cdhooper/kicksmash32/doc/AMIGACLI.md

## Usage Example

If you are familiar with the Amiga CLI and have the ability to get
ROM images to your Amiga, then programming and switching between Kickstart
ROM banks in the running system is not difficult.

List all banks.

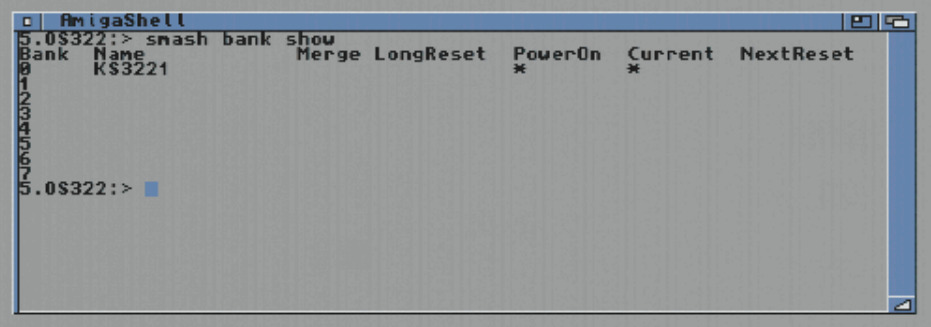
[picture p5: doc/smash_example_1_bank_show.jpg]
smash bank show


Write DiagROM to a bank.

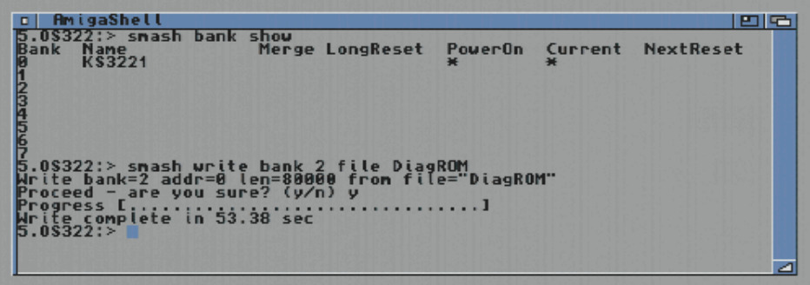
[picture p6: doc/smash_example_2_write.jpg]
smash write


Name that bank for future reference.

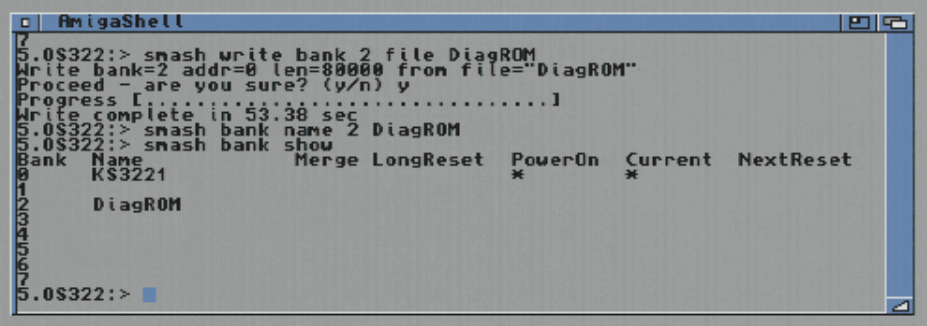
[picture p7: doc/smash_example_3_bank_name.jpg]
smash bank name


It's always a good idea to verify what you wrote.

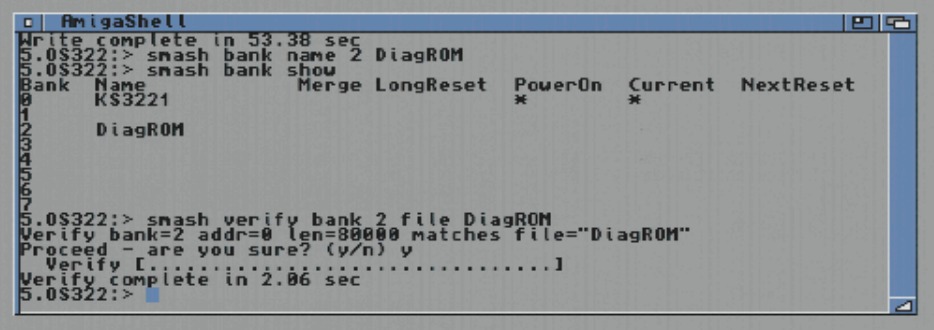
[picture p8: doc/smash_example_4_verify.jpg]
smash verify


Switch to that bank and reboot.

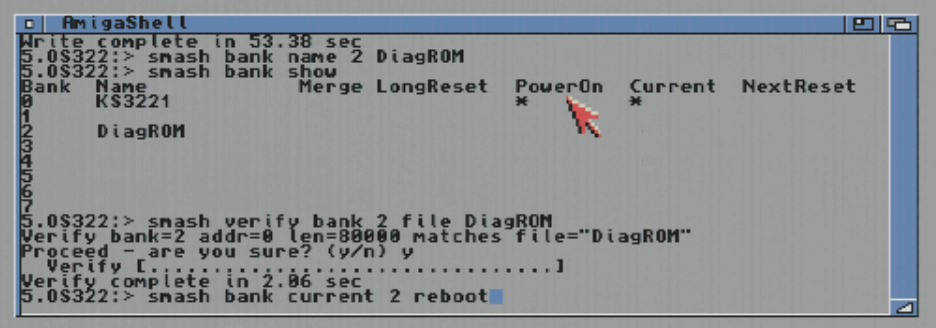
[picture p9: doc/smash_example_5_bank_current.jpg]
smash bank current


After pressing Enter, your computer is now running DiagROM.

How do you switch back? If you had specified a "long reset" sequence, you could press and hold Control-Amiga-Amiga to switch back. Since you haven't yet done that, you will need to power cycle your Amiga or connect to the KickSmash over USB and tell it from the host to switch.

-------------------------------------------------------

The smash utility can also be used to test communication between your Amiga and Kicksmash.

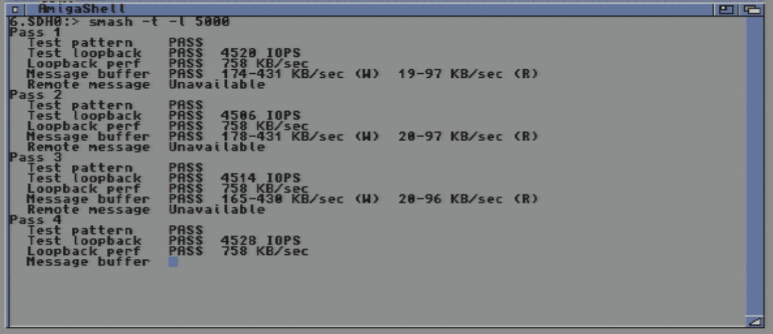
[picture p10: doc/smash_example_6_test_start.jpg]
smash test start smash test

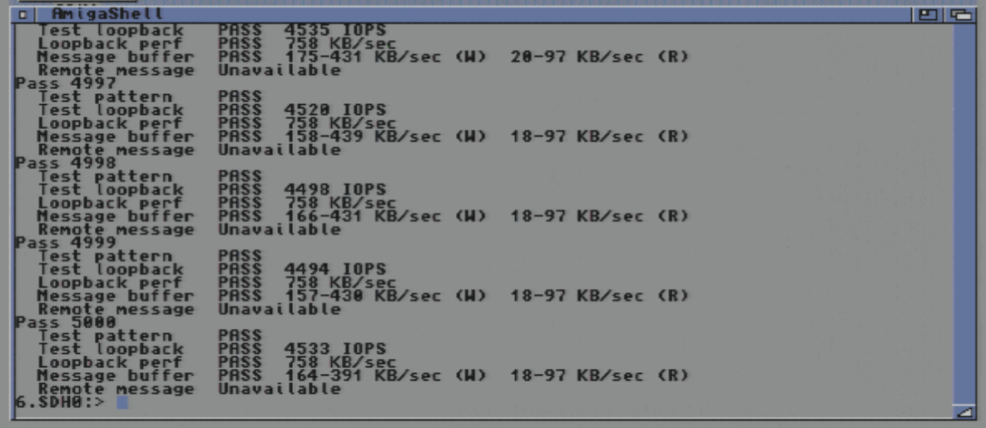
[picture p11: doc/smash_example_7_test_end.jpg]
smash test end smash test (end)
