cdhooper/kicksmash32/doc/KickSmash32_InfoSheet.odt

KickSmash32

OPEN SOURCE
DUAL KICKSTART ROM REPLACEMENT
IN-SYSTEM & USB PROGRAMMING
NETWORK AND FILE SERVICE

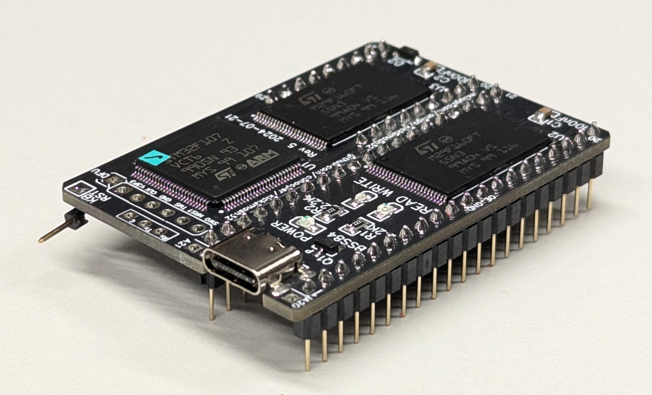
[picture p20: figure]
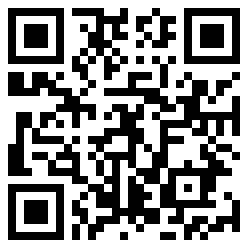
[picture p21: figure]

Overview KickSmash32 is a modern Kickstart ROM replacement for 32-bit Amiga systems (1200/3000/4000 and similar) systems. It replaces the original ROM chips with multi-bank flash that can be programmed from the Amiga itself or from a host computer over USB. A ROM Switcher which can be shown at power-on or at long reset can be used to quickly change the desired ROM bank. Beyond simple ROM swapping it offers optional file-system and network services so the Amiga can see volumes and share network from the host PC through the same USB cable. | SCAN TO VISIT github.com/cdhooper/kicksmash32

Features

▸ Read/write up to 8 independent flash banks from Amiga CLI (smash) or GUI (SmashTool)

▸ Out-of-system programming via USB with hostsmash (Linux, macOS, Windows)

▸ Configurable ROM bank selection on long reset or cold power-on

▸ ROM Switcher for interactive ROM bank choice at boot

▸ Optional smashfs / smashftp host file service and smashnet network device

▸ Open hardware + firmware + software under BSD-2-Clause

Board Variants & Models

Amiga Model | KickSmash Board | Notes
A3000 / ReA3000 / A4000 | KickSmash 32 | ROM Tower adapter available for older A3000
A1200 / ReA1200 | KickSmash 1200 | 42-pin sockets, D0-D15 on right
A3000T / AA3000+ | KickSmash 3KT | hostsmash -s 1032 on A3000T Rev7
A4000T | KickSmash 4KT | USB faces Fat Gary
A4000CR / ReA4000CR | KickSmash 4KCR | Wide spacing; 40/42-pin variants
AmigaPCI | KickSmash APCI | 27C4096 pinout

AVAILABILITY

There are several individuals around the world who are building and selling KickSmash. All board designs, firmware, Amiga software, and host software are freely available in the same github repository, which means everyone has access. If you wish to build your own or build and sell, you are granted full permission to do so as you desire.
