cdhooper/kicksmash32/doc/AMIGAGUI.md

## Usage Example

The main feature of SmashTool, the Amiga Kicksmash graphical program,
is to program and name Kicksmash ROM banks. Here's an example:

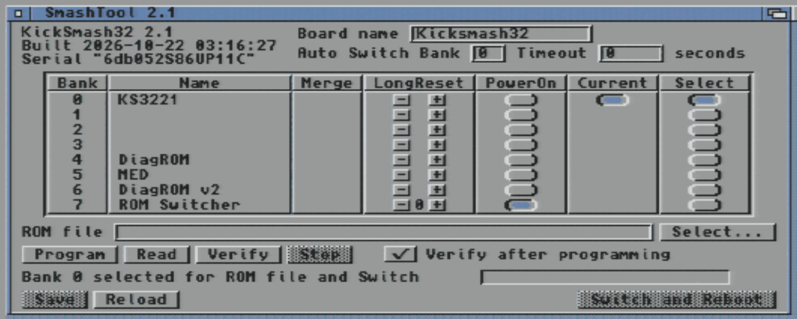
[picture p22: doc/smashtool_01_full_window.jpg]
SmashTool


When SmashTool starts up, it will query Kicksmash and report useful
information such as the firmware version, board name, and the name
of the ROM in each bank.

If you hold down the right mouse button, you will see some additional
options, including the Clock menu, where you can update the Amiga
time either from the time you previously stored in Kicksmash or the
time of your Kicksmash USB host, if connected by USB and running
hostsmash.

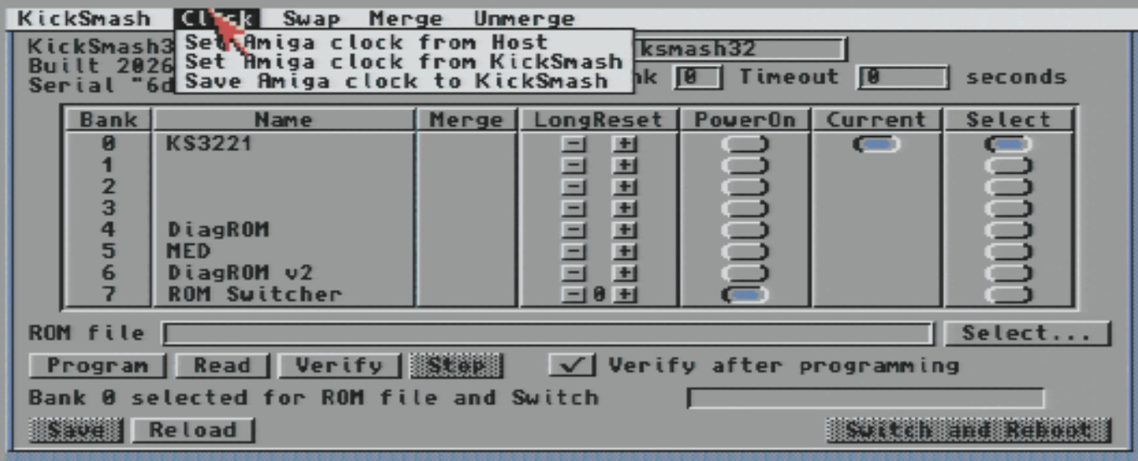
[picture p23: doc/smashtool_02_clock_menu.jpg]
Clock


Let's program bank 1 with a new Kickstart image. Start by selecting
the bank to program:

Select Bank

Now click the "Select..." button to select a ROM file to use.

Select...

An Amiga file requester will appear. Locate the ROM image to use.

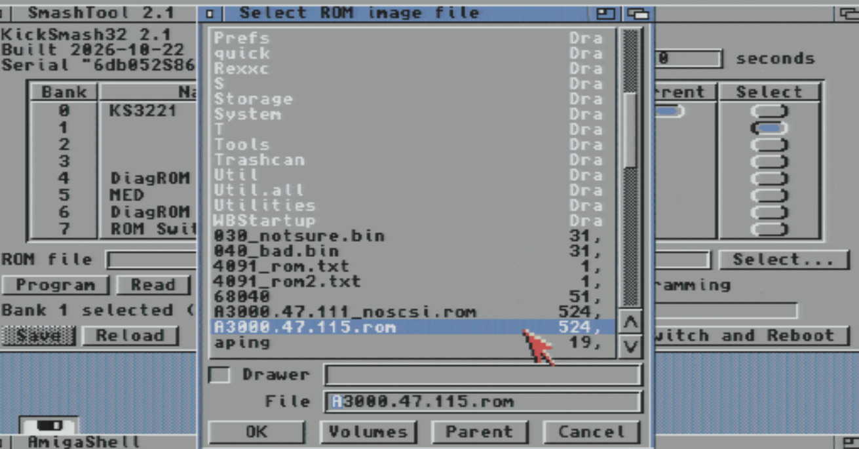
[picture p24: doc/smashtool_05_select_rom_file.jpg]
ROM file


After clicking "OK", you will see the ROM file name presented.

ROM file

You've already selected the bank to program, so now click "Program"

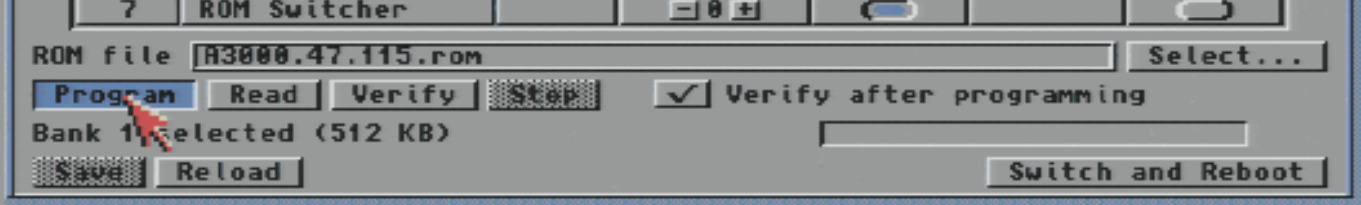
[picture p25: doc/smashtool_07_program_button.jpg]
Program


SmashTool will prompt you, as this will erase whatever is currently
in the ROM bank.

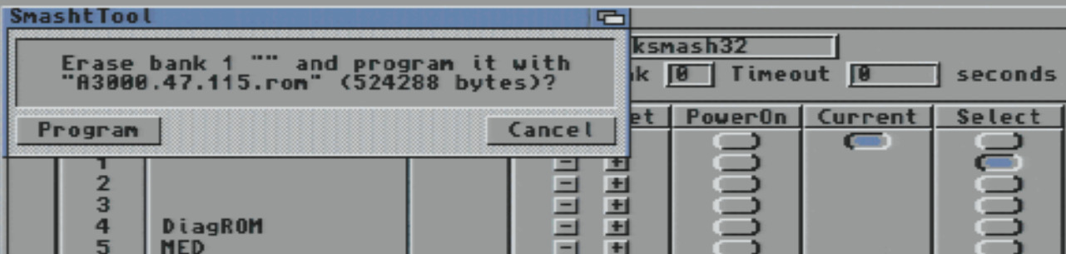
[picture p26: doc/smashtool_08_program_prompt.jpg]
Program or Cancel


SmashTool works with Kicksmash to erase and program the ROM. The bank
is first erased.

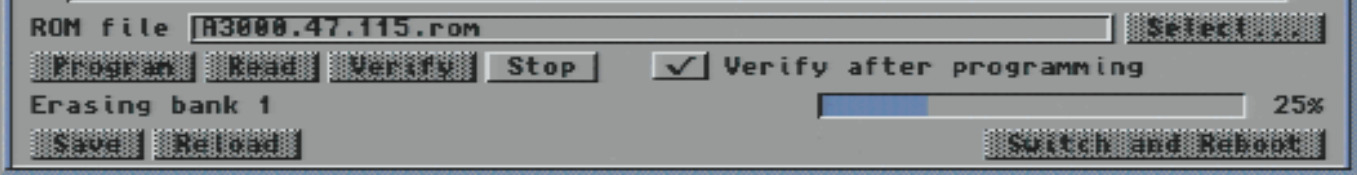
[picture p27: doc/smashtool_09_erasing.jpg]
Erasing


Then programming commences.

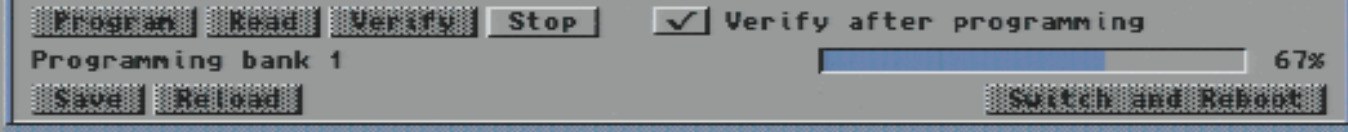
[picture p28: doc/smashtool_10_programming.jpg]
Programming


Programming will take between 10 and 60 seconds, depending on the speed
of your Amiga. Once done, the bank will be automatically verified, so
long as "Verify after programming" was selected.

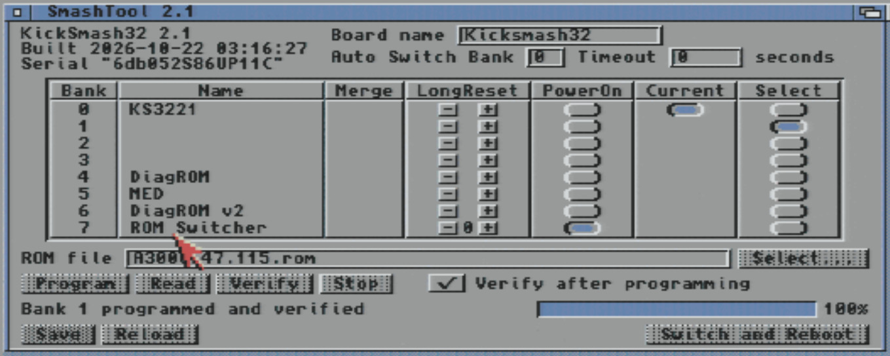
[picture p29: doc/smashtool_11_programming.jpg]
Programming done


Now, let's name the bank which was just programmed. Click with your
mouse on the bank name and begin typing.

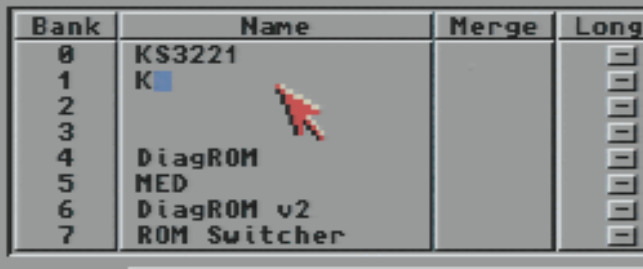
[picture p30: doc/smashtool_12_name_bank.jpg]
Bank Name


When done, there is no need to press enter.

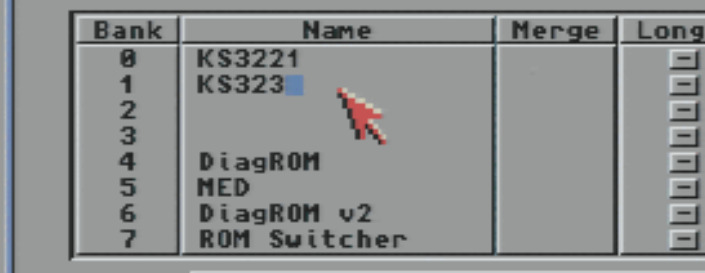
[picture p31: doc/smashtool_13_name_bank.jpg]
Bank Name


Click the Save button to write the settings you've changed to Kicksmash.

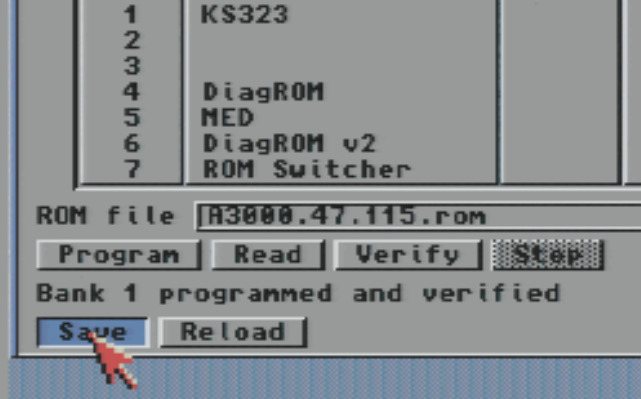
[picture p32: doc/smashtool_14_save.jpg]
Save


When the save is complete, you will notice the Save button returns to
being disabled.

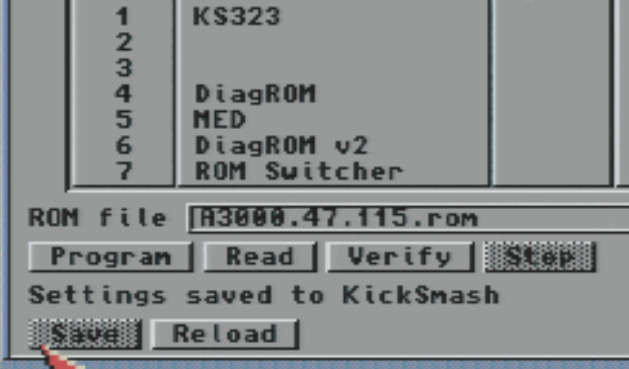
[picture p33: doc/smashtool_15_save_done.jpg]
Save disabled


There are other things you can do with SmashTool, such as merging banks.
Refer to the Kicksmash [`sw_kicksmash.txt`](sw_kicksmash.txt) documentation
for information on bank merging.
