cdhooper/kicksmash32/4kcr_rev9/kicksmash4kcr_rev9_photo_view_top.jpg

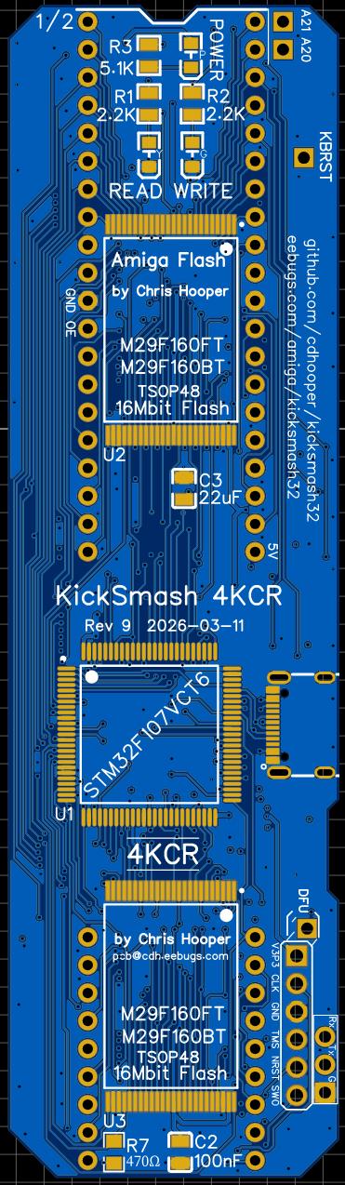
4kcr_rev9/kicksmash4kcr_rev9_photo_view_top.jpg
