cdhooper/kicksmash32/4kcr_rev9/PCB_bottom_Amiga_Kicksmash_4KCR_2026-03-15_mirror.png

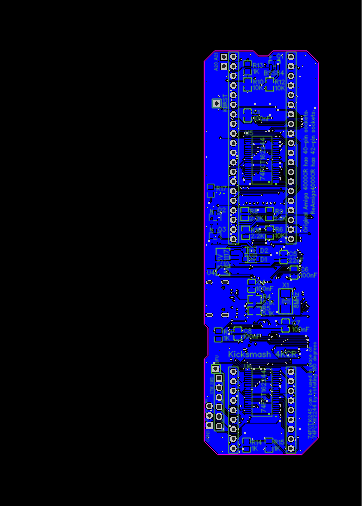
4kcr_rev9/PCB_bottom_Amiga_Kicksmash_4KCR_2026-03-15_mirror.png
