cdhooper/kicksmash32/32_rev10/kicksmash32_rev10_photo_view_top.jpg

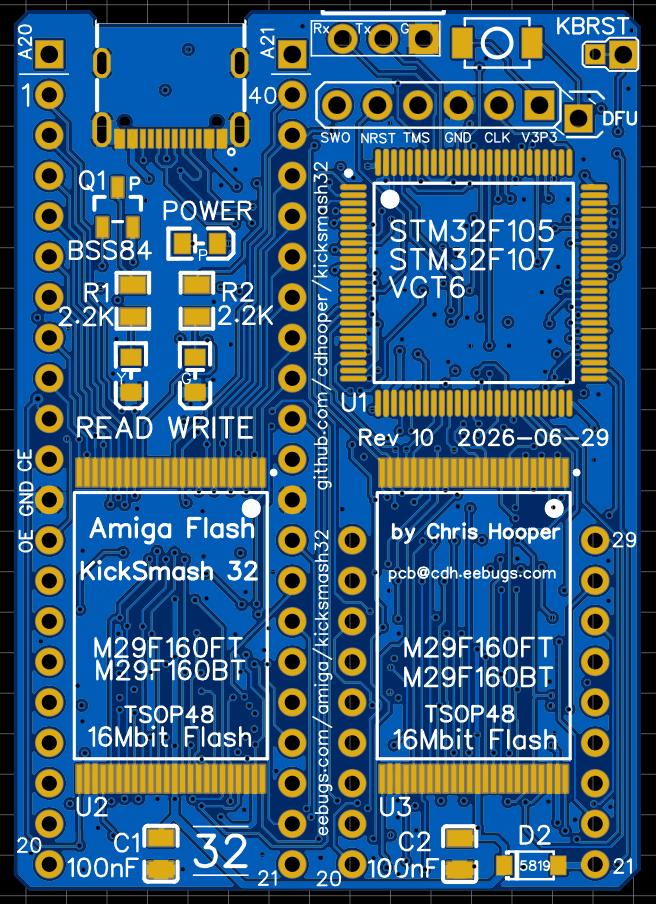
32_rev10/kicksmash32_rev10_photo_view_top.jpg
