cdhooper/kicksmash32/1200_rev10.1/2026_10_06_kicksmash1200_rev10.1_photo_view_top.jpg

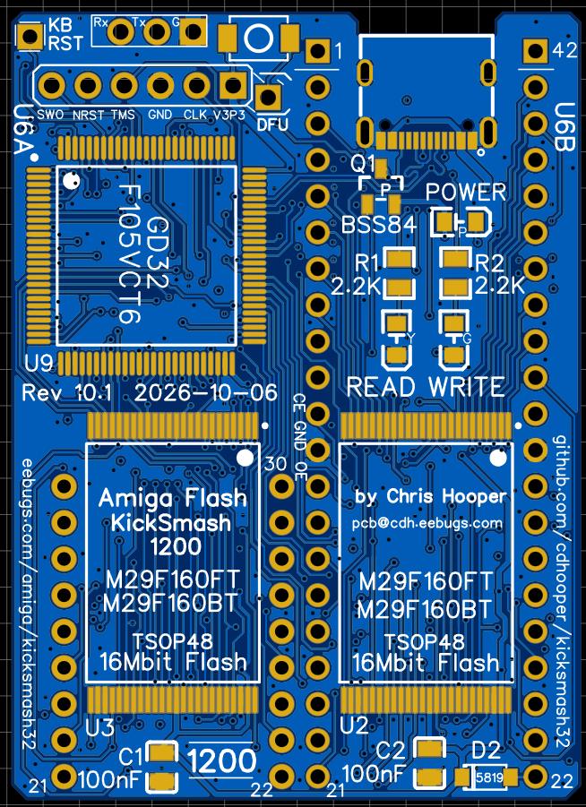
1200_rev10.1/2026_10_06_kicksmash1200_rev10.1_photo_view_top.jpg
