cdhooper/kicksmash32/doc/smashtool_window.jpg

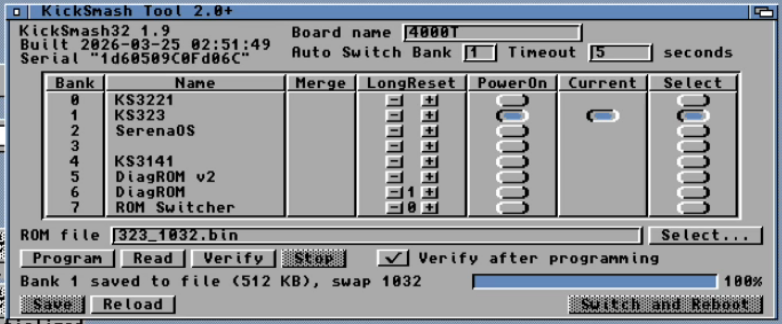
doc/smashtool_window.jpg
