cdhooper/kicksmash32/photos/2022_01_26_kicksmash32_rev1_in_mx29f1615_programmer.jpg

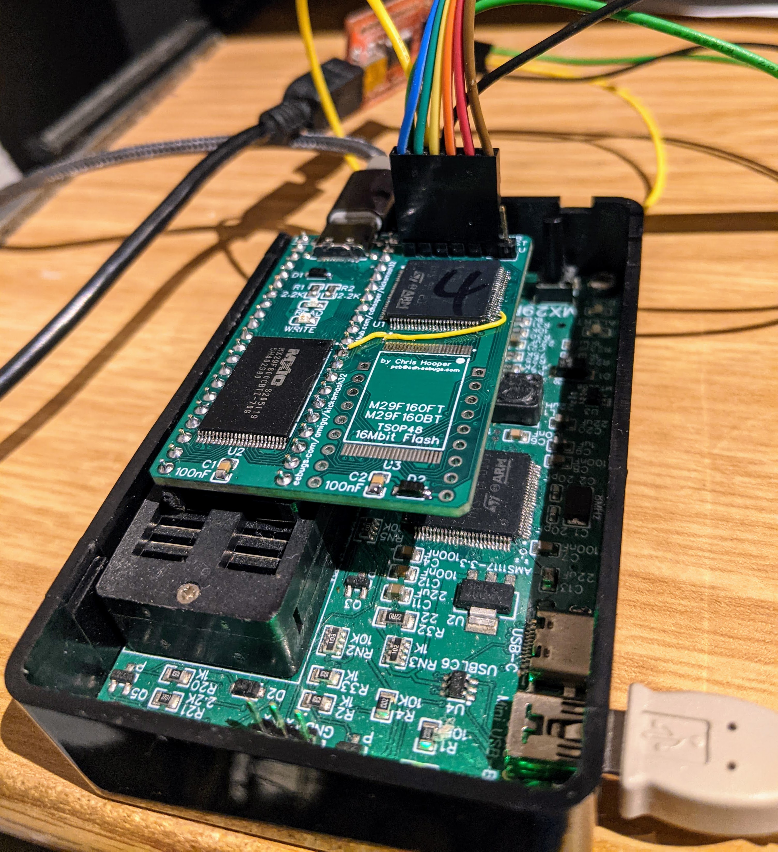
photos/2022_01_26_kicksmash32_rev1_in_mx29f1615_programmer.jpg
