cdhooper/kicksmash32/photos/2024_01_04_kicksmash32_rev3_22_cleaned_top.jpg

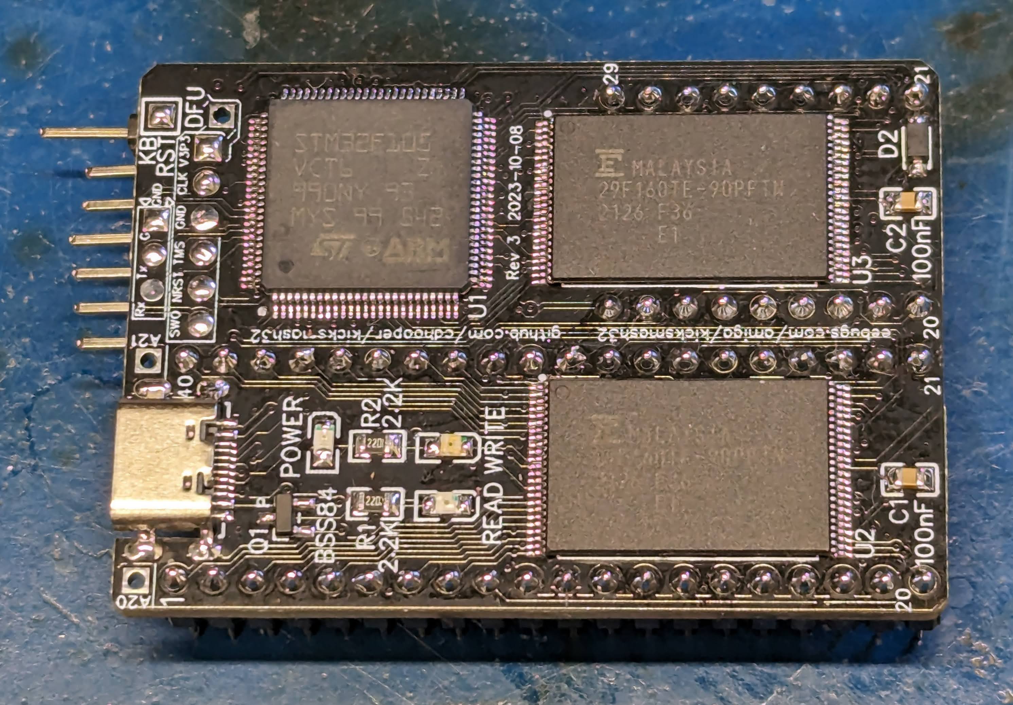
photos/2024_01_04_kicksmash32_rev3_22_cleaned_top.jpg
