cdhooper/kicksmash32/photos/2024_03_23_kicksmash32_rev4_bottom.jpg

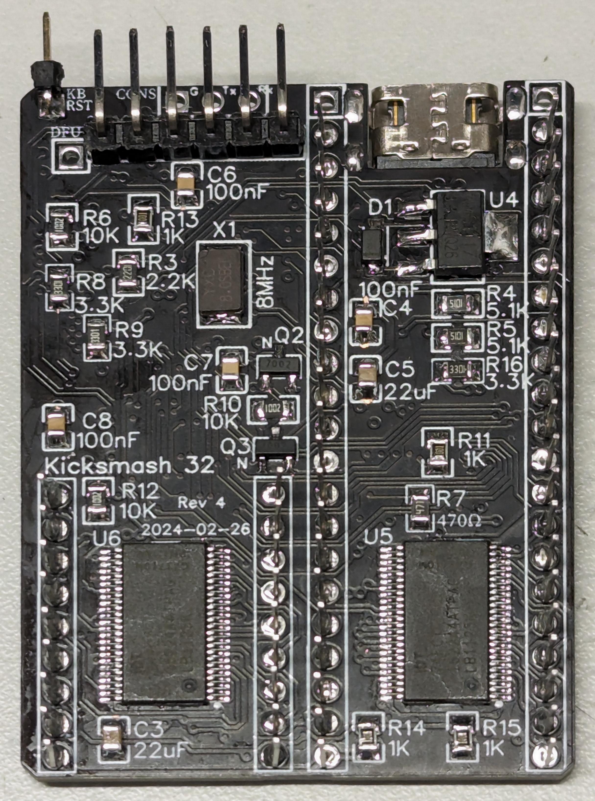
photos/2024_03_23_kicksmash32_rev4_bottom.jpg
