cdhooper/kicksmash32/photos/2024_03_23_kicksmash32_rev4_top.jpg

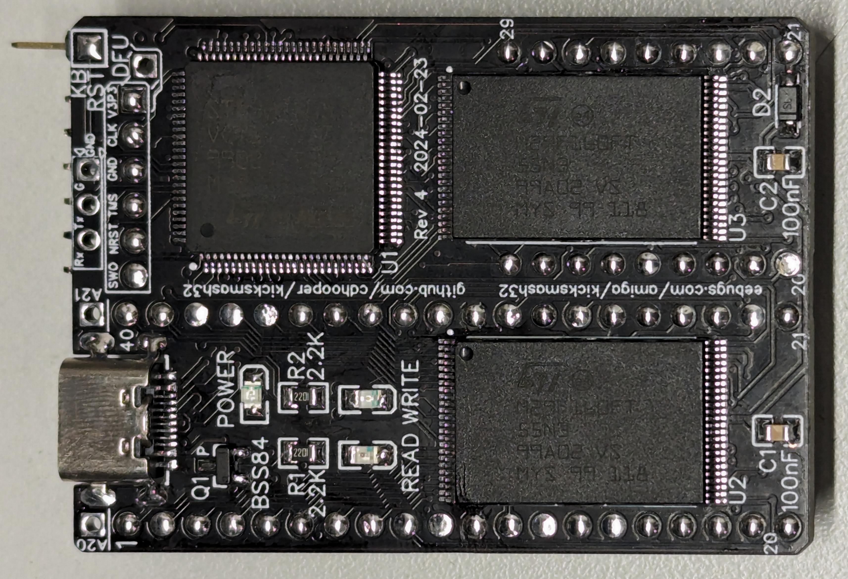
photos/2024_03_23_kicksmash32_rev4_top.jpg
