cdhooper/kicksmash32/photos/2025_03_21_kicksmash32_in_a4000tx_lisa.jpg

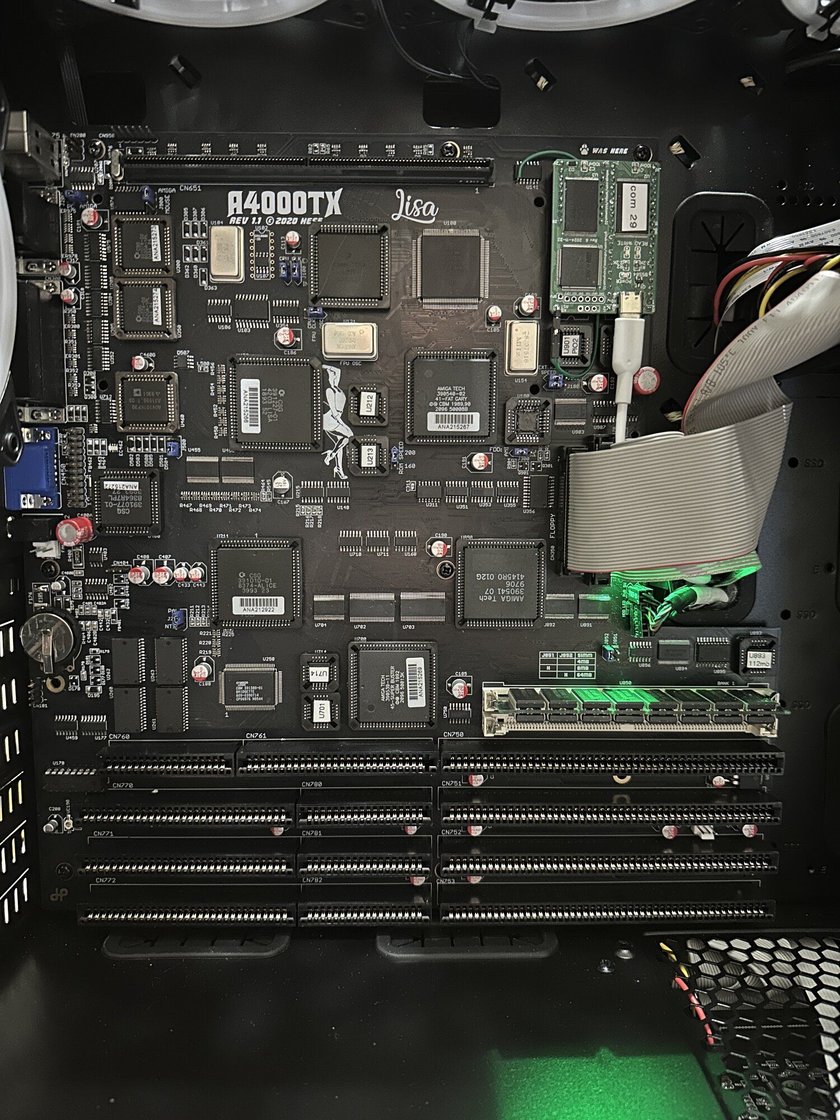
photos/2025_03_21_kicksmash32_in_a4000tx_lisa.jpg
