cdhooper/kicksmash32/photos/2025_04_11_kicksmash_4kcr_rev7_in_a4000cr_with_tf4060.jpg

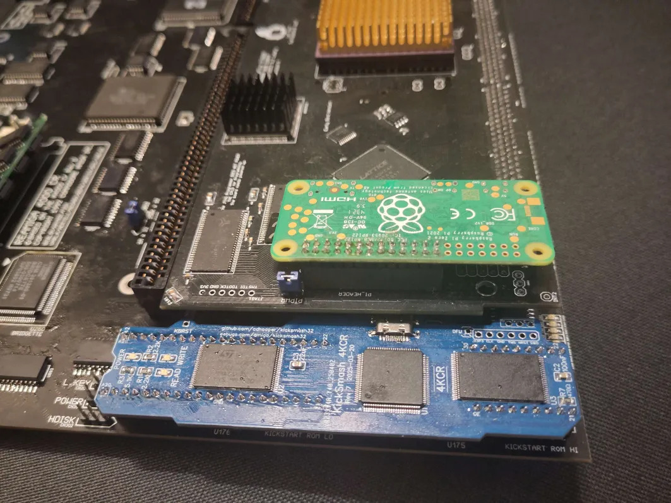
photos/2025_04_11_kicksmash_4kcr_rev7_in_a4000cr_with_tf4060.jpg
