cdhooper/kicksmash32/photos/2026_03_30_kicksmash32_rev6a_in_a4000tx.jpg

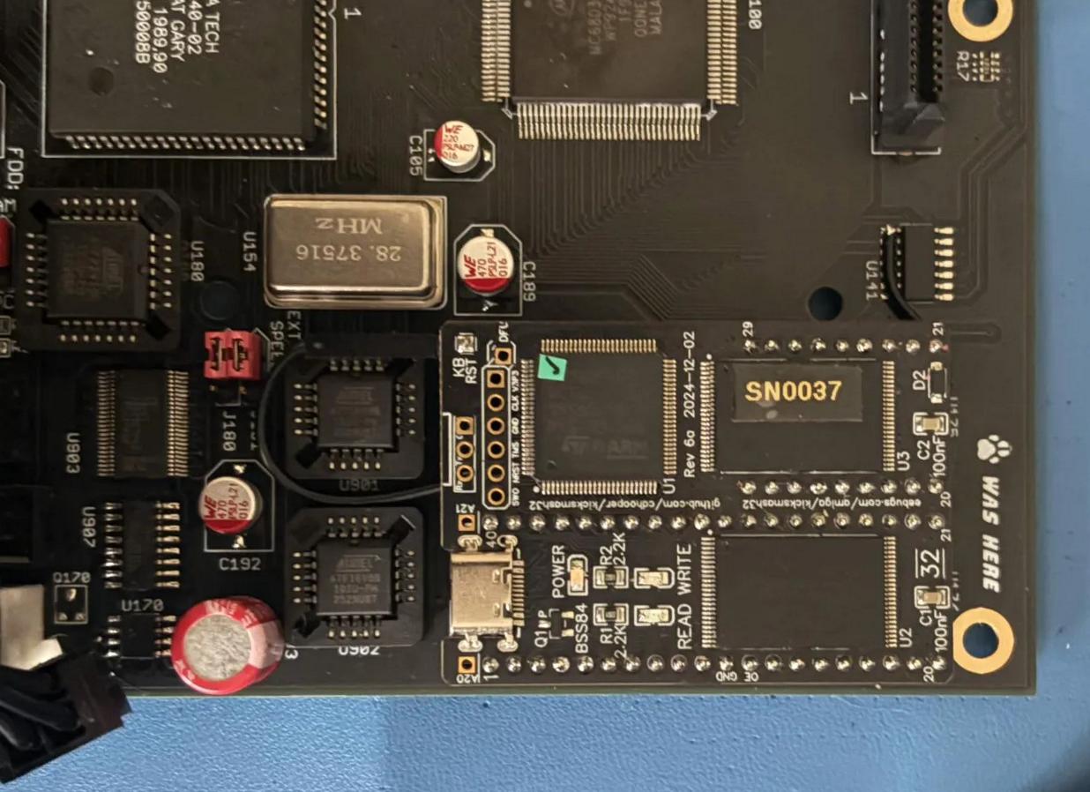
photos/2026_03_30_kicksmash32_rev6a_in_a4000tx.jpg
