cdhooper/kicksmash32/smasher_rev2/2026_09_29_kicksmasher_v2_photo_view_top.jpg

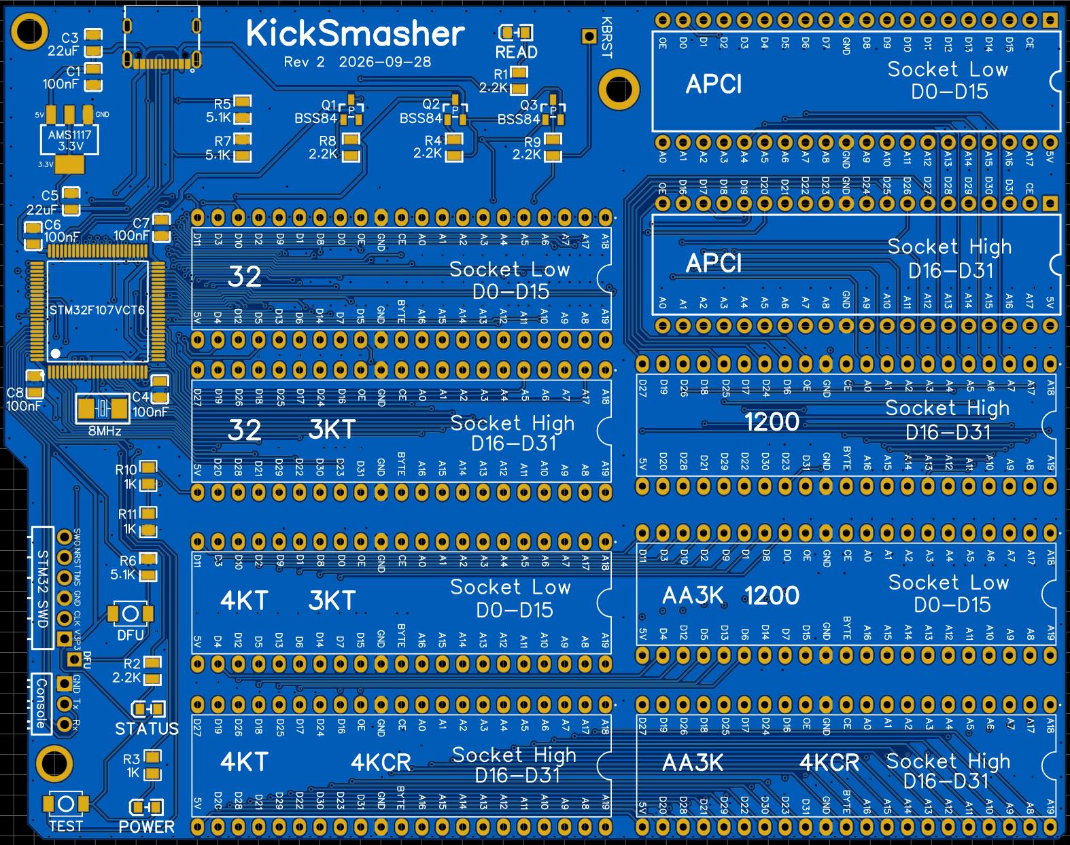
smasher_rev2/2026_09_29_kicksmasher_v2_photo_view_top.jpg
