cdhooper/kicksmash32/1200_rev10.1/BOM_Amiga-KickSmash-32-in-system-flash_2026-10-06.csv

ID | Name | Designator | Footprint | Quantity | Manufacturer Part | Manufacturer | Supplier | Supplier Part | Price
1 | 1K | R17,R18,R14,R15,R11,R13 | 0805 | 6 | 0805W8F1001T5E | UniOhm | LCSC | C17513 | 0.004
2 | 470Ω | R7 | R0805 | 1 | 0805W8F4700T5E | UNI-ROYAL(厚声) | LCSC | C17710 | 0.005
3 | 74LVC1G04DCK | U13 | SOT-353_L2.1-W1.3-P0.65-LS2.3-BR | 1 | SN74LVC1G04DCKR | TECH PUBLIC(台舟) | LCSC | C19829627 | 0.05
4 | 74LVC1G332DCK | U11 | SC-70-6_L2.0-W1.3-P0.65-LS2.1-BR | 1 | SN74LVC1G332DCKR | TI(德州仪器) | LCSC | C2865081 | 0.175
5 | 5.1K | R6,R10,R12,R5,R4 | R0805 | 5 | 0805W8F5101T5E | UniOhm | LCSC | C27834 | 0.006
6 | 2.2K | R3,R8,R9,R16,R1,R2 | R0805 | 6 | 0805W8F2201T5E | UniOhm | LCSC | C17520 | 0.005
7 | 2N7002 | Q2,Q3 | SOT-23-3_L2.9-W1.6-P1.90-LS2.8-BR | 2 | 2N7002 | CJ(江苏长电/长晶) | LCSC | C8545 | 0.018
8 | Bottom male header U181 left | H2L | HDR-M-2.54_1X9_1.7_0.95 | 1 | PZ254-1-09-Z-C | HCTL(华灿天禄) | LCSC | C5156436 | 0.315
9 | Bottom male header U181 right | H2R | HDR-M-2.54_1X9_1.7_0.95 | 1 | PZ254-1-09-Z-C | HCTL(华灿天禄) | LCSC | C5156436 | 0.315
10 | 74FCT162244 | U5,U6 | TSSOP-48_L12.6-W6.2-P0.50-LS8.1-BL | 2 | 74FCT162244CTPAG | RENESAS(瑞萨)/IDT | LCSC | C1548694 | 0.937
11 | 22uF | C3,C5 | C0805 | 2 | CL21A226MAQNNNE | SAMSUNG | LCSC | C45783 | 0.222
12 | 8MHz | X1 | OSC-SMD_L5.0-W3.2 | 1 | X50328MSB2GI | YXC | LCSC | C115962 | 0.247
13 | 100nF | C6,C7,C8,C4,C2,C1 | C0805 | 6 | CC0805KRX7R9BB104 | YAGEO | LCSC | C49678 | 0.019
14 | AMS1117-3.3 | U4 | SOT-223-3_L6.5-W3.4-P2.30-LS7.0-BR | 1 | AMS1117-3.3 | AMS | LCSC | C6186 | 0.209
15 | B5819W_C8598 | D1,D2 | SOD-123_L2.8-W1.8-LS3.7-RD | 2 | B5819W | CJ | LCSC | C8598 | 0.028
16 | Bottom male header U6B left | H5L | HDR-TH_21P-P2.54-V-M | 1 | KH-2.54PH180-1X21P-L11.5 | kinghelm(金航标) | LCSC | C20610288 | 0.147
17 | Bottom male header U6B right | H5R | HDR-TH_21P-P2.54-V-M | 1 | KH-2.54PH180-1X21P-L11.5 | kinghelm(金航标) | LCSC | C20610288 | 0.147
18 | KBRST | H3 | HDR-TH_1P-P2.54-H-M-W7.7-P-BOT-SILK | 1 | X6511WR-01H-C60D30R2 | XKB Connection(中国星坤) | LCSC | C2883838 | 0.04
19 | TS-1088-AR02016 | SW1 | SW-SMD_L3.9-W3.0-P4.45 | 1 | TS-1088-AR02016 | XUNPU(讯普) | LCSC | C720477 | 0.053
20 | USB-310 | USBC2 | USB-C-SMD_20P-P0.50-L7.4-W8.9 | 1 | USB-310-B-SU | HOOYA(皓宇电子) | LCSC | C309347 | 0.225
21 | WRITE | LED2 | LED0805-RD | 1 | 0805G (Green) | KENTO | LCSC | C2297 | 0.017
22 | POWER | LED3 | LED0805-RD_PURPLE | 1 | P2-0805UVTCS2-0.8T | TUOZHAN(拓展光电) | LCSC | C2827270 | 0.016
23 | READ | LED1 | LED0805-RD | 1 | 17-21SUYC/TR8 | KENTO | LCSC | C2296 | 0.012
24 | BSS84 | Q1 | SOT-23(SOT-23-3) | 1 | LBSS84LT1G | LRC | LCSC | C8492 | 0.028
25 | M29F160FT55N3E2 | U2,U3 | MICT-N-48 | 2
26 | GD32F105VCT6 | U9 | LQFP-100_L14.0-W14.0-P0.50-LS16.0-BL | 1 | GD32F105VCT6 | GigaDevice(兆易创新) | LCSC | C81579 | 3.571
