cdhooper/kicksmash32/apci_rev8/BOM_Amiga-KickSmash-32-in-system-flash_2025-07-24.csv

ID | Name | Designator | Footprint | Quantity | Manufacturer Part | Manufacturer | Supplier | Supplier Part | Price
1 | 2N7002 | Q2,Q3 | SOT-23-3_L2.9-W1.6-P1.90-LS2.8-BR | 2 | 2N7002 | CJ(江苏长电/长晶) | LCSC | C8545 | 0.015
2 | 2.2K | R8,R9,R16,R1,R2 | R0805 | 5 | 0805W8F2201T5E | UniOhm | LCSC | C17520 | 0.002
3 | Bottom male header U210 left | H3L | HDR-TH_20P-P2.54-1.7-0.95 | 1 | 2.54mm 1*20PHeader | BOOMELE | LCSC | C50981 | 0.113
4 | Bottom male header U211 left | H4L | HDR-TH_20P-P2.54-1.7-0.95 | 1 | 2.54mm 1*20PHeader | BOOMELE | LCSC | C50981 | 0.113
5 | Bottom male header U211 right | H4R | HDR-TH_20P-P2.54-1.7-0.95 | 1 | 2.54mm 1*20PHeader | BOOMELE | LCSC | C50981 | 0.113
6 | 220Ω | R17 | R0805 | 1 | 0805W8F2200T5E | UNI-ROYAL(厚声) | LCSC | C17557 | 0.002
7 | TYPE-C 3.1-16P_C168689 | USBC1 | USB-C-SMD_TYPE-C-USB-12-NO-CUTOUT | 1 | TYPE-C 3.1-16P_C168689 | LCSC | LCSC | C168689 | 0.298
8 | WRITE | LED2 | LED0805-RD | 1 | 0805G (Green) | KENTO | LCSC | C2297 | 0.011
9 | POWER | LED3 | LED0805-RD_PURPLE | 1 | P2-0805UVTCS2-0.8T | TUOZHAN(拓展光电) | LCSC | C2827270 | 0.015
10 | READ | LED1 | LED0805-RD | 1 | 17-21SUYC/TR8 | KENTO | LCSC | C2296 | 0.012
11 | B5819W_C8598 | D2,D1 | SOD-123_L2.8-W1.8-LS3.7-RD | 2 | B5819W | CJ | LCSC | C8598 | 0.022
12 | BSS84 | Q1 | SOT-23(SOT-23-3) | 1 | LBSS84LT1G | LRC | LCSC | C8492 | 0.02
13 | 100nF | C2,C1,C6,C7,C8,C4 | C0805 | 6 | CC0805KRX7R9BB104 | YAGEO | LCSC | C49678 | 0.005
14 | M29F160FT55N3E2 | U2,U3 | MICT-N-48 | 2
15 | 5.1K | R3,R5,R4 | R0805 | 3 | 0805W8F5101T5E | UniOhm | LCSC | C27834 | 0.002
16 | KBRST | H3 | HDR-TH_1P-P2.54-H-M-W7.7-P-BOT-SILK | 1 | X6511WR-01H-C60D30R2 | XKB Connection(中国星坤) | LCSC | C2883838 | 0.02
17 | 1K | R14,R15,R11,R13 | 0805 | 4 | 0805W8F1001T5E | UniOhm | LCSC | C17513 | 0.002
18 | 10K | R12,R6,R10 | R0805 | 3 | 0805W8F1002T5E | UniOhm | LCSC | C17414 | 0.002
19 | 470Ω | R7 | R0805 | 1 | 0805W8F4700T5E | UNI-ROYAL(厚声) | LCSC | C17710 | 0.002
20 | 74FCT162244 | U5,U6 | TSSOP-48_L12.6-W6.2-P0.50-LS8.1-BL | 2 | 74FCT162244CTPAG | RENESAS(瑞萨)/IDT | LCSC | C1548694 | 2.589
21 | 22uF | C3,C5 | C0805 | 2 | CL21A226MAQNNNE | SAMSUNG | LCSC | C45783 | 0.024
22 | 8MHz | X1 | OSC-SMD_L5.0-W3.2 | 1 | X50328MSB2GI | YXC | LCSC | C115962 | 0.201
23 | AMS1117-3.3 | U4 | SOT-223-3_L6.5-W3.4-P2.30-LS7.0-BR | 1 | AMS1117-3.3 | AMS | LCSC | C6186 | 0.174
24 | STM32F107VCT6 | U1 | LQFP-100_L14.0-W14.0-P0.50-LS16.0-BL | 1 | STM32F107VCT6 | STMicroelectronics | LCSC | C8315 | 3.351
