cdhooper/kicksmash32/doc/installation_a3000.jpg

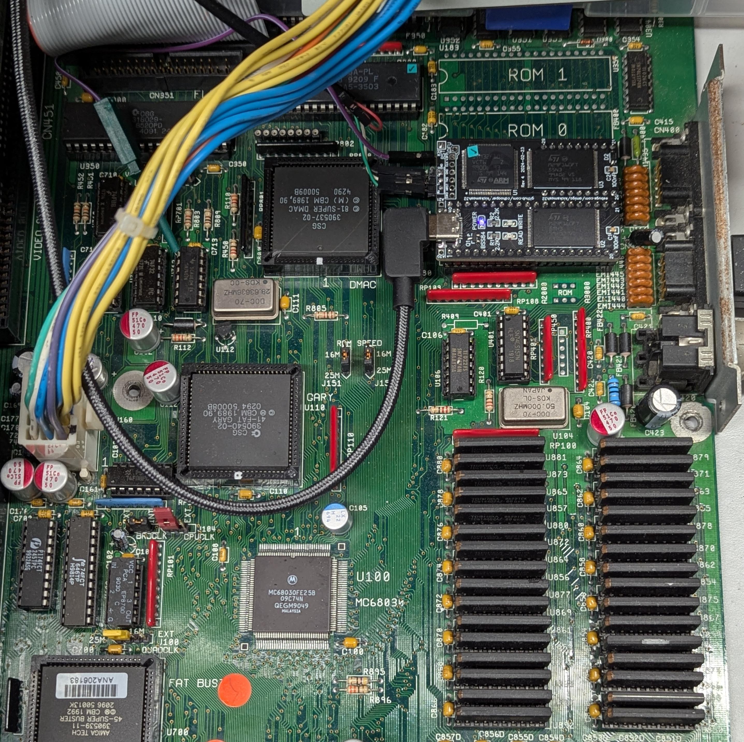
doc/installation_a3000.jpg
