cdhooper/kicksmash32/photos/2022_02_01_kicksmash32_rev2_assembled_boards_2.jpg

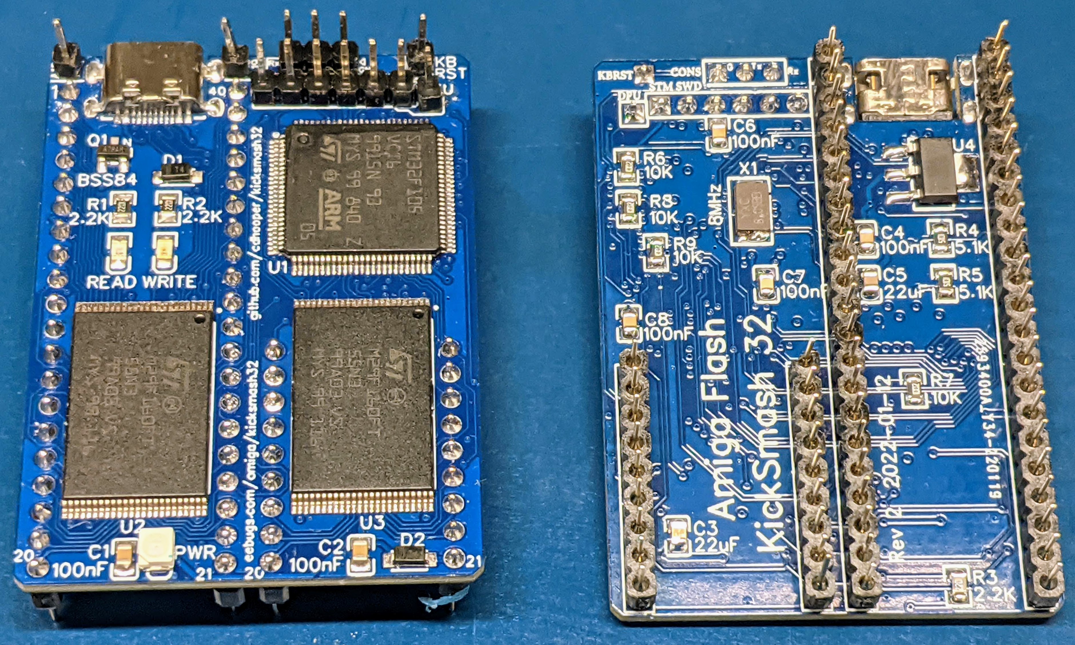
photos/2022_02_01_kicksmash32_rev2_assembled_boards_2.jpg
