cdhooper/kicksmash32/photos/2024_10_25_kicksmash32_rev5_assembly_2.jpg

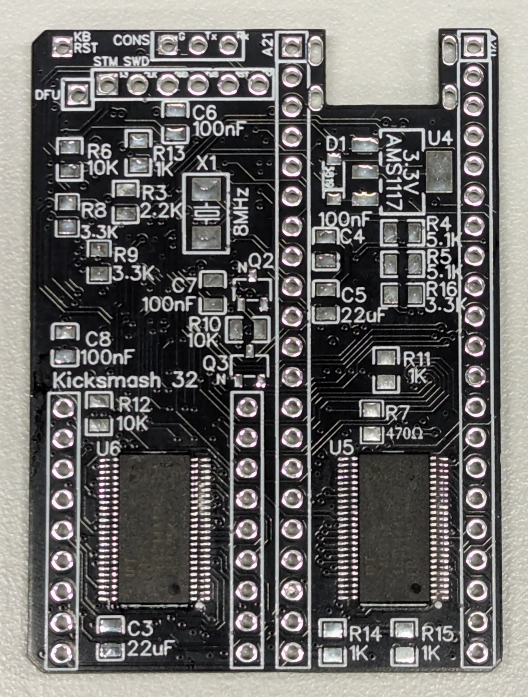
photos/2024_10_25_kicksmash32_rev5_assembly_2.jpg
