cdhooper/kicksmash32/photos/2024_10_25_kicksmash32_rev5_assembly_4_bottom_passives.jpg

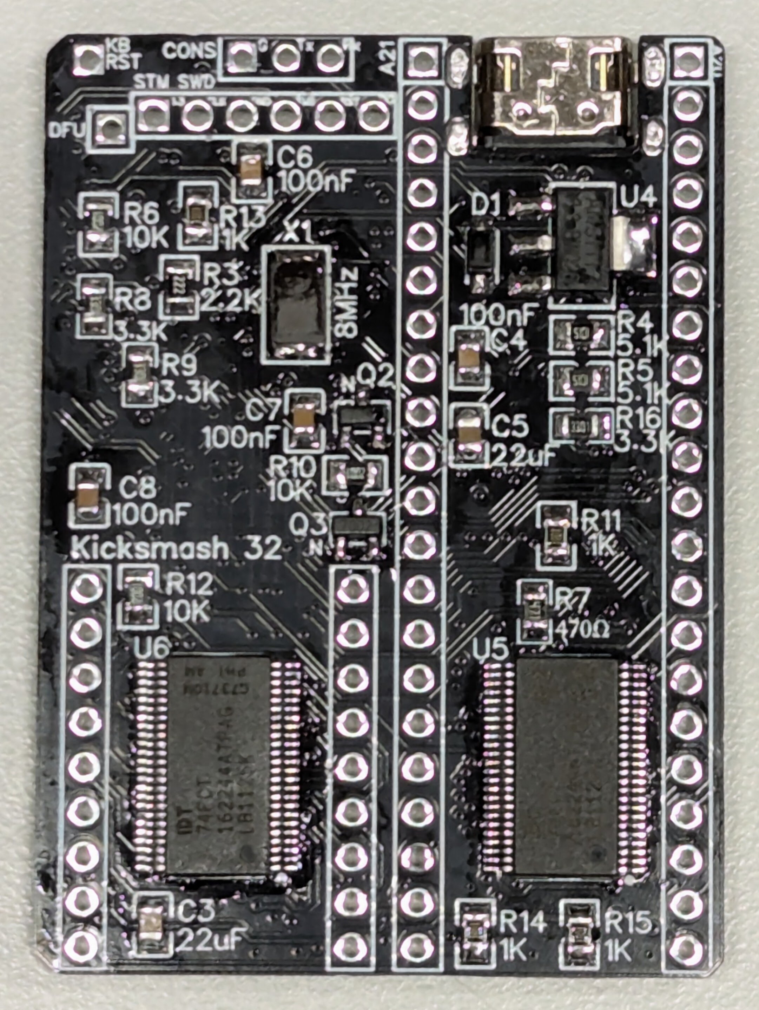
photos/2024_10_25_kicksmash32_rev5_assembly_4_bottom_passives.jpg
