cdhooper/kicksmash32/photos/2024_10_25_kicksmash32_rev5_assembly_6_in_template.jpg

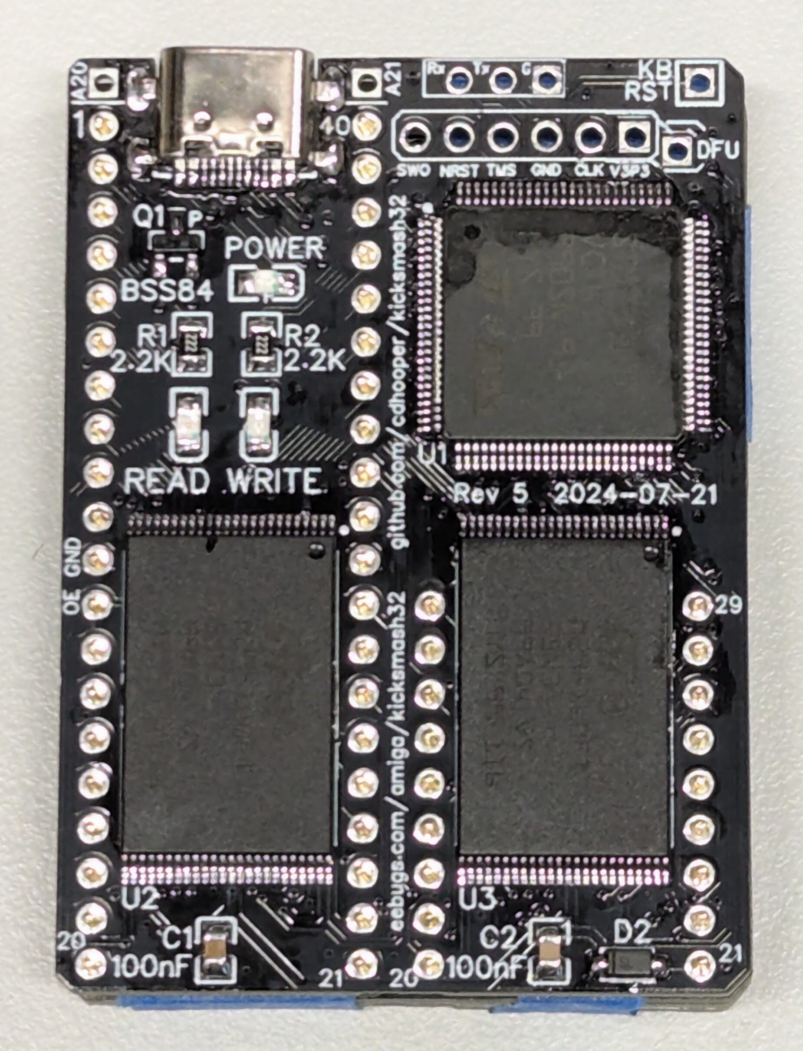
photos/2024_10_25_kicksmash32_rev5_assembly_6_in_template.jpg
