cdhooper/kicksmash32/photos/2024_10_25_kicksmash32_rev5_assembly_7_corners_soldered_1.jpg

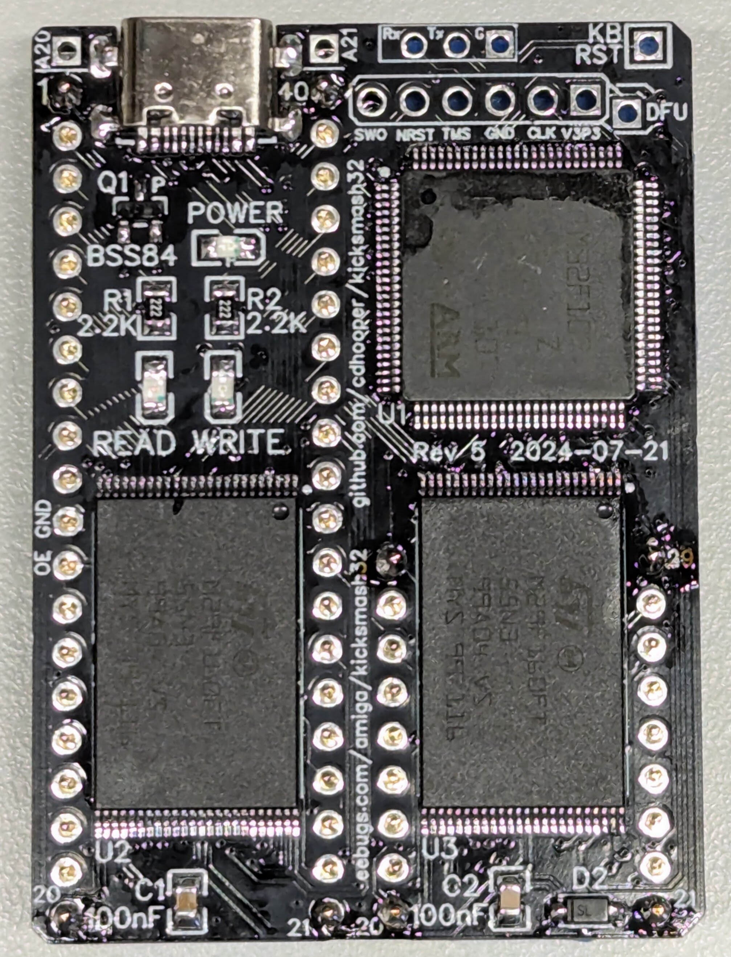
photos/2024_10_25_kicksmash32_rev5_assembly_7_corners_soldered_1.jpg
