cdhooper/kicksmash32/photos/2024_10_25_kicksmash32_rev5_assembly_7_corners_soldered_2.jpg

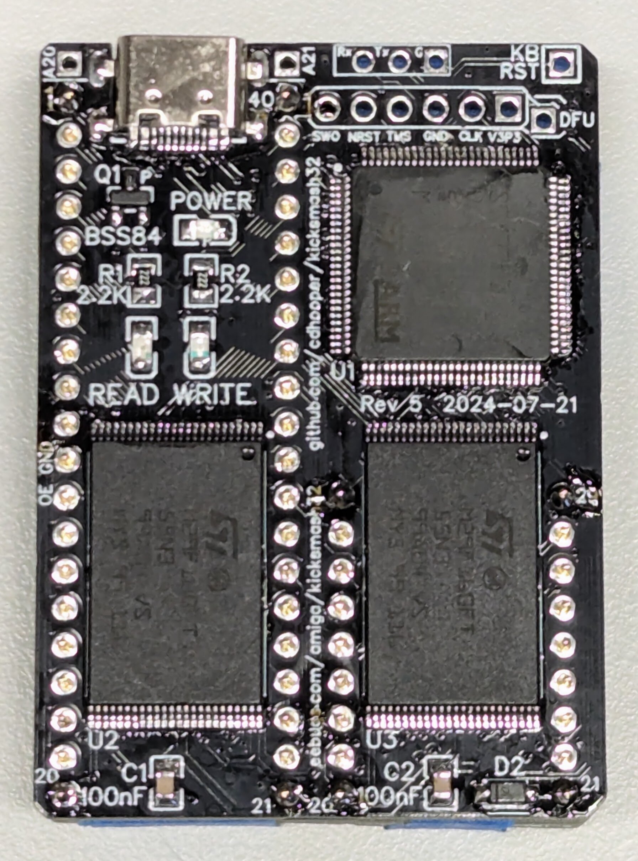
photos/2024_10_25_kicksmash32_rev5_assembly_7_corners_soldered_2.jpg
