cdhooper/kicksmash32/photos/2024_10_25_kicksmash32_rev5_assembly_8_top.jpg

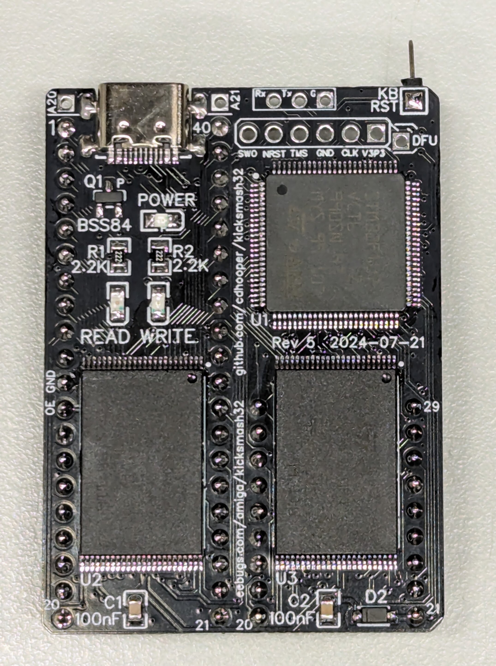
photos/2024_10_25_kicksmash32_rev5_assembly_8_top.jpg
