cdhooper/kicksmash32/photos/2024_10_25_kicksmash32_rev5_assembly_9_bottom.jpg

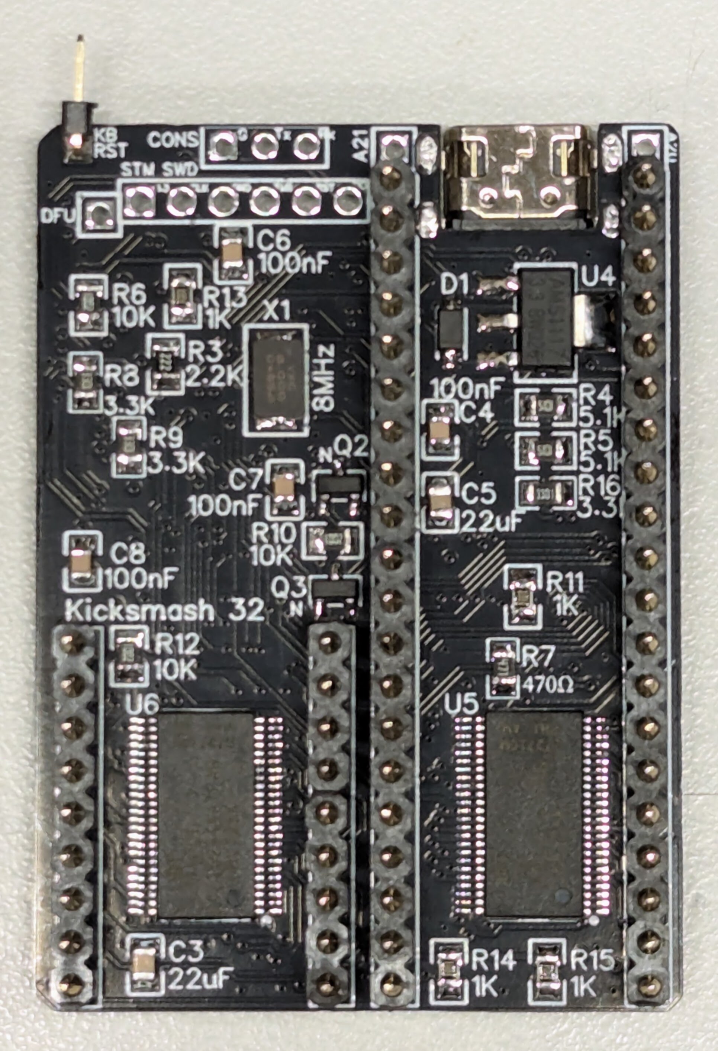
photos/2024_10_25_kicksmash32_rev5_assembly_9_bottom.jpg
