cdhooper/kicksmash32/photos/2024_12_01_kicksmash4kt_rev6_a4000t_install_1.jpg

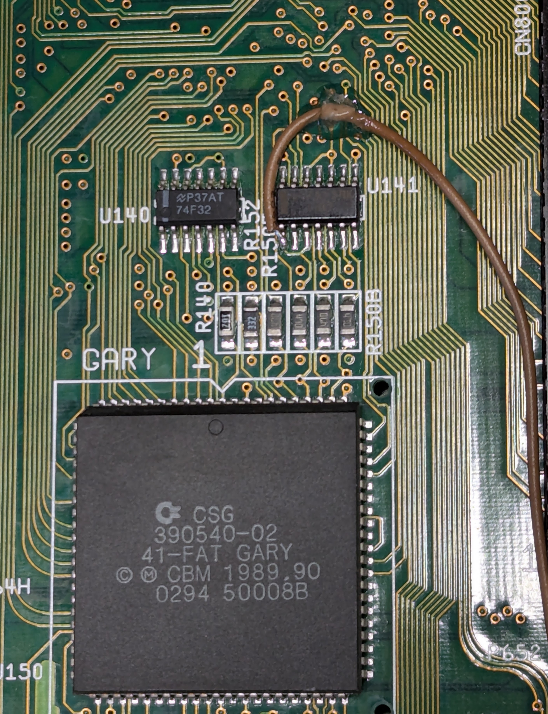
photos/2024_12_01_kicksmash4kt_rev6_a4000t_install_1.jpg
