cdhooper/kicksmash32/photos/2024_12_01_kicksmash32_rev6_a4000t_install_2.jpg

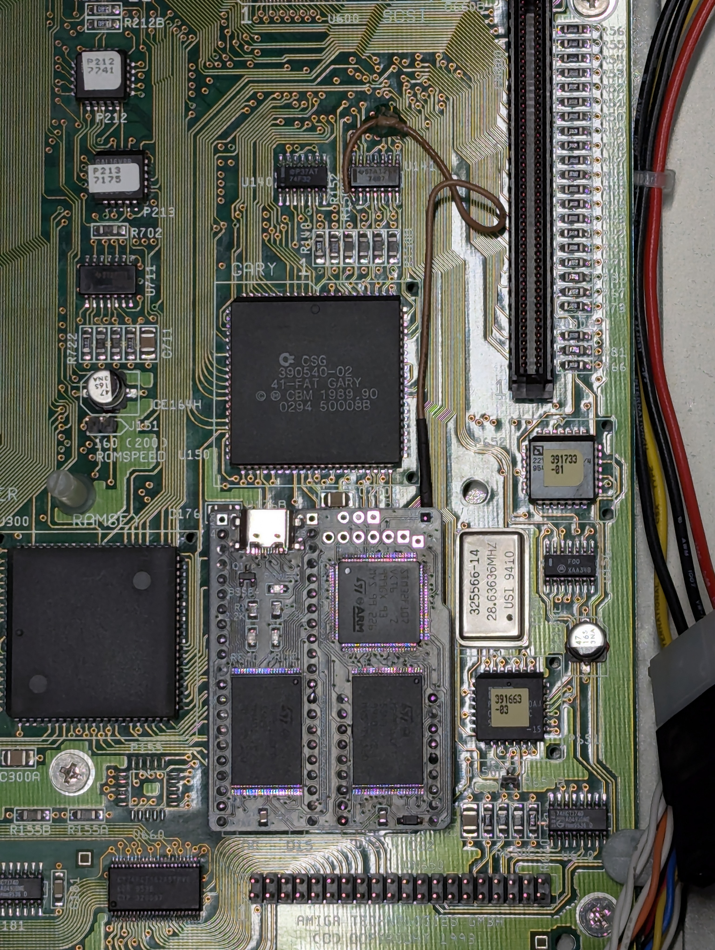
photos/2024_12_01_kicksmash32_rev6_a4000t_install_2.jpg
