cdhooper/kicksmash32/photos/2026_05_13_kicksmash4kcr_installed_in_amiga_4000cr.jpg

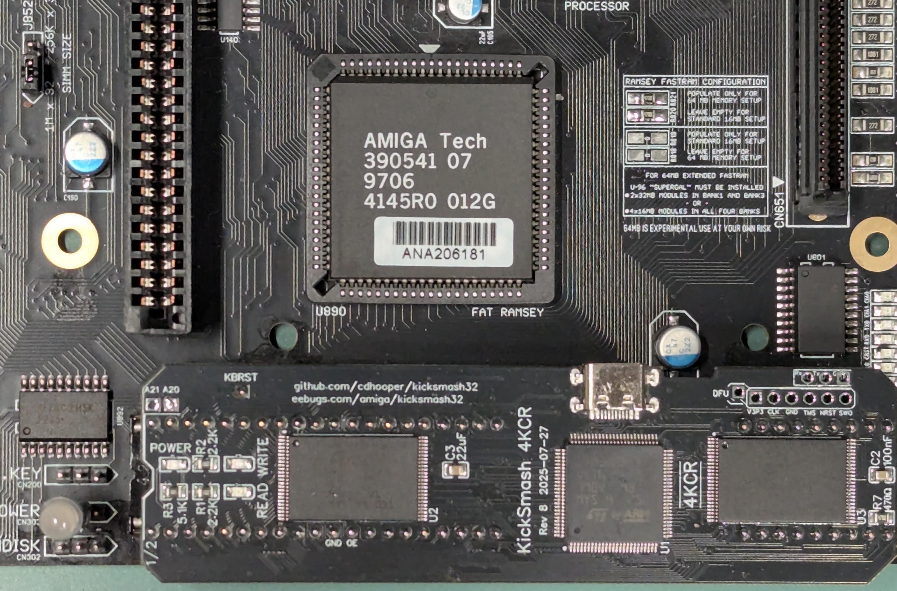
photos/2026_05_13_kicksmash4kcr_installed_in_amiga_4000cr.jpg
