cdhooper/kicksmash32/photos/2026_05_13_kicksmash32_installed_in_amiga_3000.jpg

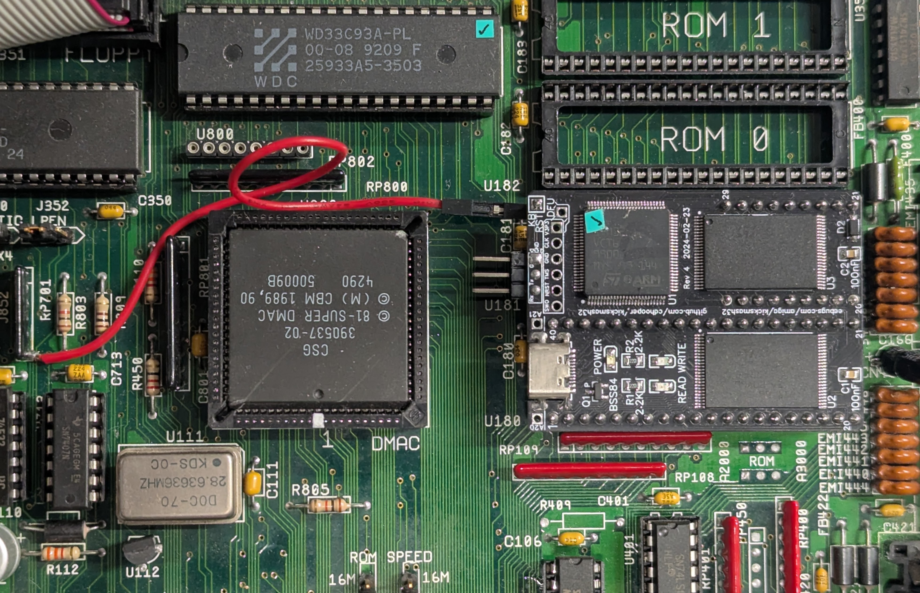
photos/2026_05_13_kicksmash32_installed_in_amiga_3000.jpg
