cdhooper/kicksmash32/photos/2026_05_13_kicksmash1200_installed_in_amiga_1200.jpg

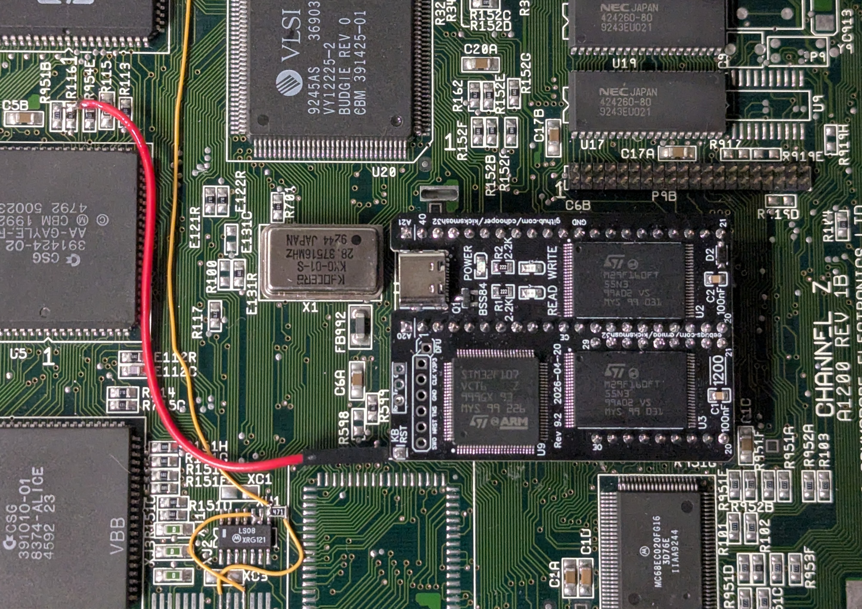
photos/2026_05_13_kicksmash1200_installed_in_amiga_1200.jpg
