cdhooper/kicksmash32/photos/2026_06_01_a3000_rom_switcher_installed.jpg

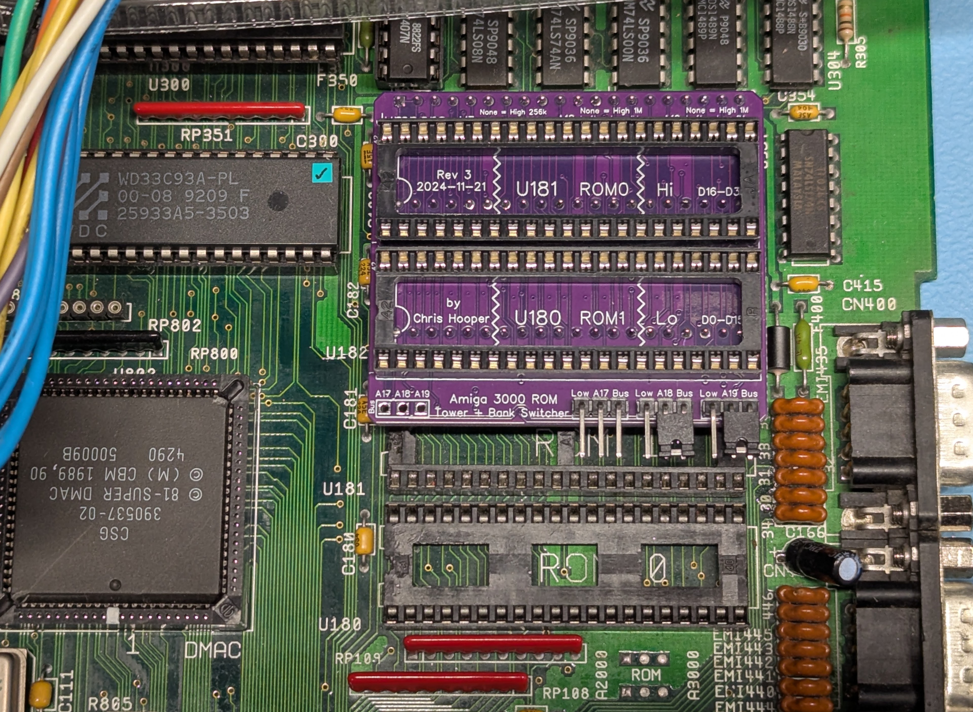
photos/2026_06_01_a3000_rom_switcher_installed.jpg
