cdhooper/kicksmash32/photos/2026_06_01_a3000_rom_switcher_installed_with_kicksmash32.jpg

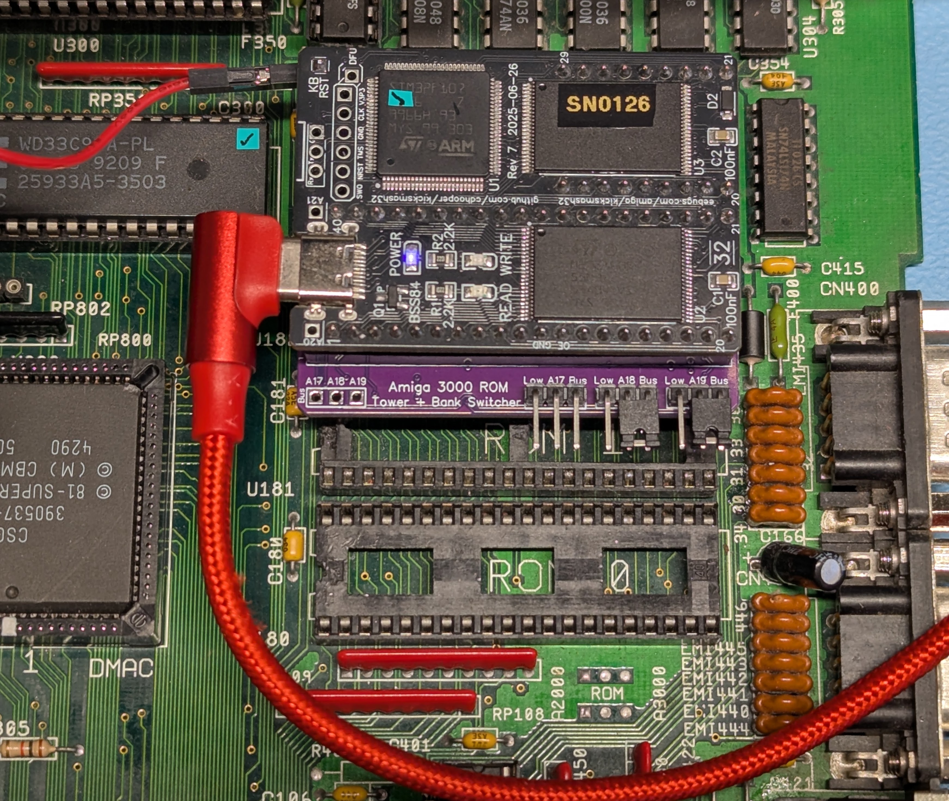
photos/2026_06_01_a3000_rom_switcher_installed_with_kicksmash32.jpg
