cdhooper/kicksmash32/doc/release_notes.txt

Release 2.1

Major changes since 2.0
- SANA-II Network driver through Kicksmash (smashnet.device).
- New Amiga SmashTool GUI for programming Kicksmash ROM banks.
- Kicksmash1200 Rev 10.1, which now works with TF1260
- New Kicksmash tester board and firmware (Kicksmasher).
- ROM Switcher suport of CSMKII, Apollo 4060, and GVP 68060 accelerators.
- ROM Switcher support of Picasso IV flicker fixer and A3640 MAPROM.
- Faster file transfer for smashftp and smashfs.

Kicksmash FW
- Fixed "prom test" in standalone mode to not incorrectly report problems.
- Removed persistent pull up/down of SOCKET_D31.
- Fixed missing mode setting of D16-D31 pull-up state during pin tests.
- Fixed incorrect display for Kicksmash mode when "set" command is used.
- Increased strength of GD32 pin drivers when USB data is being reset.
- Return data pins to input pull-down state after Kicksmash communication.
- Standalone pin test updates to support Kicksmash32 Rev 10 board.
- Worked around GD32F107 hardware USB data corruption bug.
  This involved writing my own code which pulls from the USB Receive FIFO
  and compares against data which is in the backdoor SRAM.
- There are now separate, but similar, drivers for GD32F107 and STM32F107.
- Minor improvements to flash erase / program timeout handling.
- Flash programming code changed to better report the cause of programming
  and CRC failures.
- Overclock GD32F107 to 120 MHz to handle Amiga 1200 Gayle with 68020 CPU.
- Improve pin test detection of new style ROM OE circuit.
- Added reporting of board state to hostsmash and smash.
- Improve sensor reporting output of "prom temp"
- Added sensor reporting of calculated 3.3V.
- GD32F107: remove broken temperature sensor reporting.
- GD32F107: adjust voltage sensor calculation to better track actual V5.
- Fixed STM32 ADC bug introduced in previous commit.
  The bug will cause the STM32 to think the Amiga is not powered on.
- Changed power off strategy to no longer drive SOCKET_OE high or low.
  There is too much risk in doing this for the little backpower gain.
- Enhanced "gpio" co allow port-wide setting. Example: "gpio pa=1234"
- Added support for M29F160xE in the standalone flash CFI test.
- Improve pin tests for GD32F107 -- GPIO drive was not strong enough.
- Added start of persistent RAM which survives resets, but not power cycles.
- Fixed bug in Kicksmash1200 stand-alone test.
- Fixed possible infinite loop bug in handling of corrupt config.
- Enhanced message locking to allow a task to completely lock the buffers.

ROM Switcher
- Fixed "CIA-A ECLK timeout" failure when running in FS-UAE with JIT.
- Screen is now refreshed by both Copper and VBlank in case of fault.
  This should stop crazy displays on a crash.
  Black screen color changes to Dark Violet if the CPU hangs (VBlank).
  Black screen color changes to Dark Copper if the Copper hangs.
- Replaced gadget rendering of cross-hatched "disable" to a solid dark grey.
- Default handlers for the entire 256 68000 vectors are now installed.
- Now supports Picasso IV with GD5446 Rev B and PCI Bridge Rev 2.
  Does not yet work with GD5446 Rev B and Bridge Rev 1, I think.
- Now works with 512KB Agnus (previously required at least 1MB Agnus)
- Fixed bug where keyboard interrupt during initialization could cause a crash.
  The keyboard interrupt handler was not properly saving/reloading A4.
- Removed copy of vectors to RAM since they are ROM-based by default.
  This will very slightly speed up init (1KB copy with cache off).
- Minor improvements to decrease startup time.
- Allow modification of Gary BERR bit from MED cmdline.
- Merge private/public autoconfig structs.
- Made Copper/VBlank watch colors immune to interrupt latency.
- Saturate the Copper miss counter so a long outage cannot wrap it.
- Keep string field bevels within their bounds.
  (Draw recessed string and integer borders inside the gadget rectangle)
- Finish the DrawBevelBox tag scan with va_end().
- Give bank fields room for separate bevel edges to clear up display artifacts.
- Switched to AmigaOS style mouse pointer.
- Changed to keep keyboard button outlines on (200-line NTSC) screen.
- Aligned taller Auto Switch Bank and Timeout fields and labels.
- Fixed "Save" bug where possibly old data would be written on subsequent save.
- Added Amiga serial port control of selected bank and start, such that
  the user may select a Kickstart ROM bank and start it completely from serial.
- Changed 68040/68060 cache init to also set ITT0/ITT1 and clear cache first.
- Changed interrupt and exception handling to ignore spurious interrupts unless
  the rate is causing the main loop to not make progress.
- Improved interrupt and exception vector reporting to capture the frame before
  beginning a report. So if a new interrupt occurs while the current is being
  reported, it won't be clobbered.
- A4 (globals pointer) is now loaded from a ROM constant, making it more
  tolerant of RAM corruption.
- Too many (stacked) exceptions will now force a reboot instead of a hang.
- Improved order of startup code to improve early spurious interrupt tolerance.
- ^M^E^D^S^T^O^P now rejects the STOP when re-entering the GUI (no-input hang).
- Previous commit fixes support of CSMKII and Apollo 4060.
- This commit fixes support for GVP Tekmagic 68060 A4000 accelerator.
- This commit fixes support for A3640 in MAPROM mode.
- Changed initial instructions and ROM signature to be more like Kickstart.
  This fixes the bug where long reset causes Blizkick MAPROM on A3640 to
  simply show a blank gray screen. This is because the first instructions
  were executed from the ROM Switcher and the remainder from the kicked image.
- Changed startup chipset interrupt enable to happen after autoconfig.
- Changed CPU VBR vector 0 and 1 to be default handler rather than SP and reset.
- Changed startup sound to not generate interrupts as it did before.
- Made bevel corner joins consistent to clean up the UI further.
- Added smash command to MED command line
  This means that "smash test" can now be done without booting AmigaOS.
- Improved ^C handling and reporting (previously didn't work if multiple
  levels of code was checking for ^C).
- Added support for polled mode keyboard input
  Amiga keyboard now works even when stuck in interrupt fault
- Vertical blank interrupt no longer updates screen point if entry is slow
  This fixes where if interrupts are disabled briefly during the vertical
  blank interrupt, that the VBlank handler will then corrupt the screen and
  mouse pointers for a single refresh.

smash
- Fixed minor mistakes in error messages (such as missing bank argument).
- Added ability to set Amiga clock from USB host: "smash clock setu"
- Can now report additional Kicksmash board state with -i option.
- Fixed mismatched flash part erase bug.
- Fixed auto swap bug where only the first 16KB was swapped correctly.
- Fixed minor text output issues pointed out by Claude
- Fixed state expiration test early timeout bug
- Read/Write errors on Amiga files are now handled more gracefully
- Split source in preparation for integration into ROM Switcher CLI.
- Message buffer tests now always override locked buffers.
- Added "debugq" option to show the smash message queue and semaphore fields

smashftp
- Increased core message backoff when Kicksmash doesn't have response yet
  This is to corruption of large file "put" transfers.
- Added wildcard support to get, put, ls, chmod, mv, rm, rd, cd, and local equiv
- Fixed minor bug where getting a short file could report false error (EOF).

smashnet
- Added build of standard SANA-II smashnet.device
- Removed reduced priority of smashnet receive task. This caused no network
  progress when another task is busy.
- Made matching changes for no reply on network send an receive
  The change includes sending a refresh tag for receive every 10 seconds.

smashtool
- Implemented new graphical AmigaOS tool to do most smash program functions.
  This includes updating Kicksmash banks with ROM images, setting bank
  names, setting power on image, long reset images, setting the automatic
  bank to switch to on timeout, and setting the Amiga clock from Kicksmash.
- Minor size reduction by embedding a few constant strings.

hostsmash
- Added DiagROM 2.0 and 2.0+ release signature for auto byte swapping.
- Initial network support for Linux, MacOS, and Windows (hostsmash -n).
  Parts of the implementation (most of hostsmash_netif) were written by AI.
- Fixed fwrite bug where missing data on large transfers is ignored.
- Added host interface versioning for backwards compatibility.
- Added support for multiple client threads (finished message tag support).
- Message interface will now exit if it sees a Kicksmash "CMD>" prompt.
- Added support for multiple simultaneous threads sending / receiving messages.
- Improved latency of Windows interactive '-t' terminal.
- Added automatic detection of Kicksmash COM port under Windows.
- Full hostsmash help is now only shown if no command is specified.
- Refactored code to split host file services to a separate source file.
- Can now report Kicksmash info, including board state with -ii option.
- --version will also report Kicksmash version if -d device is specified.
- Added option to "-n" to specify the network option to the back end.
- Added support for flags passed with KS_CMD_MSG_SEND.
  It previously would reject that command having flags (such as override).
- Cleaned hostsmash output prefixes: "HS" is hostsmash and "KS" is Kicksmash.
- Changed network send and receive to not require a reply from the other side.
- Changed network receive to be forwarded by an asynchronous thread.
  With these two changes, ftp read performance went from 1.3K to 3.6K/sec.
- Disabled Linux packet combining default which severely limited TCP
  performance because the Amiga network stack was rejecting those packets.
  With these two changes, ftp read performance went from 3.6K to 44K/sec.
- Changed the message handler to block instead of polling every 1 ms.
- Network packet upstream forward to be lower priority than message poll.
- Made message info poll only occur when debug is enabled.
  With these three changes, ftp read performance went from 44k to 53K/sec.
  smashftp and smashfs saw similar gains, where smashftp is over 100KB/sec

hostsmash_netif
- Turned off debug output of packet send/receive size (-d option enables it)

Kicksmash message interface
- Minor performance improvements by tweaking delay between send/receive.
- Simplified message interface to automatically alloc/free tag for most ops.
  This reduced program sizes by a small amount.
- Fixed minor issues in CPU TC register handling (for MMU disable/enable)
- Fixed minor bug in 68030 TT0 get and set code.
- Fixed persistent smash message semaphore handling
- Fixed bug where smash message semaphore could get double-freed
- Fixed bug where smash error response for a different tag can cause
  the wrong task to respond to the failure.
- Fixed a buffer pool bug where multiple threads of the same process could
  grab the same buffer. This could then corrupt packets for other tasks.
  The buffer pool is now shared among all smash tasks using the semaphore.

Build system
- Minor fixes to make code compilable with gcc 16.2.
- Makefile will now automatically fetch Windows pcap.h file for Windows build.

Documentation
- Updated 74FCT162244 alternatives.
- Added Windows getting started doc from Samoht.
- Updated hw_install.txt with ideas from Samoht.
- Added photos of Kicksmash installed in several different motherboards.
- Update ROM spacing table.
- Improvements to Windows getting started guide.

Kicksmash tester
- Added Kicksmash test board and firmware (Kicksmasher).
- Fix GPIO names.
- Several improvements to pin tests.
  Still unknown whether "Kicksmash is present" detection is good.
- Added USB polling to smash tests, would previously clobber USB negotiation.
- Test button can now toggle between:
  A) Do short smash test loop
  B) Do indefinite smash test runs
  C) Stop running smash test
- Test button will now flicker status LED and do nothing else while pressed.
- Cleaned up "smash" command help and removed unused code (such as clock set)

PCBs
- Kicksmash32 Rev 10
- Kicksmash1200 Rev 10.1
- Kicksmasher Rev 2
- Renamed all board directories to make it easier to find the board you want.

----------------------------------------------------------------------------

Release 2.0

Kicksmash FW
- prom log command now shows what it thinks is the actual Amiga address
- Fixed bug where "comp" command could not be used
- Sync MED command line fixes and enhancements across repositories
- Fixed bug where "prom name A4000-CR" would set the name to "a3ff4R"
- Added standalone pin test to verify data lines are connected to flash parts
- Added flash A1-A8 address pin test.
- Changed serial number algorithm to not emit non-alphanumeric characters
- Reduced ADC clock from 12 MHz to 9 MHz
- Slightly improved ROM address capture latency by not capturing high bits
- Locked down libopencm3 to a specific known working version
- Change backpower solution to instead drive 0V on the Amiga data lines.
- Added initial GD32F107 support (higher clock speed). More work is needed.
- Further GD32 support - GPIO speed mode affects maximum pin current
- Improved pin tests (A0-A15 connection determination)
- Added "prom test force" to force initial pin tests.
- Fixed bug in USB ACM implementation which prevented using newer libopencm3
- Increased usbdfu ROM area size to deal with libopencm3 code creep
- Fixed pin tests for Kicksmash Rev 10+ (SOCKET_OE tri-state)
- Kicksmash Rev 10+ now sets internal SOCKET_OE high when power is off

ROM Switcher
- Added some tolerance of CIA-A not being readable (incomplete)
- Added debug background color (blue) during initialization
- Added MED "cpu spin <addr>" command
- Fixed false repeating key when multiple keystrokes are held
- Early init color sequence
  Green background: Stuck at chipmem init
  Bright Blue background: Stuck at early chipset or CPU vectors init
  Power LED bright: Stuck at IRQ init, CPU type, or serial init
  ROM ID at serial: Stuck at cache init
  'A' at serial: Stuck at chipset init
  'B' at serial: Stuck at screen init
  'C' at serial and Medium Blue background: Stuck at timer init
  'D' at serial: Stuck at audio init
  'E' at serial and Half Blue background: Stuck at serial reinit
  'F' at serial: Stuck at keyboard init
  'G' at serial: Stuck at mouse init
  'H' at serial and Dark Blue background: Stuck at sprite init
  'I' at serial: Stuck at autoconfig init
  'J' at serial: Stuck command line init
  'K' at serial: Stuck at drawing test
  Grey background: ROM switcher should be running
- Added MED ability to get/set CPU SR register
- User may now enter a digit to select that bank for booting
- Fixed MED bug where "comp" command could not be used
- Improved tolerance of spurious interrupts because they do occur on some Amigas
- Moved Vector base from chipmem to ROM
- Added support for Keyboard-controlled Mouse movement and clicks
  Amiga-cursor keys for small movements
  Shift-Amiga-cursor keys for large movements
  Control-Amiga-cursor keys for move-to-next gadget
- Enhanced build system to allow toolchain on a different path than standard.
- Fixed dehunk compilation errors and portability issues.
- Replaced MX radio button gadget rectangle with capsule shape
- MX radio button gadgets now drawn with 3D beveled outlines
- Cleaned up serial output to always emit \n in combination with \r
- Zorro configuration apertures are now marked as uncacheable
- Implemented autoconfig of all Zorro devices by default
- Improved autoconfig to handle Zorro II devices visible through the
  Zorro III config aperature.
- Fixed autoconfig of Zorro III device in Zorro II window (HW doc is wrong)
- Find and configure Picasso IV flicker fixer as part of autoconfig
- Serial and screen output paths are not independent
- Fixed serial init to enable the master interrupt to avoid using
  timer delays before EClock rate has been established.
- Work around gcc 6.5 compiler warnings, not knowing -Wstringop-overflow

smashftp and smashfs
- Improved file operations by adding automatic message retry on CRC error
- Fixed bug where devtest -g on smashfs device could crash Amiga

hostsmash
- MacOS can now automatically locate Kicksmash
  So in most cases, one no longer needs to specify -d /dev/cu.usbmodem*`
- Fixed file service bug where non-existing file opened for create would fail
- Fixed (some) macOS compilation problems
- Added --version option
- Kicksmash asynchronous text messages will now be shown as just text
  when hostsmash is in file server mode.
- Flash write is allowed to continue even if swap mode can't be determined

smash
- Improved flash id test to better recover from Kicksmash message failures
- Enhanced smash term to allow text to send to be specified on the command line
  In that mode, term will exit after no output for 1 second
- Enhanced smash write to always first prompt for erase
- Improved smash write and erase flash error recovery
  Now even if Kicksmash communication is not 100% stable, it may still
  be possible to write flash from AmigaOS.

Build system
- Added ADF image generation as part of release process

Documentation
- Added AmigaPCi
- Minor updates to Windows notes for driver install help
- Added HW install info for A4000CR and AA3000+
- Added Windows tip about keeping the same COM port
- Added sourcing help for 74FCT162244 and alternatives

PCBs
- Kicksmash4KCR updated to Rev9

----------------------------------------------------------------------------

Release 1.9

Kicksmash FW
- Added support for M29F160TB - Closes #22
- When the Amiga is off, SOCKET_OE is now driven high by firmware
  This should reduce the amount of backpower provided to a powered off Amiga
- When the Amiga is off, prom access will now fail rather than be attempted
  "Amiga is not powered on" will be reported. This will help people understand
  the cause of hostsmash failing to program a powered off Amiga.
- Added new config "board_rev"
- Fixed message buffer bug where large transfers might be partially re-sent.
  Fixes smashfs and smashftp bug when the Amiga sends a file > 2KB in size
- Added "prom log full" and "prom log stats" options
- Added support for MX29F800Cx, MX29LV160Cx, and M29W160Ex
- More work is still required for MX29F800Cx support
  Write fails at 0x154 wrote=040041f9 read=00f000f0
- snoop of Amiga ROM accesses should now work better over USB connection
- Added "what" command to re-display recent output
- Fixed BIGROM support for A4000T by disabling pull down on address pin

ROM Switcher
- Fixed MED "aconfig" command to handle Z3 board configured in Z2 space
- Added MED "what" command to MED command line
- Added debug command line on exception and unexpected interrupt
- Added 68k disassembler to MED command line ("dis" command)
- Changed blitter init to hopefully be more resilient to odd register state
- Serial input is now interrupt-driven
- Added register display and stack dump on unexpected interrupt or hang detection
- Added CPU cache initialization and enable
  This will hopefully resolve the occasional cold poweron bug that I've been tracking
  First 16 MB of RAM will not be cached for 040+. 68030 has data cache off.
- Made minor changes to Amiga chipset init to improve startup reliability.
- Added MED "cpu" command with fault injection, CPU identify, and CACR control
- Removed FLASH_RP from pin tests, since it's no longer connected on Rev8 boards
- Improved spurious interrupt handling and reporting
- Improved handling of ECLK tick failure
- Dump on unexpected interrupt is now less likely to cause VBlank timeout
- Rearranged MED "cpu fault" and "cpu reg" commands
- Added several processor-specific registers to "cpu reg" command
- Early init is now protected from unexpected interrupt
- Fixed command history bug where line was not being redisplayed correctly
- Screen DIWSTOP fix so that vertical scan stops at a reasonable position
- Interrupt register display code now reports the vector name
- Added support for 68030 "cpu reg tt0" and "cpu reg tt1"
- Moved ROM version string near the beginning of the file and added $VER string
- Power LED now goes bright during early initialization

hostsmash
- Fixed '--clock set' to get and report the correct time on Windows
- The issue was that the Windows code was not computing the UTC offset.
- Added Windows command line editing keystroke support for term mode
- Fixed smashfs/smashftp bug on Windows where binary files failed to transfer
- Fixed bug where app service state would time out on large file transfers
- Improved error recovery in some failure cases (still needs more improvement)
- Fixed bug where length (-l) is ignored when merging ROM files: Closes #31

smashfs
- Fixed bug where copy from write-protected file could fail
  FINDINPUT and FINDUPDATE now try open a second time with only read permission

smash
- Added support for MX29F800Cx, MX29LV160Cx, and M29W160Ex
- Added support for compatible flash parts
- Eliminated debug "Cleariog atou" message

PCBs
- KicksmashAPCI added
- Kicksmash4KCR updated to Rev8

Documentation
- Minor fixes for address range of 512 KB extension ROM area

----------------------------------------------------------------------------

Release 1.8

NOTE: The Message interface has changed since 1.5. If you are running 1.6
      or more recent, you don't need to update all software and firmware
      at the same time.

Kicksmash FW
- Worked around flash chip bug (0x90 to address 0x55) again.
- Fixed flash programming bug which caused missed data from the USB host.
  This bug was introduced at the workaround for the M29F160 flash chip bug.
- Added "set sw_timeout" command to set the ROM Switcher timeout
- Added "set sw_bank" command to set the ROM Switcher bank

smash
- Added "set sw_timeout" command to set the ROM Switcher timeout
- Added "set sw_bank" command to set the ROM Switcher bank

hostsmash
- Now replays Kicksmash output to user when flash programming failure occurs.
  This will allow one to see an error that the Kicksmash FW emitted..
- Improved auto byte order swapping to detect more ROM types

ROM switcher
- Fixed bug where clicking + or - for Long Reset settings was broken.
- Spacebar now switches between PAL and NTSC.

Documentation
- Updated FAQ to give better reason why to use Kicksmash.
- Updated FAQ with specific example of upgrading Kickstart to 3.2.3.
- Miscellaneous updates to the FAQ.
- Improved grammar in HW build and programming instructions.
- Updated SW hostsmash, smash, and smashftp documentation.

----------------------------------------------------------------------------

Release 1.7

NOTE: The Message interface has changed since 1.5. If you are running 1.6
or newer, you don't need to update all software and firmware at the
same time.

hostsmash
- Fixed bug where merging 512KB Amiga ROMs resulting in 1 MB image to write.
  This is not desirable because AmigaOS ROM images are doubled.
- Enhanced ROM write to no longer check if area is erased, but to just
  prompt user for erase approval.
- Fixed hostsmash "--clock" argument alias for "-c"

ROM switcher
- Fixed bug introduced in 1.6 ROM switcher which can cause motherboard
  fast memory to go missing.
- Fixed bank switch timeout to not abort unexpectedly at startup.
- Fixed potential Blitter initialization bug.
- Added polygon fill so the rendering of Kicksmash is not just line art.

Kicksmash FW
- Fixed bug where crash could happen at long reset if longreset bank is not set
- Fixed pin test bug where SOCKET_OE=1 might cause SOCKET_D31=1
- Worked around M29F160 flash chip bug which prevented AmigaOS 2.04 from
  being flashed. Value 0x90 was being written to address 0x55, which put the
  flash in "READ CFI QUERY" mode, causing programming to fail.
- Added "address" pattern to Kicksmash "patt" command.
- Added "random" pattern to Kicksmash "patt" command.
- Added Flash OEWE test of Q2 and Q3 based on speed of those parts. This
  test was implemented because AO34000A parts populated on the Rev 6a boards
  cause programming from the Amiga to fail because they are too slow.
  Fixed walking bits tests in "test" command.
- Increased Amiga UART buffer from 1024 bytes to 2048 bytes.
- Fixed potential false error at 100% when hostsmash is writing a ROM.
- Eliminated some variable latency in Kicksmash-Amiga CPU command replies.

smash
- Improved flash ID test (6) to report values on failure.
- Code to return flash to read mode now tries extra hard.
- This may fix crashes with "smash erase" and "smash write" commands.
- Minor help text improvements.
- Improved 'flash id' test failure recovery to be less likely to hang Amiga.
- Implemented flash command sync retry when Kicksmash is late with flash.
  command. This will hopefully resolve "flash id" test and other flash
  command failures.

Miscellaneous
- Fixed bug in wdikicksmash.bat, which was fetching the wdi-simple.exe
  using a bad filename.

Documentation
- Added warning about Kicksmash1200 incompatibility with TF1260.
- Minor documentation updates.

PCBs
- Rev Kicksmash1200 to version 7.1 (fix USB-C cutout)

----------------------------------------------------------------------------
Release 1.6

NOTE: The Message interface has changed. You must update all software
and firmware to the same version.

smash
- Fixed crash issue with assuming ROM is ready for access too early
- Fixed ^C handling to consistently report "^C Abort"
- Flash reads and writes now wait longer before assuming bank is restored.
- Added new "term" command for Kicksmash firmware terminal from AmigaOS
- Added flash id test and Kicksmash command test
- Removed redundant "-v" verify as reported by SimD
- Added ability to specify write+verify with "-wv"
- Fixed ROM read / verify bug (wasn't waiting long enough for Kicksmash FW)

smashfs
- Files larger than 4 GB are now reported as (4 GB - 1) size instead
  of just the lower 32 bits of the file size. This might need to be
  clipped further to (2 GB - 1) if Amiga programs don't like >= 2 GB.

smashftp
- Files larger than 4 GB now have their actual size shown with ls

ROM switcher
- Added Blitter initialization as it sometimes is stuck at power-up
- Added initialization of Ramsey refresh and memory burst settings
- Increased Kicksmash message retry count from 3 to 5

hostsmash
- Significantly improved throughput on Windows for flash programming
- Fixed Windows help to reflect "comX" for serial port
- Increased erase update timeout from 2 seconds to 4 seconds
- Fixed bug where "-c get" was actually setting Kicksmash Amiga time

Kicksmash FW
- Improved magic address search to use less memory bandwidth, which
  hopefully fixes the CRC and missed message failures
- Fixed pin tests to not report issues with USB-C CC1 and CC2 pins.
- "prom name" no longer requires quotes around name
- "set name" no longer requires quotes around name
- "prom bank name" no longer requires quotes around name
- Amiga cursor key sequence is now supported (support smash term -T)
- Added "time amiga" command to show tracked Amiga RTC time (if set)

PCBs
- Added Kicksmash4KCR PCB for Amiga 4000CR motherboard
- Added Kicksmash3KT PCB for Amiga 3000T motherboard
- Added Kicksmash1200 PCB for Amiga 1200 motherboard

Documentation
- Moved to sub-pages to better organize access
- Most documentation has been refreshed
- Added more images and sub-pages, including page to help select board

----------------------------------------------------------------------------

Release 1.5

hostsmash
- Fixed bug in program verify on Raspberry Pi (ARM ring buffer reordering)

romswitcher
- Can now run standalone (no Kickstart required)
- Fixed bug in Kicksmash message error recovery code which would cause hang
- New feature: timeout and automatic ROM bank selection

Kicksmash FW
- Made set command output easier to understand
- Added 32 NVM bytes for Amiga program use (2 used for timeout/bank select)
----------------------------------------------------------------------------

Release 1.4

Kicksmash FW
- Added ability to set Power LED brightness "set led <%>"
- Added preliminary (untested) 32-bit ROM low/high swap support
- Fixed looped delay cmd clobbering time suffix (ie: loop 5 delay 10ms)
- Added "cpu hardfault" command to generate a firmware hard fault
- Added resume and command line recovery attempts at firmware fault
- Reworked Amiga long reset handling to now hopefully correctly detect it
- Improved Kicksmash message handling to be slightly faster
- "prom log 999" now shows both address buffer bases
- Bad message length is now detected (bug caused Kicksmash FW crash)
- Fault LED should now blink even during Amiga ROM programming
- A new input sequence ^R^E^S^E^T will force the KickSmash FW to reset
- Added stand-alone DFU bootloader for less problematic firmware updates
- Added "reset dfurom" for STM32 ROM-based ROM updater
- Flash write LED now also illuminates when writing flash from host
- Fixed pin tests to correctly detect if D31, A18 and A19 are connected
- Enhanced pin tests to set alert LED when problems are found with the flash
- Disabled Amiga-in-reset detection when KBRST is not connected in Amiga
- Increased 5V warning limit to 5.4V (A4000T has higher MB voltage)

romswitcher
- Added automatic retry of any failed Kicksmash command
- Removed Return/Enter as a quick select for switch & reboot

smash
- Improved message fault recovery to spin until ROM is consistent

smashftp
- Fixed looped delay cmd clobbering time suffix (ie: loop 5 delay 10ms)

hostsmash
- Fixed fatal errors to correctly exit on Windows
- Fixed bug on Windows where programming failed due to timeout
- The bank option is now required for read, write, verify, or erase
- Two ROM images may now be specified for programming (will be merged)
- Flash image write/verify swap mode is now automatically detected
- The -t command now takes an optional command to send to KickSmash
- On Windows now lists available COM ports if "-d " is not specified
- Bank size now defaults to 512 KB, even when writing smaller image

----------------------------------------------------------------------------
