cdhooper/kicksmash32/apci_rev8/errata.txt

KBRST should be moved slightly further outside to avoid motherboard RN200
