cdhooper/kicksmash32/(threads)

Thread 7 (2025-01-27):

KickSmash32 BOM Folder to use when ordering the KickSmash32 from JLCPCB or PCBWAY

pgergen, 2025-01-27:
Hi

Firstly thank you so much for your KickSmash32 Project, it is amazing to see this very cool tech and software come to life.

Can you please tell me which folder (rev5, rev6_4kt or reve6_32) I should be using to order the KickSmash32 from JLCPCB or PCBWAY ?

Many Thanks
Peta

cdhooper, 2025-01-27:
Thank you. I am excited to learn that others find this project useful. I personally recommend JLCPCB, just because I have ordered fully assembled boards from them in the past and know that they can deliver based on the BOM.
Use Kicksmash32 rev6_32 for Amiga 3000D and 4000D.
Use KickSmash4KT rev6_4KT for Amiga 4000T.
Other Amiga types are not yet supported.

Closed 2025-01-27.

Thread 8 (2025-01-27):

KickSmash32 Suitable for which Amiga

pgergen, 2025-01-27:
Hi

Can you advise which Amigas the KickSmash32 works with and which folder is suitable for ordering ?

1. Amiga 3000 Desktop (3000D) =     Folder rev5 / rev6 / rev6_4kt
2. Amiga 3000 Tower     (3000T) =     Folder rev5 / rev6 / rev6_4kt
3. Amiga 4000 Desktop (4000D) =     Folder rev5 / rev6 / rev6_4kt
4. Amiga 4000 Tower     (4000T) =     Folder rev5 / rev6 / rev6_4kt
5. Amiga 1200 Desktop (1200) =     Folder rev5 / rev6 / rev6_4kt

Many Thanks once again for a great project

Regards
Peta

cdhooper, 2025-01-27:
The Rev5 folder is just there to support people who that version recently. There is not much difference between Rev5 and Rev6 other than BOM changes to make it easier to have JLCPCB produce.

Use Kicksmash32 rev6_32 for Amiga 3000D and 4000D.
Use KickSmash4KT rev6_4KT for Amiga 4000T. The difference between the two is how far apart the ROM sockets are located.

There is no KickSmash version (yet) supporting Amiga 4000D CR or Amiga 1200. The socket spacing is quite different from others for both of these boards.

Closed 2025-01-27.

Thread 9 (2025-01-29):

BOM file for rev6_4kt error occurs at JLCPCB

pgergen, 2025-01-29:
Hi

When processing the BOM file for rev6_4kt the following error occurs at JLCPCB:

Error
The below parts won't be assembled due to data missing.
H8,H4,H5,H6,H7 designators don't exist in the BOM file.

Can this be amended thanks.

Peta (VermillionAmiga)

cdhooper, 2025-01-29:
You can safely ignore those errors. They are not in the BOM because it's undesirable to install them.

H4 is the optional console port. You do not need to populate this header unless developing.
H5 is the optional DFU pin. You do not need to populate this header. I personally use a set of tweezers to short this pin and the V3P3 pin next to it when wanting to put the board in DFU mode from cold poweron
H6 is the optional SWD/JTAG port. You do not need to populate this header unless developing.
H7 is the A18 via. You do not need a pin populated in this socket. Depending on if you have Romy installed and you want to support 1MB ROMs, you would attach a wire between this via and the Romy board.
H8 is the A19 via. You do not need a pin populated in this socket. Depending on if you have Romy installed and you want to support 2MB ROMs, you would attach a wire between this via and the Romy board.

Closed 2025-01-29.

Thread 13 (2025-04-10):

Issue with wdikicksmash.bat

apolkosnik, 2025-04-10:
wget saves file to disk under name: "wdi-simple.exe@raw=true"

04/10/2025  07:05 PM         6,404,608 wdi-simple.exe@raw=true

Change:
`wget https://github.com/rogerclarkmelbourne/Arduino_STM32/blob/master/drivers/win/wdi-simple.exe?raw=true"`

to:
`wget https://github.com/rogerclarkmelbourne/Arduino_STM32/blob/master/drivers/win/wdi-simple.exe?raw=true" -o wdi-simple.exe`

Closed 2025-04-10.

Thread 16 (2025-05-04):

74FCT162244 alternatives

bodgit, 2025-05-04:
I'm trying to put together an order for parts from your BOM for building an A1200 kicksmash board however the 74FCT162244 part seems to be unavailable on LCSC and Mouser.

Is there an alternative part that can be substituted here? Or rather a different logic family instead of FCT? I can see an ABT equivalent part in TSSOP format that is also TTL logic levels.

cdhooper, 2025-05-04:
74FCT162244 can be a difficult part to source. You can get them from Digikey (example: 74FCT162244ATPACT) using JLC's Global Parts sourcing.
The SN74ABT162244DGGR or  SN74ABT162244DLRG4 part might work great. I've not tested them and can't guarantee anything. What I see from the datasheet is that they have a compatible pinout, switching speed, and drive strength.

Important things to consider:
    Must be TSSOP-48
    Must be 5V tolerant
    Must be TTL compatible

Another possibility, if you are building by hand, is that you could substitute in a TSSOP 74FCT16245 or 74FCT162245. You'd need to rotate that part 180 degrees, which might raise a few eyebrows. Of course, if you are hand-building, you could also source the parts from somewhere else, like ebay.

Closed 2025-05-04.

Thread 17 (2025-05-18):

A1200 test

thechane, 2025-05-18:
First off, great project - thank you!

I am willing to give the A1200 board a trial, I am far from an electronics expert but pcbway and the like make it super easy now so I thought why not. I uploaded the files and they're asking me what the inner copper thickness. I guess because this is a 4 layer board, I'm thinking 0.5oz should be fine?

cdhooper, 2025-05-19:
Yes, it is a 4-layer board. 0.5 oz should be fine for the inner layers. Please note that there appears to be a compatibility issue on the 1200 between Kicksmash32 and the TF1260.

Closed 2025-05-19.

Thread 18 (2025-05-24):

Sourcing of 74FCT162244

RHasemann, 2025-05-24:
Hi!
first, thank you for this project. Makes the daily Amiga Life much easier.
Currently the 74FCT162244 (esp. the 74FCT162244CTPAG) are hard to source because the part is discontinued.
Is there any available substitute? Can the FCT replaced by ABT types?

Thx!

Falcon3011, 2025-06-16:
Hello,

Also, i want to tell you, thank you for this project. I like this project.
I have the same question. Or, can be replaced with 74**ACT**16244DGGRG4 ? Its ACT, not FCT. Exist also others alternatives, but always is there some differences and i dont know how much is important Operating Supply Current 6,4mA vs 80 microA, if should to be enough also with 80 microA, or not.

Thx

Falcon3011, 2025-06-17:
Thank you very much , your answer helped me a lot.

Best Regards

Closed 2025-06-16.

Thread 20 (2025-06-24):

A1200 Kicksmash32 not showing up in DFU mode

bodgit, 2025-06-24:
Hello again,

I have built my first A1200 Kicksmash32 board apart from adding the machine pins as per your build guide. I'm at the stage of programming the STM32 but it doesn't show up on the USB bus when I put the board into DFU mode by adding a jumper across the two pins. The `READ` LED does light up as expected when the USB cable is connected.

I've checked the board under magnification and can't see any bridged pins on any of the major chips. I was wondering if you had any tips on what to try debugging first?

Thanks

cdhooper, 2025-06-25:
You've made good progress. The STM32 USB DFU ROM on the STM32F105/STM32F107 is also flaky under Linux. It sometimes takes more than 20 seconds to bring up the interface, so I could very well understand bad interactions with MacOS or Windows or even other Linux USB drivers. The ROM DFU was so annoying that I implemented my own DFU downloader for Kicksmash. So now, when you want to update Kicksmash, if you send it the `reset dfu` command, it executes its own DFU downloader instead of the ROM version.

The power LED is flashing because a pin test fault occurred. In this case, the benchmark of time from SOCKET_OE to FLASH_WE when FLASH_OEWE is enabled. This is a recent test enhancement, as it was discovered that the Q2 and Q3 MOSFETs specified in the Kicksmash BOM are often too slow. This affects flash programming from AmigaOS. You are likely using AO3400A parts. Try switching Q2 and Q3 to 2N7002.

bodgit, 2025-06-28:
I was indeed using the AO3400A parts from the BOM. I've now just swapped them out for 2N7002 parts as you suggested and the failures have disappeared:
```
$ ./hostsmash -d /dev/tty.usbmodem4d9050QL56616C1 -t
<< Type ^X to exit.  Opened /dev/tty.usbmodem4d9050QL56616C1 >>

Kicksmash 32 Version 1.6+ built 2025-06-24 11:43:42
    CPUID=411fc231 Dev=0418 Rev=1001 (compile: STM32F107xC BOARD=4)
    Hardware: STM32F1    Connectivity revision Z
    HCLK=72 MHz  APB1=36 MHz  APB2=72 MHz
    Power-on reset
Valid config at 3e000
Connected: !A17 !A18 !A19 !D31 !KBRST Flash0 Flash1
Prom 000122d2 000122d2 M29F160FT M29F160FT
Standalone
CMD>
CMD> prom id
000122d2 000122d2 M29F160FT M29F160FT
CMD>
```
Now the `READ` and `POWER` LEDs are lit and `WRITE` is off. I guess I'm now good to move onto the next steps?

Thanks for the advice.

cdhooper, 2025-06-29:
Great! Please be aware that there is a compatibility problem between Kicksmash1200 and TF1260, and possibly other accelerators. The issue is that Gayle is not qualifying ROMEN based on _AS, and instead could glitch this signal as address signals change on the bus.

Closed 2025-06-29.

Thread 23 (2025-07-26):

Hostsmash: prom write Program mismatch

idrougge, 2025-07-26:
I ordered five Kicksmash32 boards from JLCPCB, using the BOM in the project. Due to shortages, I left out the LEDs and mounted them myself. I also had to replace U2 and U3 with MX29F800CBTI-70G which are recognised when connecting to the board using a terminal.

I also replaced Q2 and Q3 with 2N7002 after consulting `hw_build.txt`, after which the power LED has a steady light instead of blinking and board's terminal output no longer reports any warnings:

```
Kicksmash 32 Version 1.8 built 2025-07-11 12:32:17
    CPUID=411fc231 Dev=0418 Rev=1001 (compile: STM32F107xC BOARD=4)
    Hardware: STM32F1    Connectivity revision Z
    HCLK=72 MHz  APB1=36 MHz  APB2=72 MHz
    Power-on reset
Valid config at 3e000
Connected: !A17 !A18 !A19 !D31 !KBRST Flash0 Flash1
Prom 00c22258 00c22258 MX29F800CB MX29F800CB
Standalone
CMD>
```

However, when attempting to flash a Kickstart using Hostsmash, it fails, on two different boards:
```
./hostsmash.mac -d /dev/cu.usbmodem1101 -w -v ~/AmigaOS-3.2.3/Update3.2.3/ROMs/A4000.47.115.rom -b 0
Auto swap mode: 32, Swapping 3210, Length 0x80000
Erase area before write? -- are you sure? (y/n) y
Erase sector(s) from 0x0 to 0x80000: yes
Sector erase 0 len 80000
00300030 .. 0 sec    Done
Writing 0x080000 bytes to EEPROM starting at address 0x0
0%Remote sent error 32
Kicksmash FW: 32-bit) CMD> CMD> prom id 00c22258 00c22258 MX29F800CB MX29F800CB CMD> C
              MD> prom erase 0 80000 Sector erase 0 len 80000 00300030 .. 0 sec Done C
              MD> CMD> prom write 0 80000 Program mismatch at 0x154 wrote=040041f9 rea
              d=00f000f0
hostsmash.mac: Send failure
```

cdhooper, 2025-07-26:
Based on the address of the failure and the value reported, it appears that the workaround for the AMD+others M29F160 bug is triggering a different bug in the Macronix flash. I have a potential fix for this, but no way to test it. Please send me an email at pcb@cdh.eebugs.com and I'll send you test firmware.

Thread 24 (2025-08-03):

rev7.1_1200 layers

helmyuk-star, 2025-08-03:
Hi,

I have uploaded the gerber file for rev7.1_1200 to PCBway and the audit fails. I get  a message from them asking if the board is 2 or 4 layers.  I'm quite new to getting PCB's produced like this and would very much appreciate your help.

Regards

Matt Arnold

helmyuk-star, 2025-08-03:
I've just found my answer in another issue posted here.

helmyuk-star, 2025-08-03:
Hi Chris

Thanks for the info.  Is this a firmware issue just wondering if it is something that can be sorted

Sent from Outlook for Android<https://aka.ms/AAb9ysg>
________________________________
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

cdhooper, 2025-08-03:
The fix will require a hardware change.

From the Kicksmash doc: DO NOT USE KICKSMASH1200 WITH A CPU ACCELERATOR. Due to a bug in Gayle, Kicksmash may drive bus data at the same time an accelerator like the TF1260 is reading or writing another device. This can cause the Amiga to crash. There is no current workaround.

Closed 2025-08-03.

Thread 25 (2025-08-08):

Kicksmash1200 pin test failure

Falcon3011, 2025-08-08:
Hi,

I build own Kicksmash for A1200, everythings compiled, dfu mode was successful, but after reset and connecting over usb the hostmash show :

falcon@Debian-i7:~/Plocha/kicksmash32/sw$ ./hostsmash -d /dev/ttyACM0 -t
<< Type ^X to exit.  Opened /dev/ttyACM0 >>

Kicksmash 32 Version 1.8+ built 2025-08-07 23:57:23
    CPUID=411fc231 Dev=0418 Rev=1001 (compile: STM32F107xC)
    Hardware: STM32F1    Connectivity revision Z
    HCLK=72 MHz  APB1=36 MHz  APB2=72 MHz
    Software reset
    New config
Connected: !A17 !A18 !A19 !D31 !KBRST Flash0 Flash1
Pin test failure
FAIL SOCKET_OE -> FLASH_WE time to 0 = 1138 nsec
FAIL SOCKET_OE -> FLASH_WE time to 1 = 416 nsec
Standalone
CMD> config write at 3e000

CMD> prom id
000122d2 000122d2 M29F160FT M29F160FT
CMD>

What can it means ?
The U5, U6 can be slow (I have 74ABT16244ADGG), or Q2, Q3 can be slow , or... ?

thank you
Gabriel

cdhooper, 2025-08-08:
It's probably the MOSFETs. The original parts specified in the BOM are too slow for reliable flash operations from AmigaOS. Try replacing Q2 and Q3 with 2N7002

Thread 26 (2025-08-08):

"Pin test failure" on anything after 1.6

dlundqvist, 2025-08-08:
I have a board (rev6_32) I recently bought from a builder. It came with 1.6 but figured I wanted to upgrade before putting it into the A3000. I'm using dfu-util to upgrade. Any version after 1.6 (1.7 and 1.8) shows errors when I connect with hostsmash:

```
% ./hostsmash.linux_x86_64 -t
Using /dev/serial/by-id/usb-eebugs_KickSmash_Prg_9d9050WE02310C-if00
<< Type ^X to exit.  Opened /dev/serial/by-id/usb-eebugs_KickSmash_Prg_9d9050WE02310C-if00 >>

Kicksmash 32 Version 1.7+ built 2025-07-06 22:24:49
    CPUID=411fc231 Dev=0418 Rev=1001 (compile: STM32F107xC BOARD=4)
    Hardware: STM32F1    Connectivity revision Z
    HCLK=72 MHz  APB1=36 MHz  APB2=72 MHz
    Power-on reset
Valid config at 3eb00  (KickSmash32)
Connected: !A17 !A18 !A19 !D31 !KBRST Flash0 Flash1
Pin test failure
FAIL SOCKET_OE -> FLASH_WE time to 0 = 958 nsec
FAIL SOCKET_OE -> FLASH_WE time to 1 = 416 nsec
Standalone
CMD> prom id
000122d2 000122d2 M29F160FT M29F160FT
```

Also, power LED is flashing and write LED is steady on. I believe read LED is on, but very faint. Same output and behaviour from 1.8.

Figured I ask here before bringing it up with the builder.

dlundqvist, 2025-08-08:
Thanks, I found reference to swapping out transistors but was not sure that's the problem since 1.6 seems to work fine (I haven't really put it in the Amiga yet so don't really know).

Falcon3011, 2025-08-08:
Hi, i have similar issue, and i used DMN3042L-7. Also i haven’t Kicksmash
in the Amiga. I need to buy 2N7002 asap, where these times are in datasheet
max 20ns, so it should be ok. We will see 😁

Dňa pi 8. 8. 2025 o 13:53 dlundqvist ***@***.***> napísala(a):

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

dlundqvist, 2025-08-08:
I see now that new output came in 1.7 (7fcea039a532b053dba23c95d32e8d18ebfc16e4). So with 1.6 and earlier we're a bit in the blind.

dlundqvist, 2025-08-08:
I now know I have the wrong transistors in Q2 and Q3. Just a follow up question, how will this manifest itself from AmigaOS? I'm writing from AmigaOS and no error message is shown, just that nothing is written. Would that be the symptom?

cdhooper, 2025-08-08:
Q2 and Q3 affect how fast the write enable line to the flash is asserted and deasserted relative to the ROM line. If timing is off, I think it would be reflected in the flash not seeing the correct address. This cause the flash to not see the unlock sequence for a command, so it would likely ignore the command.

You might try looping the smash flash test, which repeatedly does the flash ID command:
    smash -t5 -l 1000

dlundqvist, 2025-08-08:
Hmm... that one gives me lots of "Unexpected ID values from flash", with both rc1 and rc2 equal -7 (Msg No Reply).

dlundqvist, 2025-08-08:
As far as I can see, jumpers are in correct position:

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

This is an unexpanded A3000/25 with 16MB Fast RAM (on motherboard). Currently only one Z2 card installed. I tried with all 3.2 Kickstarts, same problem (if version would matter).

For `smash -t` command, everything up to and including Message buffer pass. Remove message and Flash ID fail.

cdhooper, 2025-08-08:
In that case, replacing the Q2 and Q3 transistors might clear up all failures.

Remote message failing is normal if hostsmash is not running in file service mode on your USB-connected host.

dlundqvist, 2025-08-09:
Confirmed that Remote message error went away when I started hostsmash. I'll continue in a new issue if replacing Q2/Q3 did not solve my issues. Thanks for your time.

dlundqvist, 2025-08-22:
Quick follow-up here. I've had Q2 and Q3 replaced and I no longer see these errors, and I can also successfully write ROMs from the Amiga.

Thread 27 (2025-08-14):

Unknown interrupt 25

dlundqvist, 2025-08-14:
On my A3000, since 5ab0ed6300847aaaa5f5b09e2b6c1552cfa0d1f4 switcher.rom "faults" with Unknown interrupt 25 and ends up in IRQ debuger. It takes different times to happen, but usually switcher.rom does not have time to draw its screen before it happens.

cdhooper, 2025-08-14:
I am not able to reproduce this problem with my A3000. As far as I can determine, CPU Interrupt vector 25 is generated by INT1, which I think can be Paula. Maybe floppy interrupt?

The previous version of the vector handling code just immediately returned from unknown interrupts without reporting anything. I'll probably need to modify the code to maybe ignore unknown interrupts at startup.

dlundqvist, 2025-08-15:
I'm gonna do some extended troubleshooting this weekend for an unrelated issue (TF4060 that won't play nice), and have ordered a new Paula (just in case).

dlundqvist, 2025-08-24:
This does does not boot for me. From serial:
```
ROM Switcher 1.8+ (2025-08-24 09:27:57)

ABC
Unknown interrupt 326
  SP 0000ffcc  PC 00f85224  SR
Stuck?  SP 0000fea4  PC 00f85eec  SR 2204  Vect 006c
  Ax 0003151a 00031518 0000ff64 0000001e 00037ffe 00f85f70 0000ff64 0000fea4
  Dx 00000000 00000001 00000800 0000a4b7 00000120 00002104 00000019 00000800

  210400f8 47ea0068 00000020 00000000 00000040 00000800 00000008 00037ffe
  00f84920 00000020 00000040 00f829f4 00000020 00000000 00100064 710010ff
  81000480 08a86811 018745a1 200e878b 0000ffcc 00000168 00037ffe 0000ff50
  00002000 00037ffe 00000000 00f85f71 00000800 00006181 00000000 00f85224
Forcing cmdline...
CMD>
```

Same with cold reboot and warm reboot. Most times the "Unknown interrupt" line is not there. If it's there it seems to be always interrupt 326.

This is with the TF4060 installed (I can try without the card later but I just assembled it just now... :)

cdhooper, 2025-08-24:
The interrupt #326 may be a bug in my code. Motorola only defines exception vectors up to 255. What I see on the top of the stack (2104 00f847ea 0068) suggests there is another interrupt which had just fired. The 0068 corresponds to interrupt 26, which is INT2, the Amiga Ports interrupt (CIA-A, Zorro, onboard SCSI). That is probably not the cause of the unknown interrupt you are seeing.

Whatever interrupt is occurring, the "Stuck?" comes from the VBlank interrupt handler. It doesn't see that the non-interrupt code is making progress, so it triggered the dump that you see following the "Stuck?" My guess is that whatever interrupt fired the interrupt 326 is reoccurring rapidly, and is blocking normal code progress.

cdhooper, 2025-08-25:
If you can get the problem to happen again (with at least the SP text showing 0000ffcc), I'd like to try to interpret a complete stack dump, which you can acquire by typing the following at the CMD> prompt:

d fe00 200

dlundqvist, 2025-08-26:
Of course, let's continue on email.

Closed 2025-08-24.

Thread 28 (2025-08-14):

A1200 smash utility tests

Falcon3011, 2025-08-14:
Hello Chris,

My previous issue with Q2, Q3 has ben resolved by replacing with 2N7002.
Now i have very interesting stuffs. With linux hostsmash i wrote more ROMs and with AmigaOS smash utility this wasn't possible in some cases.
I tried more Turbos. I know, that you wrote "DO NOT USE WITH CPU ACCELERATOR" , but why don't try it to test, and i wanted show also others users my experiences :)
Sorry for some photos, maybe i was already tired and camera was too heavy :) .

A1200 alone, i have issue
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

A1200 with B1230
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

A1200 with ACA1221EC
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

A1200 with M-TEC1230
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

A1200 with B1260
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

A1200 with TF1260, i can confirm, that really doesn't work
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

A1200 with Trinity1260, only with this card it seems, that everythings is working. Also i wrote diagroms to flash chip using smash utility.
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

I understand, that A1200 with some Turbo can be problem, but can you me tell, whats can be wrong , if A1200 is without Accelerator, or whats means these failes ?

Thank you very much for this briliant project.

Gabriel aka Falcon_11
