cdhooper/kicksmash32/smasher_rev2/Schematic_Amiga-Kicksmash-tester_2026-09-29.pdf

VDD_1 50 PB12 51 PB13 52 PB14 53 PB15 54 PD8 55 PD9 56 PD10 57 PD11 58 PD12 59 PD13 60 PD14 61 PD15 62 PC6 63 PC7 64 PC8 65 PC9 66 PA8 67 PA9 68 PA10 69 PA11 70 PA12 71 PA13 72 NC73 VSS_2 74 VDD_2 75 PA14 76 PA15 77 PC10 78 PC11 79 PC12 80 PD0 81 PD1 82 PD2 83 PD3 84 PD4 85 PD5 86 PD6 87 PD7 88 PB3 89 PB4 90 PB5 91 PB6 92 PB7 93 BOOT0 94 PB8 95 PB9 96 PE097 PE198 VSS_3 99 VDD_3 100

# Type-C

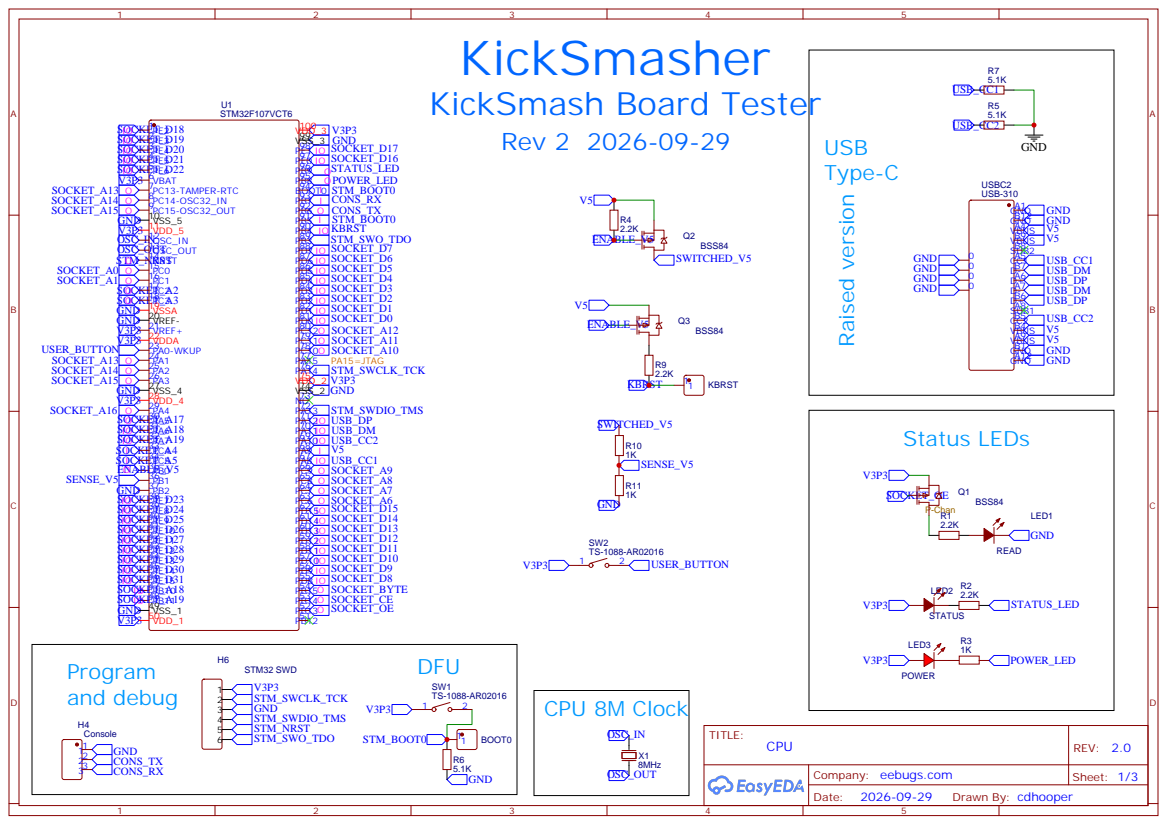
[picture p79: page 1]

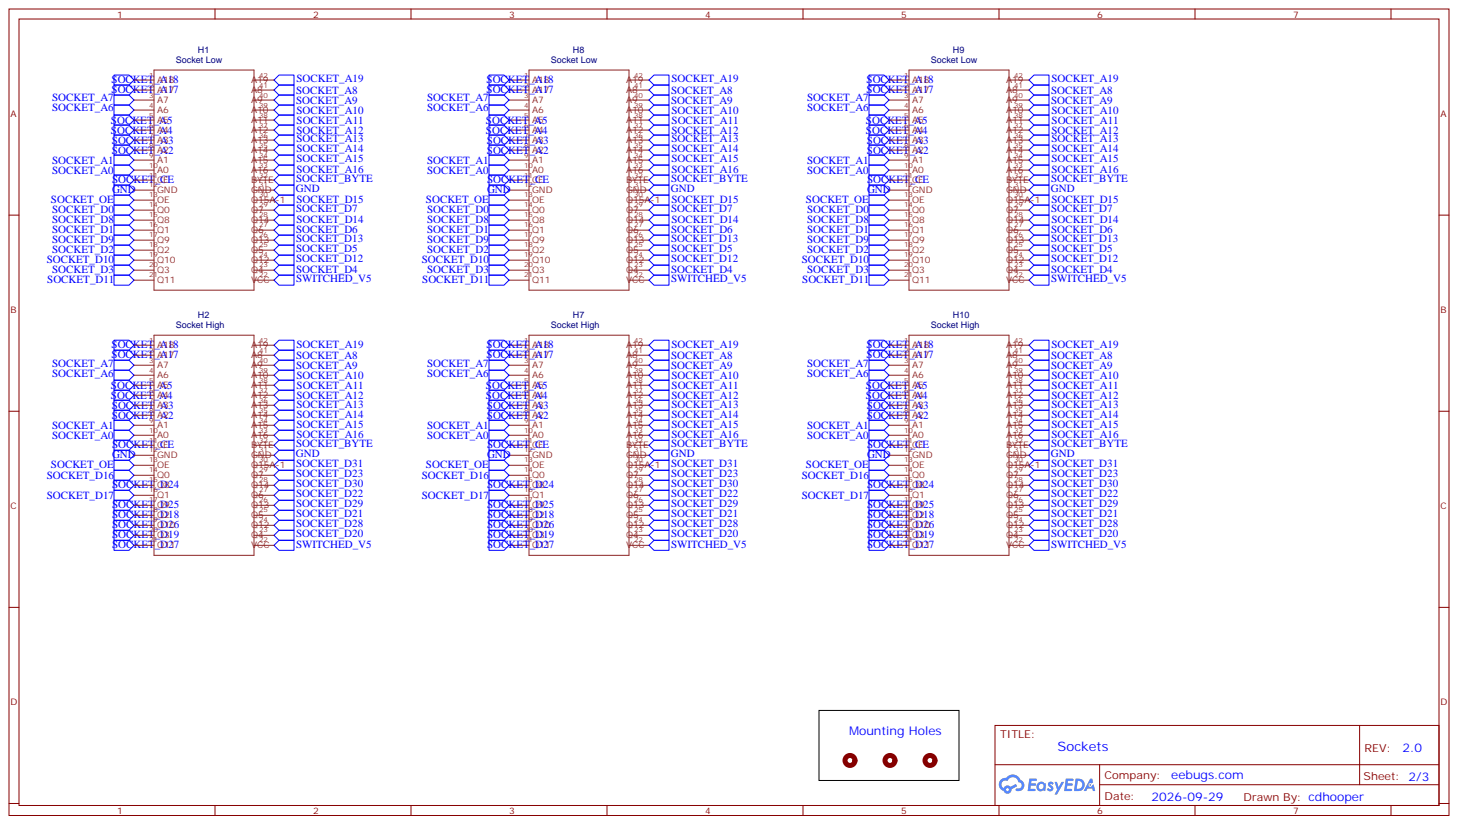
[picture p80: page 2]

OE# 20 A021 A122 A223 A324 A425 A526 A627 A728 A829 GND 30 A931 A10 32 A11 33 A12 34 A13 35 A14 36 A15 37 A16 38 A17 39 VCC 40

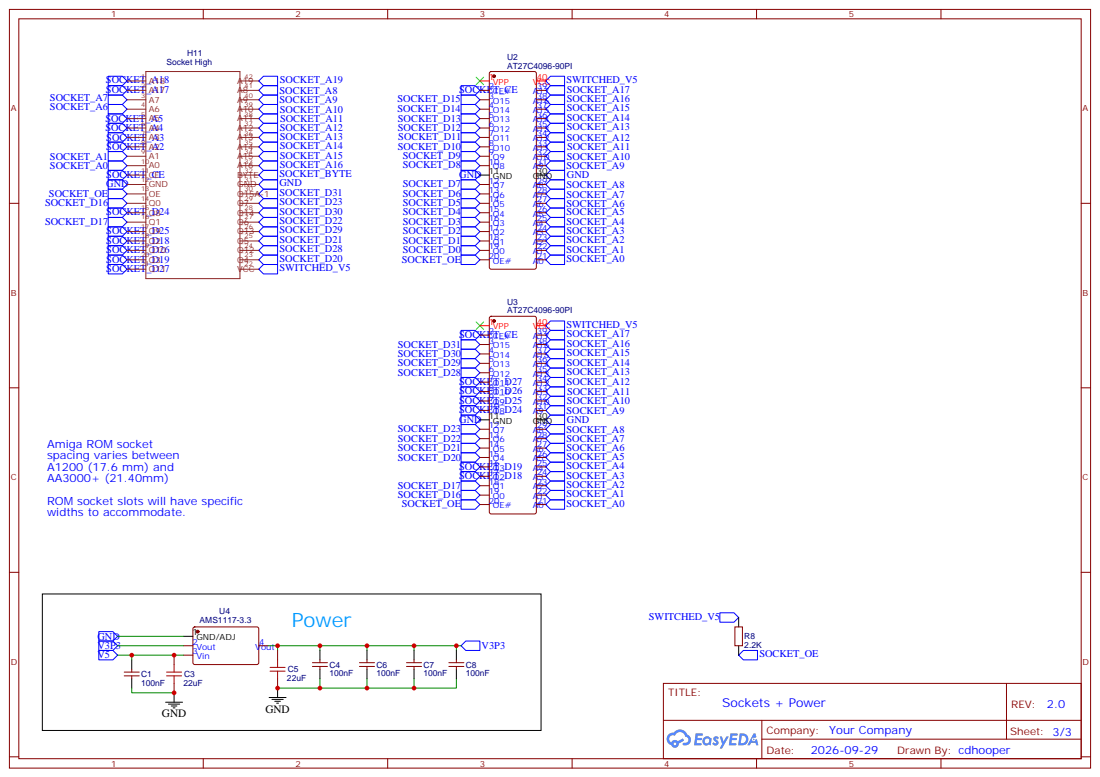
[picture p81: page 3]

Amiga ROM socket
spacing varies between
A1200 (17.6 mm) and
ROM socket slots will have specific
widths to accommodate.
