cdhooper/kicksmash32/32_rev10/Schematic_Amiga-KickSmash-32-in-system-flash_2026-06-29.pdf

# Amiga KickSmash 32 - In-system smart flash EEPROM

VDD_1 50 PB12 51 PB13 52 PB14 53 PB15 54 PD8 55 PD9 56 PD10 57 PD11 58 PD12 59 PD13 60 PD14 61 PD15 62 PC6 63 PC7 64 PC8 65 PC9 66 PA8 67 PA9 68 PA10 69 PA11 70 PA12 71 PA13 72 NC73 VSS_2 74 VDD_2 75 PA14 76 PA15 77 PC10 78 PC11 79 PC12 80 PD0 81 PD1 82 PD2 83 PD3 84 PD4 85 PD5 86 PD6 87 PD7 88 PB3 89 PB4 90 PB5 91 PB6 92 PB7 93 BOOT0 94 PB8 95 PB9 96 PE097 PE198 VSS_3 99 VDD_3 100

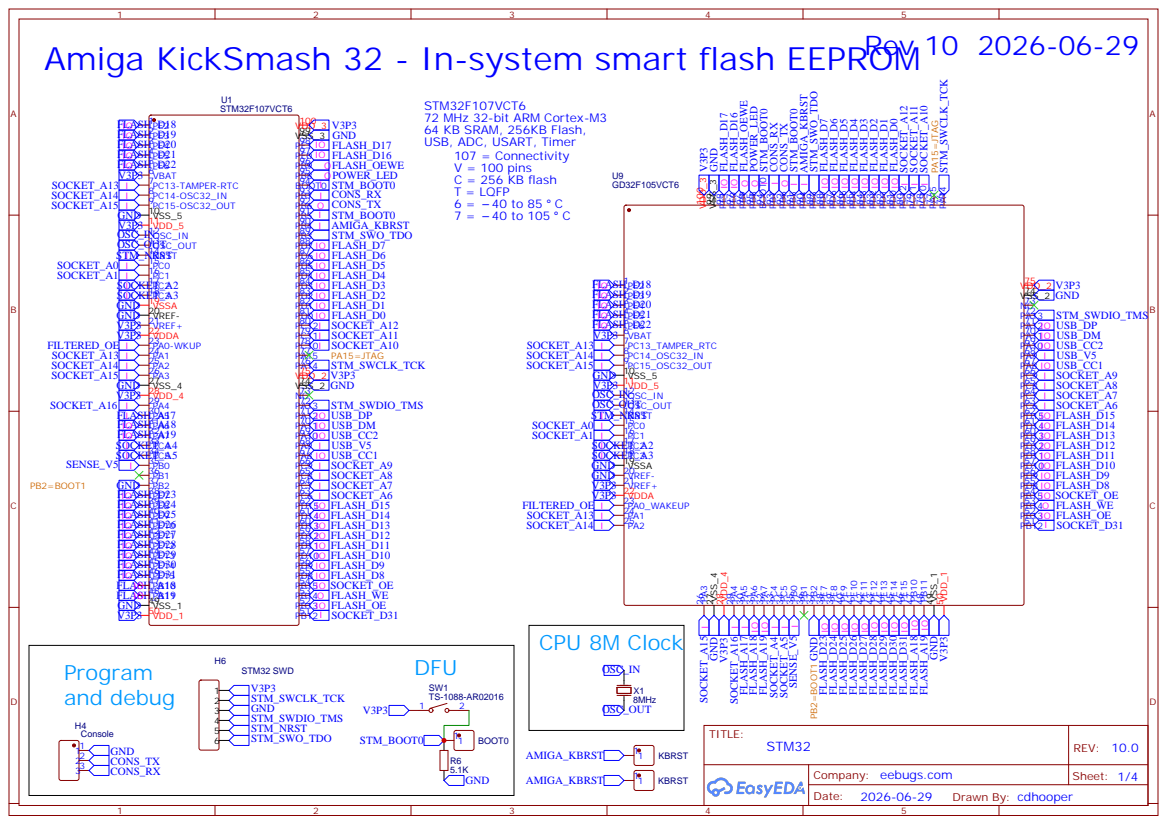
[picture p82: page 1]

STM32F107VCT6
72 MHz 32-bit ARM Cortex-M3
64 KB SRAM, 256KB Flash,
USB, ADC, USART, Timer
107 = Connectivity
V = 100 pins
C = 256 KB flash

## A7 18A6 19A5 20A4 21A3 22A2 23A1 24A0 25

# Input Power

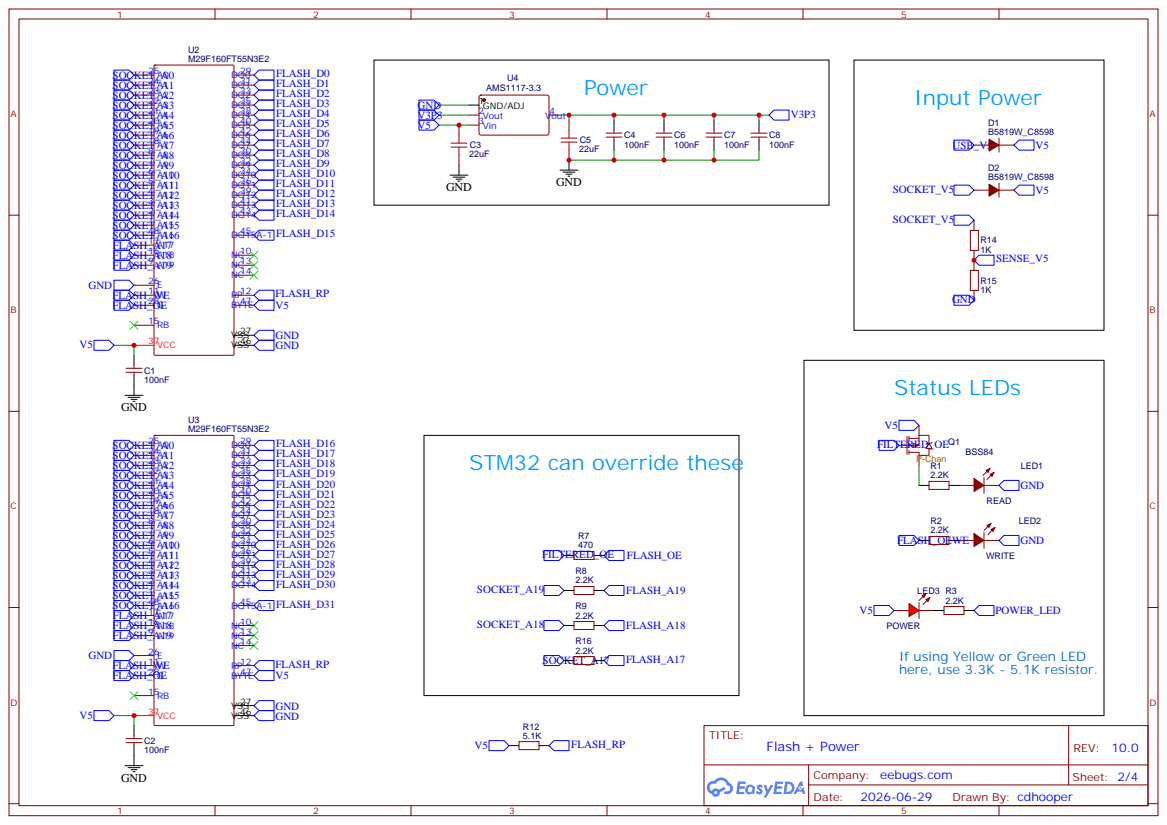
[picture p83: page 2]

POWER
If using Yellow or Green LED
here, use 3.3K - 5.1K resistor.

4OE# 24 3OE# 25 4A4 26 4A3 27 GND 28 4A2 29 4A1 30 VCC 31 3A4 32 3A3 33 GND 34 3A2 35 3A1 36 2A4 37 2A3 38 GND 39 2A2 40 2A1 41 VCC 42 1A4 43 1A3 44 GND 45 1A2 46 1A1 47 2OE# 48

# Bus drivers are used to decouple STM32 putting response and

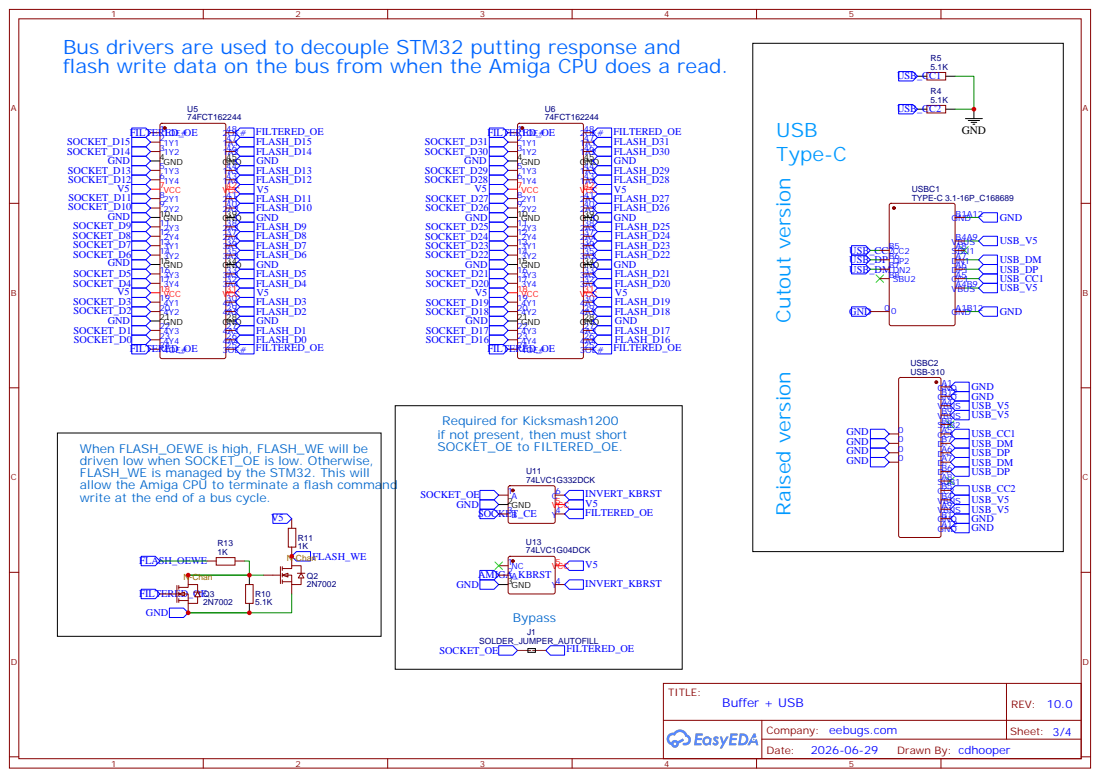
[picture p84: page 3]

flash write data on the bus from when the Amiga CPU does a read.

Raised version Cutout version

Required for Kicksmash1200
if not present, then must short
SOCKET_OE to FILTERED_OE.

When FLASH_OEWE is high, FLASH_WE will be
driven low when SOCKET_OE is low. Otherwise,
FLASH_WE is managed by the STM32. This will
allow the Amiga CPU to terminate a flash command
write at the end of a bus cycle.

# A3000/A4000/4KT/AA3K

# A3000 U182/U183

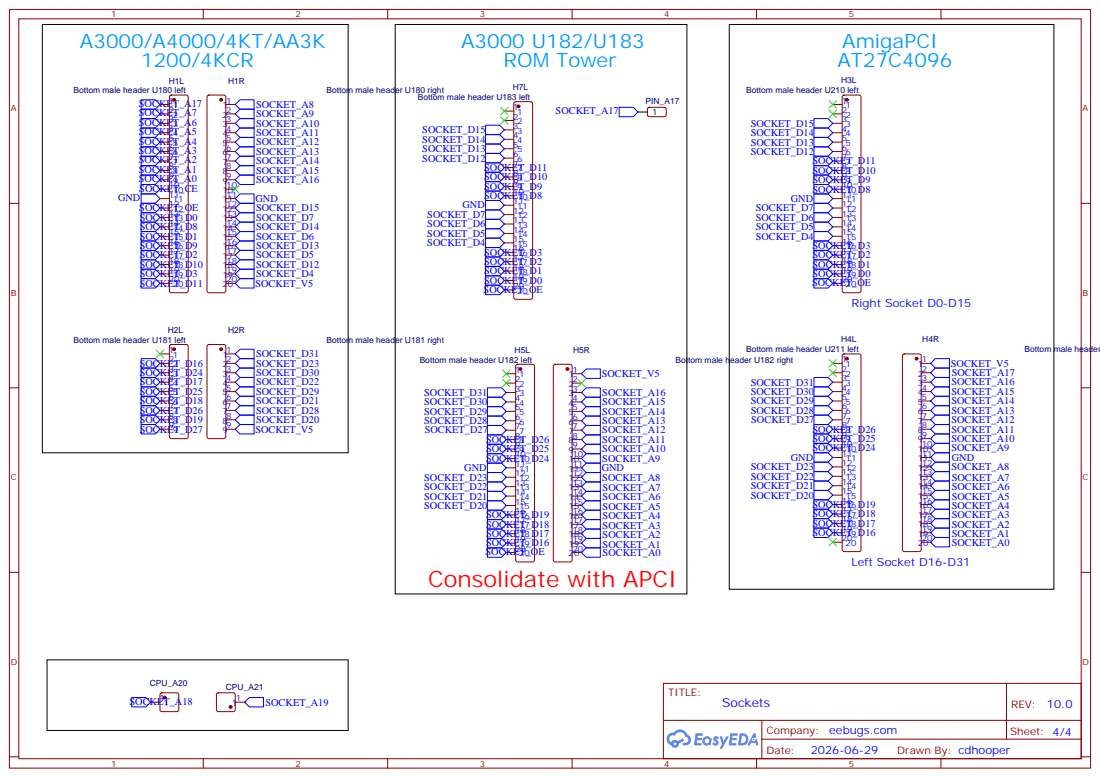
[picture p85: page 4]

Bottom male header U180 left

Bottom male header U180 right

Bottom male header U210 left

Bottom male header U183 left

Bottom male header U181 left

Bottom male header U181 right

Bottom male header U211 left

Bottom male header U211 right

Bottom male header U182 left

Bottom male header U182 right
