cdhooper/kicksmash32/smasher_rev2/PCB_Amiga-Kicksmash-tester-Rev-2_2026-09-29_bottom.pdf

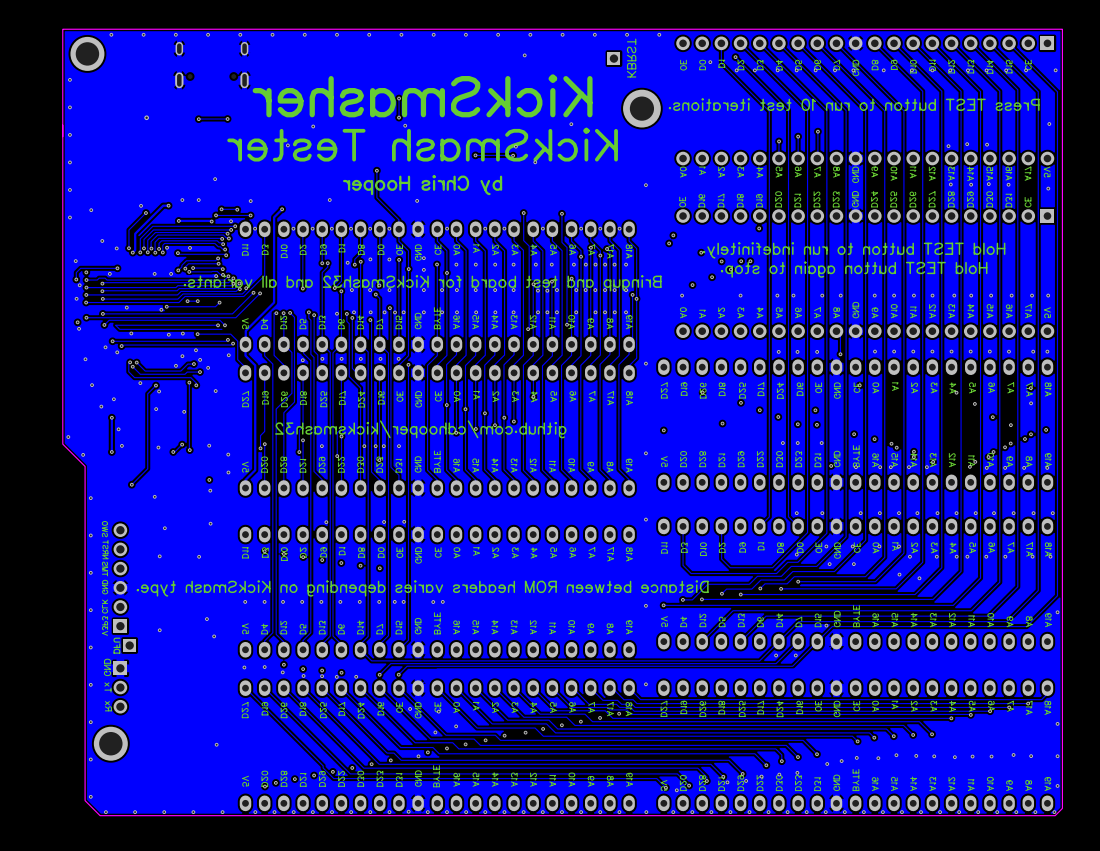
[picture p106: page 1]
