cdhooper/kicksmash32/smasher_rev2/PCB_Amiga-Kicksmash-tester-Rev-2_2026-09-29_bottom_mirror.pdf

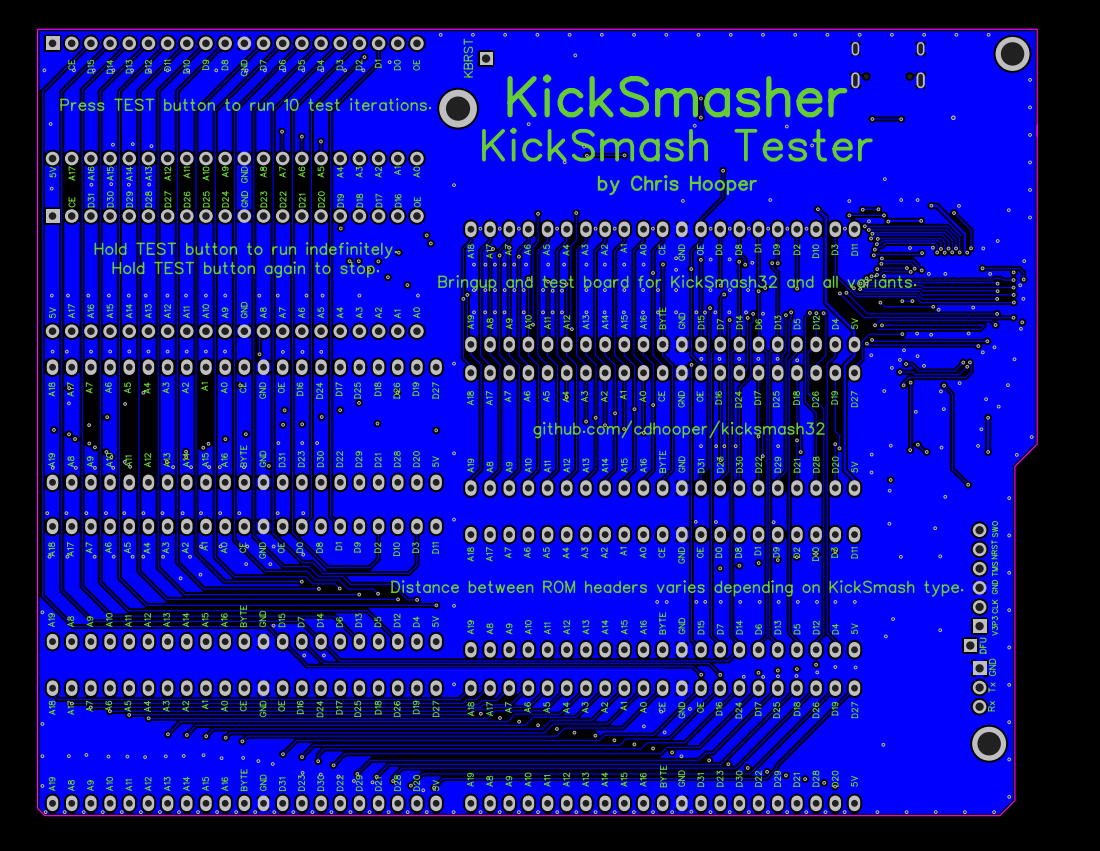
[picture p107: page 1]
