cdhooper/kicksmash32/smasher_rev2/PCB_Amiga-Kicksmash-tester-Rev-2_2026-09-29_top.pdf

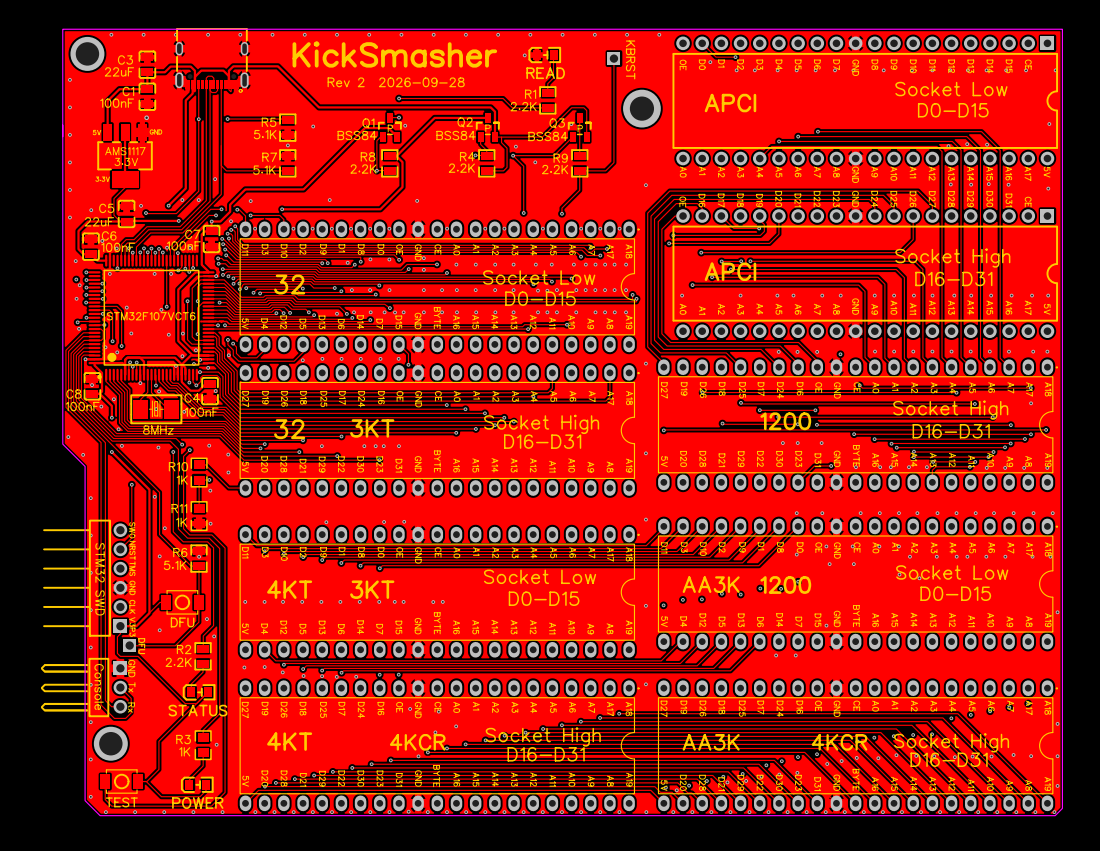
[picture p108: page 1]
