cdhooper/kicksmash32/1200_rev10.1/PCB_1200_10.1_2026-10-06_bottom.pdf

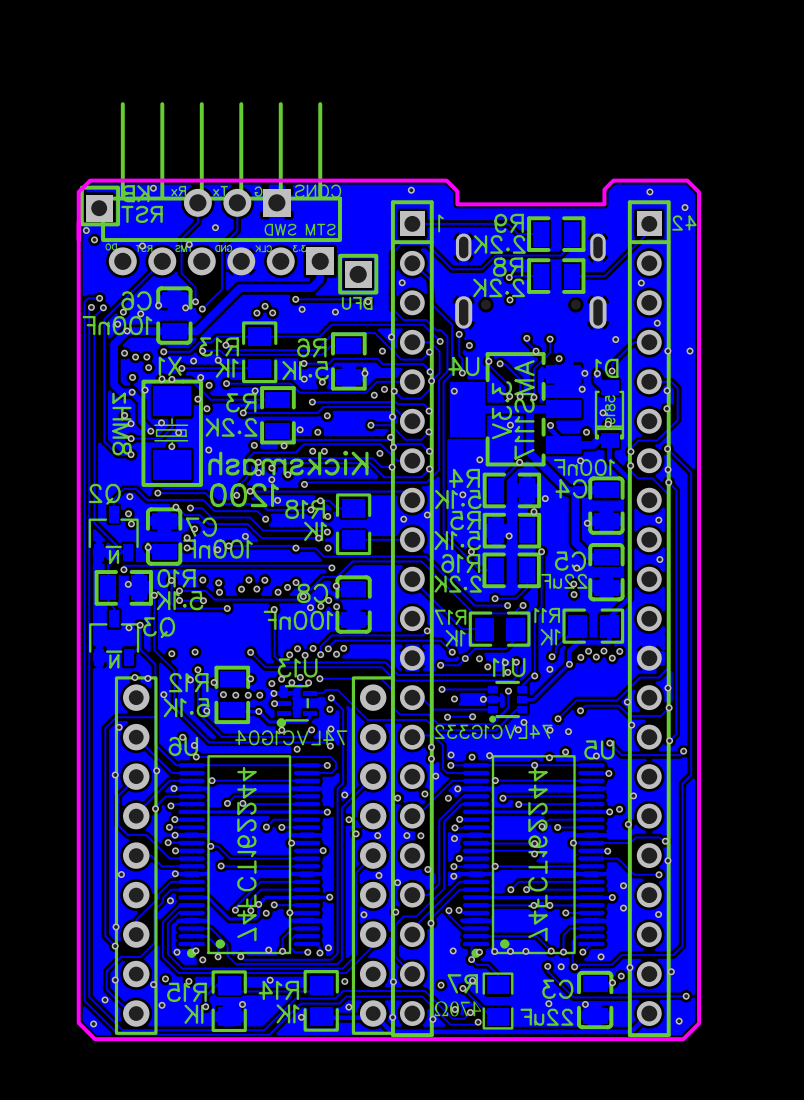
[picture p109: page 1]
