cdhooper/kicksmash32/32_rev10/PCB_Amiga_Kicksmash_32_10_2026-06-29_bottom.pdf

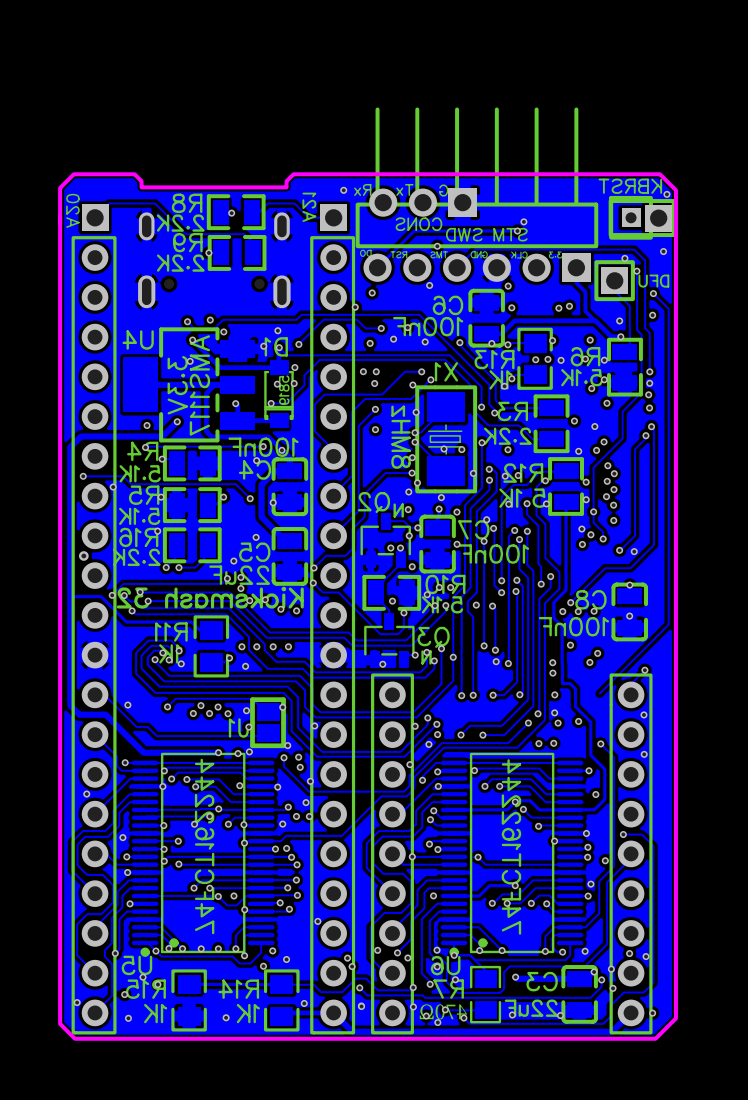
[picture p112: page 1]
