cdhooper/kicksmash32/4kcr_rev9/PCB_top_Amiga_Kicksmash_4KCR_2026-03-15.pdf

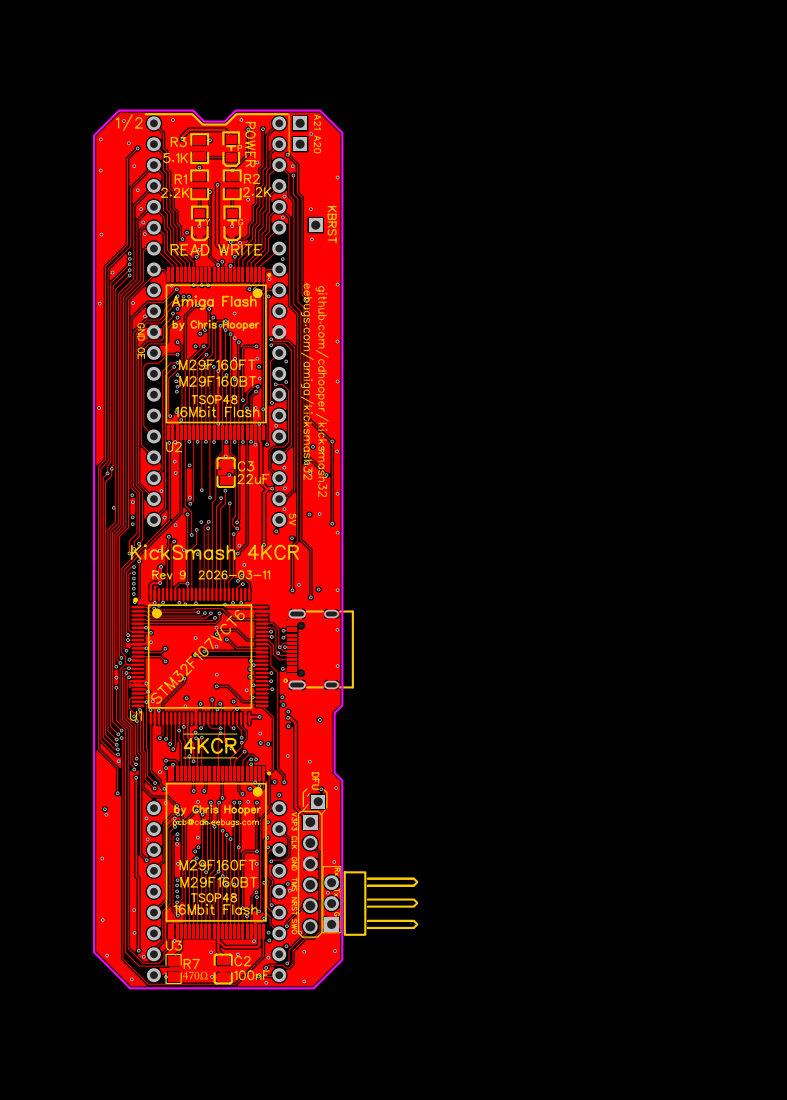
[picture p116: page 1]
