cdhooper/kicksmash32/apci_rev8/PCB_bot_Amiga_Kicksmash_APCI_2025-07-24.pdf

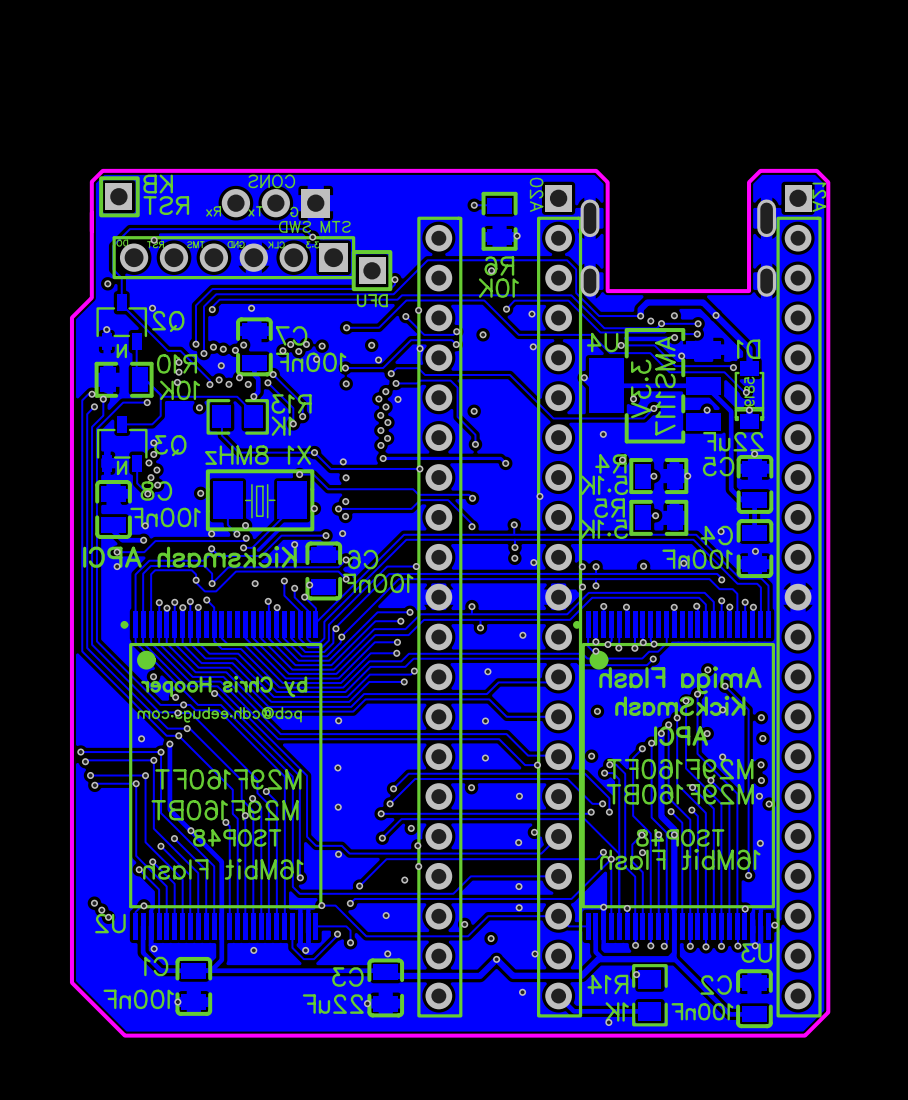
[picture p117: page 1]
