cdhooper/kicksmash32/apci_rev8/PCB_bot_Amiga_Kicksmash_APCI_2025-07-24_mirror.pdf

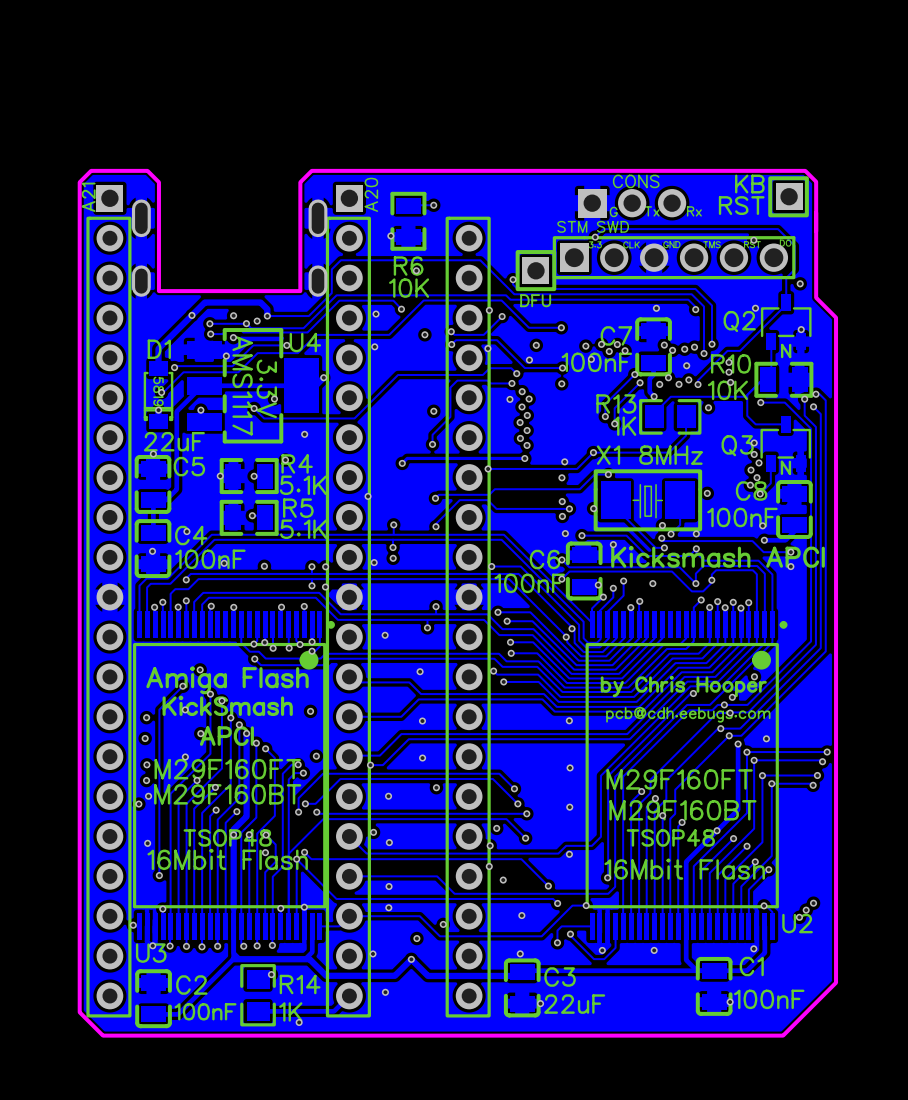
[picture p118: page 1]
