cdhooper/kicksmash32/apci_rev8/PCB_top_Amiga_Kicksmash_APCI_2025-07-24.pdf

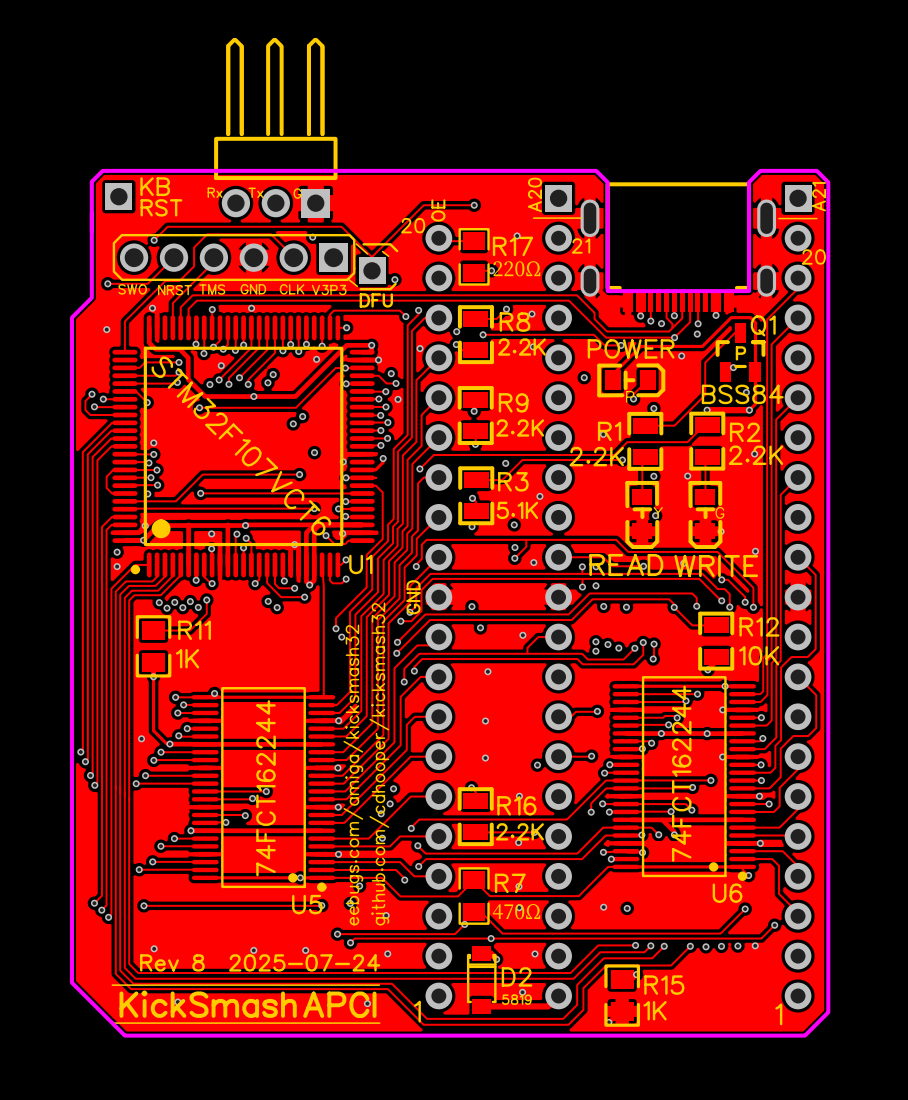
[picture p119: page 1]
