cdhooper/kicksmash32/3kt_rev7/PCB_bottom_Amiga_Kicksmash_3KT_2025-03-13_mirror.pdf

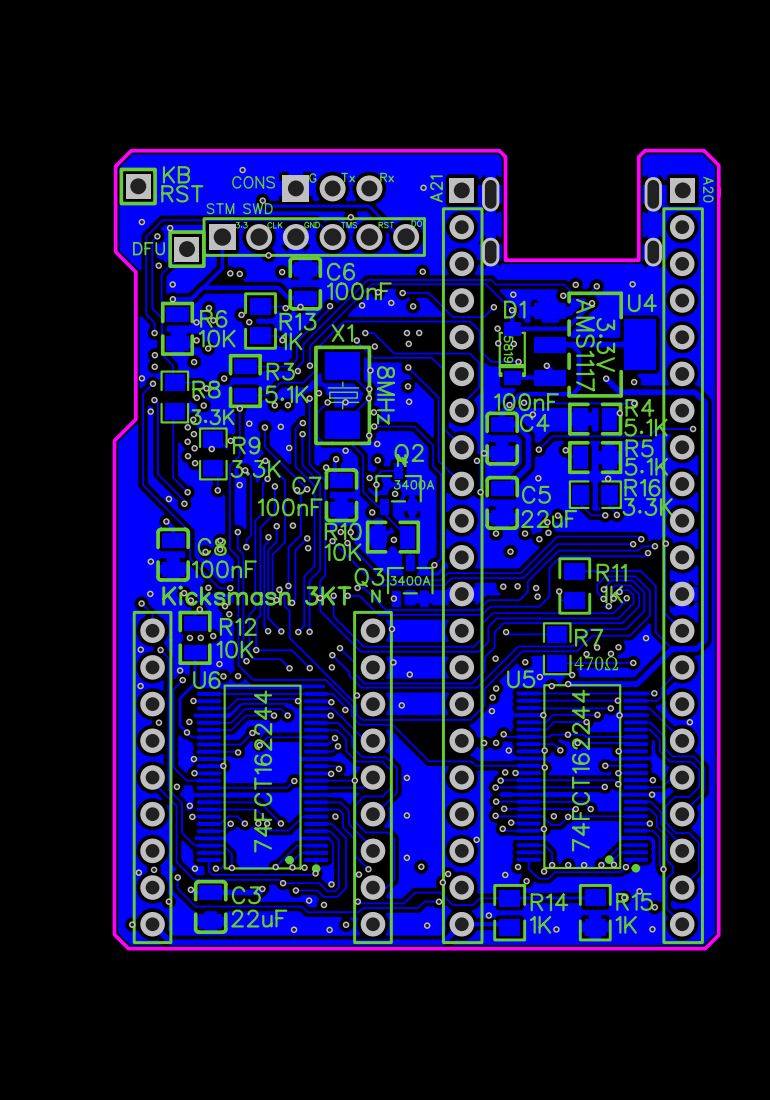
[picture p121: page 1]
