cdhooper/kicksmash32/3kt_rev7/PCB_top_Amiga_Kicksmash_3KT_2025-03-13.pdf

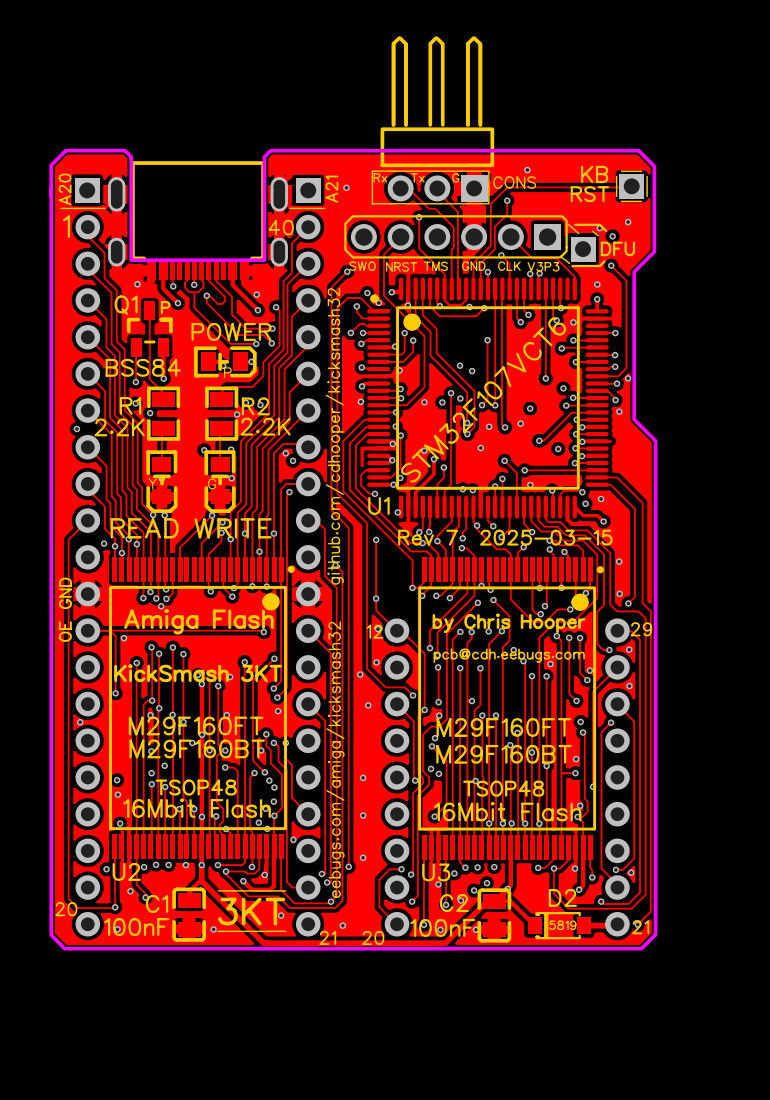
[picture p122: page 1]
