cdhooper/kicksmash32/rev7_1200/PCB_bottom_Amiga_Kicksmash1200_2025-03-13.pdf

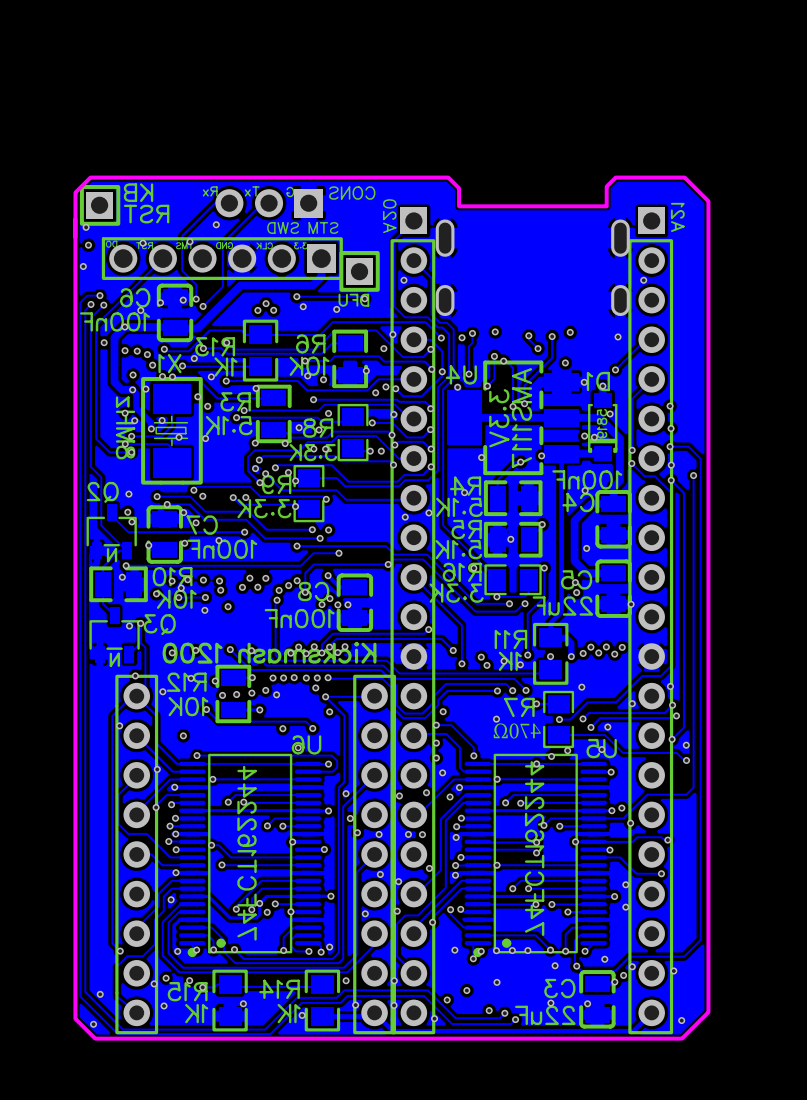
[picture p123: page 1]
