cdhooper/kicksmash32/rev7_1200/PCB_bottom_Amiga_Kicksmash1200_2025-03-12_mirror.pdf

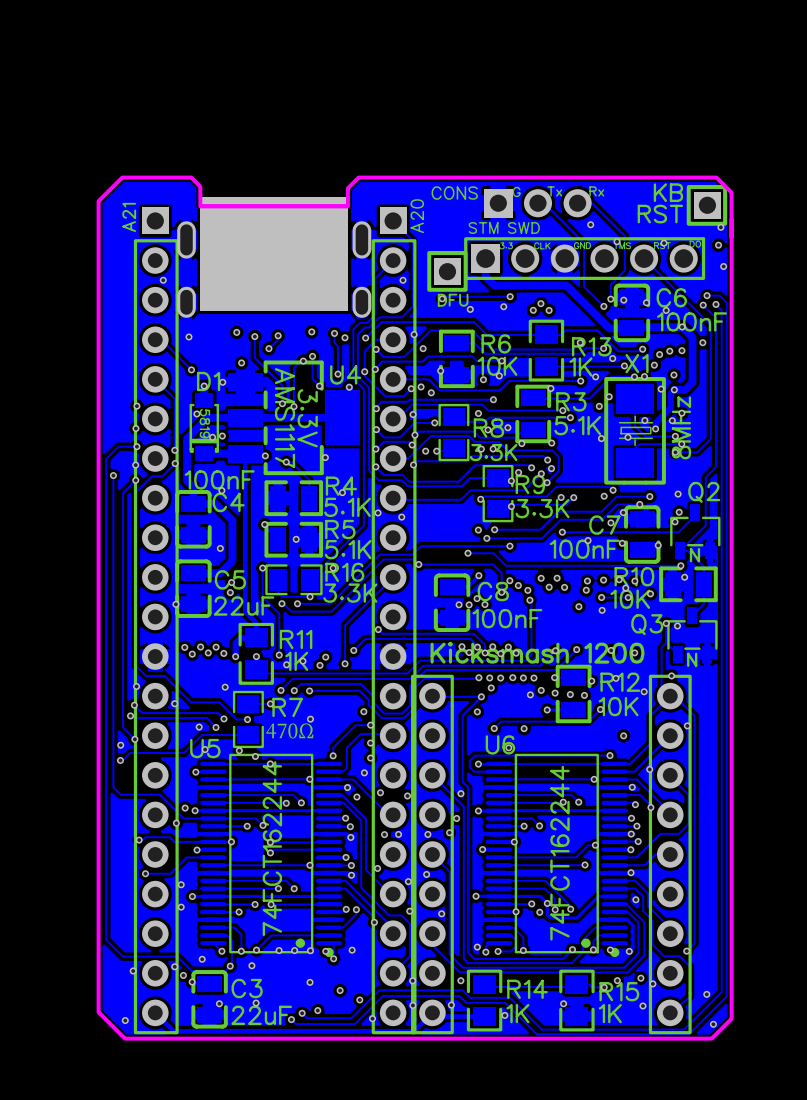
[picture p127: page 1]
