cdhooper/kicksmash32/rev7_1200/PCB_top_Amiga_Kicksmash1200_2025-03-12.pdf

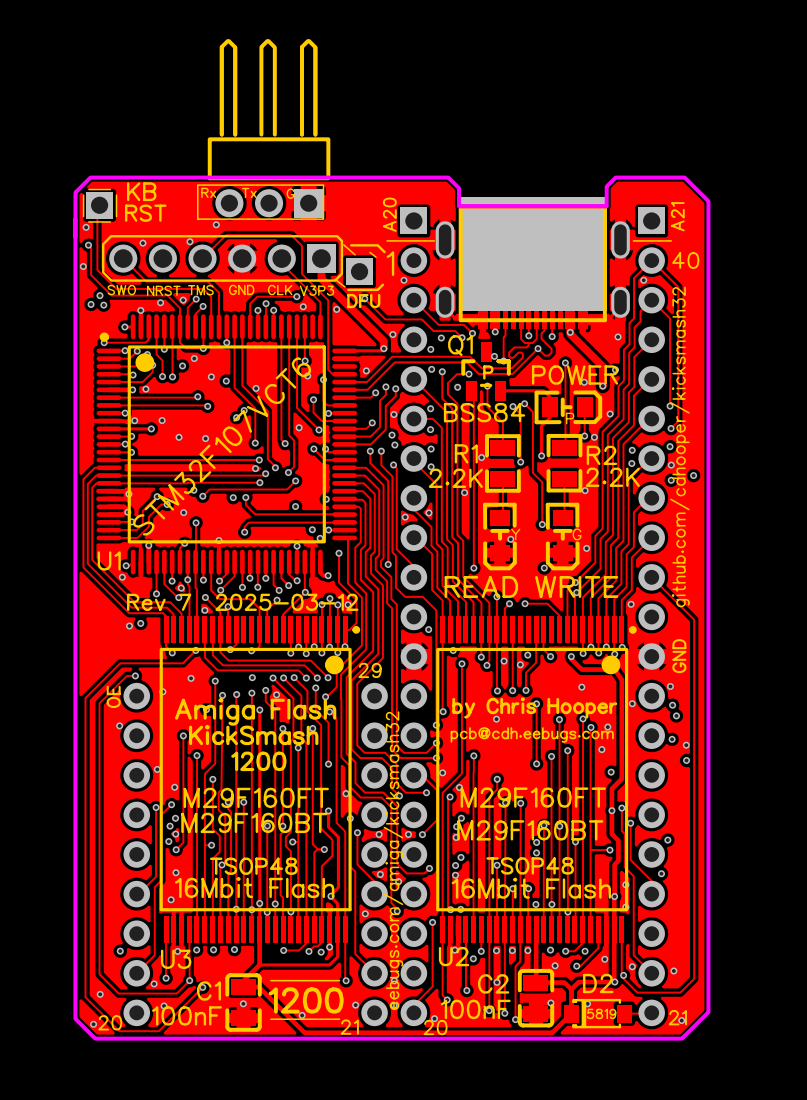
[picture p128: page 1]
