cdhooper/kicksmash32/(list of files, drawings)

Other design files:
3kt_rev7/PCB_PCB_Amiga_Kicksmash_3KT_2025-03-13.json
3kt_rev7/SCH_Amiga-KickSmash-32-in-system-flash_2025-03-13.json
4kcr_rev9/SCH_Amiga-KickSmash-32-in-system-flash_2026-03-15.json
4kt_rev6/PCB_PCB_Amiga_Kicksmash_4KT_2024-11-22.json
4kt_rev6/SCH_Amiga-KickSmash-32-in-system-flash_2024-11-22.json
32_rev10/PCB_PCB_Amiga_Kicksmash_32_10_2026-06-29.json
32_rev10/SCH_Amiga-KickSmash-32-in-system-flash_2026-06-29.json
1200_rev10.1/PCB_PCB_1200_10.1_2026-10-06.json
1200_rev10.1/SCH_Amiga-KickSmash-32-in-system-flash_2026-10-06.json
apci_rev8/PCB_PCB_Amiga_Kicksmash_APCI_2025-07-24.json
smasher_rev2/PCB_PCB_Amiga-Kicksmash-tester-Rev-2_2026-09-29.json
