cdhooper/kicksmash32/amiga/smash.c

/*
 * smash
 * -----
 * Utility to perform various operations with Kicksmash installed in
 * an Amiga.
 *
 * Copyright 2024 Chris Hooper. This program and source may be used
 * and distributed freely, for any purpose which benefits the Amiga
 * community. Commercial use of the binary, source, or algorithms requires
 * prior written approval from Chris Hooper <amiga@cdh.eebugs.com>.
 * All redistributions must retain this Copyright notice.
 *
 * DISCLAIMER: THE SOFTWARE IS PROVIDED "AS-IS", WITHOUT ANY WARRANTY.
 * THE AUTHOR ASSUMES NO LIABILITY FOR ANY DAMAGE ARISING OUT OF THE USE
 * OR MISUSE OF THIS UTILITY OR INFORMATION REPORTED BY THIS UTILITY.
 */
const char *version = "\0$VER: smash "VERSION" ("BUILD_DATE") \xA9 Chris Hooper";

#include <stdio.h>
#include <stdlib.h>
#include <ctype.h>
#include <string.h>
#include <clib/dos_protos.h>
#include <time.h>
#include <exec/execbase.h>
#include <exec/memory.h>
#include "smash_cmd.h"
#include "host_cmd.h"
#include "sm_msg.h"
#include "cpu_control.h"
#include "smash.h"
#include "smash_flash.h"

#ifdef _DCC
typedef unsigned char  uint8_t;
typedef unsigned short uint16_t;
typedef unsigned long  uint32_t;
typedef struct { unsigned long hi; unsigned long lo; } uint64_t;
#define __packed
#else
struct DosLibrary *DOSBase;
struct Device     *TimerBase;
static struct timerequest TimeRequest;
#endif

/*
 * ULONG has changed from NDK 3.9 to NDK 3.2.
 * However, PRI*32 did not. What is the right way to implement this?
 */
#if INCLUDE_VERSION < 47
#undef PRIu32
#define PRIu32 "lu"
#undef PRId32
#define PRId32 "ld"
#undef PRIx32
#define PRIx32 "lx"
#endif

#define BIT(x) (1U << (x))
#define ARRAY_SIZE(x) ((sizeof (x) / sizeof ((x)[0])))

#define AMIGA_PPORT_DIR  0x00bfe301  /* Amiga parallel port dir register */
#define AMIGA_PPORT_DATA 0x00bfe101  /* Amiga parallel port data reg. */

#define CIAA_TBLO        VADDR8(0x00bfe601)
#define CIAA_TBHI        VADDR8(0x00bfe701)


#define TEST_LOOPBACK_BUF 4096
#define TEST_LOOPBACK_MAX 64
#define MEM_LOOPS         4000000

static const char cmd_options[] =
    "usage: smash <options>\n"
    "   bank <opt>    ROM bank operations (-b ?, show, ...)\n"
    "   clock <opt>   save / restore Amiga clock with KS (-c)\n"
    "   debug         show debug output (-d)\n"
    "   debugq        show smashmsg semaphore and reply queue (-Q)\n"
    "   erase <opt>   erase flash (-e ?, bank, ...)\n"
    "   fwread <file> read Kicksmash firmware to file (-R)\n"
    "   fwverify <file> verify Kicksmash firmware matches file (-V)\n"
    "   fwwrite <file> write Kicksmash firmware from file (-W)\n"
    "   identify      identify Kicksmash and Flash parts (-i[ii])\n"
    "   read <opt>    read from flash (-r ?, bank, file, ...)\n"
    "   verify <opt>  verify flash matches file (-v ?, bank, file, ...)\n"
    "   write <opt>   write to flash (-w ?, bank, file, ...)\n"
    "   loop <num>    repeat the command a specified number of times (-l)\n"
    "   quiet         minimize test output\n"
    "   set <n> <v>   set KickSmash value <n>=\"name\" and string <v> (-s)\n"
    "   sr <addr>     spin loop reading address (-X)\n"
    "   srr <addr>    spin loop reading address with ROM OVL set (-Y)\n"
    "   term          open Kicksmash firmware terminal [-T]\n"
    "   test[0123456] do interface test (-t)\n";

static const char cmd_bank_options[] =
    "  show                       Display all ROM bank information (-s)\n"
    "  merge <start> <end>        Merge banks for larger ROMs (-m)\n"
    "  unmerge <start> <end>      Unmerge banks (-u)\n"
    "  name <bank> <text>         Set bank name / description (-n)\n"
    "  longreset <bank> [<bank>]  Banks to sequence at long reset (-l)\n"
    "  poweron <bank> [reboot]    Default bank at poweron (-p)\n"
    "  current <bank> [reboot]    Force new bank immediately (-c)\n"
    "  nextreset <bank> [reboot]  Force new bank at next reset (-N)\n";

static const char cmd_clock_options[] =
    "   load         load Amiga time from KS clock (-l)\n"
    "   loadu        load Amiga time from USB host clock (-u)\n"
    "   loadifset    load Amiga time from KS clock if it is known (-k)\n"
    "   save         save Amiga time to KS clock (-s)\n"
    "   saveifnotset save Amiga time to KS clock if not already saved (-n)\n"
    "   show         show current KS clock (-S)\n"
    "   showu        show current USB host clock (-U)\n";

long_to_short_t long_to_short_main[] = {
    { "-b", "bank" },
    { "-c", "clock" },
    { "-C", "cons" },
    { "-C", "conservative" },
    { "-d", "debug" },
    { "-e", "erase" },
    { "-R", "fwread" },
    { "-V", "fwverify" },
    { "-W", "fwupdate" },
    { "-W", "fwwrite" },
    { "-i", "inquiry" },
    { "-i", "identify" },
    { "-i", "id" },
    { "-l", "loop" },
    { "-q", "quiet" },
    { "-Q", "debugq" },
    { "-r", "read" },
    { "-s", "set" },
    { "-S", "spin" },
    { "-t", "test" },
    { "-T", "term" },
    { "-v", "verify" },
    { "-w", "write" },
    { "-X", "sr" },   // spinread
    { "-Y", "srr" },  // spinreadrom
};

long_to_short_t long_to_short_bank[] = {
    { "-c", "current" },
    { "-h", "?" },
    { "-h", "help" },
    { "-l", "longreset" },
    { "-m", "merge" },
    { "-n", "name" },
    { "-N", "nextreset" },
    { "-p", "poweron" },
    { "-s", "show" },
    { "-u", "unmerge" },
};

long_to_short_t long_to_short_clock[] = {
    { "-h", "?" },
    { "-h", "help" },
    { "-k", "loadifset" },
    { "-l", "load" },
    { "-u", "loadu" },
    { "-s", "save" },
    { "-n", "saveifnotset" },
    { "-S", "show" },
    { "-U", "showu" },
};

BOOL __check_abort_enabled = 0;       // Disable gcc clib2 ^C break handling
uint flag_debug = 0;
uint8_t flag_conservative_mode = 0;
static uint8_t flag_quiet = 0;
uint8_t flag_yes = 0;
static uint8_t *test_loopback_buf = NULL;


/*
 * is_user_abort
 * -------------
 * Check for user break input (^C)
 */
BOOL
is_user_abort(void)
{
    if (SetSignal(0, 0) & SIGBREAKF_CTRL_C) {
        static uint8_t printed = 0;
        if (printed++ == 0)
            printf("^C Abort\n");
        return (1);
    }
    return (0);
}

static void
usage(void)
{
    printf("%s\n\n%s", version + 7, cmd_options);
}

char *
ull_to_str(unsigned long long val, char *buf, int bufsize)
{
    char *ptr = buf + bufsize;

    if (ptr == buf)
        return (NULL);  // no space
    *(--ptr) = '\0';

    if (val == 0) {
        if (ptr == buf)
            return (NULL);  // no space
        *(--ptr) = '0';
        return (ptr);
    }

    while (val != 0) {
        if (ptr == buf)
            return (NULL);  // overflow
        *(--ptr) = (val % 10) + '0';
        val /= 10;

    }
    return (ptr);
}

const char *
long_to_short(const char *ptr, long_to_short_t *ltos, uint ltos_count)
{
    uint cur;

    for (cur = 0; cur < ltos_count; cur++)
        if (strcmp(ptr, ltos[cur].long_name) == 0)
            return (ltos[cur].short_name);
    return (ptr);
}

static uint
cia_ticks(void)
{
    uint8_t hi1;
    uint8_t hi2;
    uint8_t lo;

    hi1 = *CIAA_TBHI;
    lo  = *CIAA_TBLO;
    hi2 = *CIAA_TBHI;

    /*
     * The below operation will provide the same effect as:
     *     if (hi2 != hi1)
     *         lo = 0xff;  // rollover occurred
     */
    lo |= (hi2 - hi1);  // rollover of hi forces lo to 0xff value

    return (lo | (hi2 << 8));
}

/*
 * rand32
 * ------
 * Very simple pseudo-random number generator
 */
static uint32_t rand_seed = 0;
static uint32_t
rand32(void)
{
    rand_seed = (rand_seed * 25173) + 13849;
    return (rand_seed);
}

/*
 * srand32
 * -------
 * Very simple random number seed
 */
static void
srand32(uint32_t seed)
{
    rand_seed = seed;
}

void
print_us_diff(uint64_t start, uint64_t end)
{
    uint64_t diff = end - start;
    uint32_t diff2;
    char *scale = "ms";

    if ((diff >> 32) != 0)  // Finished before started?
        diff = 0;
    if (diff >= 100000) {
        diff /= 1000;
        scale = "sec";
    }
    diff2 = diff / 10;
    printf("%u.%02u %s\n", diff2 / 100, diff2 % 100, scale);
}

static void
show_test_state(const char * const name, int state)
{
    if (state == 0) {
        if (!flag_quiet)
            printf("PASS\n");
        return;
    }

    if (!flag_quiet || (state != -1))
        printf("  %-15s ", name);

    if (state == -1) {
        fflush(stdout);
        return;
    }
    printf("FAIL\n");
}

typedef struct {
    uint32_t ci_id;       // Vendor code
    char     ci_dev[16];  // ID string for display
} chip_ids_t;
static const chip_ids_t chip_ids[] = {
    { 0x000122D2, "M29F160FT" },   // AMD+others 2MB top boot
    { 0x000122D8, "M29F160FB" },   // AMD+others 2MB bottom boot
    { 0x000122D6, "M29F800FT" },   // AMD+others 1MB top boot
    { 0x00012258, "M29F800FB" },   // AMD+others 1MB bottom boot
    { 0x00012223, "M29F400FT" },   // AMD+others 512K top boot
    { 0x000122ab, "M29F400FB" },   // AMD+others 512K bottom boot
    { 0x000422d2, "M29F160TE" },   // Fujitsu 2MB top boot
    { 0x000422D8, "M29F160TB" },   // Fujitsu 2MB bottom boot
    { 0x00c222D6, "MX29F800CT" },  // Macronix 1MB top boot
    { 0x00c22258, "MX29F800CB" },  // Macronix 1MB bottom boot
    { 0x00c222c4, "MX29LV160CT" }, // Macronix 2MB top boot
    { 0x00c22249, "MX29LV160CB" }, // Macronix 2MB bottom boot
    { 0x002022cc, "M29F160BT" },   // ST-Micro 2MB top boot
    { 0x0020224b, "M29F160BB" },   // ST-Micro 2MB bottom boot
    { 0x002022c4, "M29W160ET" },   // ST-Micro 2MB top boot
    { 0x00202249, "M29W160EB" },   // ST-Micro 2MB bottom boot
    { 0x00000000, "Unknown" },     // Must remain last
};

static const chip_blocks_t chip_blocks[] = {
    { 0x22D2, 31, 32, 4, 0x71 },  // 01110001 8K 4K 4K 16K (top)
    { 0x22D8,  0, 32, 4, 0x1d },  // 00011101 16K 4K 4K 8K (bottom)
    { 0x22D6, 15, 32, 4, 0x71 },  // 01110001 8K 4K 4K 16K (top)
    { 0x2258,  0, 32, 4, 0x1d },  // 00011101 16K 4K 4K 8K (bottom)
    { 0x22CC, 31, 32, 4, 0x71 },  // 01110001 8K 4K 4K 16K (top)
    { 0x224B,  0, 32, 4, 0x1d },  // 00011101 16K 4K 4K 8K (bottom)
    { 0x22C4, 15, 32, 4, 0x71 },  // 01110001 8K 4K 4K 16K (top)
    { 0x2249,  0, 32, 4, 0x1d },  // 00011101 16K 4K 4K 8K (bottom)
    { 0x0000,  0, 32, 4, 0x1d },  // Default to bottom boot
};

const chip_blocks_t *
get_chip_block_info(uint32_t chipid)
{
    uint16_t cid = (uint16_t) chipid;
    uint pos;

    /* Search for exact match */
    for (pos = 0; pos < ARRAY_SIZE(chip_blocks) - 1; pos++)
        if (chip_blocks[pos].cb_chipid == cid)
            break;

    return (&chip_blocks[pos]);
}

const char *
ee_id_string(uint32_t id)
{
    uint pos;

    for (pos = 0; pos < ARRAY_SIZE(chip_ids) - 1; pos++)
        if (chip_ids[pos].ci_id == id)
            break;

    if (pos == ARRAY_SIZE(chip_ids) - 1) {
        uint16_t cid = id & 0xffff;
        for (pos = 0; pos < ARRAY_SIZE(chip_ids) - 1; pos++)
            if ((chip_ids[pos].ci_id & 0xffff) == cid)
                break;
    }
    return (chip_ids[pos].ci_dev);
}

static void __attribute__ ((noinline))
spin(uint loops)
{
    uint count;
    for (count = 0; count < loops; count++) {
        __asm__ __volatile__("nop");
    }
}

static void
spin_memory(uint32_t addr)
{
    uint     count;

    SUPERVISOR_STATE_ENTER();
    INTERRUPTS_DISABLE();
    CACHE_DISABLE_DATA();
    MMU_DISABLE();

#if 0
    CacheClearE((void *)addr, MEM_LOOPS * 4, CACRF_ClearD);
#endif

    for (count = 0; count < MEM_LOOPS; count += 4) {
        (void) *VADDR32(addr);
    }

    spin(MEM_LOOPS);

    CACHE_FLUSH();
    MMU_RESTORE();
    CACHE_RESTORE_STATE();
    INTERRUPTS_ENABLE();
    SUPERVISOR_STATE_EXIT();
    if (!flag_quiet)
        printf("done\n");
}

static void
spin_memory_ovl(uint32_t addr)
{
    uint     count;

    SUPERVISOR_STATE_ENTER();
    INTERRUPTS_DISABLE();
    CACHE_DISABLE_DATA();
    MMU_DISABLE();

    *CIAA_PRA |= CIAA_PRA_OVERLAY | CIAA_PRA_LED;
    for (count = 0; count < MEM_LOOPS; count++) {
        (void) *VADDR32(addr);
    }
    *CIAA_PRA &= ~(CIAA_PRA_OVERLAY | CIAA_PRA_LED);

    spin(MEM_LOOPS);

    CACHE_FLUSH();
    MMU_RESTORE();
    CACHE_RESTORE_STATE();
    INTERRUPTS_ENABLE();
    SUPERVISOR_STATE_EXIT();
    printf("done\n");
}

uint64_t
smash_time(void)
{
    uint64_t usecs;
    if (send_cmd(KS_CMD_UPTIME, NULL, 0, &usecs, sizeof (usecs), NULL))
        return (0);
    return (usecs);
}

static const char * const board_states[] = {
    "Alert", "Standalone", "Off", "In_Reset",
    "No_KBRST", "No_A17", "No_A18", "No_A19",
    "No_Flash0", "No_Flash1", "Bad_Flash",
};

static uint
smash_identify(void)
{
    uint64_t   usecs;
    uint       sec;
    uint       usec;
    smash_id_t id;
    uint       rlen;
    uint       rc;

    memset(&id, 0, sizeof (id));
    rc = send_cmd(KS_CMD_ID, NULL, 0, &id, sizeof (id), &rlen);

    if (rc != 0) {
        printf("Reply message failure: (%s)\n", smash_err(rc));
        if (flag_debug)
            dump_memory(&id, rlen, DUMP_VALUE_UNASSIGNED);
        return (rc);
    }
    if (flag_quiet == 0) {
        printf("ID\n");
        printf("  Kicksmash %u.%u built %02u%02u-%02u-%02u %02u:%02u:%02u\n",
               id.si_ks_version[0], id.si_ks_version[1],
               id.si_ks_date[0], id.si_ks_date[1],
               id.si_ks_date[2], id.si_ks_date[3],
               id.si_ks_time[0], id.si_ks_time[1], id.si_ks_time[2]);
        /* Fixed-size fields are not guaranteed to be NIL-terminated */
        printf("  USB %08x  Size %u  Serial \"%.*s\"  Name \"%.*s\"\n",
               id.si_usbid, (int) id.si_size, (int) sizeof (id.si_serial),
               id.si_serial, (int) sizeof (id.si_name), id.si_name);
        printf("  Mode: %s\n",
               (id.si_mode == 0) ? "32-bit" :
               (id.si_mode == 1) ? "16-bit" :
               (id.si_mode == 2) ? "16-bit high" :
               (id.si_mode == 3) ? "auto" :
               (id.si_mode == 4) ? "32-bit swap" : "unknown");
    }
    if (id.si_rev > 1) {
        uint32_t state = id.si_state;
        uint bit;
        printf("  CPU %s %u MHz, periph %u MHz\n",
               (id.si_cpu == 0) ? "STM32F107" :
               (id.si_cpu == 1) ? "GD32F107" : "Unknown",
               id.si_cpufreq, id.si_busfreq);
        for (bit = 0; bit < 32; bit++) {
            if (state & BIT(bit)) {
                if (bit < ARRAY_SIZE(board_states))
                    printf("  %s", board_states[bit]);
                else
                    printf("  bit%u", bit);
            }
        }
        if (state != 0)
            printf("\n");
    }

    usecs = smash_time();
    if (flag_quiet == 0) {
        if (usecs != 0) {
            sec  = usecs / 1000000;
            usec = usecs % 1000000;
            printf("  Uptime: %u.%06u sec\n", sec, usec);
        }
    }

    uint8_t nvdata[32];
    uint16_t what = 0x0020;  // Get all 32 bytes of NV data
    memset(nvdata, 0, sizeof (nvdata));
    rc = send_cmd(KS_CMD_GET | KS_GET_NV, &what, sizeof (what),
                   nvdata, sizeof (nvdata), &rlen);
    printf("  NV Data:");
    if (rc == 0) {
        uint pos;
        if (rlen > sizeof (nvdata))
            rlen = sizeof (nvdata);
        for (pos = 0; pos < rlen; pos++) {
            if (pos == 16)
                printf("\n          ");
            printf(" %02x", nvdata[pos]);
        }
        printf("\n");
    } else {
        if (rc == KS_STATUS_UNKCMD)
            printf(" Unavailable\n");
        else
            printf(" Fail (%s)\n", smash_err(rc));
    }

    return (0);
}

static const uint32_t test_pattern[] = {
    0x54455354, 0x50415454, 0x202d2053, 0x54415254,
    0x5555aaaa, 0x3333cccc, 0x1111eeee, 0x99996666,
    0x01000200, 0x04000800, 0x10002000, 0x40008000,
    0x00010002, 0x00040008, 0x00100020, 0x00400080,
    0xfefffdff, 0xfbfff7ff, 0xefffdfff, 0xbfff7fff,
    0xfffefffd, 0xfffbfff7, 0xffefffdf, 0xffbfff7f,
    0x54455354, 0x50415454, 0x20454e44, 0x20636468,
};

static int
smash_test_pattern(void)
{
    uint32_t reply_buf[64];
    uint start;
    uint pos;
    uint err_count = 0;
    uint rlen;
    uint rc;

    show_test_state("Test pattern", -1);

    memset(reply_buf, 0, sizeof (reply_buf));
#ifdef SEND_TESTPATT_ALT
    reply_buf[0] = 0xa5a5a5a5;
    rc = send_cmd(KS_CMD_TESTPATT, reply_buf, 2, reply_buf,
                  sizeof (reply_buf), &rlen);
#else
    rc = send_cmd(KS_CMD_TESTPATT, NULL, 0, reply_buf,
                  sizeof (reply_buf), &rlen);
#endif
    if (rc != 0) {
        printf("Reply message failure: (%s)\n", smash_err(rc));
        if (flag_debug)
            dump_memory(reply_buf, rlen, DUMP_VALUE_UNASSIGNED);
        show_test_state("Test pattern", rc);
        return (rc);
    }

    for (start = 0; start < ARRAY_SIZE(reply_buf); start++)
        if (reply_buf[start] == test_pattern[0])  // Found first data
            break;

    if (start == ARRAY_SIZE(reply_buf)) {
        printf("No test pattern marker [%08x] in reply\n", test_pattern[0]);
fail:
        dump_memory(reply_buf, sizeof (reply_buf), DUMP_VALUE_UNASSIGNED);
        show_test_state("Test pattern", 1);
        return (1);
    }

    if (start != 0) {
        printf("Pattern start 0x%x is not at beginning of buffer\n",
               start);
        err_count++;
    }
    if (start + ARRAY_SIZE(test_pattern) > ARRAY_SIZE(reply_buf)) {
        printf("Test pattern truncated (starts at 0x%x)\n", start);
        goto fail;
    }
    for (pos = 0; pos < ARRAY_SIZE(test_pattern); pos++) {
        if (reply_buf[start + pos] != test_pattern[pos]) {
            printf("At pos=%x reply %08x != expected %08x (diff %08x)\n", pos,
                   reply_buf[start + pos], test_pattern[pos],
                   reply_buf[start + pos] ^ test_pattern[pos]);
            if (++err_count > 6)
                goto fail;
        }
    }
    if (err_count != 0)
        goto fail;
    if (flag_debug > 1)
        dump_memory(reply_buf, sizeof (reply_buf), DUMP_VALUE_UNASSIGNED);
    show_test_state("Test pattern", 0);
    return (0);
}

static int
smash_test_loopback(void)
{
    uint8_t   *tx_buf;
    uint8_t   *rx_buf;
    uint       cur;
    uint       rc;
    uint       count;
    uint       rlen = 0;
    uint       nums = (rand32() % (TEST_LOOPBACK_MAX - 1)) + 1;
    uint64_t   time_start;
    uint64_t   time_end;

    show_test_state("Test loopback", -1);

    tx_buf = &test_loopback_buf[0];
    rx_buf = &test_loopback_buf[TEST_LOOPBACK_BUF];
    memset(rx_buf, 0, TEST_LOOPBACK_MAX * 4);
    for (cur = 0; cur < nums; cur++)
        tx_buf[cur] = (uint8_t) (rand32() >> 8);

    /* Measure IOPS */
    INTERRUPTS_DISABLE();
    time_start = smash_time();
    for (count = 0; count < 10; count++) {
        rc = send_cmd(KS_CMD_LOOPBACK, tx_buf, 4,
                      rx_buf, TEST_LOOPBACK_MAX, &rlen);
        if ((rc != KS_CMD_LOOPBACK))
            break;
    }
    time_end = smash_time();
    INTERRUPTS_ENABLE();

    if (rc == KS_CMD_LOOPBACK) {
        /* Test loopback accuracy */
        rc = send_cmd(KS_CMD_LOOPBACK, tx_buf, nums,
                      rx_buf, TEST_LOOPBACK_MAX, &rlen);
    }
    if (rc == KS_CMD_LOOPBACK) {
        rc = 0;
    } else {
        printf("FAIL: (%s)\n", smash_err(rc));
fail_handle_debug:
        if (flag_debug) {
            uint pos;
            uint8_t *txp = (uint8_t *)tx_buf;
            uint8_t *rxp = (uint8_t *)rx_buf;
            for (pos = 0; pos < nums; pos++)
                if (rxp[pos] != txp[pos])
                    break;
            dump_memory(tx_buf, nums, DUMP_VALUE_UNASSIGNED);
            if (pos < nums) {
                printf("--- Tx above  Rx below --- ");
                printf("First diff at 0x%x of 0x%x\n", pos, nums);
                dump_memory(rx_buf, rlen, DUMP_VALUE_UNASSIGNED);
            } else {
                printf("Tx and Rx buffers (len=0x%x) match\n", nums);
            }
        }
        goto fail_loopback;
    }
    if (rlen != nums) {
        printf("FAIL: rlen=%u != sent %u\n", rlen, nums);
        rc = MSG_STATUS_BAD_LENGTH;
        goto fail_handle_debug;
    }
    for (cur = 0; cur < nums; cur++) {
        if (rx_buf[cur] != tx_buf[cur]) {
            if (rc++ == 0)
                printf("\nLoopback data miscompare\n");
            if (rc < 5) {
                printf("    [%02x] %02x != expected %02x\n",
                       cur, rx_buf[cur], tx_buf[cur]);
            }
        }
    }
    if (rc >= 4)
        printf("%u miscompares\n", rc);
    if ((rc == 0) && (flag_quiet == 0)) {
        uint diff = (uint) (time_end - time_start);
        if (diff == 0)
            diff = 1;
        printf("PASS  %u IOPS\n", 1000000 * count / diff);
        return (0);
    }
fail_loopback:
    show_test_state("Test loopback", rc);
    return (rc);
}

static int
smash_test_loopback_perf(void)
{
    const uint lb_size  = 1000;
    const uint xfers    = 100;
    const uint lb_alloc = lb_size + KS_HDR_AND_CRC_LEN;  // Magic+len+cmd+CRC
    uint32_t  *buf;
    uint       cur;
    uint       rc;
    uint       diff;
    uint       total;
    uint       perf;
    uint64_t   time_start;
    uint64_t   time_end;

    show_test_state("Loopback perf", -1);

    buf = AllocMem(lb_alloc, MEMF_PUBLIC);
    if (buf == NULL) {
        printf("Memory allocation failure\n");
        return (1);
    }
    memset(buf, 0xa5, lb_size);

    time_start = smash_time();

    for (cur = 0; cur < xfers; cur++) {
        rc = send_cmd(KS_CMD_LOOPBACK, buf, lb_size, buf, lb_size, NULL);
        if (rc == KS_CMD_LOOPBACK) {
            rc = 0;
        } else {
            printf("FAIL: (%s)\n", smash_err(rc));
            if (flag_debug) {
                dump_memory(buf, lb_size, DUMP_VALUE_UNASSIGNED);
            }
            goto cleanup;
        }
    }

    if (flag_quiet == 0) {
        time_end = smash_time();
        diff = (uint) (time_end - time_start);
        if (diff == 0)
            diff = 1;
        total = xfers * (lb_size + KS_HDR_AND_CRC_LEN);
        perf = total * 1000 / diff;
        perf *= 2;  // Write data + Read (reply) data
        printf("PASS  %u KB/sec\n", perf);
    }

cleanup:
    if (buf != NULL)
        FreeMem(buf, lb_alloc);
    return (rc);
}

#define DELAY_MS_PER_TICK (1000 / 50)  // 50 ticks per second = 20 ms/tick

static uint
recv_msg(void *buf, uint len, uint *rlen, uint timeout_ms)
{
    uint rc;
    uint cmd = KS_CMD_MSG_RECEIVE | KS_MSG_OVERRIDE;
    rc = send_cmd(cmd, NULL, 0, buf, len, rlen);
    while (rc == KS_STATUS_NODATA) {
        Delay(1);
        rc = send_cmd(cmd, NULL, 0, buf, len, rlen);
        if (timeout_ms > DELAY_MS_PER_TICK)
            timeout_ms -= DELAY_MS_PER_TICK;
        else
            break;
    }
    if ((rc & 0xff) == KS_CMD_MSG_SEND)
        rc = 0;
    if (rc != 0) {
        printf("Get message failed: (%s)\n", smash_err(rc));
        if (flag_debug)
            dump_memory(buf, 0x40, DUMP_VALUE_UNASSIGNED);
    }
    return (rc);
}

static uint
recv_msg_loopback(void *buf, uint len, uint *rlen, uint which_buf)
{
    uint rc;
    uint cmd = KS_CMD_MSG_RECEIVE | KS_MSG_OVERRIDE;

    if (which_buf == 0)
        cmd |= KS_MSG_ALTBUF;

    rc = send_cmd(cmd, NULL, 0, buf, len, rlen);
    if ((rc & 0xff) == KS_CMD_MSG_SEND)
        rc = 0;
    if (rc != 0) {
        printf("Get message failed: (%s)\n", smash_err(rc));
        if (flag_debug)
            dump_memory(buf, 0x40, DUMP_VALUE_UNASSIGNED);
    }
    return (rc);
}

static uint
send_msg_loopback(void *buf, uint len, uint which_buf)
{
    uint rc;
    uint cmd = KS_CMD_MSG_SEND | KS_MSG_OVERRIDE;
    uint32_t rbuf[16];

    if (which_buf != 0)
        cmd |= KS_MSG_ALTBUF;

    rc = send_cmd(cmd, buf, len, rbuf, sizeof (rbuf), NULL);
    if (rc != 0) {
        printf("Send message buf%s l=%u failed: (%s)\n",
               which_buf ? " alt" : "", len, smash_err(rc));
        if (flag_debug)
            dump_memory(rbuf, sizeof (rbuf), DUMP_VALUE_UNASSIGNED);
    }
    return (rc);
}

static uint
get_msg_info(smash_msg_info_t *msginfo)
{
    uint rc = send_cmd(KS_CMD_MSG_INFO, NULL, 0,
                       msginfo, sizeof (*msginfo), NULL);
    if (rc != 0)
        printf("Get message info failed: (%s)\n", smash_err(rc));
    return (rc);
}

static uint
calc_kb_sec(uint usecs, uint bytes)
{
    if (usecs == 0)
        usecs = 1;
    while (bytes > 4000000) {
        bytes >>= 1;
        usecs >>= 1;
    }
    return (bytes * 1000 / usecs);
}

static int
smash_test_msg_loopback(void)
{
    smash_msg_info_t omsginfo;
    smash_msg_info_t msginfo;
    uint8_t  *buf;
    uint      rc;
    uint      rc2;
    uint      rlen;
    uint      sent;
    uint      pos;
    uint      count = 0;
    uint      pass;
    uint16_t  lockbits;
    uint32_t  rseed[2];
    uint      scount[2];
    uint64_t  time_start;
    uint64_t  time_end;
    uint      count_w1 = 0;
    uint      count_w2 = 0;
    uint      count_r  = 0;
    uint      time_w[2];
    uint      time_r[2];
    uint      total_w[2];
    uint      total_r[2];
    uint      locked = 0;

    show_test_state("Message buffer", -1);

    buf = AllocMem(MAX_CHUNK, MEMF_PUBLIC);
    if (buf == NULL) {
        printf("Memory allocation failure\n");
        return (1);
    }

    /* Lock message buffers */
    lockbits = BIT(0) | BIT(1);
    rc = send_cmd(KS_CMD_MSG_LOCK, &lockbits, sizeof (lockbits), NULL, 0, NULL);
    if (rc != 0) {
        /* Don't unlock below: the lock may belong to another program */
        printf("Message lock failed: (%s)\n", smash_err(rc));
        goto fail;
    }
    locked = 1;

#define MAX_MESSAGES 150
    if ((rc = get_msg_info(&omsginfo)) != 0)
        goto fail;
    if ((omsginfo.smi_atou_inuse != 0) || (omsginfo.smi_utoa_inuse != 0)) {
        if (flag_debug) {
            printf("Clearing atou=%u and utoa=%u bytes\n",
                    omsginfo.smi_atou_inuse, omsginfo.smi_utoa_inuse);
        }

        /* Discard old messages */
        if ((rc = send_cmd(KS_CMD_MSG_FLUSH, NULL, 0, NULL, 0, NULL)) != 0) {
            printf("Msg flush failed: (%s)\n", smash_err(rc));
            goto fail;
        }
        rc = send_cmd(KS_CMD_MSG_FLUSH | KS_MSG_ALTBUF, NULL, 0, NULL, 0, NULL);
        if (rc != 0) {
            printf("Msg flush failed: (%s)\n", smash_err(rc));
            goto fail;
        }
    }

    for (count = 0; count < MAX_CHUNK; count++)
        buf[count] = count;

    /* Buffers are empty at this point; fill both */
    for (pass = 0; pass < 2; pass++) {
        uint avail;
        uint inuse;

        if ((rc = get_msg_info(&msginfo)) != 0)
            goto fail;
        if (pass == 0)
            avail = msginfo.smi_atou_avail;
        else
            avail = msginfo.smi_utoa_avail;
        rseed[pass] = rand_seed;
        sent = 0;

        for (count = 0; count < MAX_MESSAGES; count++) {
            uint len      = (rand32() & 0x1f) + 0x20;
            uint lenround = ((len + 3) & ~3);

            if (lenround > avail)
                break;  // This will later force a wrap

            if ((rc = send_msg_loopback(buf, len, pass)) != 0)
                goto fail;
            count_w1 += len + KS_HDR_AND_CRC_LEN;
            sent += lenround + KS_HDR_AND_CRC_LEN;

            if ((rc = get_msg_info(&msginfo)) != 0)
                goto fail;
            if (pass == 0) {
                avail = msginfo.smi_atou_avail;
                inuse = msginfo.smi_atou_inuse;
            } else {
                avail = msginfo.smi_utoa_avail;
                inuse = msginfo.smi_utoa_inuse;
            }

            if (inuse != sent) {
                printf("FAIL: Sent %u (%u) to buf%u, but atou=%u utoa=%u\n",
                       sent, len, pass,
                       msginfo.smi_atou_inuse, msginfo.smi_utoa_inuse);
                rc = MSG_STATUS_BAD_LENGTH;
                goto fail;
            }
        }
        scount[pass] = count;
    }

    if ((rc = get_msg_info(&msginfo)) != 0)
        goto fail;
    if ((msginfo.smi_atou_inuse < msginfo.smi_atou_avail) ||
        (msginfo.smi_utoa_inuse < msginfo.smi_utoa_avail)) {
        printf("Fail: message buffers should be almost full at this point\n"
               "  atou_inuse=%u atou_avail=%u utoa_inuse=%u utoa_avail=%u\n",
               msginfo.smi_atou_inuse, msginfo.smi_atou_avail,
               msginfo.smi_utoa_inuse, msginfo.smi_utoa_avail);
        rc = 1;
        goto fail;
    }

    /* Extract messages from buffers and verify contents */
    for (pass = 0; pass < 2; pass++) {
        uint rlen;
        srand32(rseed[pass]);
        for (count = 0; count < MAX_MESSAGES * 2; count++) {
            uint inuse;
            uint len;

            if ((rc = recv_msg_loopback(buf, MAX_CHUNK, &rlen, pass)) != 0)
                goto fail;
            count_r += rlen + KS_HDR_AND_CRC_LEN;
            for (pos = 0; pos < rlen; pos++) {
                if (buf[pos] != (uint8_t)pos) {
                    printf("Data corrupt at %x of %x: %02x != expected %02x\n",
                           pos, rlen, buf[pos], (uint8_t)pos);
                    buf[pos] = pos;
                    rc = MSG_STATUS_FAIL;
                    goto fail;
                }
            }
            if ((rc = get_msg_info(&msginfo)) != 0)
                goto fail;
            if (pass == 0)
                inuse = msginfo.smi_atou_inuse;
            else
                inuse = msginfo.smi_utoa_inuse;
            if (inuse == 0)
                break;
#define BIG_WRITE_LEN 0x108
            if (count < scount[pass])
                len = (rand32() & 0x1f) + 0x20;
            else
                len = BIG_WRITE_LEN;
            if ((rlen != len) && (count != scount[pass])) {
                printf("Receive length %u != expected %u at %u of %s %u\n",
                       rlen, len, count, pass ? "utoa" : "atou", scount[pass]);
                rc = MSG_STATUS_BAD_LENGTH;
                goto fail;
            }
            if ((count > scount[pass] - 4) && (count < MAX_MESSAGES)) {
                if ((rc = send_msg_loopback(buf, BIG_WRITE_LEN, pass)) != 0) {
                    printf("Fail at msg %u, wrote=%u\n", count, count_w2);
                    goto fail;
                }
                count_w2 += BIG_WRITE_LEN + KS_HDR_AND_CRC_LEN;
            }
        }
    }
    if ((rc = get_msg_info(&msginfo)) != 0)
        goto fail;

    if ((msginfo.smi_atou_inuse != 0) || (msginfo.smi_utoa_inuse != 0)) {
        printf("Fail: message buffers should be empty at this point\n"
               "atou_inuse=%u atou_avail=%u utoa_inuse=%u utoa_avail=%u\n",
               msginfo.smi_atou_inuse, msginfo.smi_atou_avail,
               msginfo.smi_utoa_inuse, msginfo.smi_utoa_avail);
        rc = 1;
        goto fail;
    }

    if (count_r != count_w1 + count_w2) {
        printf("Count of read bytes %u != write bytes %u\n",
               count_r, count_w1 + count_w2);
        rc = 1;
        goto fail;
    }

    /* Measure write performance */
    time_start = smash_time();
    for (pos = 0; pos < 2; pos++) {
        uint total_wlen = 0;
        for (pass = 0; pass < 2; pass++) {
            srand32(rseed[pass]);
            for (count = 0; count < 10; count++) {
                uint len;
                if (pos == 0)
                    len = (rand32() & 0x1f) + 0x20;
                else
                    len = 0x100;
                if ((rc = send_msg_loopback(buf, len, pass)) != 0)
                    goto fail;
                total_wlen += len;
            }
        }
        time_end     = smash_time();
        time_w[pos]  = time_end - time_start;
        time_start   = time_end;
        total_w[pos] = total_wlen;
    }

    /* Measure read performance */
    for (pos = 0; pos < 2; pos++) {
        uint total_rlen = 0;
        for (pass = 0; pass < 2; pass++) {
            for (count = 0; count < 10; count++) {
                if ((rc = recv_msg_loopback(buf, MAX_CHUNK, &rlen, pass)) != 0)
                    goto fail;
                total_rlen += rlen;
            }
        }
        time_end     = smash_time();
        time_r[pos]  = time_end - time_start;
        time_start   = time_end;
        total_r[pos] = total_rlen;
    }

fail:
    /* Unlock message buffers (only if this test locked them) */
    if (locked) {
        rc2 = send_cmd(KS_CMD_MSG_LOCK | KS_MSG_UNLOCK, &lockbits,
                       sizeof (lockbits), NULL, 0, NULL);
        if (rc2 != 0) {
            printf("Message unlock failed: (%s)\n", smash_err(rc2));
            if (rc == 0)
                rc = rc2;
        }
    }

    FreeMem(buf, MAX_CHUNK);

    if (rc == 0) {
        if (flag_quiet == 0) {
            printf("PASS  %u-%u KB/sec (W)  %u-%u KB/sec (R)\n",
                   calc_kb_sec(time_w[0], total_w[0]),
                   calc_kb_sec(time_w[1], total_w[1]),
                   calc_kb_sec(time_r[0], total_r[0]),
                   calc_kb_sec(time_r[1], total_r[1]));
            return (0);
        }
    } else {
        show_test_state("Message buffer", rc);
    }
    return (rc);
}

static int
smash_test_usb_msg_loopback(void)
{
    km_msg_hdr_t *skm;
    km_msg_hdr_t *rkm;
    smash_msg_info_t msginfo;
    uint8_t  *buf[2];
    uint      pos;
    uint      rc;
    uint      maxlen = 2000;
    uint      len = 32;
    uint      rlen;
    uint      count;
    uint      icount;
    uint      total;
    uint      perf;
    uint      diff;
    uint      errs = 0;
    uint64_t  time_start;
    uint64_t  time_end;
    static uint8_t worked_before = 0;

    show_test_state("Remote message", -1);

    if ((rc = get_msg_info(&msginfo)) != 0) {
        printf("Get msg info failed: (%s)\n", smash_err(rc));
        return (rc);
    }

    if ((msginfo.smi_state_usb &
         (MSG_STATE_SERVICE_UP | MSG_STATE_HAVE_LOOPBACK)) !=
         (MSG_STATE_SERVICE_UP | MSG_STATE_HAVE_LOOPBACK)) {
        if (flag_quiet == 0)
            printf("Unavailable\n");
        if (worked_before)
            return (1);  // Then this is a failure
        else
            return (0);  // Was probably never available
    }

    buf[0] = NULL;
    buf[1] = NULL;
    for (pos = 0; pos < ARRAY_SIZE(buf); pos++) {
        buf[pos] = AllocMem(MAX_CHUNK, MEMF_PUBLIC);
        if (buf[pos] == NULL) {
            printf("Memory allocation failure\n");
            rc = MSG_STATUS_NO_MEM;
            goto fail;
        }
    }

    for (pos = 0; pos < maxlen; pos++) {
        buf[0][pos] = pos;
        buf[1][pos] = ~pos;
    }

    rkm = (km_msg_hdr_t *)buf[1];
    skm = (km_msg_hdr_t *)buf[0];
    skm->km_op = KM_OP_LOOPBACK;
    skm->km_status = 0xff;
    skm->km_tag = 0;

    /* Discard old messages */
    if ((rc = send_cmd(KS_CMD_MSG_FLUSH, NULL, 0, NULL, 0, NULL)) != 0) {
        printf("Msg flush failed: (%s)\n", smash_err(rc));
        goto fail;
    }

    for (count = 0; count < 10; count++) {
        len = (rand32() % (maxlen / 2)) + sizeof (*skm);
        skm->km_tag = count;
        if ((rc = send_msg_loopback(buf[0], len, 0)) != 0)
            goto fail;
        if ((rc = recv_msg(buf[1], MAX_CHUNK, &rlen, 1000)) != 0) {
            printf("  Expected message len=%u\n", len);
            if (flag_debug) {
                for (pos = 0; pos < len; pos++)
                    printf(" %02x", buf[0][pos]);
                printf("\n");
            }
            goto fail;
        }
        if (rlen != len) {
            printf("Receive length %u != expected %u\n", rlen, len);
            rc = MSG_STATUS_BAD_DATA;
            break;
        }
        if (rkm->km_op != (KM_OP_LOOPBACK | KM_OP_REPLY)) {
            printf("Receive message op %02x != expected %02x\n",
                   rkm->km_op, KM_OP_LOOPBACK | KM_OP_REPLY);
            rc = MSG_STATUS_BAD_DATA;
            break;
        }
        if (rkm->km_tag != count) {
            printf("Receive message tag %02x != expected %02x\n",
                   rkm->km_tag, count);
            rc = MSG_STATUS_BAD_DATA;
            break;
        }
#if 0
        printf("rlen=%u op=%x status=%x seq=%x\n",
               rlen, rkm->km_op, rkm->km_status, rkm->km_tag);
#endif
        for (pos = sizeof (*rkm); pos < len; pos++) {
            if (buf[1][pos] != buf[0][pos]) {
                if (errs++ < 5) {
                    if (errs == 1)
                        printf("Miscompare\n");
                    printf("  Pass %u pos=0x%x %02x != expected %02x\n",
                           count, pos, buf[1][pos], buf[0][pos]);
                }
            }
        }
        if (errs != 0) {
            rc = MSG_STATUS_BAD_DATA;
            break;
        }
    }
    if (rc != 0)
        goto fail;

    len = maxlen;
    time_start = smash_time();
    for (count = 0; count < 10; count++) {
        skm->km_tag = count;
        for (icount = 0; icount < 1; icount++) {
            if ((rc = send_msg_loopback(buf[0], len, 0)) != 0)
                goto fail;
        }
        for (icount = 0; icount < 1; icount++) {
            if ((rc = recv_msg(buf[1], MAX_CHUNK, &rlen, 1000)) != 0) {
                printf("Expected message len=%u\n", len);
                if (flag_debug) {
                    for (pos = 0; pos < len; pos++)
                        printf(" %02x", buf[0][pos]);
                    printf("\n");
                }
                goto fail;
            }
            if (rlen != len) {
                printf("Receive length %u != expected %u\n", rlen, len);
                rc = MSG_STATUS_BAD_DATA;
                goto fail;
            }
            if (rkm->km_op != (KM_OP_LOOPBACK | KM_OP_REPLY)) {
                printf("Receive message op %02x != expected %02x\n",
                       rkm->km_op, KM_OP_LOOPBACK | KM_OP_REPLY);
                rc = MSG_STATUS_BAD_DATA;
                goto fail;
            }
            if (rkm->km_tag != count) {
                printf("Receive message tag %02x != expected %02x\n",
                       rkm->km_tag, count);
                rc = MSG_STATUS_BAD_DATA;
                goto fail;
            }
        }
    }
    if ((rc == 0) && (flag_quiet == 0)) {
        time_end = smash_time();
        diff = (uint) (time_end - time_start);
        if (diff == 0)
            diff = 1;
        total = count * (maxlen + KS_HDR_AND_CRC_LEN);
        perf = total * 1000 / diff;
        perf *= 2 * icount;  // Write data + Read (reply) data
        printf("PASS  %u KB/sec\n", perf);
    }

fail:
    for (pos = 0; pos < ARRAY_SIZE(buf); pos++) {
        if (buf[pos] != NULL)
            FreeMem(buf[pos], MAX_CHUNK);
    }
    if (rc == 0)
        worked_before = 1;
    return (rc);
}

static int
smash_test_flash_id(void)
{
    int rc = 0;
    uint32_t dev1_first;
    uint32_t dev2_first;
    uint32_t dev1;
    uint32_t dev2;
    uint     mode;
    uint     count = 0;
    const char *id1;
    const char *id2;

    show_test_state("Flash ID", -1);
    rc = flash_id(&dev1_first, &dev2_first, &mode);
    if (rc != 0) {
        printf("%08x %08x", dev1_first, dev2_first);
        goto test_flash_id_fail;
    }

    id1 = ee_id_string(dev1_first);
    id2 = ee_id_string(dev2_first);
    if (strcmp(id1, "Unknown") == 0) {
        printf("Failed to identify device 1 (%08x)", dev1_first);
        rc = MSG_STATUS_BAD_DATA;
    }
    if ((mode == 32) && (strcmp(id2, "Unknown") == 0)) {
        printf("Failed to identify device 2 (%08x)", dev2_first);
        rc = MSG_STATUS_BAD_DATA;
    }
    if (rc != 0)
        goto test_flash_id_fail;

    if (mode == 32) {
        const chip_blocks_t *cb1 = get_chip_block_info(dev1_first);
        const chip_blocks_t *cb2 = get_chip_block_info(dev2_first);
        if (cb1 == NULL) {
            printf("Failed to determine erase block information for %08x\n",
                   dev1_first);
            rc = MSG_STATUS_BAD_DATA;
            goto test_flash_id_fail;
        }
        if (cb2 == NULL) {
            printf("Failed to determine erase block information for %08x\n",
                   dev2_first);
            rc = MSG_STATUS_BAD_DATA;
            goto test_flash_id_fail;
        }
        if ((cb1->cb_bbnum != cb2->cb_bbnum) ||
            (cb1->cb_bsize != cb2->cb_bsize) ||
            (cb1->cb_ssize != cb2->cb_ssize) ||
            (cb1->cb_map != cb2->cb_map)) {
            printf("Failure: flash device IDs are not compatible "
                   "(%08x %08x)\n", dev1_first, dev2_first);
            rc = MSG_STATUS_BAD_DATA;
            goto test_flash_id_fail;
        }
    }

    for (count = 1; count < 100; count++) {
        rc = flash_id(&dev1, &dev2, &mode);
        if (rc != 0) {
            printf("%08x %08x", dev1_first, dev2_first);
            break;
        }
        if (dev1 != dev1_first) {
            printf("  Flash Dev1 ID %08x != first read %08x",
                   dev1, dev1_first);
            rc = 1;
            break;
        }
        if (dev2 != dev2_first) {
            printf("  Flash Dev2 ID %08x != first read %08x",
                   dev2, dev2_first);
            rc = 1;
            break;
        }
    }

test_flash_id_fail:
    if (rc == 0) {
        if (flag_quiet)
            return (rc);
        printf("PASS  %08x %08x %u-bit\n", dev1, dev2, mode);
    } else {
        printf(" at read %u\n", count);
        show_test_state("Flash ID", rc);
    }

    return (rc);
}

static int
smash_test_commands(void)
{
    int errs = 0;
    int rc;
    int rc2;
    uint rlen;
    uint count;
    uint forbidden = 0;
    __attribute__((aligned(4))) uint8_t buf[256];

    show_test_state("Commands", -1);

    /* KS_CMD_NOP */
    rc = send_cmd(KS_CMD_NOP, NULL, 0, NULL, 0, NULL);
    if (rc != 0) {
        printf("FAIL: NOP (%s)\n", smash_err(rc));
        errs++;
        goto test_commands_fail;
    }

    /* KS_CMD_ID */
    smash_id_t id;
    memset(&id, 0, sizeof (id));
    rc = send_cmd(KS_CMD_ID, NULL, 0, &id, sizeof (id), &rlen);
    if ((rc != 0) || (id.si_usbid != 0x12091610)) {
        printf("FAIL: ID %08x (%s)\n", id.si_usbid, smash_err(rc));
        errs++;
    }

    /* KS_CMD_UPTIME */
    uint64_t usecs1;
    uint64_t usecs2;
    rc = send_cmd(KS_CMD_UPTIME, NULL, 0, &usecs1, sizeof (usecs1), NULL);
    Delay(1);
    rc2 = send_cmd(KS_CMD_UPTIME, NULL, 0, &usecs2, sizeof (usecs2), NULL);

    if ((rc != 0) || (rc2 != 0)) {
        printf("FAIL: UPTIME (%s) (%s)\n", smash_err(rc), smash_err(rc2));
        errs++;
        goto test_commands_fail;

    } else {
        uint64_t diff = usecs2 - usecs1;
        if ((diff < 19500) || (diff > 50000)) {
            printf("FAIL: UPTIME not accurate: 20000 expected, but got %s: ",
                   ull_to_str(diff, buf, sizeof (buf)));
            print_us_diff(usecs1, usecs2);
            errs++;
        }
    }

    /* KS_CMD_CLOCK */
    uint clock1[2];
    uint clock2[2];
    rc = send_cmd(KS_CMD_CLOCK, NULL, 0, &clock1, sizeof (clock1), &rlen);
    if (rc != 0) {
fail_clock:
        printf("FAIL: CLOCK get (%s)\n", smash_err(rc));
        errs++;

    } else if ((clock1[0] != 0) || (clock1[1] != 0)) {  // Clock is set
        /* Delay and check period */
        int cdiff;
        Delay(1);
        rc = send_cmd(KS_CMD_CLOCK, NULL, 0, &clock2, sizeof (clock2), &rlen);
        if (rc != 0)
            goto fail_clock;
        cdiff = clock2[1] - clock1[1];
        if (clock2[0] == clock1[0] + 1)
            cdiff += 1000000;  // Rollover
        if ((cdiff < 19500) || (cdiff > 50000)) {
            printf("FAIL: CLOCK not accurate: 20000 expected, but got %u:\n",
                   cdiff);
            printf("      CLOCK1=%u.%06u sec CLOCK2=%u.%06u sec\n",
                   clock1[0], clock1[1], clock2[0], clock2[1]);
            print_us_diff(0, cdiff);
            errs++;
        }
    }

    /* KS_CMD_GET */
    uint8_t nvdata1[32];
    uint8_t nvdata2[32];
    uint16_t what = 0x0010;  // Get 16 bytes of NV data
    rc = send_cmd(KS_CMD_GET | KS_GET_NV, &what, sizeof (what),
                  nvdata1, sizeof (nvdata1), &rlen);
    if (rc != 0) {
fail_get_nv:
        printf("FAIL: GET NV (%s)\n", smash_err(rc));
        errs++;
    } else {
        for (count = 0; count < 10; count++) {
            rc = send_cmd(KS_CMD_GET | KS_GET_NV, &what, sizeof (what),
                          nvdata2, sizeof (nvdata2), &rlen);
            if (rc != 0)
                goto fail_get_nv;
            if (memcmp(nvdata1, nvdata2, what) != 0) {
                printf("FAIL: GET NV miscompare:\n");
                printf("  Pass 1: ");
                dump_memory(nvdata1, what, DUMP_VALUE_UNASSIGNED);
                printf("  Pass 2: ");
                dump_memory(nvdata2, what, DUMP_VALUE_UNASSIGNED);
                errs++;
                break;
            }
        }
    }

    /* KS_CMD_CONS_OUTPUT */
    uint16_t maxlen = 0;
    buf[0] = 0xa5;
    buf[1] = 0x5a;
    rc = send_cmd(KS_CMD_CONS_OUTPUT, &maxlen, sizeof (maxlen),
                  buf, sizeof (buf), &rlen);
    if (rc != 0) {
        printf("FAIL: CONS_OUTPUT (%s)\n", smash_err(rc));
        errs++;
    } else if ((rlen != 0) || (buf[0] != 0xa5) || (buf[1] != 0x5a)) {
        printf("FAIL: CONS_OUTPUT rlen=%u buf=%02x %02x\n",
               rlen, buf[0], buf[1]);
        errs++;
    }

    /* KS_CMD_BANK_INFO */
    bank_info_t info;
    rc = send_cmd(KS_CMD_BANK_INFO, NULL, 0, &info, sizeof (info), &rlen);
    if (rc != 0) {
        printf("FAIL: BANK_INFO (%s)\n", smash_err(rc));
        errs++;
    } else {
        uint bank;
        if ((info.bi_bank_current >= ROM_BANKS) ||
            (info.bi_bank_poweron >= ROM_BANKS) ||
            ((info.bi_bank_nextreset >= ROM_BANKS) &&
             (info.bi_bank_nextreset < 0xff))) {
            printf("FAIL: BANK_INFO current=%x nextreset=%x poweron=%x\n",
                   info.bi_bank_current, info.bi_bank_nextreset,
                   info.bi_bank_poweron);
            errs++;
        } else {
            for (bank = 0; bank < ROM_BANKS; bank++) {
                if (((info.bi_longreset_seq[bank] >= ROM_BANKS) &&
                     (info.bi_longreset_seq[bank] < 0xff)) ||
                    ((info.bi_merge[bank] >> 4) >= ROM_BANKS) ||
                    ((info.bi_merge[bank] & 0xf) >= ROM_BANKS)) {
                    printf("FAIL: BANK_INFO bank=%x longreset=%x merge=%02x\n",
                           bank, info.bi_longreset_seq[bank],
                           info.bi_merge[bank]);
                    errs++;
                }
            }
        }
    }

    /* KS_CMD_MSG_STATE */
    struct {
        uint16_t amiga_app_state;
        uint16_t usb_app_state;
    } mstate;
    memset(&mstate, 0, sizeof (mstate));
    rc = send_cmd(KS_CMD_MSG_STATE, NULL, 0, &mstate, sizeof (mstate), &rlen);
    if (rc != 0) {
fail_msg_state_get:
        printf("FAIL: MSG_STATE (%s)\n", smash_err(rc));
        errs++;
        goto fail_msg_state;
    }
    if (mstate.amiga_app_state & 0x8000) {
        printf("FAIL: MSG_STATE didn't expire %x\n", mstate.amiga_app_state);
        errs++;
        goto fail_msg_state;
    }

    /* Now set state and request expiration */
    Forbid();
    forbidden = 1;
    struct {
        uint16_t mask;
        uint16_t state;
        uint16_t expire;
    } setstate;
    setstate.mask  = 0x8000;
    setstate.state = 0x8000;
    setstate.expire = 20;   // 20 msec
    rc = send_cmd(KS_CMD_MSG_STATE | KS_MSG_STATE_SET, &setstate,
                  sizeof (setstate), &mstate, sizeof (mstate), &rlen);
    if (rc != 0) {
        printf("FAIL: MSG_STATE SET (%s)\n", smash_err(rc));
        errs++;
        goto fail_msg_state;
    }

    rc = send_cmd(KS_CMD_MSG_STATE, NULL, 0, &mstate, sizeof (mstate), &rlen);
    if (rc != 0)
        goto fail_msg_state_get;

    /* Should not be expired yet */
    if ((mstate.amiga_app_state & 0x8000) == 0) {
        printf("FAIL: MSG_STATE SET expired early: %04x\n",
               mstate.amiga_app_state);
        errs++;
        goto fail_msg_state;
    }

    /*
     * Delay(1) only waits until the next tick, which can be less than
     * 20 msec. Two ticks guarantees the 20 msec expiration has passed.
     */
    Delay(2);

    /* Should be expired now */
    rc = send_cmd(KS_CMD_MSG_STATE, NULL, 0, &mstate, sizeof (mstate), &rlen);
    if (rc != 0)
        goto fail_msg_state_get;

    if ((mstate.amiga_app_state & 0x8000) != 0) {
        printf("FAIL: MSG_STATE SET didn't expire: %04x\n",
               mstate.amiga_app_state);
        errs++;
        goto fail_msg_state;
    }
    /* KS_CMD_MSG_INFO */
    smash_msg_info_t msginfo;
fail_msg_state:
    if (forbidden) {
        /* Every path after Forbid() above ends up here */
        Permit();
        forbidden = 0;
    }
    rc = get_msg_info(&msginfo);
    if (rc != 0) {
        printf("FAIL: MSG_INFO (%s)\n", smash_err(rc));
        errs++;
    } else if ((msginfo.smi_state_amiga != mstate.amiga_app_state) ||
               (msginfo.smi_state_usb   != mstate.usb_app_state)) {
        printf("FAIL: MSG_INFO didn't match MSG_STATE "
               "%04x ?= %04x  %04x ?= %04x\n",
               msginfo.smi_state_amiga, mstate.amiga_app_state,
               msginfo.smi_state_usb, mstate.usb_app_state);
        errs++;
    } else {
        uint total_a = msginfo.smi_atou_inuse + msginfo.smi_atou_avail;
        uint total_u = msginfo.smi_utoa_inuse + msginfo.smi_utoa_avail;

        if (total_a != total_u) {
            printf("FAIL: MSG_INFO buffer sizes don't match %u != %u\n",
                   total_a, total_u);
            errs++;
        }
    }

test_commands_fail:
    show_test_state("Commands", errs);

    return (errs);
}


static int
smash_test(uint mask)
{
    int rc = 0;
    if (mask & BIT(0)) {
        rc = smash_test_pattern();
        if (rc != 0)
            return (rc);
    }

    if (is_user_abort())
        return (1);

    if (mask & BIT(1)) {
        rc = smash_test_loopback();
        if (rc != 0)
            return (rc);
    }

    if (is_user_abort())
        return (1);

    if (mask & BIT(2)) {
        rc = smash_test_loopback_perf();
        if (rc != 0)
            return (rc);
    }

    if (is_user_abort())
        return (1);

    if (mask & BIT(3)) {
        rc = smash_test_msg_loopback();
        if (rc != 0)
            return (rc);
    }

    if (is_user_abort())
        return (1);

    if (mask & BIT(4)) {
        rc = smash_test_usb_msg_loopback();
        if (rc != 0)
            return (rc);
    }

    if (is_user_abort())
        return (1);

    if (mask & BIT(5)) {
        rc = smash_test_flash_id();
        if (rc != 0)
            return (rc);
    }

    if (is_user_abort())
        return (1);

    if (mask & BIT(6)) {
        rc = smash_test_commands();
        if (rc != 0)
            return (rc);
    }

    return (0);
}

#undef DEBUG_FLASH_SEQUENCE
#ifdef DEBUG_FLASH_SEQUENCE
uint32_t flash_debugdata[8];
uint32_t flash_debugaddr[8];
uint8_t  flash_debugcount;
#endif

/*
 * flash_cmd_core
 * --------------
 * Must be called with interrupts and cache disabled
 *
 * This function will send a command to the flash after setting the
 * transaction up with the Kicksmash CPU.
 */
int
flash_cmd_core(uint32_t cmd, void *arg, uint argsize)
{
    uint32_t addr;
    uint32_t addrs[64];
    uint     retry = 0;
    uint     num_addr;
    uint     pos;
    int      rc;

    rc = send_cmd_core(cmd, arg, argsize, addrs, sizeof (addrs), &num_addr);
    if (rc != 0)
        goto flash_cmd_cleanup;

    /*
     * All Kicksmash flash commands have a similar sequence, where
     * the command is issued to Kicksmash, then Kicksmash will reply
     * with the sequence of addresses to blind read.
     * There is additional work for write and erase, where status must be
     * repeatedly read to poll flash state. It is left to the caller
     * to complete whatever additional polling is necessary and issue
     * the next command to Kicksmash.
     */
    num_addr /= 4;

    cia_spin(CIA_USEC(10));
    if (flag_conservative_mode)
        cia_spin(20);

    addr = ROM_BASE + ((addrs[0] << smash_cmd_shift) & 0x7ffff);
    (void) *VADDR32(addr);  // Generate OE strobe to kick off DMA
    cia_spin(1);
    if (flag_conservative_mode)
        cia_spin(2);

    for (pos = 0; pos < num_addr; pos++) {
        uint32_t addr = ROM_BASE + ((addrs[pos] << smash_cmd_shift) & 0x7ffff);
        uint32_t val = *VADDR32(addr);  // Generate address on the bus
        if ((pos == 0) && (val == 0xffffffff)) {
            if (retry++ > 5) {
                rc = MSG_STATUS_NO_REPLY;  // Timed out waiting for Kicksmash
                goto flash_cmd_cleanup;
            }
#ifdef DEBUG_FLASH_SEQUENCE
            if (*ADDR32(0x77820) < retry)
                *ADDR32(0x77820) = retry;
#endif
            pos--;
            continue;
        }
#ifdef DEBUG_FLASH_SEQUENCE
        /* Debug this particular command sequence */
        if ((cmd == KS_CMD_FLASH_ID) || (cmd == KS_CMD_FLASH_CMD)) {
            if (pos < ARRAY_SIZE(flash_debugdata)) {
                *ADDR32(0x77800 + pos * 4) = addr;
                *ADDR32(0x77810 + pos * 4) = val;
                flash_debugdata[pos] = val;
                flash_debugaddr[pos] = addr;
                flash_debugcount = pos + 1;
            }
        }
#endif
    }

flash_cmd_cleanup:
    cia_spin(1);
    if (rc != 0) {
        /* Attempt to drain data and wait for Kicksmash to enable flash */
        for (pos = 0; pos < 500; pos++) {
            (void) *VADDR32(ROM_BASE + 4);
            cia_spin(10);
        }
        /* Wait 10 ms longer */
        for (pos = 0; pos < 10; pos++)
            cia_spin(CIA_USEC(1000));
    }
    return (rc);
}

#if 0
static int
flash_cmd(uint32_t cmd, void *arg, uint argsize)
{
    int rc;
    SUPERVISOR_STATE_ENTER();
    INTERRUPTS_DISABLE();
    CACHE_DISABLE_DATA();
    MMU_DISABLE();

    rc = flash_cmd_core(cmd, arg, argsize);

    CACHE_FLUSH();
    MMU_RESTORE();
    CACHE_RESTORE_STATE();
    INTERRUPTS_ENABLE();
    SUPERVISOR_STATE_EXIT();
    return (rc);
}
#endif

#if 0
static int
flash_read(void)
{
    return (flash_cmd(KS_CMD_FLASH_READ, NULL, 0));
}
#endif

static uint32_t rom_header_expected;
static void
rom_get_normal(void)
{
    rom_header_expected = *VADDR32(ROM_BASE);
}

/*
 * rom_wait_normal() waits until ROM is back in normal mode.
 */
static uint
rom_wait_normal(void)
{
    uint timeout = 0;
    while (*VADDR32(ROM_BASE) != rom_header_expected) {
        if (timeout++ > 100)
            return (1);  // Took too long.
        cia_spin(10);
    }
    return (0);
}

/*
 * flash_read_mode() returns the flash to normal read mode.
 *
 * expect_rom_signature says whether to expect the Kickstart ROM signature
 * at offset 0.
 */
int
flash_read_mode(uint expect_rom_signature)
{
    uint count;
    uint pos;
    int rc = flash_cmd_core(KS_CMD_FLASH_READ, NULL, 0);
    if ((rc != 0) || (expect_rom_signature && rom_wait_normal()))  {
        /* Try harder to restore flash to normal read mode */
        for (count = 0; count < 10; count++) {
            for (pos = 0; pos < 10; pos++)
                (void) *VADDR16(ROM_BASE + 8);
            cia_spin(CIA_USEC(1000));
            if ((flash_cmd_core(KS_CMD_FLASH_READ, NULL, 0) == 0) &&
                ((expect_rom_signature == 0) || (rom_wait_normal() == 0))) {
                rc = 0;
                break;
            }
        }
    }
    return (rc);
}

int
flash_id(uint32_t *dev1, uint32_t *dev2, uint *mode)
{
    uint32_t data[32];
    uint     pos;
    int      rc1;
    int      rc2;

    *dev1 = 0;
    *dev2 = 0;

    /*
     * XXX: This code needs to be revised for 16-bit machines so that
     *      it probes with both smash_cmd_shift = 2 and also = 1.
     *      An alternative is to just ask KS what mode it's running in
     *      with the KS_CMD_ID call.
     */
    SUPERVISOR_STATE_ENTER();
    INTERRUPTS_DISABLE();
    CACHE_DISABLE_DATA();
    MMU_DISABLE();

#undef TEST_CMD_FLASH_CMD
#ifdef TEST_CMD_FLASH_CMD
    uint32_t values[] = { 0x00555, 0x002aa, 0x00555,
                          0x00aa00aa, 0x00550055, 0x00900090 };
    rc1 = flash_cmd_core(KS_CMD_FLASH_CMD, values, sizeof (values));
#else
    rc1 = flash_cmd_core(KS_CMD_FLASH_ID, NULL, 0);
#endif
    /* Workaround for cold STM32 not releasing OEWE in time */
    (void) *VADDR16(ROM_BASE + 32);
    (void) *VADDR16(ROM_BASE + 36);
    (void) *VADDR16(ROM_BASE + 40);
    (void) *VADDR16(ROM_BASE + 44);
    cia_spin(CIA_USEC(5));

    /* Get flash ID data */
    for (pos = 0; pos < ARRAY_SIZE(data); pos++)
        data[pos] = *VADDR32(ROM_BASE + pos * 4);

    rc2 = flash_read_mode(1);

    CACHE_FLUSH();
    MMU_RESTORE();
    CACHE_RESTORE_STATE();
    INTERRUPTS_ENABLE();
    SUPERVISOR_STATE_EXIT();

#ifdef DEBUG_FLASH_SEQUENCE
    if (flag_debug > 1) {
        printf("Debug flash sequence\n");
        for (pos = 0; pos < flash_debugcount; pos++) {
            printf("    %08x = %08x\n",
                   flash_debugaddr[pos], flash_debugdata[pos]);
        }
    }
#endif
    if (flag_debug || rc1 || rc2) {
        printf("rc1=(%s)  rc2=(%s)\n",
               smash_err(rc1), smash_err(rc2));
    }

    if (rc1 == 0) {
        /*
         * Validation for a recognized flash device is done by
         * get_chip_block_info(). The code just needs to determine
         * whether it's a 16-bit or 32-bit device.
         */
        uint flash_mode;
        uint16_t device;
        const chip_blocks_t *cb;

        if ((data[0x0] != 0x00000000) && (data[0x0] != 0xffffffff) &&
            (data[0x1] != 0x00000000) && (data[0x1] != 0xffffffff) &&
            (data[0x2] == 0x00000000) &&
            ((uint16_t) data[0x1] == (data[1] >> 16))) {
            /* flash is 32-bit */
            flash_mode = 32;
            device = data[1] & 0xffff;
            cb = get_chip_block_info(device);
            if ((cb->cb_chipid == 0) ||  // Unknown chip
                (data[0x4] != data[0x0]) || (data[0x5] != data[0x1]) ||
                (data[0x8] != data[0x0]) || (data[0x9] != data[0x1]) ||
                (data[0xc] != data[0x0]) || (data[0xd] != data[0x1])) {
                printf("Unexpected ID values from flash\n");
                for (pos = 0; pos < 0xe; pos += 4) {
                    if (pos != 0)
                        printf(", ");
                    printf("%08x %08x", data[pos], data[pos + 1]);
                }
                printf("\n");
                rc1 = 1;
            }
        } else {
            /* flash is 16-bit */
            flash_mode = 16;
            device = data[0] & 0xffff;
            cb = get_chip_block_info(device);
            if ((cb->cb_chipid == 0) ||  // Unknown chip
                (data[0x2] != data[0x0]) || (data[0x3] != data[0x1]) ||
                (data[0x4] != data[0x0]) || (data[0x5] != data[0x1]) ||
                (data[0x6] != data[0x0]) || (data[0x7] != data[0x1])) {
                printf("Unexpected ID values from flash\n");
                for (pos = 0; pos < 0xe; pos++)
                    printf(" %08x", data[pos]);
                printf("\n");
                rc1 = 1;
            }
        }
        if (mode != NULL)
            *mode = flash_mode;

        if (flash_mode == 16)
            smash_cmd_shift = 1;
        else
            smash_cmd_shift = 2;

        if (flag_debug) {
            printf("Flash ID: %svalid\n", rc1 ? "in" : "");
            printf("    %08x %08x\n", data[0], data[1]);
            if (flag_debug > 1)
                dump_memory(data, sizeof (data) / 2, DUMP_VALUE_UNASSIGNED);
        }
    }
    *dev1 = (data[0] << 16) | ((uint16_t) data[1]);
    *dev2 = (data[0] & 0xffff0000) | (data[1] >> 16);

    return (rc1 ? rc1 : rc2);
}

static int
flash_show_id(void)
{
    int      rc;
    uint     mode;
    uint32_t flash_dev1;
    uint32_t flash_dev2;
    const char *id1;
    const char *id2;

    rc = flash_id(&flash_dev1, &flash_dev2, &mode);
    if (rc != 0) {
        printf("Flash id failure (%s)\n", smash_err(rc));
        return (rc);
    }

    id1 = ee_id_string(flash_dev1);
    id2 = ee_id_string(flash_dev2);

    if (strcmp(id1, "Unknown") == 0) {
        printf("Failed to identify device 1 (%08x)\n", flash_dev1);
        rc = MSG_STATUS_BAD_DATA;
    }
    if ((mode == 32) && (strcmp(id2, "Unknown") == 0)) {
        printf("Failed to identify device 2 (%08x)\n", flash_dev2);
        rc = MSG_STATUS_BAD_DATA;
    }

    if (flag_quiet)
        return (rc);

    printf("Flash ID\n");
    if (mode == 16) {
        printf("  %08x %s", flash_dev1, id1);
    } else {
        printf("  %08x %08x %s %s", flash_dev1, flash_dev2, id1, id2);
    }
    printf(" (%u-bit mode)\n", mode);
    if ((mode == 32) && ((flash_dev1 & 0xffff) != (flash_dev2 & 0xffff))) {
        printf("  Warning: flash device IDs differ\n");
        rc = MSG_STATUS_MISMATCH;
    }

    return (rc);
}

static void
rom_bank_show(void)
{
    bank_info_t info;
    uint        rlen;
    uint        rc;
    uint        bank;

    rc = send_cmd(KS_CMD_BANK_INFO, NULL, 0, &info, sizeof (info), &rlen);
    if (rc != 0) {
        printf("Failed to get bank information: %d %s\n", rc, smash_err(rc));
        return;
    }
    printf("Bank  Name            Merge LongReset  PowerOn  Current  "
           "NextReset\n");
    for (bank = 0; bank < ROM_BANKS; bank++) {
        uint aspaces = 2;
        uint pos;
        uint banks_add = info.bi_merge[bank] >> 4;
        uint bank_sub  = info.bi_merge[bank] & 0xf;
        printf("%-5u %-15.16s ", bank, info.bi_name[bank]);

        if (banks_add < 1)
            aspaces += 4;
        else if (bank_sub == 0)
            printf("-\\  ");
        else if (bank_sub == banks_add)
            printf("-/  ");
        else
            printf("  | ");

        for (pos = 0; pos < ARRAY_SIZE(info.bi_longreset_seq); pos++)
            if (info.bi_longreset_seq[pos] == bank)
                break;

        if (pos < ARRAY_SIZE(info.bi_longreset_seq)) {
            printf("%*s%u", aspaces, "", pos);
            aspaces = 0;
        } else {
            aspaces++;
        }
        aspaces += 10;

        if (bank == info.bi_bank_poweron) {
            printf("%*s*", aspaces, "");
            aspaces = 0;
        } else {
            aspaces++;
        }
        aspaces += 8;

        if (bank == info.bi_bank_current) {
            printf("%*s*", aspaces, "");
            aspaces = 0;
        } else {
            aspaces++;
        }
        aspaces += 8;

        if (bank == info.bi_bank_nextreset) {
            printf("%*s*", aspaces, "");
            aspaces = 0;
        } else {
            aspaces++;
        }
        aspaces += 8;
        printf("\n");
    }
}

static int
cmd_bank(int argc, char *argv[])
{
    const char *ptr;
    uint8_t  bank_start = 0;
    uint8_t  bank_end   = 0;
    uint     flag_bank_merge       = 0;
    uint     flag_bank_unmerge     = 0;
    uint     bank;
    uint     rc = 1;
    uint     opt = 0;
    int      arg;
    uint16_t argval;

    if (argc < 2) {
        printf("-b requires an argument\n");
        printf("One of: ?, show, name, longreset, nextreset, "
               "poweron, merge, unmerge\n");
        return (1);
    }
    for (arg = 1; arg < argc; arg++) {
        ptr = long_to_short(argv[arg], long_to_short_bank,
                            ARRAY_SIZE(long_to_short_bank));
        if (*ptr == '-') {
            for (++ptr; *ptr != '\0'; ptr++) {
                switch (*ptr) {
                    case 'c':  // current
                        opt = KS_BANK_SETCURRENT;
set_current_poweron_reset_bank:
                        if (++arg >= argc) {
                            printf("-b -%s requires a <bank> number to set\n",
                                    ptr);
                            return (1);
                        }
                        bank = atoi(argv[arg]);
                        if (bank >= ROM_BANKS) {
                            printf("Bank %u is invalid (maximum bank is %u)\n",
                                   bank, ROM_BANKS - 1);
                            return (1);
                        }

                        if (++arg < argc) {
                            if (strcmp(argv[arg], "reboot") == 0) {
                                opt |= KS_BANK_REBOOT;
                            } else {
                                printf("-b -%s only accepts \"reboot\" as an "
                                       "option after bank number\n", ptr);
                                return (1);
                            }
                        }

                        argval = bank;
                        rc = send_cmd(KS_CMD_BANK_SET | opt, &argval,
                                      sizeof (argval), NULL, 0, NULL);
                        if (rc != 0) {
                            printf("Bank set failed: %d %s\n",
                                   rc, smash_err(rc));
                        }
                        return (rc);
                    case 'h':  // help
                        rc = 0;
usage:
                        printf("%s", cmd_bank_options);
                        return (rc);
                    case 'l': {  // longreset
                        bank_info_t info;
                        uint8_t     banks[ROM_BANKS];
                        uint        cur;
                        uint        rlen;

                        rc = send_cmd(KS_CMD_BANK_INFO, NULL, 0, &info,
                                      sizeof (info), &rlen);
                        if (rc != 0) {
                            printf("Failed to get bank information: %d %s\n",
                                   rc, smash_err(rc));
                            return (rc);
                        }

                        rc = 0;
                        for (cur = 0; cur < ROM_BANKS; cur++) {
                            if (++arg < argc) {
                                uint sub;
                                bank = atoi(argv[arg]);
                                if (bank >= ROM_BANKS) {
                                    printf("Bank %u is invalid (maximum bank "
                                           "is %u)\n", bank, ROM_BANKS - 1);
                                    rc++;
                                    continue;
                                }
                                sub = info.bi_merge[bank] & 0x0f;
                                if (sub != 0) {
                                    printf("Bank %u is part of a merged bank, "
                                           "but is not the first (use %u)\n",
                                           bank, bank - sub);
                                    rc++;
                                }
                                banks[cur] = bank;
                            } else {
                                banks[cur] = 0xff;
                            }
                        }
                        if (rc != 0)
                            return (rc);

                        rc = send_cmd(KS_CMD_BANK_LRESET, &banks,
                                      sizeof (banks), NULL, 0, NULL);
                        if (rc != 0) {
                            printf("Bank longreset failed: %d %s\n",
                                   rc, smash_err(rc));
                        }
                        return (rc);
                    }
                    case 'm': {  // merge
                        bank_info_t info;
                        uint        count;
                        uint        rlen;
                        flag_bank_merge++;
bank_merge_unmerge:
                        if (++arg != argc - 2) {
                            printf("-b -%s requires <start> and <end> bank "
                                   "numbers (range)\n", ptr);
                            return (1);
                        }
                        {
                            /*
                             * Range check before narrowing to uint8_t, so
                             * that a value such as 256 is not taken as 0.
                             */
                            uint vstart = atoi(argv[arg++]);
                            uint vend   = atoi(argv[arg]);
                            if ((vstart >= ROM_BANKS) || (vend >= ROM_BANKS)) {
                                printf("Bank %u is invalid (maximum bank is "
                                       "%u)\n", (vstart >= ROM_BANKS) ?
                                       vstart : vend, ROM_BANKS - 1);
                                return (1);
                            }
                            bank_start = vstart;
                            bank_end   = vend;
                        }
                        if (bank_start > bank_end) {
                            printf("bank %u is not less than end %u\n",
                                   bank_start, bank_end);
                            return (1);
                        }
                        count = bank_end - bank_start + 1;
                        if ((count != 1) && (count != 2) && (count != 4) &&
                            (count != 8)) {
                            printf("Bank sizes must be a power of 2 "
                                   "(1, 2, 4, or 8 banks)\n");
                            return (1);
                        }
                        if ((count == 2) && (bank_start & 1)) {
                            printf("Two-bank ranges must start with an "
                                   "even bank number (0, 2, 4, or 6)\n");
                            return (1);
                        }
                        if ((count == 4) &&
                            (bank_start != 0) && (bank_start != 4)) {
                            printf("Four-bank ranges must start with either "
                                   "bank 0 or bank 4\n");
                            return (1);
                        }
                        if ((count == 8) && (bank_start != 0)) {
                            printf("Eight-bank ranges must start with "
                                   "bank 0\n");
                            return (1);
                        }

                        rc = send_cmd(KS_CMD_BANK_INFO, NULL, 0,
                                      &info, sizeof (info), &rlen);
                        if (rc != 0) {
                            printf("Failed to get bank information: %d %s\n",
                                   rc, smash_err(rc));
                            return (rc);
                        }
                        for (bank = bank_start; bank <= bank_end; bank++) {
                            if (flag_bank_merge && (info.bi_merge[bank] != 0)) {
                                uint banks = (info.bi_merge[bank] >> 4) + 1;
                                printf("Bank %u is already part of a%s %u "
                                       "bank range\n",
                                       bank, (banks == 8) ? "n" : "", banks);
                                return (1);
                            }
                            if (flag_bank_unmerge &&
                                (info.bi_merge[bank] == 0)) {
                                printf("Bank %u is not part of a bank range\n",
                                       bank);
                                return (1);
                            }
                        }

                        argval = bank_start | (bank_end << 8);
                        rc = send_cmd(KS_CMD_BANK_MERGE | opt, &argval,
                                      sizeof (argval), NULL, 0, NULL);
                        if (rc != 0) {
                            printf("Bank %smerge failed: %d %s\n",
                                   (opt != 0) ? "un" : "", rc, smash_err(rc));
                            return (rc);
                        }
                        break;
                    }
                    case 'n': {  // name
                        char argbuf[64];
                        if (++arg != argc - 2) {
                            printf("-b %s requires a <bank> number and "
                                   "\"name text\"\n", argv[1]);
                            return (1);
                        }
                        bank = atoi(argv[arg]);
                        if (bank >= ROM_BANKS) {
                            printf("Bank %u is invalid (maximum bank is %u)\n",
                                   bank, ROM_BANKS - 1);
                            return (1);
                        }
                        argval = bank;
                        memcpy(argbuf, &argval, 2);
                        /* bi_name[] holds at most 15 characters + NIL */
                        if (strlen(argv[++arg]) > 15) {
                            printf("Bank name \"%s\" is too long (maximum 15 "
                                   "characters)\n", argv[arg]);
                            return (1);
                        }
                        strcpy(argbuf + 2, argv[arg]);
                        rc = send_cmd(KS_CMD_BANK_NAME, argbuf,
                                      strlen(argbuf + 2) + 3, NULL, 0, NULL);
                        if (rc != 0) {
                            printf("Bank name set failed: %d %s\n",
                                   rc, smash_err(rc));
                        }
                        return (rc);
                    }
                    case 'N':  // nextreset
                        opt = KS_BANK_SETRESET;
                        goto set_current_poweron_reset_bank;
                    case 'p':  // poweron
                        opt = KS_BANK_SETPOWERON;
                        goto set_current_poweron_reset_bank;
                    case 's':  // show
                        rom_bank_show();
                        return (0);
                    case 'u':  // unmerge
                        flag_bank_unmerge++;
                        opt = KS_BANK_UNMERGE;
                        goto bank_merge_unmerge;
                    default:
                        printf("Unknown argument %s \"-%s\"\n",
                               argv[0], ptr);
                        goto usage;
                }
            }
        } else {
            printf("Unknown argument %s \"%s\"\n",
                   argv[0], ptr);
            goto usage;
        }
    }
    return (0);
}

/*
 * cmd_set
 * -------
 * Set a KickSmash value, such as board name, or NVRAM value available to
 * AmigaOS.
 */
static int
cmd_set(int argc, char *argv[])
{
    int rc;
    int arg;

    if (argc < 2) {
cmd_set_usage:
        printf("set name <string>    - up to 15 characters for board name\n"
               "set nv<n> <value...> - set non-volatile data\n"
               "    nv0 is switcher timeout and nv1 is ROM bank to use\n"
               "set sw_bank <num>    - set ROM switcher timeout bank\n"
               "set sw_timeout <num> - set ROM switcher timeout in seconds\n");
        return (1);
    }
    if (strcmp(argv[1], "name") == 0) {
        char buf[16];
        int len = 0;
        int maxlen;
        memset(buf, 0, sizeof (buf));
        for (arg = 2; arg < argc; arg++) {
            int clen = strlen(argv[arg]);
            if (len > 0)
                buf[len++] = ' ';

            if (len + clen >= sizeof (buf)) {
                printf("Name too long: \"");
                for (arg = 2; arg < argc; arg++) {
                    if (arg != 2)
                        printf(" ");
                    printf("%s", argv[arg]);
                }
                printf("\"\n");
                return (1);
            }
            maxlen = sizeof (buf) - len;
            strncpy(buf + len, argv[arg], maxlen);
            len += clen;
        }
        buf[len] = '\0';
        rc = send_cmd(KS_CMD_SET | KS_SET_NAME, buf, sizeof (buf),
                      NULL, 0, NULL);
        if (rc != 0) {
            printf("Failed to set board name: (%s)\n", smash_err(rc));
        } else {
            printf("Set board name to \"%s\"\n", buf);
        }
        return (rc);
    } else if (strncmp(argv[1], "nv", 2) == 0) {
        char *ptr = argv[1] + 2;
        uint8_t buf[34];
        uint count = 2;
        int pos = 0;
        uint addr;
        uint argstart = 2;
        if (*ptr == '\0') {
            if (argstart >= argc) {
                printf("set %s requires an NV cell number\n", argv[1]);
                goto cmd_set_usage;
            }
            ptr = argv[argstart++];
        }

        if ((sscanf(ptr, "%u%n", &addr, &pos) != 1) ||
            (pos == 0) || (ptr[pos] != '\0') || (addr > 31)) {
            printf("Invalid argument \"%s\" for set\n", ptr);
            goto cmd_set_usage;
        }
        for (arg = argstart; arg < argc; arg++) {
            uint value;
            pos = 0;
            if (count >= sizeof (buf)) {
                printf("Too many values: %s\n", argv[arg]);
                return (1);
            }
            if ((sscanf(argv[arg], "%x%n", &value, &pos) != 1) ||
                (pos == 0) || (argv[arg][pos] != '\0') || (value > 0xff)) {
                printf("Invalid argument \"%s\" for set %s\n",
                       argv[arg], argv[1]);
                goto cmd_set_usage;
            }
            buf[count++] = value;
        }
        if (count == 2) {
            printf("You must specify at least one value to set\n");
            return (1);
        }
        if (addr + (count - 2) > 32) {
            printf("NV cells %u to %u are out of range (0 to 31)\n",
                   addr, addr + count - 3);
            return (1);
        }
        buf[0] = addr;
        buf[1] = count - 2;
        if (count & 1)
            buf[count] = 0;  // Pad byte sent when the length is odd
        rc = send_cmd(KS_CMD_SET | KS_SET_NV, buf, (count + 1) & ~1,
                      NULL, 0, NULL);
        if (rc != 0)
            printf("Failed to set NV data: (%s)\n", smash_err(rc));
        return (rc);
    } else if (strncmp(argv[1], "sw_bank", 4) == 0) {
        uint value;
        if (argc <= 2) {
            uint8_t nvdata[32];
            uint16_t what = 0x0010;  // Get 16 bytes of NV data
            uint     rlen;
            rc = send_cmd(KS_CMD_GET | KS_GET_NV, &what, sizeof (what),
                   nvdata, sizeof (nvdata), &rlen);
            if (rc != 0) {
                printf("Failed to get NV data: (%s)\n", smash_err(rc));
                return (rc);
            } else {
                value = nvdata[1];
                printf("%s %u\n", argv[1], value);
            }
        } else {
            uint8_t buf[4];
            uint bank = atoi(argv[2]);
            if (bank > 7) {
                printf("FAIL: Bank range is 0 to 7\n");
                return (1);
            }
            buf[0] = 1;
            buf[1] = 1;
            buf[2] = bank;
            buf[3] = 0;
            rc = send_cmd(KS_CMD_SET | KS_SET_NV, buf, sizeof (buf),
                          NULL, 0, NULL);
            if (rc != 0)
                printf("Failed to set NV data: (%s)\n", smash_err(rc));
            return (rc);
        }
    } else if (strncmp(argv[1], "sw_timeout", 4) == 0) {
        uint value;
        if (argc <= 2) {
            uint8_t nvdata[32];
            uint16_t what = 0x0010;  // Get 16 bytes of NV data
            uint     rlen;
            rc = send_cmd(KS_CMD_GET | KS_GET_NV, &what, sizeof (what),
                   nvdata, sizeof (nvdata), &rlen);
            if (rc != 0) {
                printf("Failed to get NV data: (%s)\n", smash_err(rc));
                return (rc);
            } else {
                value = nvdata[0];
                if (value & BIT(7))
                    value = (value & 0x7f) * 60;  // minutes
                printf("%s %u\n", argv[1], value);
            }
        } else {
            uint svalue = atoi(argv[2]);
            uint encoded;
            uint8_t buf[4];
            encoded = svalue;
            if (encoded > 127) {
                encoded /= 60;  // Encode as minutes
                if (encoded > 127)
                    encoded = 127;
                encoded |= BIT(7);
            }
            value = encoded;
            if (value & BIT(7))
                value = (value & 0x7f) * 60;  // minutes
            if (value != svalue) {
                printf("sw_timeout %u rounded to %u seconds\n",
                       svalue, value);
            }
            buf[0] = 0;
            buf[1] = 1;
            buf[2] = encoded;  // Store encoded value, not seconds
            buf[3] = 0;
            rc = send_cmd(KS_CMD_SET | KS_SET_NV, buf, sizeof (buf),
                          NULL, 0, NULL);
            if (rc != 0)
                printf("Failed to set NV data: (%s)\n", smash_err(rc));
            return (rc);
        }
    } else {
        printf("Unknown set %s\n", argv[1]);
        goto cmd_set_usage;
    }
    return (0);
}

/*
 * cmd_term
 * --------
 * Open a KickSmash terminal.
 */
static int
cmd_term(int argc, char *argv[])
{
    int ch;
    int arg;
    uint rlen;
    uint rc = 0;
    uint is_poll = 0;
    uint count = 0;
    ULONG ihandle = Input();
    __attribute__((aligned(4))) uint8_t buf[256];
    uint16_t maxlen = sizeof (buf) - 4;
    uint poll_delay = 0;
    uint poll_count = 0;
    uint interactive;
    uint tick_last = 0;
    uint tick_count = 0;
    uint tick_now;

    if (argc > 1) {
        interactive = 0;
        buf[0] = 'U' - '@';  // ^U
        buf[1] = '\n';       // ^M Return
        if (send_cmd_retry(KS_CMD_CONS_INPUT, buf, 2, NULL, 0, &rlen) != 0)
            return (1);
        buf[0] = ' ';  // ^M Return
        for (arg = 1; arg < argc; arg++) {
            if (send_cmd_retry(KS_CMD_CONS_INPUT, argv[arg],
                               strlen(argv[arg]), NULL, 0, &rlen) != 0) {
                return (1);
            }
            if (arg == argc - 1)
                buf[0] = '\n';  // ^M Return
            if (send_cmd_retry(KS_CMD_CONS_INPUT, buf, 1, NULL, 0, &rlen) != 0)
                return (1);
        }
    } else {
        interactive = 1;
        printf("Press ^X to exit\n");
        SetMode(Input(), 1);
    }
    setvbuf(stdout, NULL, _IONBF, 0);  // Raw output mode
    SetMode(Output(), 1);
    tick_last = cia_ticks();

#define KEY_CTRL_X 0x18
    while (1) {
        /* Poll for keystroke input */
        if (WaitForChar(ihandle, 0)) {
            if (Read(ihandle, buf, 1) <= 0) {  // 0=EOF, -1=error
                setvbuf(stdout, NULL, _IOLBF, 0);  // Line output mode
                printf("\nRead fail\n");
                break;
            }
            ch = buf[0];
            if (ch == KEY_CTRL_X) {
                printf("\n");
                break;
            }
            rc = send_cmd_retry(KS_CMD_CONS_INPUT, buf, 1, NULL, 0, &rlen);
            if (rc != 0)
                break;
        }

        tick_now = cia_ticks();  // CIA counts downward
        tick_count += (uint16_t) (tick_last - tick_now);
        tick_last = tick_now;
        if ((count++ & 0x7) != 0)
            continue;  // Poll infrequently for Kicksmash output

        if (poll_count < poll_delay) {
            poll_count++;
            continue;
        }
        poll_count = 0;

        /* Poll for Kicksmash output */
        maxlen = sizeof (buf) - 2;
        rc = send_cmd_retry(KS_CMD_CONS_OUTPUT, &maxlen, sizeof (maxlen),
                            buf, sizeof (buf), &rlen);
#if 0
        if (rc == MSG_STATUS_BAD_CRC) {
            uint pos;
            printf("[Bad CRC rc=%d l=%04x s=????", (int) rc, rlen);
            for (pos = 0; pos < rlen + 8; pos++)
                printf(" %02x", buf[pos]);
            printf("]\n");
        }
#endif
        if (rc != 0) {
            is_poll = 1;
            break;
        }
        if (rlen > 0) {
            count = 0;  // Got output -- poll again right away
            poll_delay = 0;
            tick_count = 0;
            if (Write(Output(), buf, rlen) != (LONG) rlen) {  // -1=error
                setvbuf(stdout, NULL, _IOLBF, 0);  // Line output mode
                printf("\nWrite fail\n");
                break;
            }
        } else {
            poll_delay++;
            if (!interactive && (tick_count > 800000)) {
                /* More than 1 second with no additional output */
                break;
            }
        }
    }

    /* Restore cooked mode */
    if (interactive)
        SetMode(Input(), 0);
    SetMode(Output(), 0);
    setvbuf(stdout, NULL, _IOLBF, 0);  // Line output mode

    if (rc != 0) {
        printf("\n%s Fail (%s)\n", is_poll ? "Poll" : "Send", smash_err(rc));
        return (EXIT_FAILURE);
    }
    return (0);
}

static int
OpenTimer(void)
{
    int rc;

    rc = OpenDevice((STRPTR)TIMERNAME, UNIT_MICROHZ,
                    (struct IORequest *) &TimeRequest, 0L);
    if (rc != 0) {
        printf("Timer open failed\n");
        return (rc);
    }

    TimerBase = (struct Device *) TimeRequest.tr_node.io_Device;
    return (0);
}

static void
CloseTimer(void)
{
    CloseDevice((struct IORequest *) &TimeRequest);
    TimerBase = NULL;
}

static void
setsystime(uint sec, uint usec)
{
    TimeRequest.tr_node.io_Command = TR_SETSYSTIME;
    TimeRequest.tr_time.tv_secs = sec;
    TimeRequest.tr_time.tv_micro = usec;
    DoIO((struct IORequest *) &TimeRequest);
}

static uint
getsystime(uint *usec)
{
    TimeRequest.tr_node.io_Command = TR_GETSYSTIME;
    DoIO((struct IORequest *) &TimeRequest);
    *usec = TimeRequest.tr_time.tv_micro;
    return (TimeRequest.tr_time.tv_secs);
}

static void
showdatestamp(struct DateStamp *ds, uint usec)
{
    struct DateTime  dtime;
    char             datebuf[32];
    char             timebuf[32];

    dtime.dat_Stamp.ds_Days   = ds->ds_Days;
    dtime.dat_Stamp.ds_Minute = ds->ds_Minute;
    dtime.dat_Stamp.ds_Tick   = ds->ds_Tick;
    dtime.dat_Format          = FORMAT_DOS;
    dtime.dat_Flags           = 0x0;
    dtime.dat_StrDay          = NULL;
    dtime.dat_StrDate         = datebuf;
    dtime.dat_StrTime         = timebuf;
    DateToStr(&dtime);
    printf("%s %s.%06u\n", datebuf, timebuf, usec);
}

static void
showsystime(uint sec, uint usec)
{
    struct DateStamp ds;
    uint min  = sec / 60;
    uint day  = min / (24 * 60);

    ds.ds_Days   = day;
    ds.ds_Minute = min % (24 * 60);
    ds.ds_Tick   = (sec % 60) * TICKS_PER_SECOND;
    showdatestamp(&ds, usec);
}

uint
get_ks_clock(uint *sec, uint *usec)
{
    uint ks_clock[2];
    uint rc;
    uint rlen;

    rc = send_cmd(KS_CMD_CLOCK, NULL, 0, &ks_clock, sizeof (ks_clock), &rlen);
    if (rc != 0) {
        printf("Get clock failed: (%s)\n", smash_err(rc));
        if (flag_debug)
            dump_memory(ks_clock, sizeof (ks_clock), DUMP_VALUE_UNASSIGNED);
        *sec = 0;
        *usec = 0;
    } else {
        *sec  = ks_clock[0];
        *usec = ks_clock[1];
    }
    return (rc);
}

uint
set_ks_clock(uint sec, uint usec, uint flags)
{
    uint cmd = KS_CMD_CLOCK | (flags ? KS_CLOCK_SET_IFNOT : KS_CLOCK_SET);
    uint ks_clock[2];
    uint rc;

    ks_clock[0] = sec;
    ks_clock[1] = usec;

    rc = send_cmd(cmd, ks_clock, sizeof (ks_clock), NULL, 0, NULL);
    if (rc != 0)
        printf("Set clock failed: (%s)\n", smash_err(rc));
    return (rc);
}

uint
get_host_clock(uint *sec, uint *usec)
{
    hm_clock_t hm;
    hm_clock_t *hmr;
    uint rc;
    uint rlen;

    memset(&hm, 0, sizeof (hm));  // Clock get
    hm.hm_hdr.km_op = KM_OP_CLOCK;

    rc = host_msg(&hm, sizeof (hm), (void **) &hmr, &rlen);
    if (rc != 0) {
        printf("Get clock failed: (%s)\n", smash_err(rc));
        if (flag_debug)
            dump_memory(&hm, sizeof (hm), DUMP_VALUE_UNASSIGNED);
        *sec = 0;
        *usec = 0;
    } else {
        *sec  = hmr->hm_sec;
        *usec = hmr->hm_usec;
    }
    return (rc);
}

static int
cmd_clock(int argc, char *argv[])
{
    int         arg;
    uint        rc = 1;
    uint        flag_load = 0;
    uint        flag_load_host = 0;
    uint        flag_load_if_set = 0;
    uint        flag_save = 0;
    uint        flag_save_if_not_set = 0;
    uint        flag_show = 0;
    uint        flag_show_host = 0;
    uint        sec;
    uint        usec;
    const char *ptr;
    for (arg = 1; arg < argc; ) {
        ptr = long_to_short(argv[arg++], long_to_short_clock,
                            ARRAY_SIZE(long_to_short_clock));
        if (*ptr == '-') {
            for (++ptr; *ptr != '\0'; ptr++) {
                switch (*ptr) {
                    case 'h':  // load
                        goto usage;
                    case 'k':  // load if set
                        flag_load_if_set++;
                        break;
                    case 'l':  // load
                        flag_load++;
                        break;
                    case 'n':  // save if not set
                        flag_save_if_not_set++;
                        break;
                    case 's':  // save
                        flag_save++;
                        break;
                    case 'S':  // show
                        flag_show++;
                        break;
                    case 'u':  // load clock from from USB host
                        flag_load_host++;
                        break;
                    case 'U':  // show clock of USB host
                        flag_show_host++;
                        break;
                    default:
                        printf("Unknown argument %s \"-%s\"\n",
                               argv[0], ptr);
                        goto usage;
                }
            }
        } else {
            printf("Unknown argument %s \"%s\"\n",
                   argv[0], ptr);
usage:
            printf("%s", cmd_clock_options);
            return (rc);
        }
    }
    if ((flag_load == 0) && (flag_load_if_set == 0) &&
        (flag_save == 0) && (flag_save_if_not_set == 0) &&
        (flag_load_host == 0))
        flag_show++;

    if (flag_load || flag_load_host || flag_load_if_set) {
        if (flag_load_host) {
            if ((rc = get_host_clock(&sec, &usec)) != 0)
                return (rc);
        } else {
            if ((rc = get_ks_clock(&sec, &usec)) != 0)
                return (rc);
        }
        if ((sec == 0) && (usec == 0)) {
            if (flag_load_if_set)
                return (0);
            printf("KS does not know the current time\n");
            return (1);
        }
        showsystime(sec, usec);
        if (OpenTimer())
            return (1);
        setsystime(sec, usec);
        CloseTimer();
    }
    if (flag_save || flag_save_if_not_set) {
        if (OpenTimer())
            return (1);
        sec = getsystime(&usec);
        CloseTimer();
        showsystime(sec, usec);
        if ((rc = set_ks_clock(sec, usec, flag_save_if_not_set)) != 0)
            return (rc);
    }
    if (flag_show || flag_show_host) {
        if (flag_show_host) {
            if ((rc = get_host_clock(&sec, &usec)) != 0)
                return (rc);
        } else {
            if ((rc = get_ks_clock(&sec, &usec)) != 0)
                return (rc);
        }
        if ((sec == 0) && (usec == 0)) {
            printf("KS does not know the current time\n");
            return (1);
        }
        showsystime(sec, usec);
    }
    return (0);
}

/*
 * sem_owner_name() copies the name of a semaphore's owning task into the
 *                  provided buffer. Must be called under Forbid() so that
 *                  the owner task can't go away while its name is copied.
 */
static void
sem_owner_name(const struct SignalSemaphore *sem, char *buf, uint buflen)
{
    const struct Task *owner = sem->ss_Owner;
    const char        *name;

    buf[0] = '\0';
    if (owner == NULL)
        return;
    name = owner->tc_Node.ln_Name;
    if (name == NULL)
        name = "(unnamed)";
    strncpy(buf, name, buflen - 1);
    buf[buflen - 1] = '\0';
}

/*
 * show_signal_semaphore() displays the fields of a SignalSemaphore snapshot.
 */
static void
show_signal_semaphore(const char *label, const struct SignalSemaphore *sem,
                      const char *owner_name)
{
    printf("  %s\n", label);
    printf("    ss_NestCount   %d\n", (int) sem->ss_NestCount);
    printf("    ss_QueueCount  %d%s\n", (int) sem->ss_QueueCount,
           (sem->ss_QueueCount < 0) ? " (unowned)" : "");
    printf("    ss_Owner       %08x", (uint) sem->ss_Owner);
    if (sem->ss_Owner != NULL)
        printf(" \"%s\"", owner_name);
    printf("\n");
}

/*
 * cmd_debugq() locates the shared "smashmsg" semaphore (without creating
 *              it) and displays all fields of the message semaphore
 *              structure, followed by every message waiting in the reply
 *              queue. For debug purposes.
 *
 * The structure is kept alive while it is displayed by holding ms_sem
 * shared: the last owner must obtain ms_sem (exclusive) before it can free
 * the structure. Receivers in other programs will block on ms_sem until
 * this function is done. The shared hold is taken with
 * AttemptSemaphoreShared() inside the same Forbid() as FindSemaphore(),
 * so the structure can't be freed between finding and locking it.
 */
#define SMASHMSG_SEM_NAME    "smashmsg"  // Must match sm_msg.c
#define DEBUGQ_LOCK_TRIES    250         // Ticks to wait for ms_sem (5 sec)
#define DEBUGQ_MAX_NODES     1000        // Guard against a looping list
static int
cmd_debugq(void)
{
    msg_semaphore_t   snap;
    msg_semaphore_t  *hdr;
    msg_buf_t        *node;
    msg_buf_t        *next_node;
    char              owner_main[32];
    char              owner_queue[32];
    char              sem_name[32];
    uint              tries;
    uint              count = 0;
    uint              total_len = 0;
    uint              held = 0;

    for (tries = 0; ; tries++) {
        Forbid();
        hdr = (msg_semaphore_t *) FindSemaphore((STRPTR) SMASHMSG_SEM_NAME);
        if (hdr == NULL) {
            Permit();
            printf("No \"%s\" semaphore present\n", SMASHMSG_SEM_NAME);
            return (1);
        }
        if ((hdr->ms_version != MSG_SEM_VERSION) ||
            (hdr->ms_allocsize != sizeof (*hdr))) {
            uint ver  = hdr->ms_version;
            uint size = hdr->ms_allocsize;
            Permit();
            printf("\"%s\" at %08x has version %u size %u; this program "
                   "expects version %u size %u\n", SMASHMSG_SEM_NAME,
                   (uint) hdr, ver, size, MSG_SEM_VERSION,
                   (uint) sizeof (*hdr));
            return (1);
        }

        /* Consistent snapshot of all fields, before taking any lock */
        CopyMem(hdr, &snap, sizeof (snap));
        sem_owner_name(&hdr->ms_sem, owner_main, sizeof (owner_main));
        sem_owner_name(&hdr->ms_queue_lock, owner_queue,
                       sizeof (owner_queue));
        if (hdr->ms_sem.ss_Link.ln_Name != NULL) {
            strncpy(sem_name, hdr->ms_sem.ss_Link.ln_Name,
                    sizeof (sem_name) - 1);
            sem_name[sizeof (sem_name) - 1] = '\0';
        } else {
            strcpy(sem_name, "(null)");
        }

        /* AttemptSemaphoreShared() never waits, so Forbid() is kept */
        if (AttemptSemaphoreShared(&hdr->ms_sem))
            break;
        Permit();

        if (tries >= DEBUGQ_LOCK_TRIES) {
            printf("Timeout waiting for \"%s\" (owner \"%s\")\n",
                   SMASHMSG_SEM_NAME, owner_main);
            return (1);
        }
        Delay(1);  // A receiver holds ms_sem; let it finish its poll
    }
    Permit();

    printf("Semaphore \"%s\" at %08x\n", sem_name, (uint) hdr);
    printf("  ln_Pri           %d\n", (int) snap.ms_sem.ss_Link.ln_Pri);
    show_signal_semaphore("ms_sem", &snap.ms_sem, owner_main);
    printf("  ms_version       %u\n", (uint) snap.ms_version);
    printf("  ms_tag           %04x\n", (uint) snap.ms_tag);
    printf("  ms_tag_count     %u\n", (uint) snap.ms_tag_count);
    printf("  ms_refcount      %u\n", (uint) snap.ms_refcount);
    printf("  ms_busy          %u\n", (uint) snap.ms_busy);
    printf("  ms_allocsize     %u\n", (uint) snap.ms_allocsize);
    show_signal_semaphore("ms_queue_lock", &snap.ms_queue_lock, owner_queue);
    printf("  ms_queue_list    head=%08x tail=%08x tailpred=%08x\n",
           (uint) snap.ms_queue_list.mlh_Head,
           (uint) snap.ms_queue_list.mlh_Tail,
           (uint) snap.ms_queue_list.mlh_TailPred);
    printf("  ms_free_list     head=%08x tail=%08x tailpred=%08x\n",
           (uint) snap.ms_free_list.mlh_Head,
           (uint) snap.ms_free_list.mlh_Tail,
           (uint) snap.ms_free_list.mlh_TailPred);
    printf("  ms_held_list     head=%08x tail=%08x tailpred=%08x\n",
           (uint) snap.ms_held_list.mlh_Head,
           (uint) snap.ms_held_list.mlh_Tail,
           (uint) snap.ms_held_list.mlh_TailPred);
    printf("  ms_free_count    %u\n", (uint) snap.ms_free_count);
    printf("  ms_nread_tag_cur  %04x%s\n", (uint) snap.ms_nread_tag_cur,
           snap.ms_nread_tag_cur_valid ? "" : " (not valid)");
    printf("  ms_nread_tag_prev %04x%s\n", (uint) snap.ms_nread_tag_prev,
           snap.ms_nread_tag_prev_valid ? "" : " (not valid)");

    /* Walk the reply queue while holding its lock (ms_sem then queue lock) */
    ObtainSemaphore(&hdr->ms_queue_lock);
    printf("Reply queue\n");
    for (node = (msg_buf_t *) hdr->ms_queue_list.mlh_Head;
         (next_node = (msg_buf_t *) node->mb_node.mln_Succ) != NULL;
         node = next_node) {
        km_msg_hdr_t *km = (km_msg_hdr_t *) node->mb_data;

        if (count == 0) {
            printf("  %-4s %-8s %-6s %-5s %-6s %-6s %s\n",
                   "Num", "Buf", "km_tag", "km_op", "status",
                   "q_tag", "Len");
        }
        printf("  %-4u %08x ", count, (uint) node);
        printf("%04x   %02x    %02x     ",
               (uint) km->km_tag, (uint) km->km_op,
               (uint) km->km_status);
        printf("%04x   %u\n", (uint) node->mb_tag, (uint) node->mb_len);
        total_len += node->mb_len;

        if (++count >= DEBUGQ_MAX_NODES) {
            printf("  Stopping after %u entries (list may be corrupt)\n",
                   count);
            break;
        }
    }

    /* Buffers delivered to tasks and still considered in use */
    printf("Held buffers\n");
    for (node = (msg_buf_t *) hdr->ms_held_list.mlh_Head;
         (next_node = (msg_buf_t *) node->mb_node.mln_Succ) != NULL;
         node = next_node) {
        km_msg_hdr_t *km = (km_msg_hdr_t *) node->mb_data;

        if (held == 0) {
            printf("  %-4s %-8s %-8s %-8s %-6s %-5s\n",
                   "Num", "Buf", "Task", "Prog", "km_tag", "km_op");
        }
        printf("  %-4u %08x %08x %08x %04x   %02x\n", held, (uint) node,
               (uint) node->mb_owner, (uint) node->mb_prog,
               (uint) km->km_tag, (uint) km->km_op);
        if (++held >= DEBUGQ_MAX_NODES) {
            printf("  Stopping after %u entries (list may be corrupt)\n",
                   held);
            break;
        }
    }
    if (held == 0)
        printf("  (none)\n");
    ReleaseSemaphore(&hdr->ms_queue_lock);
    ReleaseSemaphore(&hdr->ms_sem);

    printf("Reply queue:");
    if (count == 0)
        printf(" (empty)\n");
    else
        printf(" %u message%s, %u bytes\n",
               count, (count == 1) ? "" : "s", total_len);
    return (0);
}

#define FW_READ_CHUNK     2048         // Matches firmware FW_READ_MAX
#define FW_READ_DOTS      32           // Width of firmware progress bar
#define FW_READ_RETRIES   5            // Attempts per firmware read transfer
#define FW_INFO_MAGIC     0x4b534657   // "KSFW" firmware info (fw/main.h)
#define FW_INFO_MIN_SIZE  20           // Minimum firmware info struct size
#define STM32_FLASH_BASE  0x08000000   // Kicksmash flash address of firmware

int are_you_sure(const char *prompt);

/*
 * fw_le32
 * -------
 * Returns the little-endian (STM32 order) 32-bit value at the specified
 * buffer location.
 */
static uint32_t
fw_le32(const uint8_t *buf)
{
    return (buf[0] | (buf[1] << 8) | (buf[2] << 16) |
            ((uint32_t) buf[3] << 24));
}

/*
 * fw_in_updater
 * -------------
 * Returns non-zero if the Kicksmash ID indicates that the firmware updater
 * is running instead of the normal Kicksmash firmware.
 */
static int
fw_in_updater(const smash_id_t *id)
{
    return ((id->si_features & SID_FEATURE_FW_UPDATE) != 0);
}

/*
 * fw_read_chunk
 * -------------
 * Read up to FW_READ_CHUNK bytes of Kicksmash firmware at the specified
 * offset using KS_CMD_FW_READ. The reply header is placed at the start of
 * rbuf, which must be sizeof (ks_fw_rw_t) + FW_READ_CHUNK bytes, followed
 * by the data. Kicksmash may return less data than requested.
 *
 * Returns the number of bytes read, or 0 on failure.
 */
static uint
fw_read_chunk(uint offset, uint fw_size, uint8_t *rbuf, uint *retries)
{
    ks_fw_rw_t  req;
    ks_fw_rw_t *rhdr = (ks_fw_rw_t *) rbuf;
    uint        rbuf_size = sizeof (ks_fw_rw_t) + FW_READ_CHUNK;
    uint        rlen = 0;
    uint        len;
    uint        rc = 0;
    uint        tries;

    memset(&req, 0, sizeof (req));
    req.kfrw_offset = offset;
    len = fw_size - offset;
    if (len > FW_READ_CHUNK)
        len = FW_READ_CHUNK;
    req.kfrw_size = len;

    /* Reads have no side effects, so retry any failure */
    for (tries = 0; tries < FW_READ_RETRIES; tries++) {
        rc = send_cmd_retry(KS_CMD_FW_READ, &req, sizeof (req),
                            rbuf, rbuf_size, &rlen);
        if (rc == 0)
            break;
        (*retries)++;
        if (flag_debug)
            printf("\nFW read at offset 0x%x retry: (%s)\n",
                   offset, smash_err(rc));
        if (is_user_abort())
            break;
    }
    if (rc != 0) {
        printf("\nFW read at offset 0x%x failed: (%s)\n",
               offset, smash_err(rc));
        return (0);
    }
    len = rhdr->kfrw_size;
    if ((rlen < sizeof (*rhdr)) || (len == 0) ||
        (len > rlen - sizeof (*rhdr)) || (len > fw_size - offset) ||
        (rhdr->kfrw_offset != offset)) {
        printf("\nFW read at offset 0x%x bad reply: "
               "rlen=%u offset=0x%x size=%u\n",
               offset, rlen, (uint) rhdr->kfrw_offset, len);
        return (0);
    }
    return (len);
}

/*
 * fw_progress
 * -----------
 * Advance a firmware operation progress bar.
 */
static void
fw_progress(uint done, uint total, uint *dots)
{
    uint dots_now = done * FW_READ_DOTS / total;

    if ((flag_quiet == 0) && (dots_now > *dots)) {
        for (; *dots < dots_now; (*dots)++)
            printf(".");
        fflush(stdout);
    }
}

/*
 * fw_progress_start
 * -----------------
 * Display an empty firmware operation progress bar.
 */
static void
fw_progress_start(const char *what)
{
    if (flag_quiet == 0) {
        printf("%s [%*s]\r%s [", what, FW_READ_DOTS, "", what);
        fflush(stdout);
    }
}

/*
 * fw_progress_end
 * ---------------
 * Complete a firmware operation progress bar.
 */
static void
fw_progress_end(int errs)
{
    if (flag_quiet == 0) {
        if (errs == 0)
            printf("]");
        printf("\n");
    }
}

/*
 * fw_show_rate
 * ------------
 * Display the transfer rate and time of a firmware operation.
 */
static void
fw_show_rate(uint64_t time_start, uint64_t time_end, uint bytes)
{
    if ((time_start != 0) && (time_end > time_start)) {
        printf(" (%u KB/sec) in ",
               calc_kb_sec((uint) (time_end - time_start), bytes));
        print_us_diff(time_start, time_end);
    } else {
        printf("\n");
    }
}

/*
 * fw_identify
 * -----------
 * Issue KS_CMD_ID to Kicksmash.
 */
static uint
fw_identify(smash_id_t *id)
{
    uint rlen;
    uint rc;

    memset(id, 0, sizeof (*id));
    rc = send_cmd_retry(KS_CMD_ID, NULL, 0, id, sizeof (*id), &rlen);
    if (rc != 0)
        printf("Kicksmash ID failure: (%s)\n", smash_err(rc));
    return (rc);
}

/*
 * cmd_fwread
 * ----------
 * Read the running Kicksmash firmware image and write it to the specified
 * file. The firmware size is acquired by KS_CMD_ID. Kicksmash may return
 * less data per KS_CMD_FW_READ than requested.
 */
static int
cmd_fwread(int argc, char *argv[])
{
    const char *filename;
    smash_id_t  id;
    uint8_t    *rbuf;
    uint        offset;
    uint        fw_size;
    uint        rbuf_size = sizeof (ks_fw_rw_t) + FW_READ_CHUNK;
    uint        len;
    uint        retries = 0;
    uint        dots = 0;
    uint64_t    time_start;
    uint64_t    time_end;
    int         errs = 0;
    BPTR        lock;
    FILE       *fp = NULL;

    if (argc < 2) {
        printf("fwread requires a filename argument\n");
        return (1);
    }
    filename = argv[1];

    lock = Lock(filename, ACCESS_READ);
    if (lock != 0L) {
        char prompt[80];
        UnLock(lock);
        snprintf(prompt, sizeof (prompt), "Overwrite existing %s", filename);
        if (!flag_yes && !are_you_sure(prompt))
            return (1);
    }

    if (fw_identify(&id) != 0)
        return (1);
    fw_size = id.si_size;
    if (fw_size == 0) {
        printf("Kicksmash reported firmware size 0 "
               "(firmware may be too old)\n");
        return (1);
    }

    rbuf = AllocMem(rbuf_size, MEMF_PUBLIC);
    if (rbuf == NULL) {
        printf("Failed to allocate %u bytes\n", rbuf_size);
        return (1);
    }

    fw_progress_start("Reading");
    time_start = smash_time();

    for (offset = 0; offset < fw_size; offset += len) {
        if (is_user_abort()) {
            errs++;
            break;
        }
        len = fw_read_chunk(offset, fw_size, rbuf, &retries);
        if (len == 0) {
            errs++;
            break;
        }
        /* Don't create the file until Kicksmash has provided data */
        if (fp == NULL) {
            fp = fopen(filename, "wb");
            if (fp == NULL) {
                printf("\nFailed to open %s for write\n", filename);
                errs++;
                break;
            }
        }
        if (fwrite(rbuf + sizeof (ks_fw_rw_t), 1, len, fp) != len) {
            printf("\nWrite to %s failed\n", filename);
            errs++;
            break;
        }
        fw_progress(offset + len, fw_size, &dots);
    }
    time_end = smash_time();
    fw_progress_end(errs);

    if ((fp != NULL) && (fclose(fp) != 0)) {
        printf("Close of %s failed\n", filename);
        errs++;
    }
    FreeMem(rbuf, rbuf_size);

    if (errs == 0) {
        printf("Read %u bytes of firmware to %s", fw_size, filename);
        fw_show_rate(time_start, time_end, fw_size);
    }
    if (retries != 0)
        printf("%u read retries were required\n", retries);
    return (errs ? 1 : 0);
}

/*
 * fw_file_identify
 * ----------------
 * Locate the firmware info structure (FW_INFO_MAGIC) in a firmware image
 * read from disk, then fill in the version, build date/time, and size
 * fields of the supplied smash_id_t from it, as KS_CMD_ID would report
 * for that firmware.
 *
 * Returns 0 on success, 1 if the image does not appear to be valid.
 */
static int
fw_file_identify(const uint8_t *buf, uint buf_size, smash_id_t *id)
{
    uint        off;
    uint        vptr_off;
    uint        str_off = 0;
    uint        ver[2];
    uint        date[3];
    uint        time[3];
    uint32_t    fi_struct_size;
    uint32_t    fi_fw_size = 0;
    const char *str;
    const char *built;

    for (off = 0; off + FW_INFO_MIN_SIZE <= buf_size; off += 4) {
        if (fw_le32(buf + off) != FW_INFO_MAGIC)
            continue;
        fi_struct_size = fw_le32(buf + off + 4);
        fi_fw_size     = fw_le32(buf + off + 16);
        if ((fw_le32(buf + off + 8) == STM32_FLASH_BASE + off) &&
            (fi_struct_size >= FW_INFO_MIN_SIZE) &&
            (fi_fw_size <= buf_size) &&
            (off + fi_struct_size <= fi_fw_size)) {
            break;
        }
    }
    if (off + FW_INFO_MIN_SIZE > buf_size) {
        printf("Firmware info not found in file\n");
        return (1);
    }

    /* fi_version_str is the flash address of a pointer to version_str */
    vptr_off = fw_le32(buf + off + 12) - STM32_FLASH_BASE;
    if ((vptr_off > buf_size - 4) ||
        ((str_off = fw_le32(buf + vptr_off) - STM32_FLASH_BASE) >=
         buf_size) ||
        (memchr(buf + str_off, '\0', buf_size - str_off) == NULL)) {
        printf("Firmware version string not found in file\n");
        return (1);
    }

    /* Format: "Version 2.1+ built YYYY-MM-DD HH:MM:SS" */
    str = (const char *) buf + str_off;
    built = strstr(str, " built ");
    if ((sscanf(str, "Version %u.%u", &ver[0], &ver[1]) != 2) ||
        (built == NULL) ||
        (sscanf(built, " built %u-%u-%u %u:%u:%u", &date[0], &date[1],
                &date[2], &time[0], &time[1], &time[2]) != 6)) {
        printf("Could not parse firmware version \"%s\"\n", str);
        return (1);
    }

    memset(id, 0, sizeof (*id));
    id->si_ks_version[0] = ver[0];
    id->si_ks_version[1] = ver[1];
    id->si_ks_date[0]    = date[0] / 100;
    id->si_ks_date[1]    = date[0] % 100;
    id->si_ks_date[2]    = date[1];
    id->si_ks_date[3]    = date[2];
    id->si_ks_time[0]    = time[0];
    id->si_ks_time[1]    = time[1];
    id->si_ks_time[2]    = time[2];
    id->si_size          = fi_fw_size;
    return (0);
}

/*
 * fw_id_show
 * ----------
 * Display firmware version, build date/time, and size from a smash_id_t.
 */
static void
fw_id_show(const char *what, const smash_id_t *id)
{
    printf("%-8s Kicksmash %u.%u built %02u%02u-%02u-%02u %02u:%02u:%02u  "
           "Size %u\n", what,
           id->si_ks_version[0], id->si_ks_version[1],
           id->si_ks_date[0], id->si_ks_date[1],
           id->si_ks_date[2], id->si_ks_date[3],
           id->si_ks_time[0], id->si_ks_time[1], id->si_ks_time[2],
           (uint) id->si_size);
}

/*
 * fw_id_match
 * -----------
 * Returns TRUE if the firmware identity fields of two smash_id_t match.
 */
static int
fw_id_match(const smash_id_t *id1, const smash_id_t *id2)
{
    return ((memcmp(id1->si_ks_version, id2->si_ks_version,
                    sizeof (id1->si_ks_version)) == 0) &&
            (memcmp(id1->si_ks_date, id2->si_ks_date,
                    sizeof (id1->si_ks_date)) == 0) &&
            (memcmp(id1->si_ks_time, id2->si_ks_time, 3) == 0) &&
            (id1->si_size == id2->si_size));
}
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
int
main(int argc, char *argv[])
{
    int      arg;
    uint     loop;
    uint     loops = 1;
    uint     flag_inquiry = 0;
    uint     flag_test = 0;
    uint     flag_test_mask = 0;
    uint     flag_x_spin = 0;
    uint     flag_y_spin = 0;
    int      pos;
    uint     errs = 0;
    uint     do_multiple = 0;
    uint32_t addr;

#pragma GCC diagnostic push
#pragma GCC diagnostic ignored "-Warray-bounds="
    SysBase = *(struct ExecBase **)4UL;
#pragma GCC diagnostic pop
    cpu_control_init();  // cpu_type, SysBase

    rom_get_normal();  // Get Kickstart ROM

    for (arg = 1; arg < argc; arg++) {
        const char *ptr;
        ptr = long_to_short(argv[arg], long_to_short_main,
                            ARRAY_SIZE(long_to_short_main));
        if (*ptr == '-') {
            for (++ptr; *ptr != '\0'; ptr++) {
                switch (*ptr) {
                    case 'b':  // bank
                        exit(exit_status(cmd_bank(argc - arg, argv + arg)));
                    case 'c':  // clock
                        exit(exit_status(cmd_clock(argc - arg, argv + arg)));
                    case 'C':  // conservative
                        flag_conservative_mode ^= 1;
                        break;
                    case 'd':  // debug
                        flag_debug++;
                        break;
                    case 'e':  // erase flash
                        exit(exit_status(cmd_erase(argc - arg, argv + arg)));
                        break;
                    case 'i':  // inquiry
                        flag_inquiry++;
                        break;
                    case 'l':  // loop count
                        if (++arg >= argc) {
                            printf("%s requires an argument\n", ptr);
                            exit(1);
                        }
                        loops = atoi(argv[arg]);
                        break;
                    case 'q':  // quiet
                        flag_quiet++;
                        break;
                    case 'Q':  // debugq: show message semaphore and queue
                        exit(exit_status(cmd_debugq()));
                    case 'R':  // read Kicksmash firmware to file
                        exit(exit_status(cmd_fwread(argc - arg, argv + arg)));
                    case 'V':  // verify Kicksmash firmware with file
                        exit(exit_status(cmd_fwverify(argc - arg,
                                                      argv + arg)));
                    case 'W':  // write Kicksmash firmware from file
                        exit(exit_status(cmd_fwwrite(argc - arg, argv + arg)));
                    case 'r':  // read flash to file
                        exit(exit_status(cmd_readwrite(argc - arg, argv + arg)));
                        break;
                    case 's':  // set
                        exit(exit_status(cmd_set(argc - arg, argv + arg)));
                        break;
                    case 'S':  // spin
                        spin(MEM_LOOPS);
                        exit(0);
                    case '0':  // pattern test
                    case '1':  // loopback test
                    case '2':  // loopback perf test
                    case '3':  // Message buffer loopback test
                    case '4':  // Remote USB host message loopback test
                    case '5':  // Flash ID
                    case '6':  // Commands
                        flag_test_mask |= BIT(*ptr - '0');
                        flag_test++;
                        break;
                    case 't':  // test
                        flag_test++;
                        break;
                    case 'T':  // Kicksmash firmware terminal
                        exit(exit_status(cmd_term(argc - arg, argv + arg)));
                        break;
                    case 'v':  // verify file with flash
                        exit(exit_status(cmd_readwrite(argc - arg, argv + arg)));
                        break;
                    case 'w':  // write file to flash
                        exit(exit_status(cmd_readwrite(argc - arg, argv + arg)));
                        break;
                    case 'X':  // spin reading address
                        if (++arg >= argc) {
                            printf("%s requires an argument\n", ptr);
                            exit(1);
                        }

                        pos = 0;
                        if ((sscanf(argv[arg], "%x%n", &addr, &pos) != 1) ||
                            (pos == 0)) {
                            printf("Invalid argument \"%s\" for -%c\n",
                                   argv[arg], *ptr);
                            exit(1);
                        }
                        flag_x_spin = 1;
                        break;
                    case 'Y':  // spin reading address with ROM overlay set
                        if (++arg >= argc) {
                            printf("%s requires an argument\n", ptr);
                            exit(1);
                        }

                        pos = 0;
                        if ((sscanf(argv[arg], "%x%n", &addr, &pos) != 1) ||
                            (pos == 0)) {
                            printf("Invalid argument \"%s\" for -%c\n",
                                   argv[arg], *ptr);
                            exit(1);
                        }
                        flag_y_spin = 1;
                        break;
                    case 'y':  // yes
                        flag_yes++;
                        break;
                    default:
                        printf("Unknown argument %s\n", ptr);
                        usage();
                        exit(1);
                }
            }
        } else if ((*ptr >= '0') && (*ptr <= '6') && (ptr[1] == '\0')) {
            flag_test_mask |= BIT(*ptr - '0');
            flag_test++;
        } else {
            printf("Error: unknown argument %s\n", ptr);
            usage();
            exit(1);
        }
    }

    if ((flag_inquiry | flag_test | flag_x_spin | flag_y_spin) == 0) {
        printf("You must specify an operation to perform\n");
        usage();
        exit(1);
    }
    if (flag_test_mask == 0)
        flag_test_mask = ~0;
    if (flag_test) {
        srand32(time(NULL));
        test_loopback_buf = AllocMem(TEST_LOOPBACK_BUF * 2, MEMF_PUBLIC);
        if (test_loopback_buf == NULL) {
            printf("Memory allocation failure\n");
            exit(1);
        }
        if (flag_test_mask & (flag_test_mask - 1))
            do_multiple = 1;
    }
    if (flag_inquiry & (flag_inquiry - 1))
        do_multiple = 1;
    if (!!flag_test + !!flag_inquiry + !!flag_x_spin + !!flag_y_spin > 1)
        do_multiple = 1;

    for (loop = 0; loop < loops; loop++) {
        if (loops > 1) {
            if (flag_quiet) {
                if ((loop & 0xff) == 0) {
                    printf(".");
                    fflush(stdout);
                }
            } else {
                printf("Pass %-4u ", loop + 1);
                if (do_multiple)
                    printf("\n");
            }
        }
        if (flag_x_spin) {
            spin_memory(addr);
        }
        if (flag_y_spin) {
            spin_memory_ovl(addr);
        }
        if (flag_inquiry) {
            if ((flag_inquiry & 1) &&
                smash_identify() && ((loops == 1) || (loop > 1))) {
                errs++;
                break;
            }
            if ((flag_inquiry & 2) &&
                flash_show_id() && ((loops == 1) || (loop > 1))) {
                errs++;
                break;
            }
        }
        if (flag_test) {
            if (smash_test(flag_test_mask) && ((loops == 1) || (loop > 1))) {
                errs++;
                break;
            }
        }
        if (is_user_abort())
            goto end_now;
    }
    if (loop < loops) {
        printf("Failed");
end_now:
        if (loops > 1)
            printf(" at pass %u", loop + 1);
        if (errs != 0)
            printf(" (%u errors)", errs);
        printf("\n");
    } else if (flag_quiet && (errs == 0)) {
        printf("Pass %u done\n", loop);
    }
    if (test_loopback_buf != NULL)
        FreeMem(test_loopback_buf, TEST_LOOPBACK_BUF * 2);

    exit(errs ? RETURN_FAIL : RETURN_OK);
}
