cdhooper/kicksmash32/romswitcher/main.c

/*
 * Start-up code and board initialization.
 *
 * This source file is part of the code base for a simple Amiga ROM
 * replacement sufficient to allow programs using some parts of GadTools
 * to function.
 *
 * Copyright 2025 Chris Hooper. This program and source may be used
 * and distributed freely, for any purpose which benefits the Amiga
 * community. All redistributions must retain this Copyright notice.
 *
 * DISCLAIMER: THE SOFTWARE IS PROVIDED "AS-IS", WITHOUT ANY WARRANTY.
 * THE AUTHOR ASSUMES NO LIABILITY FOR ANY DAMAGE ARISING OUT OF THE USE
 * OR MISUSE OF THIS UTILITY OR INFORMATION REPORTED BY THIS UTILITY.
 */
#include <stdint.h>
#include <string.h>
#include "amiga_chipset.h"
#include "cache.h"
#include "keyboard.h"
#include "serial.h"
#include "med_cmdline.h"
#include "med_readline.h"
#include "cpu_control.h"
#include "mouse.h"
#include "autoconfig.h"
#include "picassoiv.h"
#include "testdraw.h"
#include "testgadget.h"
#include "printf.h"
#include "screen.h"
#include "audio.h"
#include "timer.h"
#include "util.h"
#include "vectors.h"
#include "main.h"

/*
 * Memory map
 *    0x00000120    [0x50] register save area
 *    0x00000200   [0x100] vectors
 *    0x00001000    [0x80] runtime counters
 *    0x00001080    [0x80] sprite data
 *    0x00001100  [0xff00] stack
 *    0x00010000 [0x10000] bsschip
 *    0x00020000  [0x5000] bitplane 0
 *    0x00025000  [0x5000] bitplane 1
 *    0x0002a000  [0x5000] bitplane 2
 *    0x00030000 [0x10000] globals
 *    0x00040000 [0x10000] malloc RAM
 *
 * XXX: The 0x120 and 0x200 areas need to be reconsidered for compatibility
 *      with the 68000 CPU. That CPU must have vectors at 0x00000000. The
 *      vectors_init() code will need to change to detect 68000 and copy
 *      the vectors there rather than relying on VBR to ROM. See get_cpu()
 *      for a cheap method to detect 68000/68008/68010.
 */

__attribute__ ((section (".romver")))
const char RomID[] = "$VER: KickSmash ROM Switcher "VERSION" (" BUILD_DATE" "BUILD_TIME ")\n";

#define VECTORS_BASE (RAM_BASE + 0x200)
#define COUNTER0     (RAM_BASE + 0x1000)
#define COUNTER1     (RAM_BASE + 0x1004)
#define COUNTER2     (RAM_BASE + 0x1008)
#define COUNTER3     (RAM_BASE + 0x100c)
#define STACK_BASE   (RAM_BASE + 0x10000 - 4)

#define BACKGROUND_COLOR(x) *COLOR00 = (x)

__attribute__ ((section (".reset")))
void
reset(void)
{
    __asm("dc.w 0x1114");
    __asm("jmp _reset_hi");    // dc.w 0x4ef9  dc.l 0x00f80010
    __asm("nop");
}

void
chipset_init_early(void)
{
    /* Shut down interrupts and DMA */
    *DMACON   = 0x7fff;  // Disable all chipset DMA
    *INTENA   = 0x7fff;  // Disable interrupt forwarding to m68k
    *INTREQ   = 0x7fff;  // Reply to all interrupt requests
    *INTREQ   = 0x7fff;  // Reply to all interrupt requests (A4000 bug)

    *CIAA_ICR = 0x7f;    // Disable interrupt forwarding to chipset
    *CIAB_ICR = 0x7f;    // Disable interrupt forwarding to chipset

    /* Stop timers */
    *CIAA_CRA  = 0x00;
    *CIAA_CRB  = 0x00;
    *CIAB_CRA  = 0x00;
    *CIAB_CRB  = 0x00;

    /* Silence audio */
    *AUD0VOL  = 0;
    *AUD1VOL  = 0;
    *AUD2VOL  = 0;
    *AUD3VOL  = 0;

    *ADDR8(GARY_BTIMEOUT) &= ~BIT(7);  // Disable BERR
}

void
chipset_init(void)
{
    /* Ramsey config */
//  *RAMSEY_CONTROL = RAMSEY_CONTROL_REFRESH0;  // Clobber burst/page/wrap

    /* Enable interrupts for keyboard input */
    *CIAA_ICR = CIA_ICR_SET | CIA_ICR_SP;  // Serial Port input from keyboard
//  *CIAA_ICR = CIA_ICR_SET | CIA_ICR_TA;
}

void
globals_init(void)
{
    void *data_start;
    uint  data_size;
    uint  bss_size;
    __asm("lea __sdata_rom,%0"  : "=a" (data_start) ::);
    __asm("lea ___data_size,%0" : "=a" (data_size) ::);
    __asm("lea ___bss_size,%0"  : "=a" (bss_size) ::);

    /* Set up globals (compile with -fbaserel for a4 to be globals pointer) */
    uint8_t *globals = (uint8_t *) (GLOBALS_BASE);  // Globals begin at 192K

    memcpy(globals, data_start, data_size);
    memset(globals + data_size, 0, bss_size);

    GET_A4();  // set up the A4 globals pointer
}

__attribute__ ((section (".reset_hi")))
void
reset_hi(void)
{
    const uint stack_base = STACK_BASE;

    /* Disable interrupts */
    __asm("move.w #0x2700,sr");

    /* Set up stack in low 64K of chipmem */
    __asm("move.l %0, sp" :: "r" (stack_base));

    /* Delay for hardware init to complete */
    __asm("move.w #0x100, d0 \n"
          "0: dbra d0, 0b");

    /* Turn off ROM overlay (OVL) and make LED stay dim */
    __asm("move.b #3, 0xbfe201 \n\t" // Set CIA A DRA bit 0 and 1 as output
          "move.b #2, 0xbfe001");    // Set CIA A PRA bit 0=OVL, bit 1=LED

    /* Green background color */
    __asm("move.w #0x0f0, 0xdff180");  // Set video background color to green

    __asm("jmp _setup");  // setup()
}

void
main_poll_no_cmdline(void)
{
    mouse_poll();     // handle mouse buttons
    keyboard_poll();  // handle key repeats
}

int
main_poll(void)
{
    if (cmdline())
        return (1);
    main_poll_no_cmdline();
    return (0);
}

void __attribute__ ((noinline))
setup(void)
{
    vectors_init((void *)VECTORS_BASE);
    globals_init();
    BACKGROUND_COLOR(0x00f);  // Bright Blue background
    chipset_init_early();
    *CIAA_PRA = 0x00;         // Set power LED bright
    cpu_control_init();       // Get CPU type
    cache_init();             // Enable cache
    cache_flush();            // Flush cache
    *ADDR32(0) = (uintptr_t) COLOR00;  // Help catch NULL pointer usage
    irq_enable();
    serial_init();
    serial_puts("\n\033[31m");
    serial_puts(RomID + 6);
    serial_puts("\033[0m\n");
    serial_putc('A');
    chipset_init();
    serial_putc('B');
    screen_init();
    BACKGROUND_COLOR(0x00c);  // Medium Blue background
    serial_putc('C');

    timer_init();
    serial_putc('D');
    serial_init();            // Now that ECLK is known
    serial_putc('E');
    audio_init();
    serial_putc('F');
    BACKGROUND_COLOR(0x008);  // Half Blue background
    serial_putc('G');
    keyboard_init();
    serial_putc('H');
    mouse_init();
    serial_putc('I');
    BACKGROUND_COLOR(0x004);  // Midnight Blue background
    screen_output_set(0);
    autoconfig_init();
    *INTREQ = 0x7fff;            // Clear all interrupt requests
    serial_putc('J');
    serial_puts("\n");
    autoconfig_configure_all();
    *INTENA   = INTENA_SETCLR |  // Set
                INTENA_INTEN |   // Enable interrupts
                INTENA_VERTB;    // Vertical blank
    serial_putc('K');
    picassoiv_enable_flicker_fixer();
    screen_output_set(1);

    gui_wants_all_input = 1;
    rl_initialize();
    using_history();
    serial_putc('L');
    test_draw();
    test_gadget();
    serial_puts("\n");
    BACKGROUND_COLOR(0x999);  // Grey background

#ifdef DEBUG_TIMER
    if (vblank_hz & 1) {
        /* Timer init failed */
        while (1)
            debug_cmdline();
    }
#endif
#ifdef STANDALONE
    extern void main_func(void);
    main_func();
#endif
    while (1) {
        main_poll();
    }
#if 0
    *COLOR00 = 0x0f0c;  // Purple
    __asm("halt");
#endif
}

void
debug_cmdline(void)
{
    GET_A4();  // set up the A4 globals pointer

//  globals_init();

    /* Activate MED cmdline */
    gui_wants_all_input = 0;  // Turns off GUI stealing input
    cursor_visible |= 2;
    dbg_all_scroll = 25;
    dbg_cursor_y = 25;

    rl_initialize();
    using_history();
    while (1) {
        if (main_poll())
            break;   // "quit" command entered
        vblank_ints = 0;  // No need for VBlank interrupt to trigger entry
    }
}
