cdhooper/kicksmash32/amiga/cpu_control.h

/*
 * This is free and unencumbered software released into the public domain.
 * See the LICENSE file for additional details.
 *
 * Designed by Chris Hooper in 2024.
 *
 * ---------------------------------------------------------------------
 *
 * Functions to control the CPU state from AmigaOS.
 */

#ifndef _CPU_CONTROL_H
#define _CPU_CONTROL_H

#ifdef STANDALONE
#include "util.h"
#include "cache.h"
#else
#ifndef _DCC
#include <devices/cd.h>
#include <inline/timer.h>
#include <inline/exec.h>
#include <inline/dos.h>
#endif
#endif

#define BIT(x) (1U << (x))

#ifdef _DCC
#define ASM_NOP
#else
#define ASM_NOP __asm volatile("nop");
#endif

#ifdef STANDALONE
/* Standalone is always in supervisor state */
#define SUPERVISOR_STATE_ENTER()
#define SUPERVISOR_STATE_EXIT()
#else
#define SUPERVISOR_STATE_ENTER()    { \
                                      APTR old_stack = (APTR) SuperState()
#define SUPERVISOR_STATE_EXIT()       UserState(old_stack); \
                                    }
#endif
#define CACHE_DISABLE_DATA() \
        { \
            uint32_t oldcachestate = \
            CacheControl(0L, CACRF_EnableD) & (CACRF_EnableD | CACRF_DBE)
#define CACHE_RESTORE_STATE() \
            CacheControl(oldcachestate, CACRF_EnableD | CACRF_DBE | CACRF_ClearD); \
        }

/*
 * MMU_DISABLE() and MMU_RESTORE() must be called from Supervisor state.
 *
 * The 68000, 68010, and 68020 have no on-chip MMU, so these do nothing
 * on those CPUs. (An external 68851 PMMU paired with a 68020 is not
 * handled.)
 */
#define MMU_DISABLE() \
        { \
            uint32_t oldmmustate = 0; \
            if (cpu_type == 68030) { \
                oldmmustate = mmu_get_tc_030(); \
                mmu_set_tc_030(oldmmustate & ~BIT(31)); \
            } else if ((cpu_type == 68040) || (cpu_type == 68060)) { \
                oldmmustate = mmu_get_tc_040(); \
                mmu_set_tc_040(oldmmustate & ~BIT(15)); \
            }
#define MMU_RESTORE() \
            if (cpu_type == 68030) { \
                mmu_set_tc_030(oldmmustate); \
            } else if ((cpu_type == 68040) || (cpu_type == 68060)) { \
                mmu_set_tc_040(oldmmustate); \
            } \
            ASM_NOP; \
        }

/*
 * The 68020 has only a 256-byte instruction cache, and its CACR
 * implements only bits 3:0 (C, CE, F, E). Bit 3 (C) is the same bit as
 * CACRF_ClearI, so only that bit is set. The other CACR bits are
 * reserved on the 68020 and must be written as zero.
 */
#define CACHE_FLUSH() \
        switch (cpu_type) { \
            case 68020: \
                cpu_set_cacr(cpu_get_cacr() | CACRF_ClearI); \
                break; \
            case 68030: \
                cpu_set_cacr(cpu_get_cacr() | CACRF_ClearI | CACRF_ClearD); \
                break; \
            case 68040: \
            case 68060: \
                cpu_cache_flush_040(); \
                break; \
        } \
        ASM_NOP;

#define CACHE_INVALIDATE() \
        switch (cpu_type) { \
            case 68020: \
                cpu_set_cacr(cpu_get_cacr() | CACRF_ClearI); \
                break; \
            case 68030: \
                cpu_set_cacr(cpu_get_cacr() | CACRF_ClearI | CACRF_ClearD); \
                break; \
            case 68040: \
            case 68060: \
                cpu_cache_invalidate_040(); \
                break; \
        } \
        ASM_NOP;

/* No TLB to flush on 68000, 68010, or 68020 (no on-chip MMU) */
#define MMU_FLUSH() \
        switch (cpu_type) { \
            case 68030: \
                flush_tlb_030(); \
                break; \
            case 68040: \
            case 68060: \
                flush_tlb_040(); \
                break; \
        }

#define INTERRUPTS_DISABLE() if (irq_disabled++ == 0) \
                                 Disable()  /* Disable interrupts */
#define INTERRUPTS_ENABLE()  if (--irq_disabled == 0) \
                                 Enable()   /* Enable Interrupts */

#define CIA_USEC(x)      (((x) * 715909 + 1000000 - 715909) / 1000000)
#define CIA_USEC_LONG(x) (((x) * 7159   + 10000   - 7159)   / 10000)

#ifndef ADDR8
#define ADDR8(x)    ((volatile uint8_t *)  ((uintptr_t)(x)))
#define ADDR16(x)   ((volatile uint16_t *) ((uintptr_t)(x)))
#define ADDR32(x)   ((volatile uint32_t *) ((uintptr_t)(x)))
#endif
#ifndef VADDR8
#define VADDR8(x)    ((volatile uint8_t *)  ((uintptr_t)(x)))
#define VADDR16(x)   ((volatile uint16_t *) ((uintptr_t)(x)))
#define VADDR32(x)   ((volatile uint32_t *) ((uintptr_t)(x)))
#endif

/*
 * Define compile-time assert. This macro relies on gcc's built-in
 * static assert checking which is available in C11.
 */
#include <assert.h>
#define STATIC_ASSERT(test_for_true) \
    static_assert((test_for_true), "(" #test_for_true ") failed")

#define ARRAY_SIZE(x) ((sizeof (x) / sizeof ((x)[0])))

void cpu_control_init(void);
void cia_spin(unsigned int ticks);

#ifndef _DCC
#define NO_INLINE __attribute__ ((noinline))
#define OK_UNUSED __attribute__ ((unused))

/*
 * mmu_get_tc_030
 * --------------
 * This function only works on the 68030.
 * 68040 and 68060 have different MMU instructions.
 */
OK_UNUSED static inline uint32_t
mmu_get_tc_030(void)
{
    uint32_t tc;
    __asm__ __volatile__("move.l %0,%%a0 \n\t"
                         ".long 0xf0104200 \n\t"  // pmove.l tc,(a0)
                         :: "a" (&tc)
                         : "a0", "memory");
    return (tc);
}

/*
 * mmu_set_tc_030
 * --------------
 * This function only works on the 68030.
 */
OK_UNUSED static inline void
mmu_set_tc_030(uint32_t tc)
{
    __asm__ __volatile__("move.l %0,%%a0 \n\t"
                         ".long 0xf0104000 \n\t"  // pmove.l (a0),tc
                         :: "a" (&tc)
                         : "a0", "memory");
}

/*
 * mmu_get_tc_040
 * --------------
 * This function only works on 68040 and 68060.
 */
OK_UNUSED static inline uint32_t
mmu_get_tc_040(void)
{
    uint32_t tc;
    __asm__ __volatile__(".long 0x4e7a0003 \n\t"  // movec.l tc,d0
                         "move.l %%d0,%0 \n\t"
                         : "=d" (tc)
                         :
                         : "d0", "memory");
    return (tc);
}

/*
 * mmu_set_tc_040
 * --------------
 * This function only works on 68040 and 68060.
 */
OK_UNUSED static inline void
mmu_set_tc_040(uint32_t tc)
{
    __asm__ __volatile__("move.l %0,%%d0 \n\t"
                         ".long 0x4e7b0003 \n\t"  // movec.l d0,tc
                         :
                         : "d" (tc)
                         : "d0", "memory");
}

OK_UNUSED static inline uint32_t
cpu_get_cacr(void)
{
    uint32_t value;
    __asm volatile("movec cacr, %0" : "=d" (value)::);
    return (value);
}

OK_UNUSED static inline void
cpu_set_cacr(uint32_t value)
{
    __asm volatile("movec %0, cacr" :: "d" (value):);
}

OK_UNUSED static inline uint32_t
cpu_get_dtt0(void)
{
    uint32_t value;
    __asm volatile("movec dtt0, %0" : "=d" (value)::);
    return (value);
}

OK_UNUSED static inline void
cpu_set_dtt0(uint32_t value)
{
    __asm volatile("movec %0, dtt0" :: "d" (value):);
}

OK_UNUSED static inline uint32_t
cpu_get_dtt1(void)
{
    uint32_t value;
    __asm volatile("movec dtt1, %0" : "=d" (value)::);
    return (value);
}

OK_UNUSED static inline void
cpu_set_dtt1(uint32_t value)
{
    __asm volatile("movec %0, dtt1" :: "d" (value):);
}

OK_UNUSED static inline uint32_t
cpu_get_itt0(void)
{
    uint32_t value;
    __asm volatile("movec itt0, %0" : "=d" (value)::);
    return (value);
}

OK_UNUSED static inline void
cpu_set_itt0(uint32_t value)
{
    __asm volatile("movec %0, itt0" :: "d" (value):);
}

OK_UNUSED static inline uint32_t
cpu_get_itt1(void)
{
    uint32_t value;
    __asm volatile("movec itt1, %0" : "=d" (value)::);
    return (value);
}

OK_UNUSED static inline void
cpu_set_itt1(uint32_t value)
{
    __asm volatile("movec %0, itt1" :: "d" (value):);
}

OK_UNUSED static inline uint32_t
cpu_get_pcr(void)
{
    uint32_t value;
    __asm volatile("movec pcr, %0" : "=d" (value)::);
    return (value);
}

OK_UNUSED static inline void
cpu_set_pcr(uint32_t value)
{
    __asm volatile("movec %0, pcr" :: "d" (value):);
}

OK_UNUSED static inline uint16_t
cpu_get_sr(void)
{
    uint16_t value;
    __asm volatile("move.w sr, %0" : "=d" (value)::);
    return (value);
}

OK_UNUSED static inline void
cpu_set_sr(uint16_t value)
{
    __asm volatile("move.w %0, sr" :: "d" (value):);
}

OK_UNUSED static inline uint32_t
cpu_get_tc(void)
{
    uint32_t value;
    __asm volatile("movec tc, %0" : "=d" (value)::);
    return (value);
}

OK_UNUSED static inline void
cpu_set_tc(uint32_t value)
{
    __asm volatile("movec %0, tc" :: "d" (value):);
}

OK_UNUSED static inline uint32_t
cpu_get_tt0(void)
{
    uint32_t value;
    /*
     * op  3:0   is (sp)
     * ext 15:13 is 0 for tt0 and tt1
     * ext 12:10 is 2 for tt0 and 3 for tt1
     * ext 9     is 0 for mem to reg, 1 for reg to mem
     */
    __asm__ __volatile__("subq.l #4,sp \n\t"
                         ".long 0xf0170a00 \n\t"  // pmove.l tt0,(sp)
                         "move.l (sp)+,%0 \n\t"
                         : "=d" (value));
    return (value);
}

OK_UNUSED static inline void
cpu_set_tt0(uint32_t value)
{
    __asm__ __volatile__("move.l %0,-(sp) \n\t"
                         ".long 0xf0170800 \n\t"  // pmove.l (sp),tt0
                         "addq.l #4,sp \n\t"
                         :: "d" (value));
}

OK_UNUSED static inline uint32_t
cpu_get_tt1(void)
{
    uint32_t value;
    /*
     * op  3:0   is (sp)
     * ext 15:13 is 0 for tt0 and tt1
     * ext 12:10 is 2 for tt0 and 3 for tt1
     * ext 9     is 0 for mem to reg, 1 for reg to mem
     */
    __asm__ __volatile__("subq.l #4,sp \n\t"
                         ".long 0xf0170e00 \n\t"  // pmove.l tt1,(sp)
                         "move.l (sp)+,%0 \n\t"
                         : "=d" (value));
    return (value);
}

OK_UNUSED static inline void
cpu_set_tt1(uint32_t value)
{
    __asm__ __volatile__("move.l %0,-(sp) \n\t"
                         ".long 0xf0170c00 \n\t"  // pmove.l (sp),tt1
                         "addq.l #4,sp \n\t"
                         :: "d" (value));
}

OK_UNUSED static inline uint32_t
cpu_get_vbr(void)
{
    uint32_t value;
    __asm volatile("movec vbr, %0" : "=d" (value)::);
    return (value);
}

OK_UNUSED static inline void
cpu_set_vbr(uint32_t value)
{
    __asm volatile("movec %0, vbr" :: "d" (value):);
}

OK_UNUSED static inline uint32_t
fpu_get_fpcr(void)
{
    uint32_t value;
    __asm volatile("fmove.l fpcr, %0" : "=d" (value)::);
    return (value);
}

OK_UNUSED static inline void
fpu_set_fpcr(uint32_t value)
{
    __asm volatile("fmove.l %0, fpcr" :: "d" (value):);
}

OK_UNUSED static inline uint32_t
fpu_get_fpsr(void)
{
    uint32_t value;
    __asm volatile("fmove.l fpsr, %0" : "=d" (value)::);
    return (value);
}

OK_UNUSED static inline void
fpu_set_fpsr(uint32_t value)
{
    __asm volatile("fmove.l %0, fpsr" :: "d" (value):);
}

OK_UNUSED static inline void
cpu_cache_flush_040(void)
{
    /* Flush Instruction and Data Cache: 0xf4f8  cpusha %bc */
    __asm volatile("nop\n\t"
                   "cpusha %bc");
}

OK_UNUSED static inline void
cpu_cache_flush_040_data(void)
{
    /* Flush Instruction and Data Cache: 0xf478  cpusha %dc */
    __asm volatile("nop\n\t"
                   ".word 0xf478");
}

OK_UNUSED static inline void
cpu_cache_flush_040_inst(void)
{
    /* Flush Instruction Cache: 0xf4b8  cpusha %ic */
    __asm volatile("nop\n\t"
                   ".word 0xf4b8");
}

OK_UNUSED static inline void
cpu_cache_invalidate_040(void)
{
    /* Invalidate Instruction and Data Cache: 0xf4d8  cinva %bc */
    __asm volatile("nop\n\t"
                   "cinva %bc");
}

OK_UNUSED static inline void
cpu_cache_invalidate_040_inst(void)
{
    /* Invalidate Instruction Cache: 0xf498  cinva %ic */
    __asm volatile("nop\n\t"
                   "cinva %ic");
}

OK_UNUSED static inline void
cpu_cache_invalidate_040_data(void)
{
    /* Invalidate Data Cache: 0xf458  cinva %dc */
    __asm volatile("nop\n\t"
                   "cinva %dc");
}

OK_UNUSED static inline void
flush_tlb_030(void)
{
    /* Using exact opcode because 68030 pflusha differs from 68040 pflusha */
    __asm volatile(".word 0xf000 \n\r"  // 68030 pflusha
                   ".word 0x2400");
}

OK_UNUSED static inline void
flush_tlb_040(void)  // Also 68060
{
    /* Using exact opcode because 68040 pflusha differs from 68030 pflusha */
    __asm volatile(".word 0xf518");  // 68040 pflusha
}

/*
 * void mem_copy8(void *dst, void *src)
 *           Copy 8 bytes from src to dst address
 */
OK_UNUSED static inline void
mem_copy8(void *dst, void *src)
{
    __asm("movem.l (%1),d0-d1 \n"
          "movem.l d0-d1,(%0) \n" :: "a" (dst), "a" (src) :);
}

/*
 * void mem_copy16(void *dst, void *src)
 *           Copy 16 bytes from src to dst address
 */
OK_UNUSED static inline void
mem_copy16(void *dst, void *src)
{
    __asm("movem.l (%1),d0-d3 \n"
          "movem.l d0-d3,(%0) \n"
          :: "a" (dst), "a" (src) : "d0", "d1", "d2", "d3");
}

/*
 * void mem_copy32(void *dst, void *src)
 *           Copy 32 bytes from src to dst address
 */
OK_UNUSED static inline void
mem_copy32(void *dst, void *src)
{
    __asm("movem.l (%1),d0-d7 \n"
          "movem.l d0-d7,(%0) \n"
          :: "a" (dst), "a" (src)
          : "d0", "d1", "d2", "d3", "d4", "d5", "d6", "d7");
}

#ifdef __VBCC__
static uint16_t swap16(__reg("d0")uint16_t) = "\trol.w\t#8,d0\n";
static uint32_t swap32(__reg("d0")uint32_t) = "\trol.w\t#8,d0\n\tswap\td0\n\trol.w\t#8,d0\n";
#else
OK_UNUSED static inline uint16_t
swap16(uint16_t val)
{
    __asm__("ror.w #8, %0"
            : "+d" (val)  // Output: val is read / written (+) in a D register
            :: "cc");     // Clobber: Condition codes are affected
    return (val);
}

OK_UNUSED static inline uint32_t
swap32(uint32_t val)
{
    __asm__("ror.w #8, %0\n\t"  // Rotate right by 8 bits (ABCD -> DABC)
            "swap %0\n\t"       // Swap 16-bit halves     (DABC -> BCDA)
            "ror.w #8, %0\n\t"  // Rotate right by 8 bits (BCDA -> ABCD)
            : "=d" (val)        // Output: 'val' is placed in a data register
            : "0" (val) :);     // Input: 'val'; "0" is same register as output
    return (val);
}
#endif /* !__VBCC__ */

#endif  /* !_DCC */

#ifdef _DCC
uint32_t cpu_get_cacr(void);
void     cpu_set_cacr(uint32_t value);
uint32_t cpu_get_dtt0(void);
void     cpu_set_dtt0(uint32_t value);
uint32_t cpu_get_dtt1(void);
void     cpu_set_dtt1(uint32_t value);
uint32_t cpu_get_itt0(void);
void     cpu_set_itt0(uint32_t value);
uint32_t cpu_get_itt1(void);
void     cpu_set_itt1(uint32_t value);
uint32_t cpu_get_pcr(void);
void     cpu_set_pcr(uint32_t value);
uint16_t cpu_get_sr(void);
void     cpu_set_sr(uint16_t value);
uint32_t cpu_get_tc(void);
void     cpu_set_tc(uint32_t value);
uint32_t cpu_get_tt0(void);
void     cpu_set_tt0(uint32_t value);
uint32_t cpu_get_tt1(void);
void     cpu_set_tt1(uint32_t value);
uint32_t cpu_get_vbr(void);
void     cpu_set_vbr(uint32_t value);
uint32_t fpu_get_fpsr(void);
void     fpu_set_fpsr(uint32_t value);
void     cpu_cache_flush_040(void);
void     cpu_cache_flush_040_data(void);
void     cpu_cache_flush_040_inst(void);
void     cpu_cache_invalidate_040(void);
void     cpu_cache_invalidate_040_inst(void);
void     cpu_cache_invalidate_040_data(void);
void     flush_tlb_030(void);
void     flush_tlb_040(void);
void     mem_copy8(void *dst, void *src);
void     mem_copy16(void *dst, void *src);
void     mem_copy32(void *dst, void *src);
uint16_t swap16(uint16_t value);
uint32_t swap32(uint32_t value);
#else
#endif

void cpu_cache_flush(void);

extern unsigned int cpu_type;
extern unsigned int irq_disabled;

extern struct ExecBase *SysBase;

#endif /* _CPU_CONTROL_H */
