cdhooper/kicksmash32/amiga/cpu_control.c

/*
 * cpu_control
 * -----------
 * Functions to control the CPU state from AmigaOS.
 *
 * Copyright 2024 Chris Hooper. This program and source may be used
 * and distributed freely, for any purpose which benefits the Amiga
 * community. Commercial use of the binary, source, or algorithms requires
 * prior written approval from Chris Hooper <amiga@cdh.eebugs.com>.
 * All redistributions must retain this Copyright notice.
 *
 * DISCLAIMER: THE SOFTWARE IS PROVIDED "AS-IS", WITHOUT ANY WARRANTY.
 * THE AUTHOR ASSUMES NO LIABILITY FOR ANY DAMAGE ARISING OUT OF THE USE
 * OR MISUSE OF THIS UTILITY OR INFORMATION REPORTED BY THIS UTILITY.
 */

#include <stdio.h>
#include <stdint.h>
#ifndef STANDALONE
#include <exec/execbase.h>
#endif
#include "cpu_control.h"

#define CIAA_TBLO        ADDR8(0x00bfe601)
#define CIAA_TBHI        ADDR8(0x00bfe701)

#ifdef _DCC
#define ASM_NOP
#else
#define ASM_NOP __asm volatile("nop");
#endif

typedef unsigned int uint;

unsigned int irq_disabled = 0;
unsigned int cpu_type = 0;

extern struct ExecBase *SysBase;

static uint
cia_ticks(void)
{
    uint8_t hi1;
    uint8_t hi2;
    uint8_t lo;

    hi1 = *CIAA_TBHI;
    lo  = *CIAA_TBLO;
    hi2 = *CIAA_TBHI;

    /*
     * The below operation will provide the same effect as:
     *     if (hi2 != hi1)
     *         lo = 0xff;  // rollover occurred
     */
    lo |= (hi2 - hi1);  // rollover of hi forces lo to 0xff value

    return (lo | (hi2 << 8));
}

void
cia_spin(unsigned int ticks)
{
    uint16_t start = cia_ticks();
    uint16_t now;
    uint16_t diff;

    while (ticks != 0) {
        now = cia_ticks();
        diff = start - now;
        if (diff >= ticks)
            break;
        ticks -= diff;
        start = now;
        ASM_NOP;
        ASM_NOP;
    }
}

#ifdef STANDALONE
static unsigned int
get_cpu(void)
{
    unsigned int cpu_type = 0;

    /*
     * XXX: This code will likely fail on 68000 because cacr does not
     *      exist on that processor (illegal instruction). It would be
     *      best to first set bit 14 in sr, and if it remains 0, then
     *      the CPU is 68000, 68008, or 68010.
     *          move.w  sr, d1      // Save DR
     *          ori.w #$4000, sr    // Set bit 14 (Trace bit)
     *          move.w d1, sr       // Write SR
     *          move.w sr, d2       // Read DR
     *          andi.w #bfff, d1
     *          move.w d1, sr       // Restore SR
     *          btst #14, d2
     *          bne.s 1f            // Is 68020+
     *
     *      To detect 68000 vs 68010, use a pipeline quirk trick, where
     *      an address register autodecrement is pushed.
     *          lea     .test_space(pc), a0  // Local buffer
     *
     *          move.l  a0, d1      // Save original A0
     *          movem.l a0, -(a0)   // Write A0 and autodecrement (quirk)
     *          move.l (a0), d0     // Read back
     *          cmp.l d1, d0
     *          beq.s 3f            // Is 68000
     *          move.l #68010, %0   // Is 68010
     *          bra 3f
     */
    __asm__ volatile(
        "move.l #68000, %0\n"      // Default to 68000
        /*
         * Probe with a bit that every 68020+ implements:
         *   bit 0  = E  (68020) / EI (68030) instruction cache enable
         *   bit 8  = ED (68030) data cache enable
         *   bit 31 = DE (68040 and 68060) data cache enable
         * The 68020 CACR only has bits 3:0, so without bit 0 the
         * readback would be 0 and a 68020 would be taken for a 68010.
         */
        "move.l #0x80000101, d1\n" // Enable 68020/68030 I cache, 68030/040+ D cache
        "movec.l cacr, d0\n"       // Save current CACR
        "movec.l d1, cacr\n"       // Check if CACR bit can be written
        "movec.l cacr, d1\n"
        "movec.l d0, cacr\n"       // Restore CACR
        "cmp.l #0, d1\n"
        "bne 1f\n"                 // If CACR is nonzero, it's 68020+
        "movec.l  sfc, d1\n"       // Check for 68010
        "cmp.l #0x00008000, d1\n"
        "bne 3f\n"                 // If different, it's 68000
        "move.l #68010, %0\n"
        "bra 3f\n"

        // 68020+
        "1: move.l #0x8000, d1\n"  // CACR.IE (68040 and 68060)
        "movec.l d1, cacr\n"       // Check if CACR bit can be written
        "movec.l cacr, d1\n"
        "movec.l d0, cacr\n"       // Restore CACR
        "cmp.l #0, d1\n"
        "beq 2f\n"                 // Doesn't have CACR.IE (ICache Enable)

        // 68040 or 68060
        "move.l #68040, %0\n"      // 68040+
        "move.l #0x4000, d1\n"     // CACR.NAI (68060)
        "movec.l d1, cacr\n"       // Check if CACR bit can be written
        "movec.l cacr, d1\n"
        "movec.l d0, cacr\n"       // Restore CACR
        "cmp.l #0, d1\n"
        "beq 3f\n"                 // No CACR.NAI; 68040 detected
        "move.l #68060, %0\n"
        "bra 3f\n"

        // 68020 or 68030
        "2: move.l #68030, %0\n"   // 68020 or 68030 detected
        "move.l #0x0200, d1\n"     // CACR.FD (68030)
        "movec.l d1, cacr\n"       // Check if CACR bit can be written
        "movec.l cacr, d1\n"
        "movec.l d0, cacr\n"       // Restore CACR
        "cmp.l #0, d1\n"
        "bne 3f\n"                 // Has CACR.FD (Freeze Data); 68030 detected
        "move.l #68020, %0\n"      // No CACR.FD; 68020 detected
        "3: nop\n"
        : "=r" (cpu_type)          // CPU type as integer
        :                          // No input operands
        : "d0", "d1"               // Modified registers
    );
    return (cpu_type);
}
#else
static unsigned int
get_cpu(void)
{
    UWORD attnflags = SysBase->AttnFlags;

    if (attnflags & 0x80)
        return (68060);
    if (attnflags & AFF_68040)
        return (68040);
    if (attnflags & AFF_68030)
        return (68030);
    if (attnflags & AFF_68020)
        return (68020);
    if (attnflags & AFF_68010)
        return (68010);
    return (68000);
}
#endif

void
cpu_control_init(void)
{
#if !defined(_DCC) && !defined(STANDALONE)
#pragma GCC diagnostic push
#pragma GCC diagnostic ignored "-Warray-bounds="
    SysBase = *(struct ExecBase **)4UL;
#pragma GCC diagnostic pop
#endif

    cpu_type = get_cpu();
}
