cdhooper/kicksmash32/(commit log)

2022-02-04 Initial checkin Rev 0.1
    [BOM_PCB_Amiga_Kicksmash32_2022-01-17.csv, PickAndPlace_PCB_Amiga_Kicksmash32_2022-01-17.csv]
2023-12-28 CHeckpoint - remote can write to flash with STM32 assist
    Board Rev 3 added bus tranceivers
2024-01-03 Checkpoint - works against MX29F1615 programmer
    ADC re-enabled without DAC
    Timer tree removed
    Code for board Rev 1 and Rev 2 removed
    Added detect of A18, A19, and KBRST connected to Amiga
    Renamed "prom vpp" to be "prom temp"
2024-01-22 Checkpoint - Amiga now boots from flash
    Added snoop/capture options for ROM data lo/hi as well as address
    Board standalone startup now tests most pins for shorts.
    This includes address, data, kbrst, and flash control pins.
    Fixed bug in waiting for flash done status in 32-bit mode.
    Can now handle one flash part finishing before the other (erase).
    The "prom id" command now shows a string for recognized parts.
    Added "prom log" command to display captured address / data values
    Added "prom bank" command to change the current ROM bank
    ROM bank default is (for now) forced to 0 at reset (A18=0 A19=0)
    Added "addr, datalo, and datahi" to the "snoop" command.
    This can be used to display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
    [cmdline.c, cmds.c, gpio.c, gpio.h, kbrst.c, kbrst.h, m29f160xt.c, m29f160xt.h]
2024-02-13 Milestone: Amiga can now perform flash id
    Added "flash" memory space for STM32 internal flash to "d" command
    Amiga flash config, including bank info is now saved to STM32 flash
    KS ROM bank can be automatically set at cold power-on and Amiga reset
    Added "reset amiga long" command option
    Now automatically detects 16-bit or 32-bit Amiga mode
    Added AmigaOS "smash" command
    Implemented message interface between AmigaOS and Kicksmash
    [adc.c, cmdline.c, cmds.c, config.c, config.h, crc32.c, crc32.h, gpio.c]
2024-02-19 Milestone: Amiga can now perform flash erase and flash write
    Barely tested. There are probably bugs.
    Code needs cleanup.
    Added MMU disable/restore
    Added smash -r (read), -w (write), and -e (erase) commands
    Added KS "prom bank" commands which mirror those from smash
    [cmdline.c, config.c, config.h, crcit.c, m29f160xt.c, m29f160xt.h, pcmds.c, smash.c]
2024-03-05 Milestone: Now works on A3000 with A3660
    smash command timing now based on CIA rather than spin loops
    Added ST_ARGS env variable to allow "make flash" to work with multiple boards
    make stinfo
    export ST_ARGS="--serial 53FF74064986525547421187"
    Added "prom name" command so multiple kicksmash can be identified
    Cold poweron should now configure the correct ROM bank
    KBRST signal will now be used to report when Amiga is powered off
    Improved spin in message interrupt handler detection and backoff
    Added simple detection of Amiga reboot by watching ROM addresses fetched
    Serial UART won't receive output after USB until input has occurred
    [BOM_Amiga-KickSmash-32-in-system-flash_2024-02-26.csv, PickAndPlace_PCB_Amiga_Kicksmash32_2024-02-26.csv]
2024-04-04 Several miscellaneous enhancements
    Added "reset prom" command to put flash back in read mode
    Added report of 5V measurement to "prom temp" output
    Changed order of magic sequence to be less likely
    Added pin names to gpio command
    Added support for Rev 4 merged RB pins
    USB startup moved earlier in init to prevent pin tests from killing USB
    Fixed pin tests to again work in stand-alone config
    Started work on message passing interface (incomplete).
    smash test code for message passing buffers not currently working.
    Loopback needs work for large messages (>= 900 bytes)
    The loopback perf test passes 10000 iterations as it is, so it's a
    good point to commit.
    Loopback odd byte test still ne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
    [adc.c, cmdline.c, cmds.c, crcit.c, gpio.c, gpio.h, m29f160xt.c, main.c]
2024-04-07 Loopback odd byte test now works
    Odd byte support required changes in both KS firmware and smash command
    Fixed handling of more KS data available than will fit in smash buffer
    Added Loopback test IOPS measurement
    Removed unnecessary use of Amiga ROM overlay (OVL) for flash operations
    Reduced KS message reply latency by inlining DMA setup functions
    [config.c, config.h, m29f160xt.c, msg.c, pcmds.c, smash.c, smash_cmd.h, timer.c]
2024-04-09 Message buffer test is now implemented
    Message buffer is tested for correct contents across circular buffer wrap.
    Added lock / unlock for message buffers
    [msg.c, smash.c, smash_cmd.h]
2024-04-10 New smash "clock" command and enhancements to argument parsing
    Smash clock command can be used to save / restore Amiga clock from KS
    Re-wrote command argument parsing for read, write, verify, erase, bank
    Can now handle either keywords or -x option format.
    Fixed bug in KS long reset invalid argument detection.
    [msg.c, smash.c, smash_cmd.h]
2024-04-20 Added message interface to external USB host
    Implementation includes test in smash utility.
    Added "usb stats" command
    Added CLI "service" command to enter message service mode
    Added KS command to flush message buffer
    Added workaround for USB message send issue with final transfer matching
    maximum payload size. Zero size transfer is required to end transaction.
    I'm not sure why, but the zero size transfer did not work. The current
    work-around is to cut short the final transfer and issue a subsequent
    transfer for the remainder of the data. This fix may be revised in the
    future.
    [crc32.c, crc32.h, crcit.c, main.c, main.h, msg.c, msg.h]
2024-04-20 KS-Amiga interface reliability change
    The Kicksmash->Amiga message interface was changed to where KS now waits
    for the Amiga to do an initial read before it enables reply data DMA.
    This seems to provide sufficient synchronization to prevent the two
    DMA engines from having skew in their initial trigger and sequence.
    Fixed buffer overrun bug in Amiga smash utility's loopback test
    [m29f160xt.c, m29f160xt.h, msg.c, smash.c]
2024-04-21 KS message renumbering, doc improvement, KS_CMD_FLASH_CMD
    KS commands were renumbered.
    Documentation was updated for commands missing it.
    Added KS_CMD_FLASH_CMD, which allows any command to be sent to the flash.
    [msg.c, smash.c, smash_cmd.h]
2024-04-22 Minor fixes
    Fixed V5 sensor false alerts
    Made KM_OP_LOOPBACK match SM_OP_LOOPBACK
    Merged help text for RB1 and RB2 to RB
    [adc.c, gpio.c, smash_cmd.h]
2024-05-06 Minor firmware fixes
    ADC sampling of V5 now reject glitches more by increasing averaging
    Fixed parsing bug where "prom log ; echo" would report an error
    Fixed delay command bug where ticks to delay were incorrectly computed.
    Added support for $b, $c, $d, etc loop command level indexes.
    Added support for command aliases with no help display.
    [adc.c, cmdline.c, cmds.c, pcmds.c, scanf.c, smash_cmd.h]
2024-05-09 More documentation, minor software fixes
    Added sw_kicksmash.txt
    Added sw_hostsmash.txt
    Disabled ADC V5 sensor for Board V3 and below
    Fixed bug in "snoop" command not properly capturing address or data
    Fixed bug where hostsmash could not send a symlink'd file for flash write.
    [BOM_PCB_Amiga_Kicksmash32_2022-01-17.csv, PickAndPlace_PCB_Amiga_Kicksmash32_2022-01-17.csv]
2024-05-10 Minor doc and code fixes
    Added ^C abort of flash read/write/verify/erase
    Fixed progress dots in smash read/write/verify/erase for large banks
    Fixed negative error status printing (was unsigned)
    Added default quiet build for all targets
    Version bump to 0.2
    [sm_msg.c, smash.c, smashftp.c, version.c]
2024-05-16 Large file read/write performance improvement
    File data read/write data can now be streamed without repeated request/reply
    This resulted in a near doubling of file transfer speed (58->100 KB/sec)
    Fixed smashftp "chmod +555" bug (was assigning rather than adding perms)
    Fixed smashftp "cd ::" command attempting to close invalid handle
    Fixed smashftp "get x dir" to work correctly, renaming dst per src name
    Did major cleanup of sm_file.c, including adding documentation
    Host message functions moved from sm_file.c to sm_msg.c
    KickSmash reboot command now turns off DMA sources before reboot.
    This might clear up an occasional "reset dfu" failure
    [adc.c, adc.h, host_cmd.h, msg.c, msg.h, pcmds.c, sm_file.c]
2024-05-16 Fixed multiple bugs in stand-alone pin tests. Added function doc to sm_msg.c Added "prom test" command to run stand-alone pin tests Removed "prom verify" command
    [pcmds.c, pin_tests.c, pin_tests.h, sm_msg.c]
2024-05-21 Minor doc fixes and standalone fix.
    Fixed standalone pin test complaining about SOCKET_D31 when OE is low
    Added disable of timer interrupt before resetting
    [adc.c, cmds.c, gpio.c, gpio.h, pcmds.c, pin_tests.c, timer.c, timer.h]
2024-06-03 Message interface improvements for faster Amiga CPUs
    Adjusted Amiga-side message delays to reduce time until KS is ready
    Improved Amiga-side message failure recovery code to detect good sooner.
    Fixed Amiga-side flash code to give KS time to execute command
    This should address crashes with BFG9060 during flash operations.
    Reduced flash operation delays, which should slightly speed up writes.
    Fixed smash display bug for flash erase progress bar.
    Fixed KS firmware bug in enabling Amiga address of 2MB flash bank.
    Made several improvements to KS firmware to increase message performance:
    Disable second DMA for data from Amiga (more RAM BW for CPU core),
    Change reply function to do less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
    [m29f160xt.c, msg.c, pcmds.c, sm_msg.c, smash.c]
2024-06-14 Improved fault exception handling for command failures Added blinking power LED for alert (test fail) condition Added new standalone tests for flash part connections
    [irq.c, led.c, led.h, m29f160xt.c, m29f160xt.h, main.c, pcmds.c, pin_tests.c]
2024-06-22 Fixed "prom test" to not report false socket A13, A14, A15 stuck Added errata comments which are fixed in Rev 5 (coming soon)
    [pin_tests.c]
2024-07-21 Rev 5 production files
    [BOM_Amiga-KickSmash-32-in-system-flash_2024-07-21.csv, PickAndPlace_PCB_Amiga_Kicksmash32_2024-07-21.csv]
2024-07-24 Improved ADC code to de-glitch 5V monitor Fixed bug in "snoop" command -- unbreakable loop if OE is low Fixed bug in hostsmash odd-length message handling Added host crcit utility to manually calcula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
    [adc.c, crcit.c, msg.c, sm_msg.c]
2024-09-14 Fixes for hostsmash compilation under MacOS Enhanced hostsmash to follow links for file and dir read Fixed bug in smashftp where "ls -l d/dt" fails due to math eval
    [host_cmd.h, printf.c, printf.h, smash.c, smashftp.c, smashftp_cli.c]
2024-10-11 Added smashfs as a filesystem to access host "volumes" through Kicksmash
    hostsmash changes
    - Better support for symlinks/soft links (mapping to Amiga volumes)
    - File seek now fully implemented
    - File and message debug output can be enabled/disabled
    - Time format is now Unix-native localtime, not half-Amiga
    smashfs
    - Detects exported volumes at startup and will mount all
    - Removes volumes and exits at ^C break -- pray you have nothing open!
    - Operation is good enough for AmigaDOS basic file read and write access
    - Not all DOS packets supported, but mostly functional for WB and shell
2024-10-11 smashfs - Fixed bug in ACTION_PARENT where subdirectory was reported as volume root - Fixed shutdown bug where volume node (lock list) was prematurely deallocated
    [fs_packet.c, fs_vol.c]
2024-10-25 hostsmash - EEPROM access now will put Amiga in reset during PROM operations - EEPROM program now does erase check and optional erase before write - Fixed file service bug where /path was appended to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
    kicksmash
    - Fixed slow serial console output when USB is disconnected
    - Fixed state timeout check to also happen at KS_CMD_MSG_STATE request
    - Added check for host file service active before attempting access.
    This will stop Amiga from long pauses waiting for non-responsive host
    - Fixed buffer access after free bug in file date change code
    - Removed requirement for Amiga debug library
    smashfs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
    [cpu_control.c, fs_hand.c, fs_hand.h, fs_packet.c, fs_rom.c, fs_rom_end.c, fs_timer.c, fs_vol.c]
2024-10-28 Kicksmash - Fix cold power-on bug where Amiga CPU gets clobbered coming out of reset
    [m29f160xt.c, main.c, pin_tests.c]
2024-11-07 smashfsrom - Can be placed in Kickstart ROM for smashfs mounts at boot - Still contains a lot of debug and test code - Doesn't yet support booting from smashfs - Debug serial output version is smashf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
    - Minor bug fix to get CPU type at startup
    - Fixed bad pointer dereference with file open fails
    - Shortened host message timeout wait period
    Kicksmash fw
    - Fixed "reset prom" to not leave flash in half-controlled limbo
    - Flash control release changed from 1000 ms to 100 ms after write
    hostsmash
    - debug output for all fs_open() types now reports handle
    - Command to reset Amiga after programming changed to "reset prom"
    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
    [cpu_control.c, cpu_control.h, crcit.c, fs_hand.c, fs_packet.c, fs_rom.c, fs_rom_end.c, fs_vol.c]
2024-11-07 smashfs - Fixed bug where ACTION_FINDINPUT should allow file writes
    Kicksmash firmware
    - Fixed bug where large host file transfers could cause host status to timeout
    [fs_packet.c, fs_vol.c, msg.c]
2024-11-07 Added missing file required to build smashfsrom
    [sm_msg_core.c]
2024-11-09 Build / release system - Made top level Makefile able to build lha and zip release images
    - Fixed broken MacOS build -- should now support file service (untested)
    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
    [fs_hand.c, smash.c, smashftp.c, version.c]
2024-11-21 hostsmash - Fixed several static C analysis complaints, including memory leaks on failure - Added "-c [set|show]" to set and show the KickSmash clock from the host - Millisecond delay changed to use 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
    smashftp
    - Fixed ^C abort of command to not cause future commands to abort
    - Fixed bug where remote file get didn't cause a failing program status
    smash
    - Corrected -c -k (get KickSmash clock if set) to work; did respond to -c -L
    - Fixed bug where "-t 4" didn't execute the remote message test.
    KickSmash fw
    - Fix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
    [m29f160xt.c, msg.c, smash.c, smashftp.c, smashftp.h, smashftp_cli.c, uart.c]
2024-11-23 Rev 6 PCBs
    [BOM_Amiga-KickSmash-32-in-system-flash_2024-02-26.csv, BOM_Amiga-KickSmash-32-in-system-flash_2024-11-22 (1).csv, BOM_Amiga-KickSmash-32-in-system-flash_2024-11-22.csv, PCB_PCB_Amiga_Kicksmash32_2024-11-22.json, PCB_PCB_Amiga_Kicksmash_4KT_2024-11-22.json, PickAndPlace_PCB_Amiga_Kicksmash32_2024-02-26.csv, PickAndPlace_PCB_Amiga_Kicksmash32_2024-11-22.csv, PickAndPlace_PCB_Amiga_Kicksmash_4KT_202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]
2024-12-25 romswitch - Added romswitch, a Kickstart-based ROM switcher smash command - Added "smash -s" to set KickSmash name and other values in the future KickSmash firmware - Fixed bug in switching when "res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
    [config.c, fs_rom.c, kbrst.c, msg.c, pcmds.c, romswitch.c, sm_msg.c, smash.c]
2024-12-27 romswitcher - Minor fix to text input gadget appearance
    [romswitch.c]
2025-01-05 hostsmash - Bank size now defaults to 512 KB, even when writing smaller image
    ROM switcher
    - Removed Return/Enter as a quick select for switch & reboot
    KickSmash FW
    - Increased 5V warning limit to 5.4V (A4000T has higher MB voltage)
    build system
    - Eliminated use of symlinks for source files (because Windows)
    [adc.c, crc32.c, crc32.h, crcit.c, host_cmd.h, romswitch.c, smash_cmd.h]
2025-01-23 romswitcher - Added automatic retry of any failed Kicksmash command
    - Improved message fault recovery to spin until ROM is consistent
    - Fixed looped delay cmd clobbering time suffix (ie: loop 5 delay 10ms)
    Kicksmash FW
    - Fixed looped delay cmd clobbering time suffix (ie: loop 5 delay 10ms)
    - Added "cpu hardfault" command to generate a firmware hard fault
    - Added resume and command line recovery attempts at firmware fault
    - Reworked Amiga long reset handling to now hopefully correctly detect it
    - Improved Kicksmash message handling to be slightly faster
    - "prom log 999" now shows both address buffer bases
    - Bad message length is now detected (bug caused Kicksmash FW crash)
    -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
    [clock.c, cmds.c, gpio.c, gpio.h, irq.c, irq.h, kbrst.c]
2025-01-23 Kicksmash FW - Added ability to set Power LED brightness "set led <%>" - Added preliminary (untested) 32-bit ROM low/high swap support
    [cmdline.c, config.c, config.h, irq.c, led.c, led.h, m29f160xt.c, m29f160xt.h]
2025-01-23 Kicksmash FW - Fixed introduced bug where pin tests unconfigured the Flash override GPIOs
    [main.c]
2025-01-24 hostsmash - On Windows now lists available COM ports if "-d <device>" is not specified
2025-02-13 romswitcher - Fixed bug in Kicksmash message error recovery code which would cause hang
    [readline.c, sm_msg.c, sm_msg_core.c]
2025-02-21 romswitcher - New feature: timeout and automatic ROM bank selection - Fixes for minor UI bugs: -- Added INTEGER_KIND gadget -- Gadget deactivate turns off string cursor -- String and integer gadgets 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
    - Added a limited number (32) of NVM bytes for Amiga programs
    - Made set command output easier to understand
    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
    [config.c, config.h, gadget.c, led.c, led.h, mouse.c, msg.c, pcmds.c]
2025-02-22 hostsmash - Fixed bug in program verify on Raspberry Pi (ARM ring buffer reordering)
    [prom_access.c]
2025-02-23 romswitcher - Fixed bug in CPU area fill and removed workaround (no visual effect)
    [blitter.c, draw.h, romswitch.c, testdraw.c]
2025-02-24 romswitcher - Added Blitter initialization as it sometimes is stuck at power-up
    [screen.c]
2025-03-13 Kicksmash3KT Update Kicksmash1200 USB cutout
    [BOM_Amiga-KickSmash-32-in-system-flash_2025-03-12.csv, BOM_Amiga-KickSmash-32-in-system-flash_2025-03-13.csv, PCB_PCB_Amiga_Kicksmash1200_2025-03-12.json, PCB_PCB_Amiga_Kicksmash1200_2025-03-13.json, PCB_PCB_Amiga_Kicksmash_3KT_2025-03-13.json, PickAndPlace_PCB_Amiga_Kicksmash1200_2025-03-12.csv, PickAndPlace_PCB_Amiga_Kicksmash1200_2025-03-13.csv, PickAndPlace_PCB_Amiga_Kicksmash_3KT_2025-03-13.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]
2025-03-17 smash - Added ability to specify write+verify with "-wv" - Fixed ROM read / verify bug (wasn't waiting long enough for Kicksmash FW) ROM switcher - Added initialization of Ramsey refresh and memory b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
    [amiga_chipset.h, cache.c, main.c, med_readline.c, msg.c, readline.c, romswitch.c]
2025-03-25 PCBs - Kicksmash4KCR
    smash utility
    - Removed redundant "-v" verify as reported by SimD
    - Fixed crash issue with assuming ROM is ready for access too early
    - Fixed ^C handling to consistently report "^C Abort"
    - Flash reads and writes now wait longer before assuming bank is restored.
    - Fixed pin tests to not report issues with USB-C CC1 and CC2 pins.
    Documentation
    - Moved to sub-pages to better organize access
    - Most documentation has been refreshed
    - Added more images and sub-pages, including page to help select board
    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
    [BOM_Amiga-KickSmash-32-in-system-flash_2024-07-21.csv, BOM_Amiga-KickSmash-32-in-system-flash_2025-03-20.csv, PCB_PCB_Amiga_Kicksmash_4KCR_2025-03-20.json, PickAndPlace_PCB_Amiga_Kicksmash32_2024-07-21.csv, PickAndPlace_PCB_Amiga_Kicksmash_4KCR_2025-03-20.csv, SCH_Amiga-KickSmash-32-in-system-flash_2025-03-20.json]
2025-03-26 Fix most docker build issues (can't work around gcc bug)
    [gadget.c, intuition.c, intuition.h, strtoll.c, strtoull.c]
2025-04-05 smash - Added new "term" command for Kicksmash firmware terminal from AmigaOS - Firmware message interface is now padded to 32 bits for the CRC. This breaks backward compatibility of some messages, b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
    - "prom name" no longer requires quotes around name
    - "set name" no longer requires quotes around name
    - "prom bank name" no longer requires quotes around name
    - Amiga cursor key sequence is now supported (support smash term -T)
    - Added "time amiga" command to show tracked Amiga RTC time (if set)
    - Files larger than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
    [blitter.c, cmds.c, config.c, cpu_control.c, fs_packet.c, keyboard.c, med_readline.c]
2025-04-10 ROM switcher - Roll back a change which clobbers Ramsey's control register. It was having unintended side-effects such as missing fastmem.
    [main.c]
2025-04-11 PCBs - Rev Kicksmash1200 to version 7.1 (fix USB-C cutout)
    [BOM_Amiga-KickSmash-32-in-system-flash_2025-03-13.csv, BOM_Amiga-KickSmash-32-in-system-flash_2025-04-10.csv, PCB_PCB_Amiga_Kicksmash1200_2025-03-13.json, PCB_PCB_Amiga_Kicksmash_1200_2025-04-10.json, PickAndPlace_PCB_Amiga_Kicksmash_1200_2025-04-10.csv, SCH_Amiga-KickSmash-32-in-system-flash_2025-03-13.json, SCH_Amiga-KickSmash-32-in-system-flash_2025-04-10.json]
2025-04-21 Kicksmash FW - Fixed bug where crash could happen at long reset if longreset bank is not set - Fixed pin test bug where SOCKET_OE=1 might cause SOCKET_D31=1
    [m29f160xt.c, pin_tests.c]
2025-04-29 ROM switcher - Fixed bank switch timeout to not abort unexpectedly at startup
    [mem_access.c, mouse.c, romswitch.c]
2025-06-18 smash - Improved flash ID test (6) to report values on failure - Code to return flash to read mode now tries extra hard This may fix crashes with "smash erase" and "smash write" commands
    romswitcher
    - Fixed potential Blitter initialization bug
    - Fixed hostsmash "--clock" argument alias for "-c"
    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
    [cpu_control.h, screen.c, smash.c]
2025-06-22 Worked around M29F160 flash chip bug which prevented AmigaOS 2.04 from being flashed Value 0x90 was being written to address 0x55, which put the flash in "READ CFI QUERY" mode, causing programming to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
    [cmdline.c, cmds.c, m29f160xt.c]
2025-06-23 Kicksmash FW - Added Flash OEWE test of Q2 and Q3 based on speed of those parts This test was implemented because AO34000A parts populated on the Rev 6a boards cause programming from the Amiga to fai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
    Minor documentation updates
    [config.h, med_cmdline.c, med_cmds.c, pcmds.c, pin_tests.c, prom_access.c, uart.c]
2025-06-27 smash - Minor help text improbement
    - Added warning about Kicksmash1200 incompatibility with TF1260
    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
    [smash.c]
2025-07-01 Kicksmash firmware - Fixed potential false error at 100% when hostsmash is writing a ROM - Eliminated some variable latency in Kicksmash-Amiga CPU command replies
    - Improved `flash id` test failure recovery to be less likely to hang Amiga
    - Implemented flash command sync retry when Kicksmash is late with flash command
    This will hopefully resolve "flash id" test and other flash command failures.
    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
    [prom_access.c, smash.c]
2025-07-07 Kicksmash FW - Worked around flash chip bug (0x90 to address 0x55) again
    [m29f160xt.c]
2025-07-08 Kicksmash FW - Fixed flash programming bug which caused missed data from the USB host. This bug was introduced at the workaround for the M29F160 flash chip bug.
    - Now replays Kicksmash output to user when flash programming failure occurs.
    This will allow one to see an error that the Kicksmash FW emitted.
    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
    [m29f160xt.c]
2025-07-09 ROM switcher - Fixed bug where clicking + or - for Long Reset settings was broken
    - Updated FAQ to give better reason why to use Kicksmash
    - Updated FAQ with specific example of upgrading Kickstart to 3.2.3
    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
    [gadget.c, romswitch.c]
2025-07-09 ROM switcher - Spacebar now switches between PAL and NTSC
2025-07-10 smmash - Added "set sw_timeout" command to set the ROM Switcher timeout - Added "set sw_bank" command to set the ROM Switcher bank
    - Added "set sw_timeout" command to set the ROM Switcher timeout
    - Added "set sw_bank" command to set the ROM Switcher bank
    - Further updates to the FAQ
    - Improved grammar in HW build and programming instructions
    - Updates to SW hostsmash, smash, and smashftp documentation
    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
2025-07-12 Kicksmash FW - Added support for M29F160TB - Closes #22
    - Fixed '--clock set' to get and report the correct time on Windows
    The issue was that the Windows code was not computing the UTC offset.
    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
    [m29f160xt.c, pcmds.c, pin_tests.c, pin_tests.h, smash.c]
2025-07-14 Kicksmash FW - When the Amiga is off, SOCKET_OE is now driven high by firmware This should reduce the amount of backpower provided to a powered off Amiga - When the Amiga is off, prom access will now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
    [adc.c, adc.h, config.c, config.h, gpio.c, kbrst.h, pcmds.c, prom_access.c]
2025-07-16 Kicksmash FW - Fixed message buffer bug where large transfers might be partially re-sent. Fixes smashfs and smashftp bug when the Amiga sends a file > 2KB in size
    - Fixed smashfs/smashftp bug on Windows where binary files failed to transfer
    - Fixed bug where app service state would time out on large file transfers
    - Fixed bug where copy from write-protected file could fail
    FINDINPUT and FINDUPDATE now try open a second time with only read permission
    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
    [config.c, fs_packet.c, msg.c, sm_msg.c]
2025-08-06 PCBs - KicksmashAPCI added - Kicksmash4KCR updated to Rev8
    ROM Switcher
    - Fixed MED "aconfig" command to handle Z3 board configured in Z2 space
    - Added MED "what" command to MED command line
    - Added debug command line on exception and unexpected interrupt
    - Added 68k disassembler to MED command line ("dis" command)
    - Changed blitter init to hopefully be more resilient to odd register state
    - Serial input is now interrupt-driven
    - Added register display and stack dump on unexpected interrupt or hang detection
    FW
    - Added "prom log full" and "prom log stats" options
    - Added support for MX29F800Cx, MX29LV160Cx, and M29W160Ex
    - More work is still required for MX29F800Cx support
    Write fails at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
    [BOM_Amiga-KickSmash-32-in-system-flash_2025-03-20.csv, BOM_Amiga-KickSmash-32-in-system-flash_2025-07-24.csv, BOM_Amiga-KickSmash-32-in-system-flash_2025-07-27.csv, PCB_PCB_Amiga_Kicksmash_4KCR_2025-03-20.json, PCB_PCB_Amiga_Kicksmash_4KCR_2025-07-27.json, PCB_PCB_Amiga_Kicksmash_APCI_2025-07-24.json, PickAndPlace_PCB_Amiga_Kicksmash_4KCR_2025-03-20.csv, PickAndPlace_PCB_Amiga_Kicksmash_4KCR_2025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]
2025-08-24 ROM Switcher - Added CPU cache initialization and enable This will hiopefully resolve the occasional cold poweron bug that I've been tracking - Made minor changes to Amiga chipset init to improve sta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
    [cache.c, cpu_control.c, cpu_control.h, draw.c, main.c, main.h, med_cmdline.c, msg.c]
2025-08-25 ROM Switcher - Minor updates to keep code in sync with amiga_rom_med
    - Eliminated debug "Cleariog atou" message
    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
2025-08-28 ROM Switcher - Improved handling of ECLK tick failure - Dump on unexpected interrupt is now less likely to cause VBlank timeout - Rearranged MED "cpu fault" and "cpu reg" commands - Added several pro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
    [cache.c, cpu_control.c, cpu_control.h, db_disasm.c, exec_types.h, gadget.h, intuition.h, main.c]
2025-08-28 ROM Switcher - Added support for 68030 "cpu reg tt0" and "cpu reg tt1"
2025-09-01 Documentation - Minor fixes for address range of 512 KB extension ROM area
    - Fixed BIGROM support for A4000T by disabling pull down on address pin
    - Moved ROM version string near the beginning of the file and added $VER string
    - Power LED now goes bright during early initialization
    - Improved error recovery in some failure cases (still needs more improvement)
    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
    [audio.c, m29f160xt.c, main.c, med_cmds.c, util.c]
2025-09-11 ROM Switcher - Added some tolerance of CIA-A not being readable (incomplete) - Added debug background color (blue) during initialization - Added MED "cpu spin <addr>" command
    [amiga_chipset.h, keyboard.c, main.c, med_cpu.c, pcmds.c, reset.c, screen.c, timer.c]
2025-09-23 smashftp and smashfs - Improved file operations by adding automatic message retry on CRC error
    - Fixed false repeating key when multiple keystrokes are held
    - Early init color sequence
    Green background: Stuck at chipmem init
    Bright Blue background: Stuck at early chipset or CPU vectors init
    Power LED bright: Stuck at IRQ init, CPU type, or serial init
    ROM ID at serial: Stuck at cache init
    'A' at serial: Stuck at chipset init
    'B' at serial: Stuck at screen init
    'C' at serial and Medium Blue background: Stuck at timer init
    'D' at serial: Stuck at audio init
    'E' at serial and Half Blue background: Stuck at serial reinit
    'F' at serial: Stuck at keyboard init
    'G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
    [keyboard.c, main.c, msg.c, romswitch.c, sm_file.c, sm_msg.c, sm_msg.h]
2025-11-05 ROM Switcher - Removed build of ROM Switcher Kickstart module - Added MED ability to get/set CPU SR register - User may now enter a digit to select that bank for booting - Fixed MED bug where "comp" 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
    - Fixed bug where "comp" command could not be used
    - Fixed typo in windows_notes.txt
    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
    [cmdline.c, cpu_control.h, keyboard.h, med_cmdline.c, med_cpu.c, romswitch.c, sm_file.h, vectors.c]
2025-11-06 ROM Switcher - Added support for Keyboard-controlled Mouse movement and clicks Amiga-cursor keys for small movements Shift-Amiga-cursor keys for large movements Control-Amiga-cursor keys for move-to-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
2025-12-16 hostsmash - MacOS can now automatically locate Kicksmash So in most cases, one no longer needs to specify -d /dev/cu.usbmodem*` - Fixed file service bug where non-existing file opened for create woul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
    Doc
    - Minor updates to Windows notes for driver install help
2025-12-16 Sync MED command line fixes and enhancements across repositories
    [cmdline.c, cmds.c, med_cmdline.c, med_cmds.c, med_readline.c, pcmds.c, readline.c]
2025-12-26 Minor compile fix for gcc 6.5
    [fs_hand.c, smash.c, smashftp.c]
2026-01-23 FW - Fixed bug where "prom name A4000-CR" would set the name to "a3ff4R" - Added standalone pin test to verify data lines are connected to flash parts - Added flash A1-A8 address pin test.
    [cmdline.c, m29f160xt.c, pin_tests.c]
2026-02-16 romswitcher - Fixed missing header file
    fw
    - Changed serial number algorithm to not emit non-alphanumeric characters
    - Added HW install info for A4000CR and AA3000+
    - Added Windows tip about keeping the same COM port
    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
    [cpu_fault.h, usb.c, usbdfu.c]
2026-02-17 dehunk: fix compilation errors and portability issues
    Change main() return type from uint to int to conform to the C
    standard. Add the missing return statement at the end of main().
    Include <sys/types.h> for proper type definitions, improving
    portability across platforms. These changes fix use on macOS.
    [dehunk.c]
2026-02-17 dehunk: fix compiler warnings
    Fix format string mismatches for sizeof expressions (%u -> %lu with
    unsigned long casts) and off_t (%u -> %lld with long long cast) to
    ensure correct behavior on both 32-bit and 64-bit platforms.
    Fix a broken format specifier in the hunk header error message where
    a '%' was missing ("0x08x" -> "0x%08x"), which also caused the
    HUNK_HEADER argument to be silently ignored.
    Remove unused variables hsize and hunknum, the unused label fail_read,
    and mark the unused bufend parameter in skip_debug() as such.
    [dehunk.c]
2026-02-17 gadget: replace MX radio button rectangle with capsule shape
    Draw MX radio buttons as capsule/stadium shapes with 3D beveled
    outlines instead of plain rectangles. The left and top edges use the
    bright pen and the right and bottom edges use the dark pen, matching
    standard Amiga widget conventions.
    The capsule interior is filled with gray, with the selection color
    drawn inset to provide a visible border between the fill and the
    outline.
    [gadget.c]
2026-02-18 romswitcher: fix warning in gadgets
    [gadget.c]
2026-03-10 hostsmash: add --version option
    Add a -V/--version command line option that prints the version string
    and exits. Factor out the version printing from usage() into a
    dedicated print_version() helper for reuse.
2026-03-15 PCBs - Kicksmash4KCR updated to Rev9
    [BOM_Amiga-KickSmash-32-in-system-flash_2025-07-27.csv, BOM_Amiga-KickSmash-32-in-system-flash_2026-03-15.csv, PCB_PCB_Amiga_Kicksmash_4KCR_2025-07-27.json, PickAndPlace_PCB_Amiga_Kicksmash_4KCR_2025-07-27.csv, PickAndPlace_PCB_Amiga_Kicksmash_4KCR_2026-03-15.csv, SCH_Amiga-KickSmash-32-in-system-flash_2025-07-27.json, SCH_Amiga-KickSmash-32-in-system-flash_2026-03-15.json]
2026-03-21 smash - Improved flash id test to better recover from Kicksmash message failures - Enhanced smash term to allow text to send to be specified on the command line In that mode, term will exit after no 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
    - Reduced ADC clock from 12 MHz to 9 MHz
    - Slightly improved ROM address capture latency by not capturing high bits
    - Kicksmash asynchronous text messages will now be shown as just text
    when hostsmash is in file server mode.
    crcit utility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
    [clock.c, crcit.c, gpio.c, gpio.h, msg.c, sm_msg.c, sm_msg.h]
2026-03-25 smashfs - Fixed bug where devtest -g on smashfs device could crash Amiga The problem was that the device was created using the volume structure and could contain invalid data for the FSSM structure p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
    [fs_vol.c, fs_vol.h]
2026-03-25 fw - Latest libopencm3 increases size of usbdfu and breaks regular USB device Locked down clone of libopencm3 to a specific working commit
2026-03-29 FW - Change backpower solution to instead drive 0V on the Amiga data lines. When the Amiga is off, the previous solution was to drive SOCKET_OE high, preventing the buffers from driving on the Amiga 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
    [adc.c, config.h, gpio.c, m29f160xt.c, msg.c, pcmds.c, pin_tests.c]
2026-04-22 romswitcher: clean up serial output
    The \n should be printed on serial in combination with \r, so that
    an actual new line is started. Otherwise the output looks like this:
    KickSmash ROM Switcher 1.9+ (2026-04-20 23:12:23)
    ABCDEFGHIJK
    a4092: a4092.device a4092 42.36-30-g3175767 (21.4.2026)
2026-05-03 romswitcher: configure all autoconfig boards
    Teach autoconfig address allocation to follow Zorro II slot alignment
    rules, handle Zorro II boards visible through the Zorro III config
    aperture, and verify that assignment advances the config chain. Export
    helpers to configure all visible boards and look up configured devices
    by manufacturer/product ID.
2026-05-03 romswitcher: allow console outputs to be gated
    Add switches for serial and screen output paths so boot-time setup can
    keep debug text off the display when needed. Also enable the master
    interrupt bit during serial init and avoid using timer_tick_get() before
    the EClock rate has been established.
    [screen.h, serial.c, serial.h]
2026-05-03 romswitcher: add Picasso IV flicker fixer support
    Find the configured Picasso IV flicker fixer autoconfig device, map its
    Zorro III register window as noncacheable when needed, program the
    PAL/NTSC timing and POST windows, and route native Amiga video through
    the flicker fixer during setup.
    [main.c, picassoiv.c, picassoiv.h]
2026-05-07 fw - Added initial GD32F107 support (higher clock speed). More work is needed. - Improved pin tests (A0-A15 connection determination) - Added "prom test force" to force initial pin tests. - Fixed bug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
    - Flash write is allowed to continue even if swap mode can't be determined
    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
    [clock.c, clock.h, gpio.h, pcmds.c, pin_tests.c, pin_tests.h, printf.c]
2026-05-09 FW - Fixes to pin tests for Kicksmash Rev 10+ (SOCKET_OE tri-state) - Kicksmash Rev 10+ now sets internal SOCKET_OE high when power is off
    [adc.c, pin_tests.c]
2026-05-10 romswitcher - Fix autoconfig of Zorro III device in Zorro II window (HW doc is wrong)
    documentation
    - Added sourcing help for 74FCT162244 and alternatives
    [autoconfig.c]
2026-05-17 romswitcher - Work around gcc 6.5 compiler warnings, not knowing -Wstringop-overflow
    - Further GD32 support - GPIO speed mode affects maximum pin current
    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
2026-05-21 romswitcher - Fixed "CIA-A ECLK timeout" failure when running in FS-UAE with JIT
    [main.c, timer.c]
2026-05-21 romswitcher - Screen refresh now handled by the Copper (stops crazy display on crash)
    [amiga_chipset.h, screen.c, vectors.c]
2026-05-28 FW - Fixed "prom test" in standalone mode to not incorrectly report problems
    [pin_tests.c]
2026-07-12 smash - Fixed minor mistakes in error messages (such as missing bank argument)
    - Removed persistent pull up/down of SOCKET_D31
    - Fixed missing mode setting of D16-D31 pull-up state during pin tests
    - Added DiagROM 2.0 release signature for auto byte swapping
    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
    [gpio.c, kbrst.c, msg.c, pin_tests.c, sm_msg.h, smash.c]
2026-07-12 documentation - Update ROM spacing table
    - Replaced gadget rendering of cross-hatched "disable" to a solid dark grey
    - Default handlers for the entire 256 68000 vectors are now installed
    - Fixed incorrect display for Kicksmash mode when "set" command is used
    - Increased strength of GD32 pin drivers when USB data is being reset
    - Return data pins to input pull-down state after Kicksmash communication
    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
    [blitter.c, gadget.c, m29f160xt.c, pcmds.c, romswitch.c, smash.c, usb.c, vectors.c]
2026-07-15 Added Kicksmash test board and firmware (smasher)
    [BOM_Amiga-Kicksmash-tester_2026-06-13.csv, PCB_PCB_Amiga-Kicksmash-tester_2026-06-13.json, PickAndPlace_PCB_Amiga-Kicksmash-tester_2026-06-13.csv, SCH_Amiga-Kicksmash-tester_2026-06-13.json]
2026-07-21 ROM Switcher - Documented all Cirrus GD5446 register manipulation
2026-08-05 ROM Switcher - Now supports Picasso IV with GD5446 Rev B and PCI Bridge Rev 2. Does not yet work with GD5446 Rev B and Bridge Rev 1, I think. - Now works with 512KB Agnus (previously required at leas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
    - Added recognition of DiagROM 2.0+ for ROM programming
    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
2026-08-07 FW - Standalone pin test updates to support Kicksmash32 Rev 10 board
    PCB
    - Kicksmash32 Rev10
    [BOM_Amiga-KickSmash-32-in-system-flash_2026-06-29.csv, PCB_PCB_Amiga_Kicksmash_32_10_2026-06-29.json, PickAndPlace_PCB_Amiga_Kicksmash_32_10_2026-06-29.csv, SCH_Amiga-KickSmash-32-in-system-flash_2026-06-29.json]
2026-08-07 ROM Switcher - Fixed bug where keyboard interrupt during initialization could cause a crash The keyboard interrupt handler was not properly saving/reloading A4. - Removed copy of vectors to RAM since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
    [vectors.c]
2026-08-18 ROM Switcher - Minor improvements to decrease startup time - Allow modification of Gary BERR bit from MED cmdline - Merge private/public autoconfig structs
    Smasher
    - Fix GPIO names
    - Several improvements to pin tests.
    Still unknown whether "Kicksmash is present" detection is good.
    - Added USB polling to smash tests, would previously clobber USB negotiation
    [autoconfig.c, autoconfig.h, gpio.c, main.c, mem_access.c, pin_tests.c, smash.c, vectors.c]
2026-09-03 hostsmash - Fixed fwrite bug where missing data on large transfers is ignored - Added host interface versioning for backwards compatibility - Added support for multiple client threads (finished messa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
    - Increased core message backoff when Kicksmash doesn't have response yet
    This is to corruption of large file "put" transfers.
    Kicksmash message interface
    - Minor performance improvements by tweaking delay between send/receive
    Host message interface
    - Added support for multiple simultaneous threads sending / receiving messages
    This affects smashfs, smashftp, and smashnet. Anything that talks to t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
    [fs_hand.c, host_cmd.h, msg.c, sm_file.c, sm_msg.c, sm_msg.h, sm_msg_core.c]
2026-09-03 smashfs - Fixed directory read bug introduced in previous commit
    [fs_packet.c, sm_file.c]
2026-09-06 ROM Switcher - Make the Copper/VBlank watchdog colors immune to interrupt latency
    The VBlank handler checks the "Copper is alive" flag (ADKCON WORDSYNC)
    that the Copper sets once per frame and paints COLOR01 dark red when it
    is missing. On a fast CPU with caches enabled (68040 at 40MHz) the
    handler often runs before the Copper has reached that write, which sits
    about 13us into the Copper list. Whether the handler then finds the flag
    depends on the ordering of the two in the previous frame, and every time
    the ordering flips the text flashes dark red for one frame.
    - Paint dark red only after two consecutive misses. A false miss needs
    the previous handler to have run after the Copper's writ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
    [screen.c, vectors.c]
2026-09-06 ROM Switcher - Saturate the Copper miss counter so a long outage cannot wrap it
2026-09-07 romswitch: Give bank fields room for separate bevel edges
    Use ten-pixel bank rows so eight-pixel text fits between independent
    top and bottom borders. Update text, controls, radio spacing and hover
    row calculations together, and move the table up to fit the screen.
    Separate header and column borders so they cannot overwrite each other,
    and leave equal inset space inside the outer table frame. Derive the
    title frame width from the same columns to align both outer frames.
    Move the bottom buttons down and center their standalone labels.
2026-09-07 romswitch: Keep keyboard button outlines on screen
    The bottom buttons fit on scanlines 188 through 199, but their larger
    keyboard-activation outlines extend through scanline 201. Limit the
    outline height to the remaining visible rows so the confirmation and
    shortcut highlights stay within the 200-line NTSC layout.
    [romswitch.c]
2026-09-07 romswitch: Align taller Auto Switch fields and labels
    Increase the Bank and Timeout fields to eleven pixels and move Timeout
    down one pixel to preserve the gap between them. Round the centered
    text position down by one pixel for odd-height fields, and position
    the left-hand labels from the same baseline as the values and cursor.
2026-09-15 FW - Worked around GD32F107 hardware USB data corruption bug This involved writing my own code which pulls from the USB Receive FIFO and compares against data which is in the backdoor SRAM. - There a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
    - Improvements to programming error reporting
    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
    [gd32f107_usb.c, m29f160xt.c, prom_access.c, usb.c, usbdfu.c]
2026-09-20 smashftp - Added wildcard support to get, put, ls, chmod, mv, rm, rd, cd, and local equivalents - Fixed minor bug where getting a short file could report false error (EOF)
    [smashftp.c, smashftp_cli.c]
2026-09-22 FW - Overclock GD32F107 to 120 MHz to handle Amiga 1200 Gayle with 68020 CPU - Improve pin test detection of new style ROM OE circuit
2026-09-23 hostsmash - Can now report Kicksmash info, including board state with -ii option. - --version will also report Kicksmash version if -d device is specified
    - Can now report additional Kicksmash board state with -i option.
    - Added reporting of board state to hostsmash and smash
    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
2026-09-24 smashnet - Added build of standard SANA-II smashnet.device
2026-09-28 FW - Improve sensor reporting output of "prom temp" - Added sensor reporting of calculated 3.3V - GD32F107: remove broken temperature sensor reporting - GD32F107: adjust voltage sensor calculation to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
    [adc.c, adc.h, clock.c, cmds.c, main.c, pin_tests.c]
2026-09-29 smasher - Test button can now toggle between: A) Do short smash test loop B) Do indefinite smash test runs C) Stop running smash test - Test button will now flicker status LED and do nothing else whi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
    - Kicksmasher Rev 2 released
    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
    [BOM_Amiga-Kicksmash-tester_2026-06-13.csv, BOM_Amiga-Kicksmash-tester_2026-09-29.csv, PCB_PCB_Amiga-Kicksmash-tester-Rev-2_2026-09-29.json, PCB_PCB_Amiga-Kicksmash-tester_2026-06-13.json, PickAndPlace_PCB_Amiga-Kicksmash-tester-Rev-2_2026-09-29.csv, PickAndPlace_PCB_Amiga-Kicksmash-tester_2026-06-13.csv, SCH_Amiga-Kicksmash-tester_2026-06-13.json]
2026-09-29 PCB - Renamed all board directories to make it easier to find the board you want
    [BOM_Amiga-KickSmash-32-in-system-flash_2024-11-22 (1).csv, BOM_Amiga-KickSmash-32-in-system-flash_2024-11-22.csv, BOM_Amiga-KickSmash-32-in-system-flash_2025-03-13.csv, BOM_Amiga-KickSmash-32-in-system-flash_2025-04-10.csv, BOM_Amiga-KickSmash-32-in-system-flash_2025-07-24.csv, BOM_Amiga-KickSmash-32-in-system-flash_2026-03-15.csv, BOM_Amiga-KickSmash-32-in-system-flash_2026-06-29.csv, PCB_PCB_Am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]
2026-10-02 FW - Fixed STM32 ADC bug introduced in previous commit. The bug will cause the STM32 to think the Amiga is not powered on. - Changed power off strategy to no longer drive SOCKET_OE high or low. There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
    [adc.c, gpio.c, gpio.h, m29f160xt.c, pcmds.c, pin_tests.c, prom_access.c]
2026-10-03 smash - Fixed mismatched flash part erase bug. - Fixed auto swap bug where only the first 16KB was swapped correctly.
    smashtool
    - Implemented new graphical AmigaOS tool to do most smash program functions.
    This includes updating Kicksmash banks with ROM images, setting bank
    names, setting power on image, long reset images, setting the automatic
    bank to switch to on timeout, and setting the Amiga clock from Kicksmash.
    - Fixed "Save" bug where possibly old data would be written on subsequent save
    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
    [convert_to_amiga_icon.py, cpu_control.c, romswitch.c, smash.c, smashtool.c]
2026-10-03 ROM Switcher - Added Amiga serial port control of selected bank and start, such that the user may select a Kickstart ROM bank and start it completely from serial. - Changed 68040/68060 cache init to 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
    [cache.c, cpu_fault.h, draw.c, draw.h, keyboard.c, keyboard.h, main.c, med_cpu.c]
2026-10-04 ROM Switcher - Previous commit fixes support of CSMKII and Apollo 4060. - This commit fixes support for GVP Tekmagic 68060 A4000 accelerator. - This commit fixes support for A3640 in MAPROM mode. - C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
    [audio.c, main.c, vectors.c]
2026-10-08 hostsmash - Added option to "-n" to specify the network option to the back end.
    Compile
    - Minor fixes to make code compilable with gcc 16.2
    [mem_access.c]
2026-10-15 FW - Added start of persistent RAM which survives resets, but not power cycles - Fixed bug in Kicksmash1200 stand-alone test
2026-10-15 romswitcher: Make bevel corner joins consistent
    Extend recessed field top and left edges through their corner joins,
    replacing the white pixels at the top right and inner bottom left.
    Start the adjoining light edges after those pixels so they remain dark.
    Stop raised box left edges above the bottom edge to preserve the dark
    bottom-left corner. Apply this through DrawBevelBox so table boxes and
    buttons use the same join, while recessed single-pixel boxes retain
    their existing corners.
    Fixes: https://github.com/cdhooper/kicksmash32/issues/50
2026-10-17 FW - Enhanced message locking to allow a task to completely lock the buffers, where it can still access the message buffers with an override.
    - Split source in preparation for integration into ROM Switcher CLI.
    - Message buffer tests now always override locked buffers.
    smashnet
    - Removed reduced priority of smashnet receive task. This caused no network
    progress when another task is busy.
    - Minor size reduction by embedding a few constant strings.
    SM Msg
    - Fixed bug where smash message semaphore could get double-freed
    - Fixed bug where smash error response for a different tag can cause
    the wrong task to respond to the failure.
    - Added support for flags pass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
2026-10-18 ROM Switcher - Added smash command to MED command line This means that "smash test" can now be done without booting AmigaOS. - Improved ^C handling and reporting (previously didn't work if multiple l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
    Kicksmasher FW
    - Cleaned up "smash" command help and removed unused code (such as clock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
2026-10-21 hostsmash - Changed network send and receive to not require a reply from the other side. - Changed network receive to be forwarded by an asynchronous thread. With these two changes, ftp read performa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
2026-10-21 hostsmash_netif - Turned off debug output of packet send/receive size (-d option enables it)
    - Makefile will now automatically fetch Windows pcap.h file
    - Release Kicksmash1200 Rev 10.1
    - Add missing persist.c and persist.h
    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
2026-10-23 Doc - Update top level README.md - Added new doc section on SmashTool GUI. - Added "reset dfu" information to hardware programming guide.
    - Minor SOCKET_OE fix to pin tests for Kicksmash1200 boards.
    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
2026-11-03 smash - Added fwread, fwwrite, and fwverify for programming Kicksmash firmware This can be done while the Amiga remains running.
    - Added --fwread, --fwwrite, and --fwverify for programming Kicksmash firmware.
    No Windows support yet. MacOS support is untested. The --fwwrite option is
    compatible with USB DFU, so it can work even with the STM32 ROM DFU.
    - Enabled case-insensitive host filename matching when wildcards are used
    - Enhanced DFU updater to also support in-bank Kicksmash messages, and
    added support for firmware read, write, and identify from the Amiga
    - Added persisting of current bank and mode across reboots
    This allows the Amiga to keep running, bu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
2026-11-04 FW - Added "hostsmash --fwwrite" support for Windows. This includes being able to tell Windows to associate WinUSB with a DFU device. - Changed USB normal and DFU device exposed for better Windows su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
    - Fixed "hostsmash -t COMMAND" not working when Kicksmash message mode is active
    doc
    - Added Kicksmash32 information sheet
    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
2026-11-06 ROM Switcher - Key down events for Save, Cancel, and Switch and Reboot are now actions It used to be key up events, but Brian Carpignano says key down is better.
    - Three Amiga resets within 4 seconds will now also trigger a long reset.
    This is to address keyboard adapters which can not hold a long reset.
    - Minor fix for pin tests. Give FLASH_OE time to start driving pins.
    - Added option to automatically name the bank which was just programmed
    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
2026-11-07 ROM Switcher - ROM Switcher will now also reset Amiga at "Switch and Reboot".
    - Fixed bug where "quiet" in "smash test" could print "Unavailable" each pass.
    - Added config flag "NO_RAPID_RESET" to disable rapid reset -> long reset.
    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
2026-11-11 hostsmash_netif: Make the Amiga reachable from the local host on Linux
    Linux never delivers traffic between a macvtap's lower device and the
    macvtap itself, so with "hostsmash -n macvtap" the Amiga is reachable
    from every machine on the LAN except the one running hostsmash.
    Bridge-mode macvlans on the same lower device can talk to each other,
    so create a bridge-mode macvlan "shim" (amiga-shimN) next to the
    macvtap. The Amiga's IPv4 address is learned from the source address
    of the ARP and IPv4 frames it sends, and a /32 host route for it is
    pointed at the shim. If the address changes (e.g. a new DHCP lease),
    the route follows. Deleting the shim at exit removes the route.
    The shim has no ad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
2026-11-12 hostsmash: Byte-swap the network packet length from the Amiga
    sm_nwrite() used hm_length from the Amiga's KM_OP_NWRITE message
    without converting it from the Amiga's big-endian byte order, as the
    file operations in hostsmash_fs.c do. A 98-byte frame was read as
    25088 bytes, which was then clamped to rxlen. Since rxlen includes
    the 6-byte message header, every frame was handed to the network 6
    bytes longer than the Amiga sent it.
    Frames of up to 1512 bytes still went out at 1518 bytes or less,
    which Linux accepts, so small packets worked. Anything larger,
    including every full-size TCP segment, was silently dropped. TCP
    transfers from the Amiga stalled as soon as they needed a full
    segment.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
2026-11-12 hostsmash_netif: Make stdin unbuffered
    The main loop uses poll() on the stdin file descriptor to learn when
    hostsmash has sent a frame, but reads frames with fread(). When
    several frames were already waiting in the pipe, the first fread()
    pulled all of them into stdio's buffer and only the first was
    handled. poll() then saw an empty pipe, so the remaining frames sat
    in the buffer until another frame happened to arrive. Bursts of
    back-to-back frames from the Amiga, such as a TCP reply spanning
    several segments, stalled.
    Make stdin unbuffered so fread() only consumes what it returns.
